bienemeia/SYSC4907_Group44_GroundVibrationSimulator/README.md

# SYSC4907_Group44_GroundVibrationSimulator
This repository contains all code and documentation for Ground Vibration Simulator.
