bienemeia/SYSC4907_Group44_GroundVibrationSimulator/Documentation/Teams_Backup/Progress Meetings/01-09-2023 Meeting.pptx

## Progress Meeting – Jan. 9, 2023

An organic corner shape

- Past week

- Hope everyone had an excellent holiday!

A brushstroke

Coming week

Simulation experiments
Order parts!!!
Assembly
Further software dev.

## Slide 2

What has everyone been working on?

Meia Copeland

Shawaiz Khan

Talal Jaber

Ranishka Fernando

Marwan Zeyada
