bienemeia/SYSC4907_Group44_GroundVibrationSimulator/Documentation/Teams_Backup/Progress Meetings/01-16-2023 Meeting.pptx

## Progress Meeting – Jan. 16, 2023

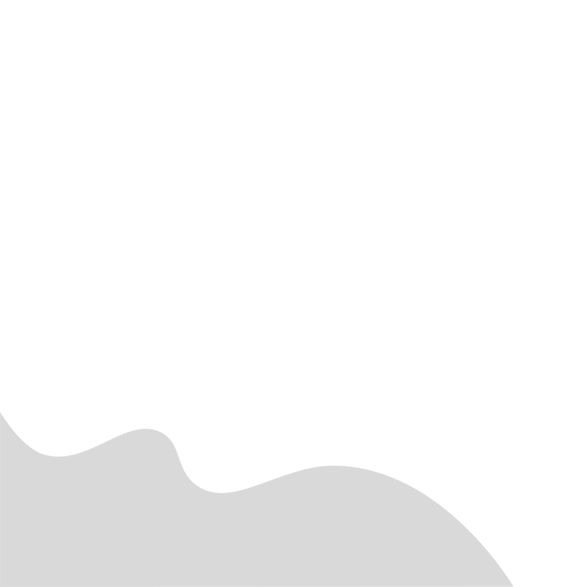
[picture p48: figure]
An organic corner shape

- Past week

- Parts ordered
- Grant proposal submitted to OFNC
- Oral presentation draft

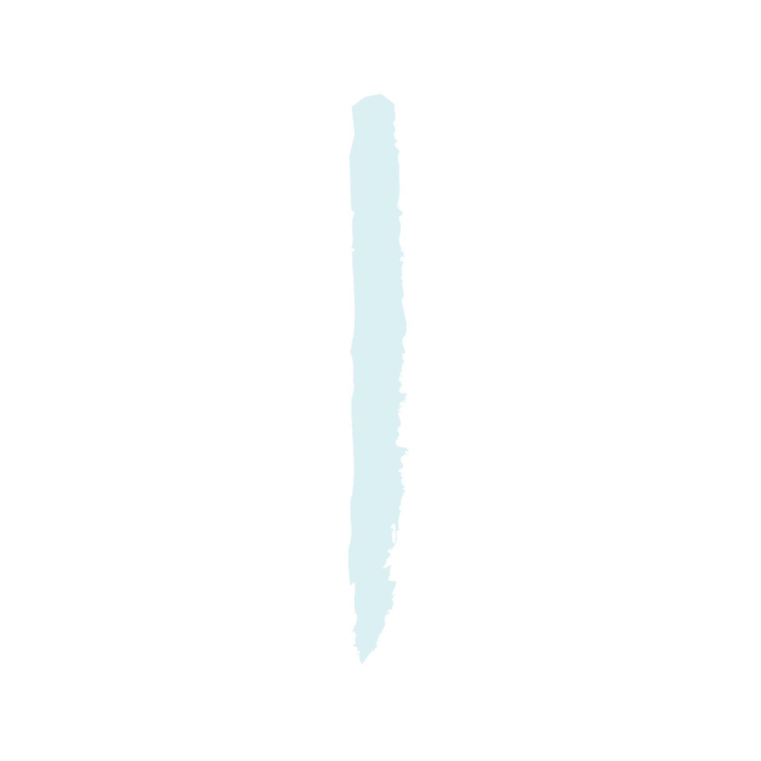
[picture p49: figure]
A brushstroke

Coming week

Simulation experiments
Assembly
Further software dev.

## Slide 2

What has everyone been working on?

Meia Copeland

Prepared the grant proposal to OFNC with Dr. Davy
Ordered and received parts required
Draft slides

Shawaiz Khan

Talal Jaber

Working on the motor demo for the presentation.

Ranishka Fernando

Working on presentation slides

Worked on the draft slides for the Oral Presentation
Worked on sending emails using python (with attachments)

Marwan Zeyada
