bienemeia/SYSC4907_Group44_GroundVibrationSimulator/Documentation/Teams_Backup/Progress Meetings/02-05-2023 Meeting.pptx

## Progress Meeting – Feb. 5, 2023

An organic corner shape

- Past week

- New flexure & frame design
- Sensor research
- Further software dev.

A brushstroke

Coming week

Order required sensors
Test new flexure design
Software dev.
Integration of flexure with motor

## Measuring Linear Displacement

- Eddylab – Cylindrical distance sensor

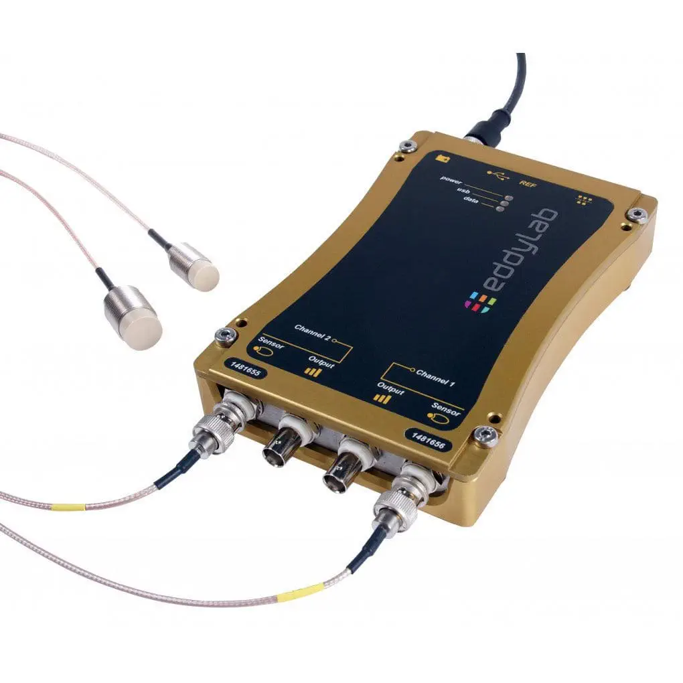
[picture p50: figure]

- SMT Linear Displacement Sensor - $295

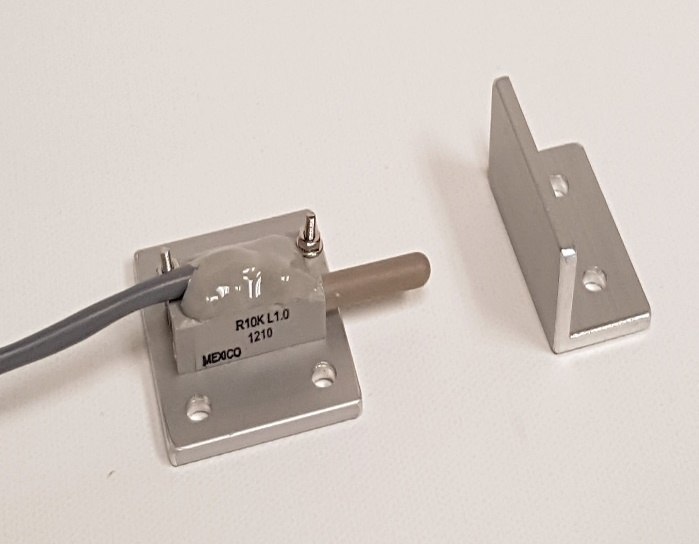
[picture p51: figure]

Strain Gauge

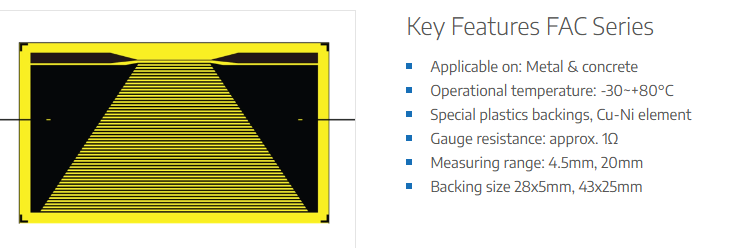
[picture p52: figure]

Limitations
- Surface applied must be smooth or results can be misinterpreted
- Cannot measure multi-direction loads
- Performance affected by humidity, temperature and other external factors

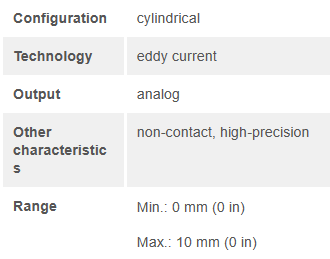
[picture p53: figure]
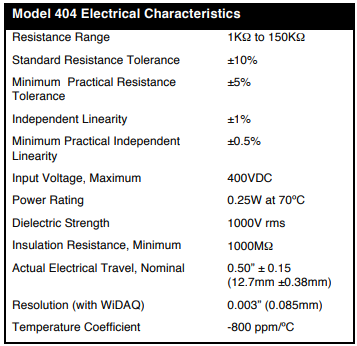
[picture p54: figure]

Notes: https://www.smtresearch.ca/product-page/linear-displacement-sensor-basic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,a%20greater%20degree%20of%20accuracy
https://www.directindustry.com/prod/eddylab-gmbh/product-188286-1845021.html
https://www.directindustry.com/industrial-manufacturer/analog-distance-sensor-105923.html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

## Flexure Redesign

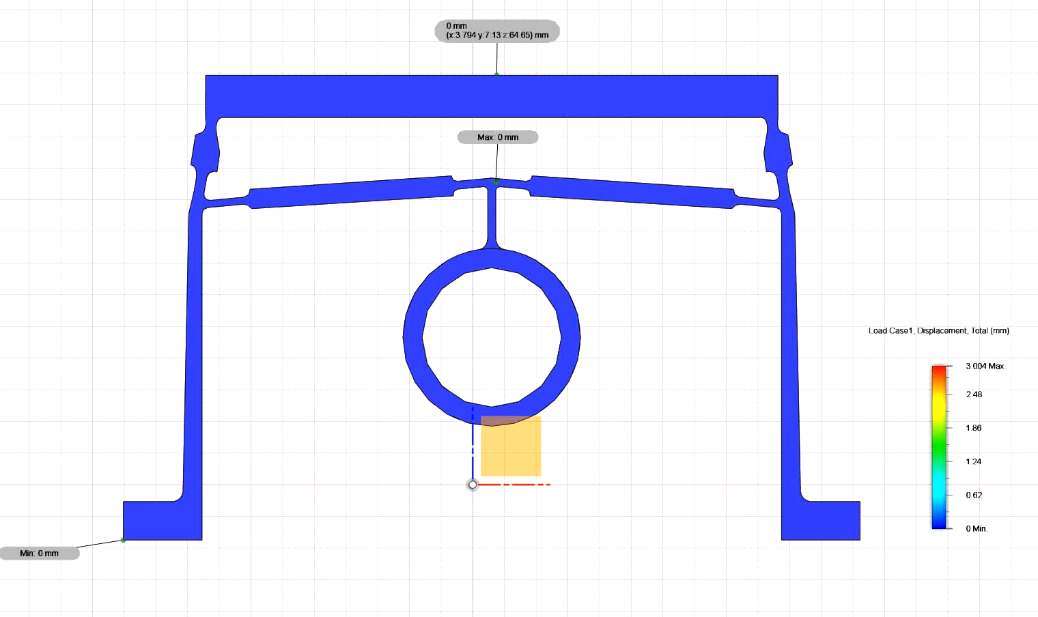
[picture p55: figure]

~0.12 mm displacement with 3mm offset
~0.2 mm displacement with 5 mm offset
Target: 0.1 mm – 1 mm
New frame designed

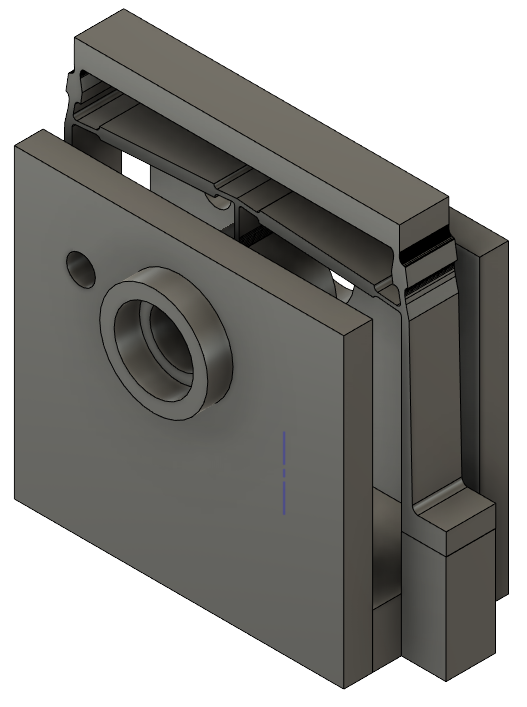
[picture p56: figure]
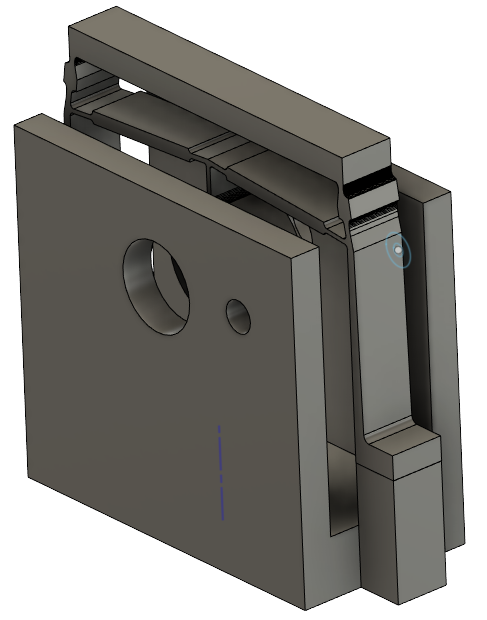
[picture p57: figure]

## Slide 4

What has everyone been working on?

Meia Copeland

Flexure, frame and camshaft redesign
Ordered parts
Ordered 3D print

Shawaiz Khan

Talal Jaber

- Power supply for the driver
- Resolving motor issue
- Debugging code

Ranishka Fernando

3D modelling – Flexure re-design
Research on displacement sensors and their limitations

Database to UI integration

Marwan Zeyada

Database to UI integration
