bienemeia/SYSC4907_Group44_GroundVibrationSimulator/Documentation/Teams_Backup/Progress Meetings/02-13-2023 Meeting.pptx

## Progress Meeting – Feb. 13, 2023

An organic corner shape

- Past week

- Temperature & humidity integration with database
- Sensor research
- Further software dev.

A brushstroke

Coming week

Order required sensors
Test new flexure design
Software dev.
Integration of flexure with motor
Final report draft

## Model 404 Position Sensor

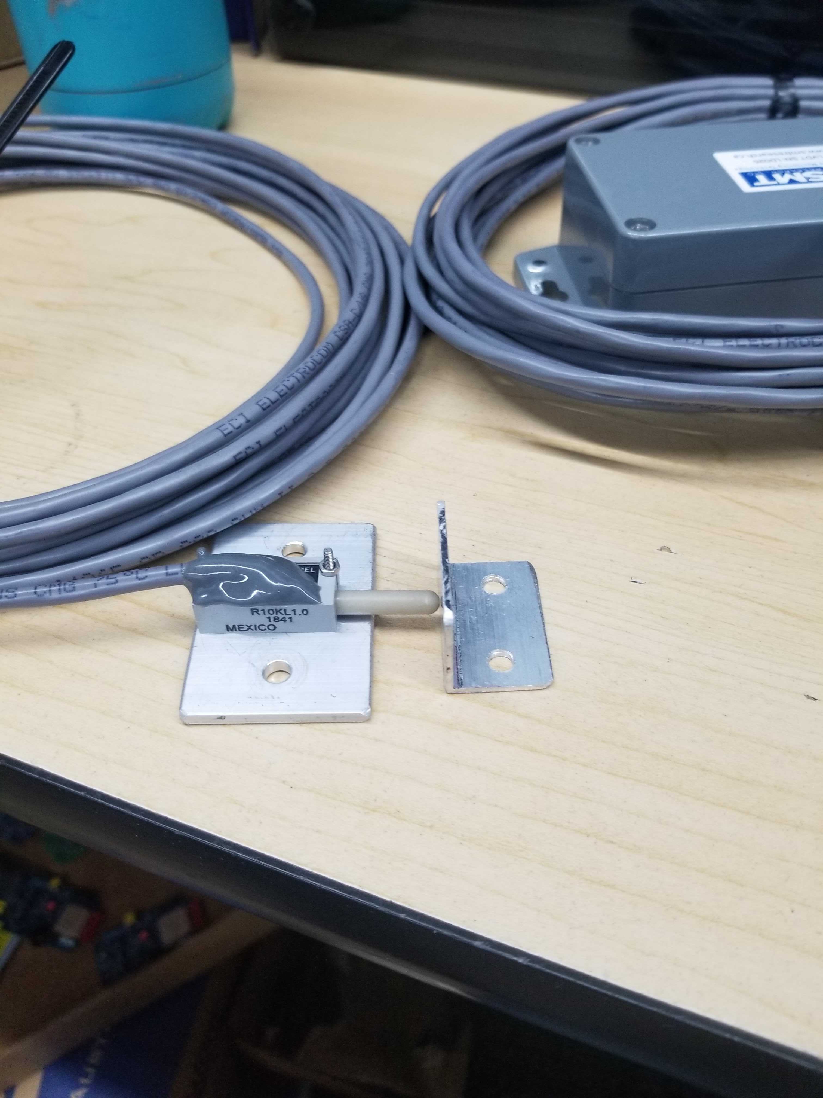
[picture p58: figure]
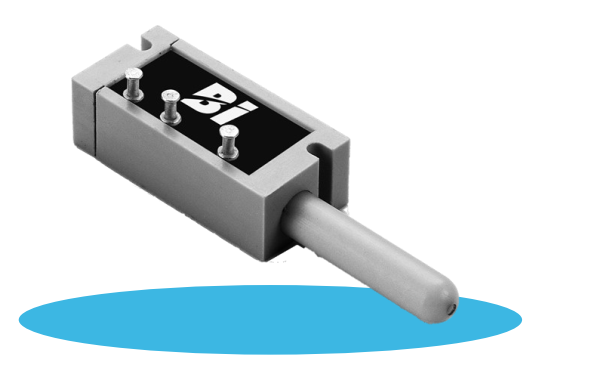
[picture p59: figure]
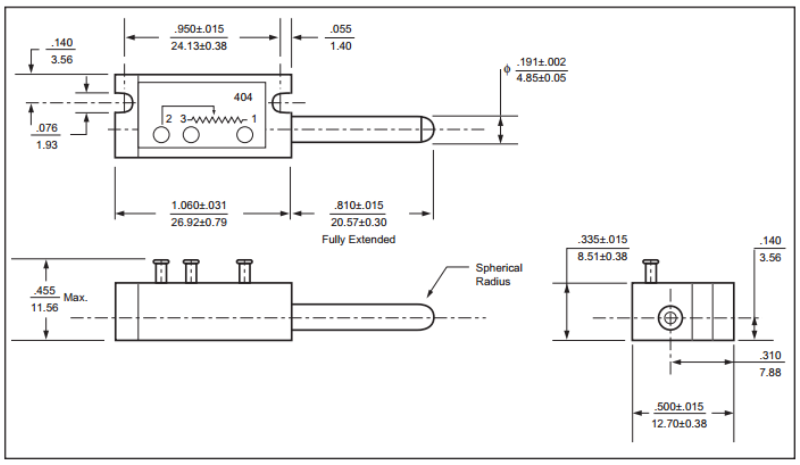
[picture p60: figure]
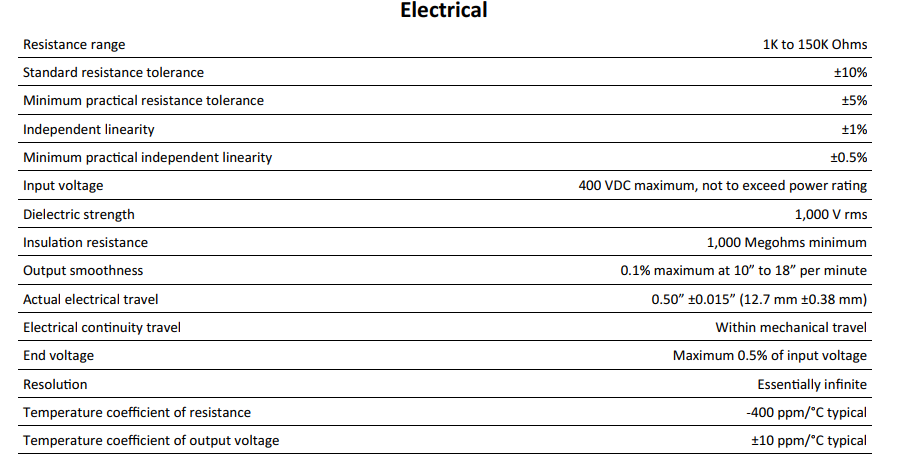
[picture p61: figure]

## Slide 3

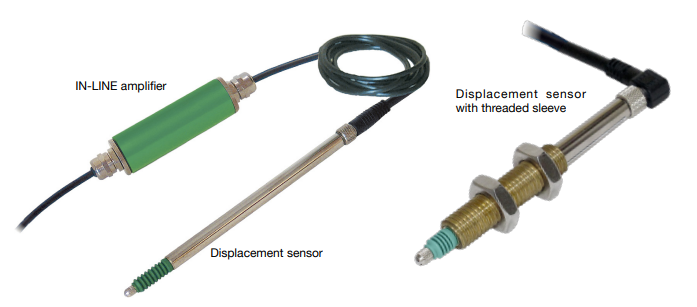
[picture p62: figure]
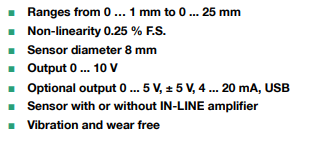
[picture p63: figure]

## Slide 4

What has everyone been working on?

Meia Copeland

I2C connection for temperature/humidity sensor
Connection can be used for other variables later

Shawaiz Khan

Talal Jaber

- Debugging motor issues

Ranishka Fernando

Finalize research on linear displacement sensors and determine the required sensor.
Research on unguided core magnet displacement sensors

.db to .xlsx file conversion completed
Files sent as email attachments completed
Database to UI integration

Marwan Zeyada

Database to UI integration
