bienemeia/SYSC4907_Group44_GroundVibrationSimulator/Documentation/Teams_Backup/Proposal/44 Proposal Draft v2.Marshall.pdf

SYSC4907 –ENGINEERING PROJECT

# Wind Turbine Ground Vibration Simulator

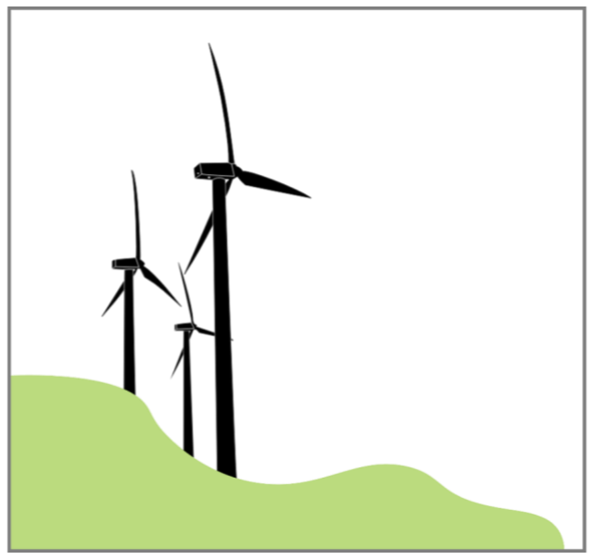
[picture p125: figure]

Team Members
Meia Copeland | 100972654
Shawaiz Khan | 100917863
Talal Jaber | 101167571
Marwan Zeyada | 101141759
Ranishka Fernando

Supervisors
Dr. Lynn Marshall
Dr. Yuu Ono

October 21, 2022

Commented [MP1]: @Ranishka Fernando please add student number

WIND TURBINE GROUND VIBRATION SIMULATOR

i

## Table of Contents

WIND TURBINE GROUND VIBRATION SIMULATOR

ii

WIND TURBINE GROUND VIBRATION SIMULATOR

1
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
