bienemeia/SYSC4907_Group44_GroundVibrationSimulator/Documentation/Teams_Backup/Oral Presentation/Assets/2-red-eared-slider-turtles-mirror-image-kenny-bosak.jpg

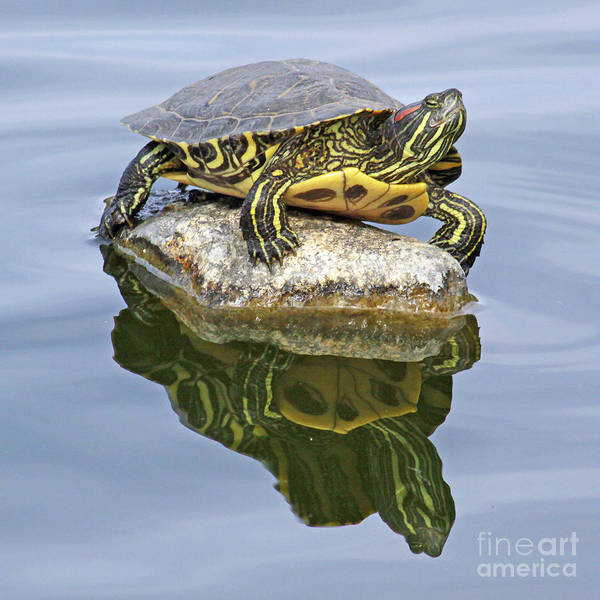
Documentation/Teams_Backup/Oral Presentation/Assets/2-red-eared-slider-turtles-mirror-image-kenny-bosak.jpg
