bienemeia/SYSC4907_Group44_GroundVibrationSimulator/Documentation/Teams_Backup/Oral Presentation/Assets/29turtle-superJumbo.jpg

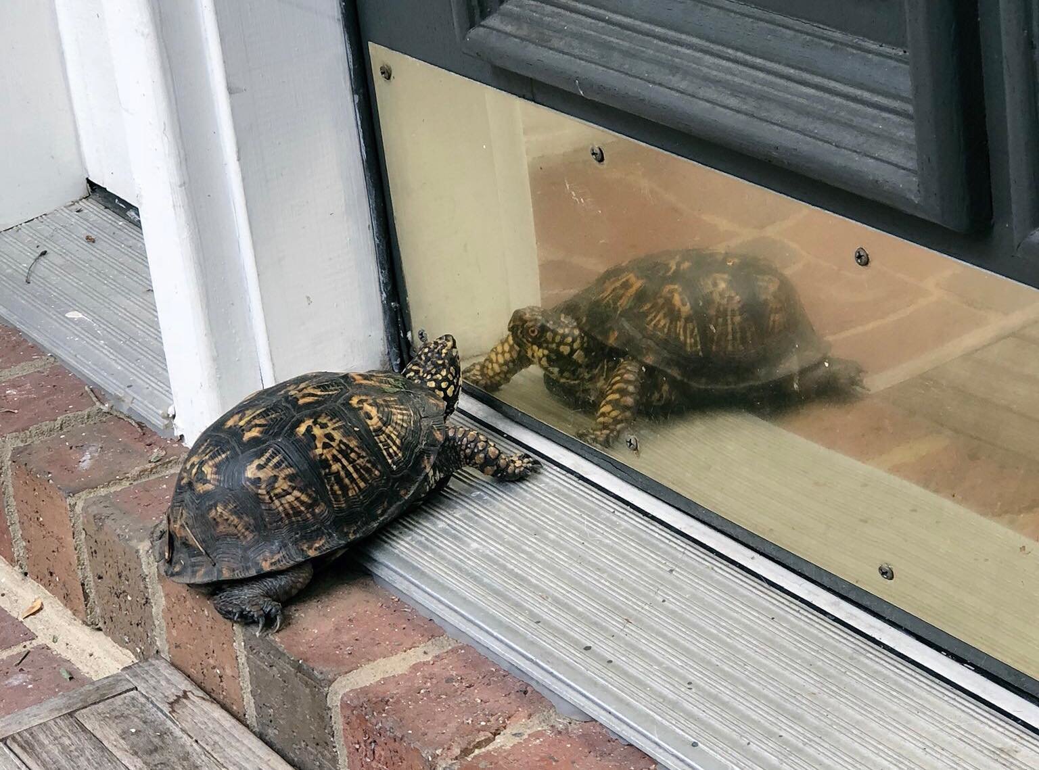
Documentation/Teams_Backup/Oral Presentation/Assets/29turtle-superJumbo.jpg
