bienemeia/SYSC4907_Group44_GroundVibrationSimulator/Documentation/Teams_Backup/Oral Presentation/Assets/30_turtle-eggs.5869bc6cba.png

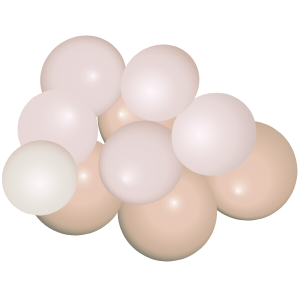
Documentation/Teams_Backup/Oral Presentation/Assets/30_turtle-eggs.5869bc6cba.png
