bienemeia/SYSC4907_Group44_GroundVibrationSimulator/Documentation/Teams_Backup/Oral Presentation/Assets/62b87ff5d182dd8651230912_flashtheturtlewbbsmall-1649761058957.png

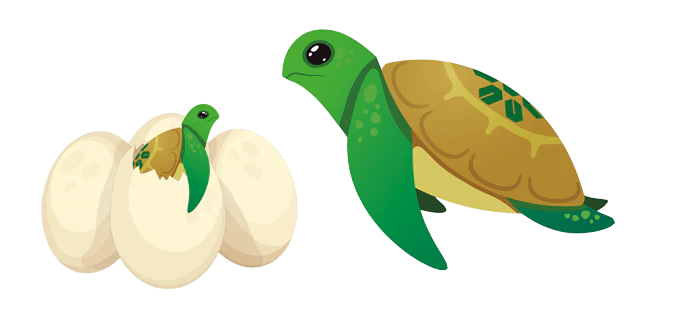
Documentation/Teams_Backup/Oral Presentation/Assets/62b87ff5d182dd8651230912_flashtheturtlewbbsmall-1649761058957.png
