bienemeia/SYSC4907_Group44_GroundVibrationSimulator/Documentation/Teams_Backup/Oral Presentation/Assets/1014499169,width=178,height=178.webp

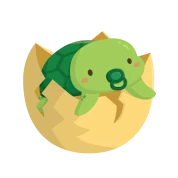
Documentation/Teams_Backup/Oral Presentation/Assets/1014499169,width=178,height=178.webp
