bienemeia/SYSC4907_Group44_GroundVibrationSimulator/Documentation/Teams_Backup/Oral Presentation/Assets/17603687068_ae33f1c6b6_b.jpg

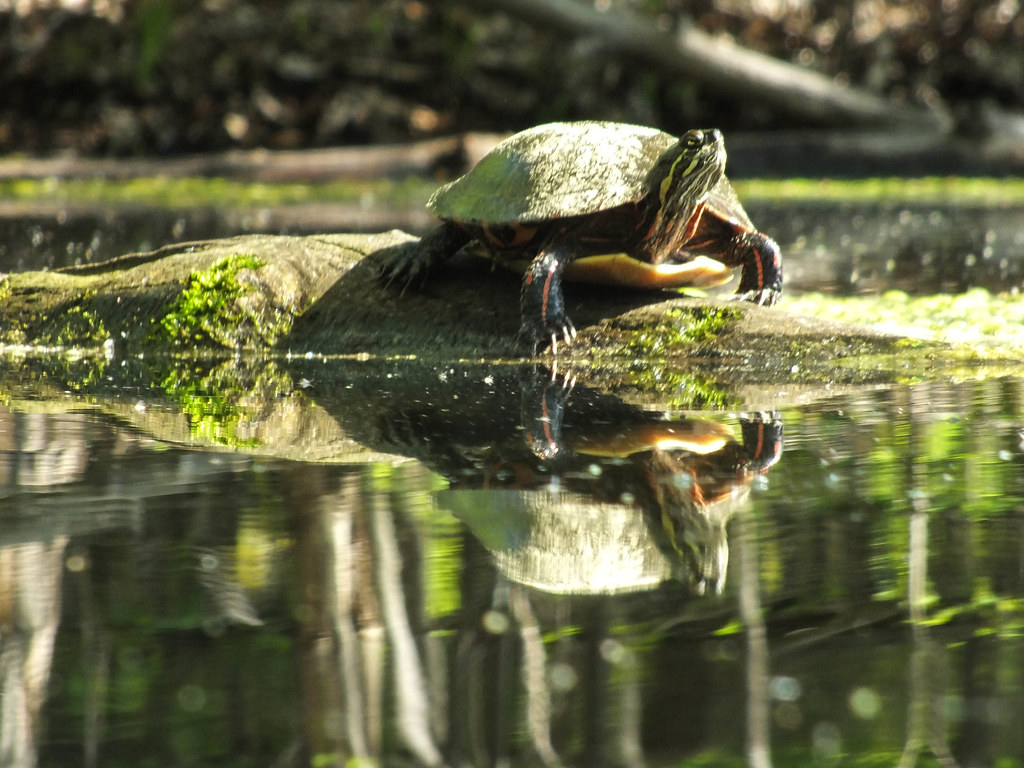
Documentation/Teams_Backup/Oral Presentation/Assets/17603687068_ae33f1c6b6_b.jpg
