bienemeia/SYSC4907_Group44_GroundVibrationSimulator/Documentation/Teams_Backup/Oral Presentation/Assets/Actuator Section View.png

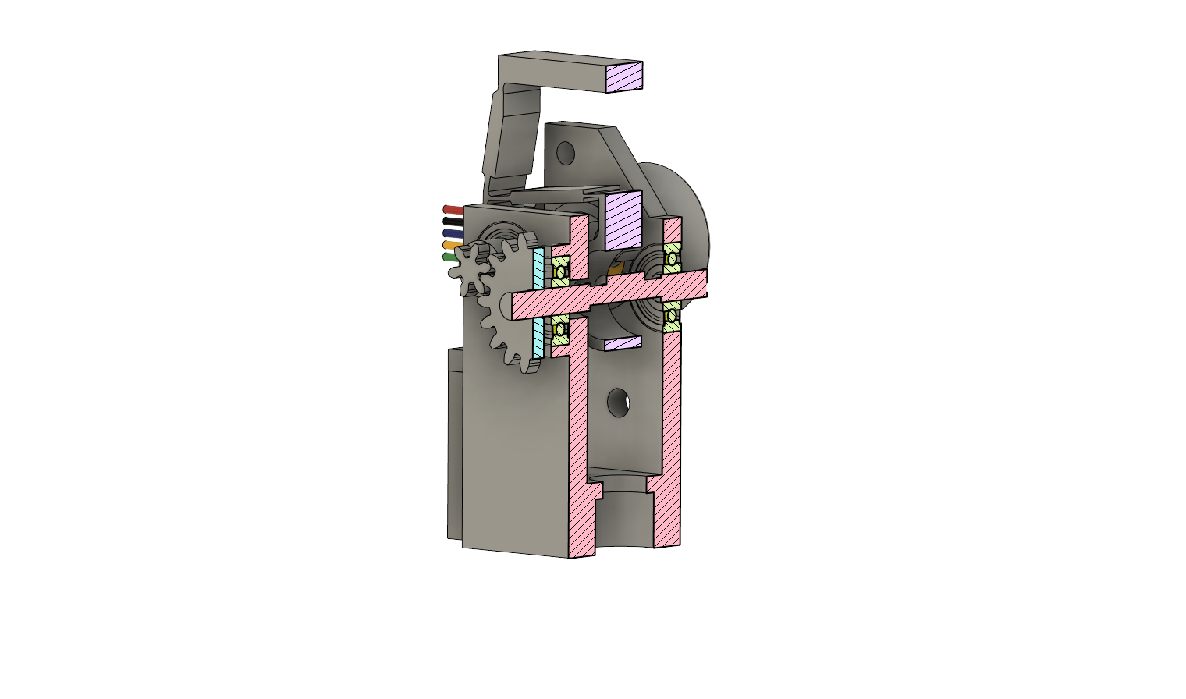
Documentation/Teams_Backup/Oral Presentation/Assets/Actuator Section View.png
