bienemeia/SYSC4907_Group44_GroundVibrationSimulator/Documentation/Teams_Backup/Oral Presentation/Assets/ActuatorOtherSideView01v4.png

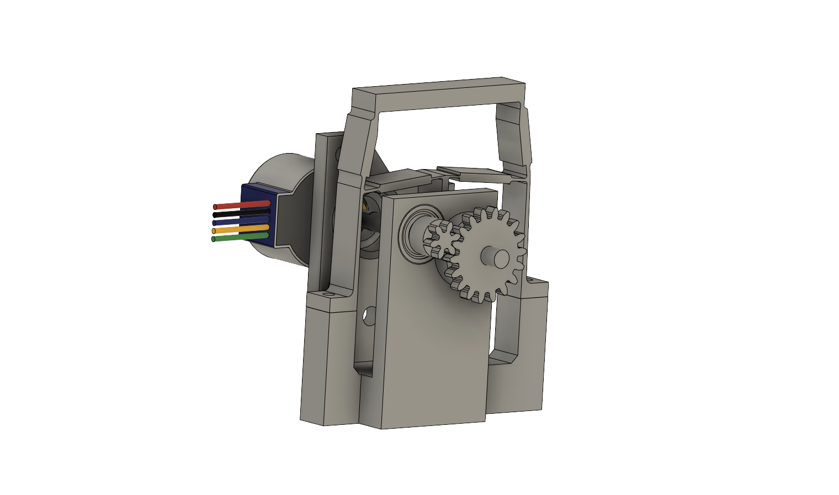
Documentation/Teams_Backup/Oral Presentation/Assets/ActuatorOtherSideView01v4.png
