bienemeia/SYSC4907_Group44_GroundVibrationSimulator/Documentation/Teams_Backup/Oral Presentation/Assets/asphalt-157687__340.webp

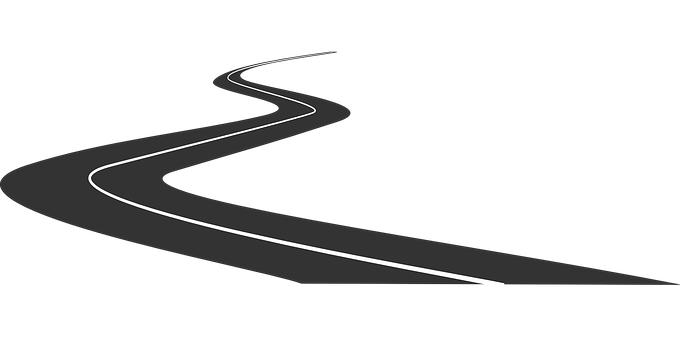
Documentation/Teams_Backup/Oral Presentation/Assets/asphalt-157687__340.webp
