bienemeia/SYSC4907_Group44_GroundVibrationSimulator/Documentation/Teams_Backup/Oral Presentation/Assets/BabyTurtlePic-removebg-preview - Copy.png

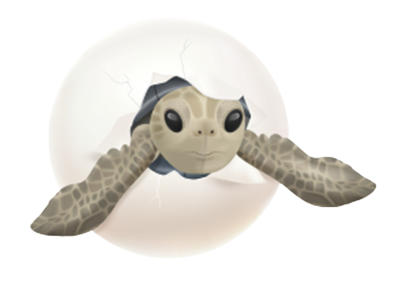
Documentation/Teams_Backup/Oral Presentation/Assets/BabyTurtlePic-removebg-preview - Copy.png
