bienemeia/SYSC4907_Group44_GroundVibrationSimulator/Documentation/Teams_Backup/Oral Presentation/Assets/FlexureAndCamshaft.png

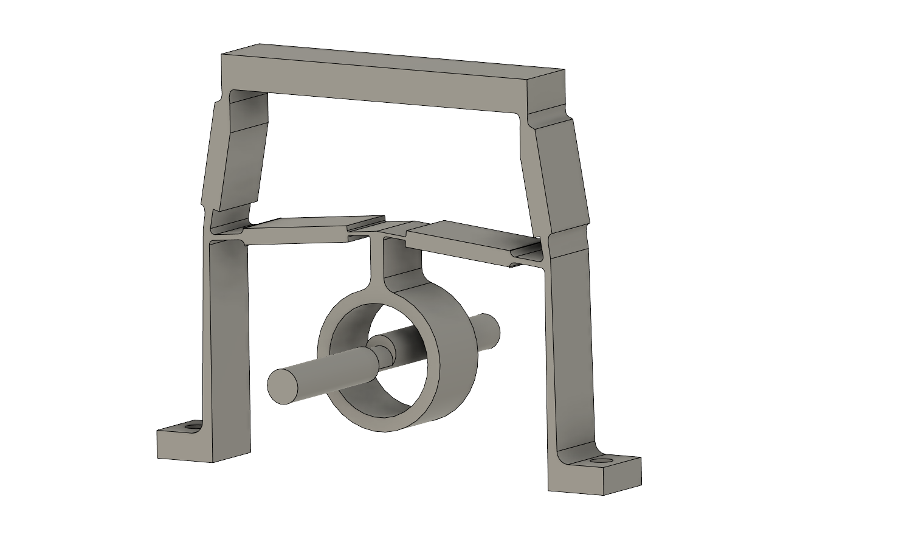
Documentation/Teams_Backup/Oral Presentation/Assets/FlexureAndCamshaft.png
