bienemeia/SYSC4907_Group44_GroundVibrationSimulator/Documentation/Teams_Backup/Oral Presentation/Assets/GroundWaveTypes.png

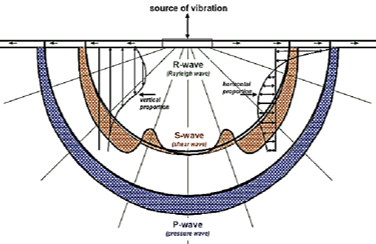
Documentation/Teams_Backup/Oral Presentation/Assets/GroundWaveTypes.png
