bienemeia/SYSC4907_Group44_GroundVibrationSimulator/Documentation/Teams_Backup/Oral Presentation/Assets/HydroPlant.jpg

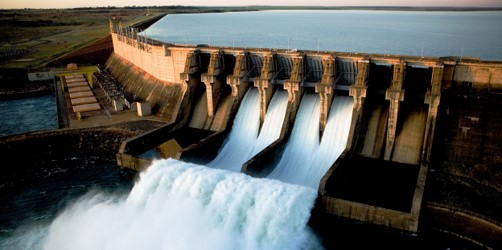
Documentation/Teams_Backup/Oral Presentation/Assets/HydroPlant.jpg
