bienemeia/SYSC4907_Group44_GroundVibrationSimulator/Documentation/Teams_Backup/Oral Presentation/Assets/mirror-turtle-natural-focal-point-photography.jpg

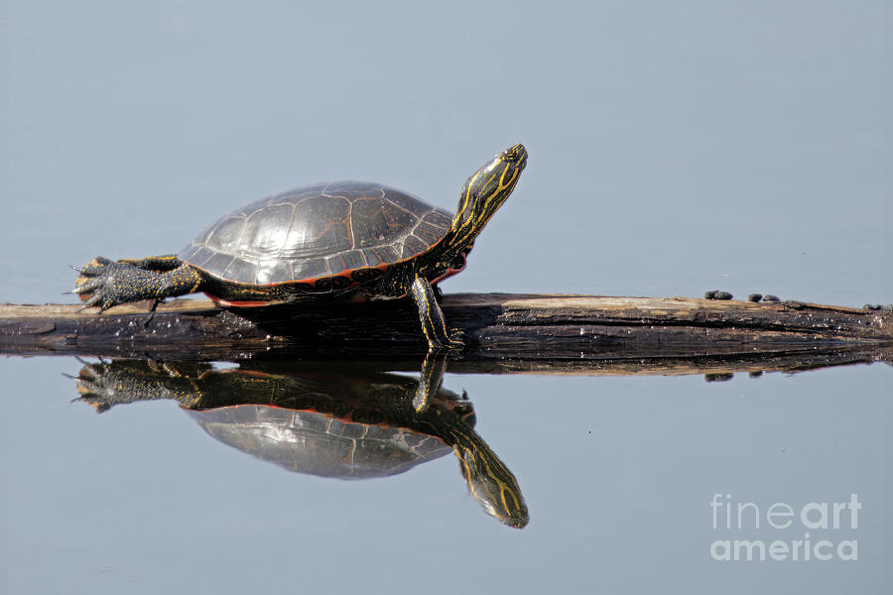
Documentation/Teams_Backup/Oral Presentation/Assets/mirror-turtle-natural-focal-point-photography.jpg
