bienemeia/SYSC4907_Group44_GroundVibrationSimulator/Documentation/Teams_Backup/Oral Presentation/Assets/nuclear-power-plant-vector-260nw-227903848.webp

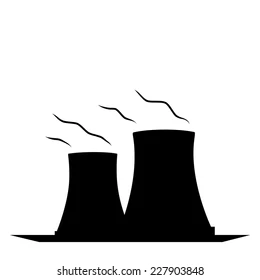
Documentation/Teams_Backup/Oral Presentation/Assets/nuclear-power-plant-vector-260nw-227903848.webp
