bienemeia/SYSC4907_Group44_GroundVibrationSimulator/Documentation/Teams_Backup/Oral Presentation/Assets/pngtree-set-of-road-vector-illustration-png-image_6115149.png

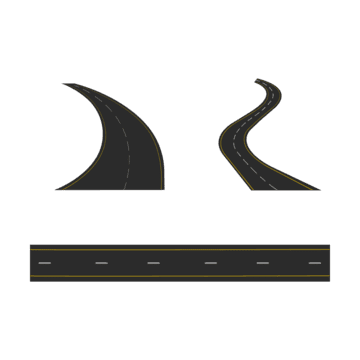
Documentation/Teams_Backup/Oral Presentation/Assets/pngtree-set-of-road-vector-illustration-png-image_6115149.png
