bienemeia/SYSC4907_Group44_GroundVibrationSimulator/Documentation/Teams_Backup/Oral Presentation/Assets/power-plant-black-silhouette-illustration-vector.jpg

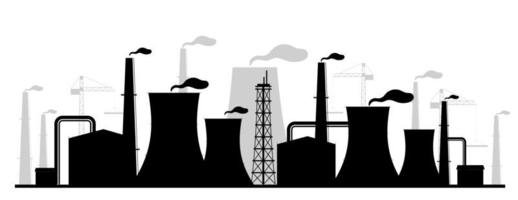
Documentation/Teams_Backup/Oral Presentation/Assets/power-plant-black-silhouette-illustration-vector.jpg
