bienemeia/SYSC4907_Group44_GroundVibrationSimulator/Documentation/Teams_Backup/Oral Presentation/Assets/red-eared-slider-turtles_Piqsels.jpg

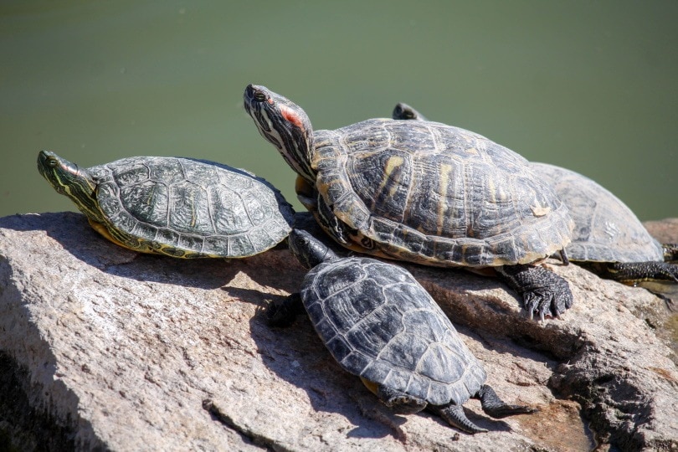
Documentation/Teams_Backup/Oral Presentation/Assets/red-eared-slider-turtles_Piqsels.jpg
