bienemeia/SYSC4907_Group44_GroundVibrationSimulator/Documentation/Teams_Backup/Oral Presentation/Assets/silhouette-of-a-power-plant-vector-8655158.jpg

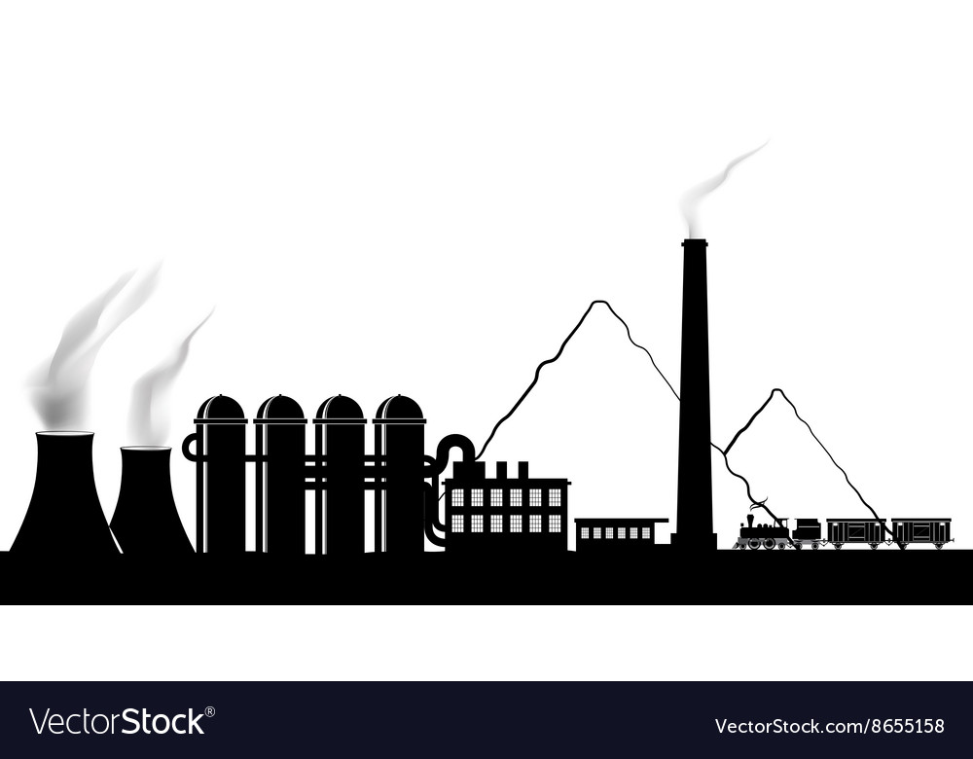
Documentation/Teams_Backup/Oral Presentation/Assets/silhouette-of-a-power-plant-vector-8655158.jpg
