bienemeia/SYSC4907_Group44_GroundVibrationSimulator/Documentation/Teams_Backup/Oral Presentation/Assets/turtle-cracking-egg-round-turtle-egg-11563607666zl85b1wvmm.png

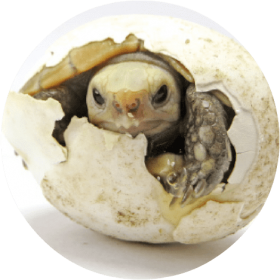
Documentation/Teams_Backup/Oral Presentation/Assets/turtle-cracking-egg-round-turtle-egg-11563607666zl85b1wvmm.png
