bienemeia/SYSC4907_Group44_GroundVibrationSimulator/Documentation/Teams_Backup/Oral Presentation/Assets/TurtleEggPic-removebg-preview.png

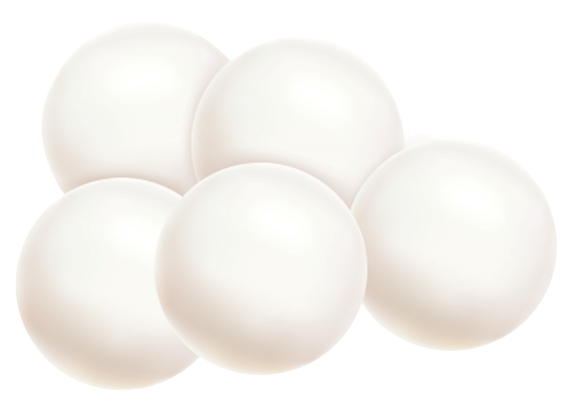
Documentation/Teams_Backup/Oral Presentation/Assets/TurtleEggPic-removebg-preview.png
