bienemeia/SYSC4907_Group44_GroundVibrationSimulator/Documentation/Teams_Backup/Proposal/Assets/LinearActuator Front.png

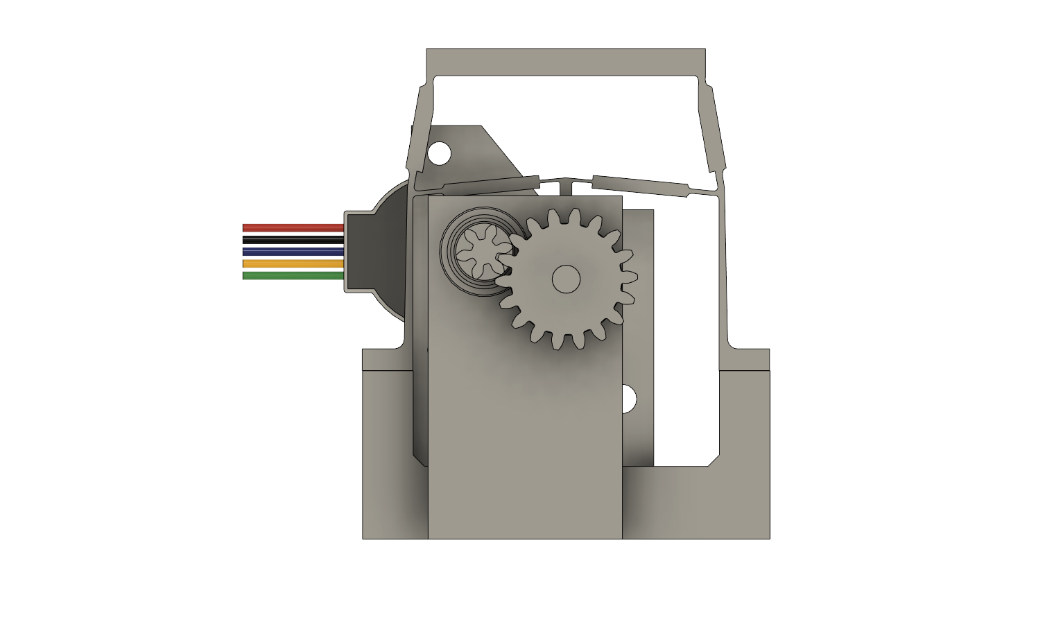
Documentation/Teams_Backup/Proposal/Assets/LinearActuator Front.png
