bienemeia/SYSC4907_Group44_GroundVibrationSimulator/Documentation/Teams_Backup/Proposal/Assets/LinearActuator v1.png

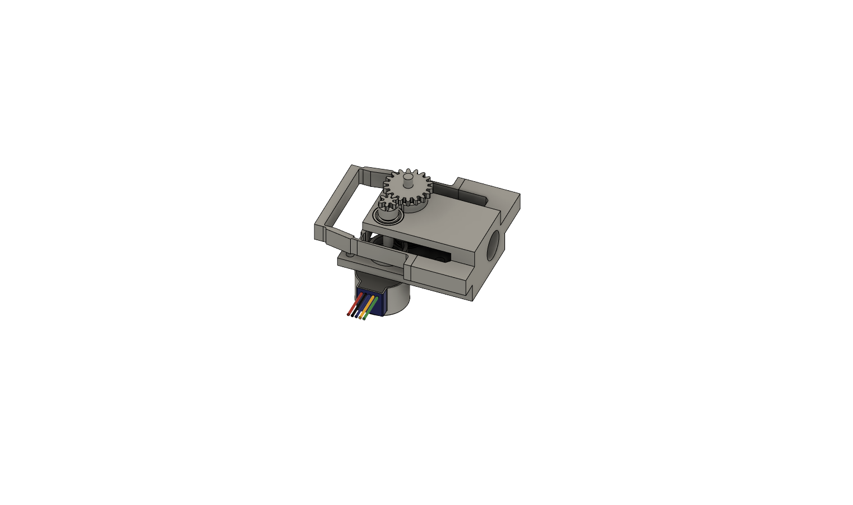
Documentation/Teams_Backup/Proposal/Assets/LinearActuator v1.png
