bienemeia/SYSC4907_Group44_GroundVibrationSimulator/Documentation/Teams_Backup/Receipts/Claimed/HomeDepot_FastenerSupply.jpg

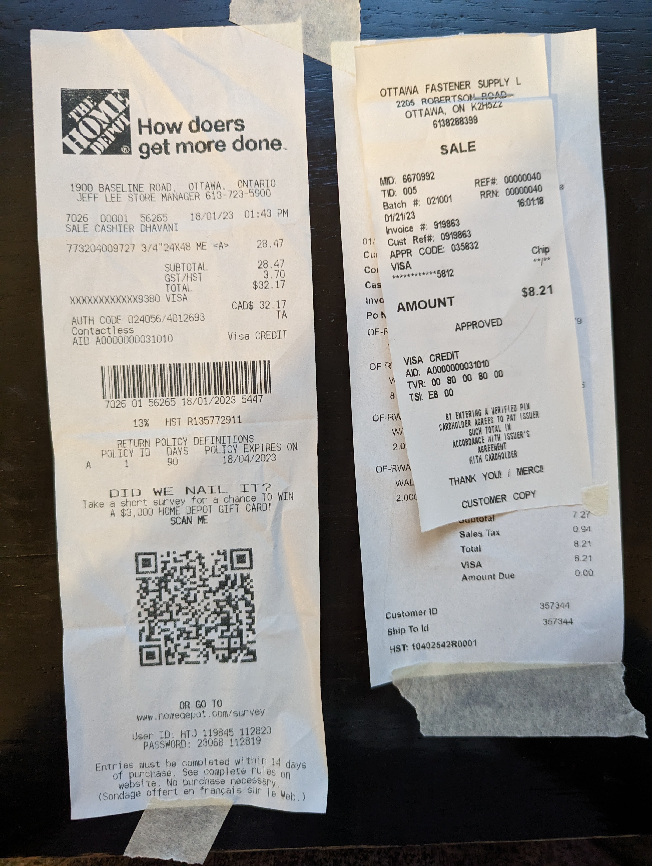
Documentation/Teams_Backup/Receipts/Claimed/HomeDepot_FastenerSupply.jpg
