bienemeia/SYSC4907_Group44_GroundVibrationSimulator/Documentation/Teams_Backup/STL/Bracket v2.png

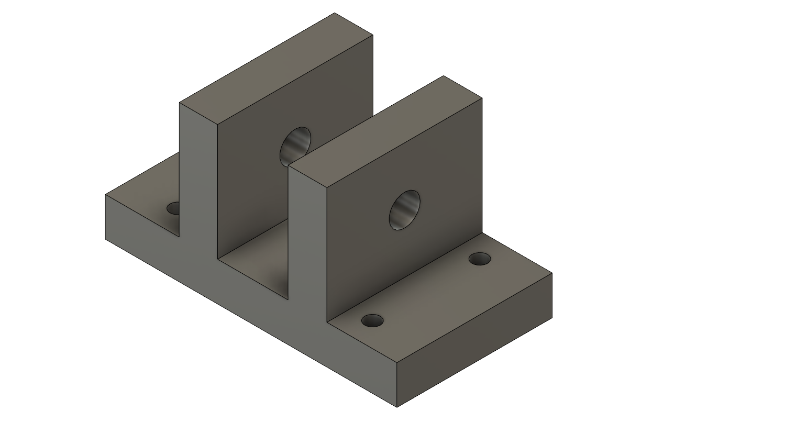
Documentation/Teams_Backup/STL/Bracket v2.png
