bienemeia/SYSC4907_Group44_GroundVibrationSimulator/Documentation/Teams_Backup/Video/Pictures/53e20cb0a8aff.webp

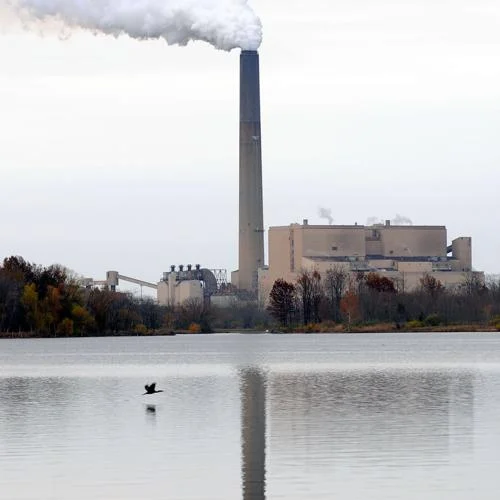
Documentation/Teams_Backup/Video/Pictures/53e20cb0a8aff.webp
