bienemeia/SYSC4907_Group44_GroundVibrationSimulator/Documentation/Teams_Backup/Video/Pictures/627a84a3f128c1f7abaab559_42877131541_20033355d1_k.jpg

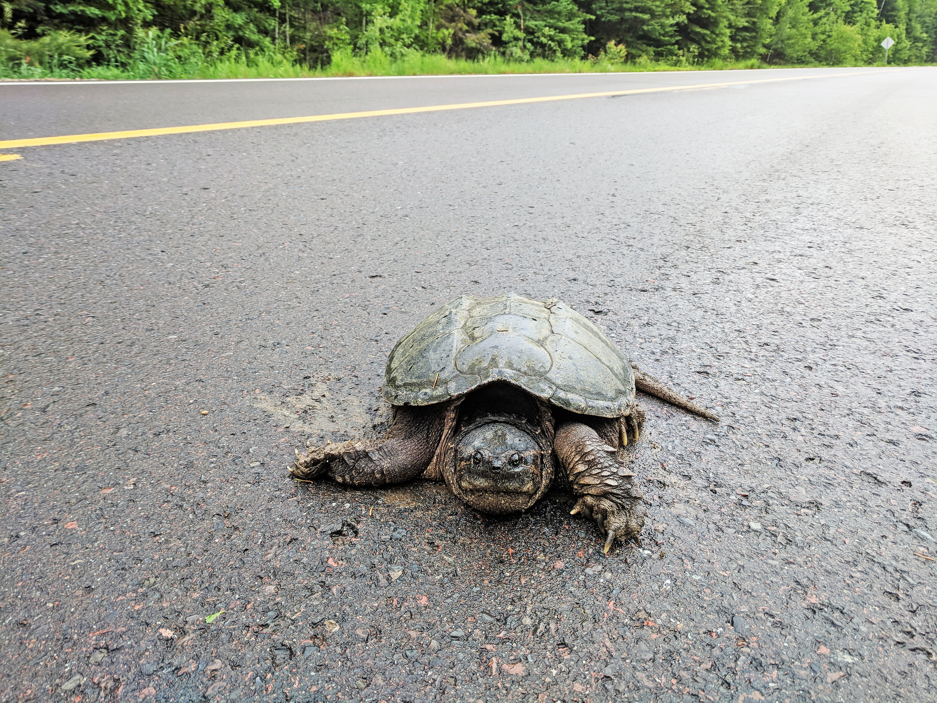
Documentation/Teams_Backup/Video/Pictures/627a84a3f128c1f7abaab559_42877131541_20033355d1_k.jpg
