bienemeia/SYSC4907_Group44_GroundVibrationSimulator/Documentation/Teams_Backup/Video/Pictures/a-turtle.jpg

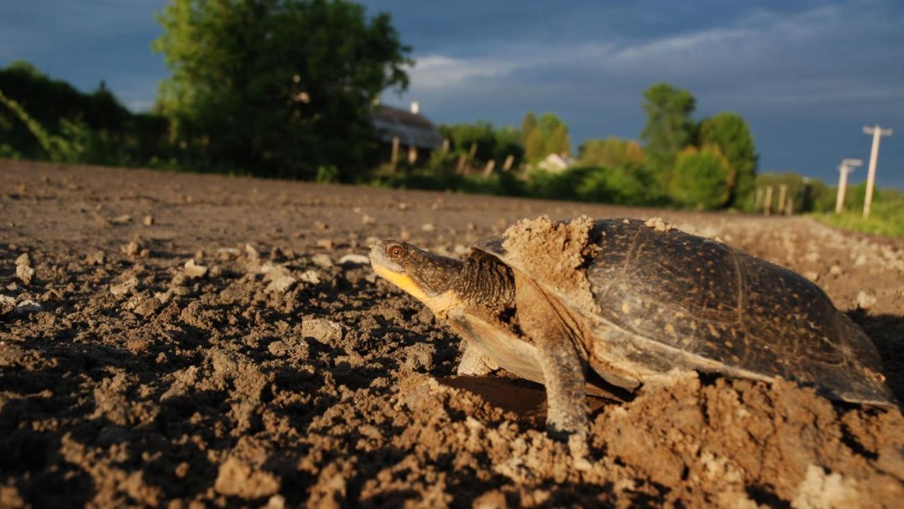
Documentation/Teams_Backup/Video/Pictures/a-turtle.jpg
