bienemeia/SYSC4907_Group44_GroundVibrationSimulator/Documentation/Teams_Backup/Video/Pictures/Algonquin_June_2010_174_James_Paterson.jpg

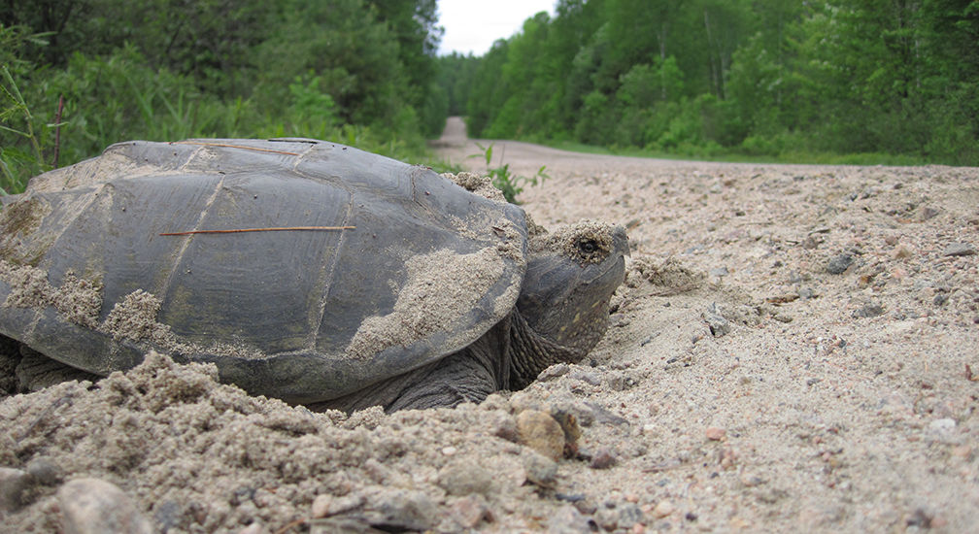
Documentation/Teams_Backup/Video/Pictures/Algonquin_June_2010_174_James_Paterson.jpg
