bienemeia/SYSC4907_Group44_GroundVibrationSimulator/Documentation/Teams_Backup/Video/Pictures/DavyLabTeam.PNG

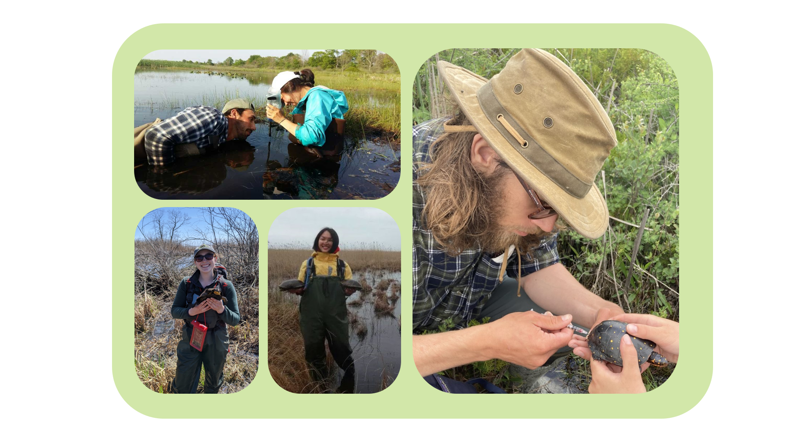
Documentation/Teams_Backup/Video/Pictures/DavyLabTeam.PNG
