bienemeia/SYSC4907_Group44_GroundVibrationSimulator/Documentation/Teams_Backup/Video/Pictures/DSCF1684-1-1024x768.jpg

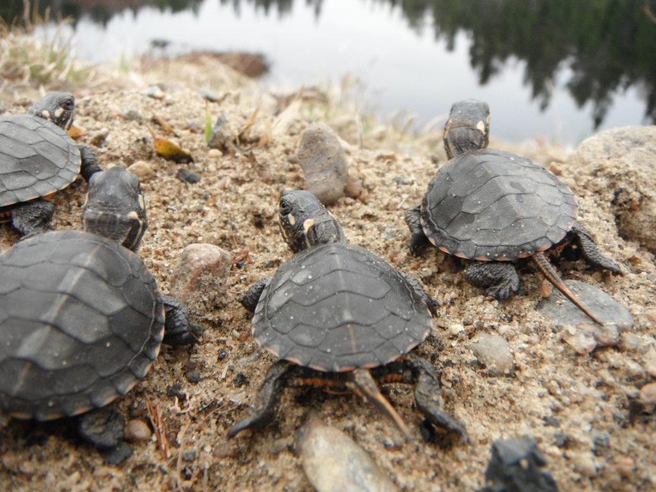
Documentation/Teams_Backup/Video/Pictures/DSCF1684-1-1024x768.jpg
