bienemeia/SYSC4907_Group44_GroundVibrationSimulator/Documentation/Teams_Backup/Video/Pictures/IMGL0093-Enhanced-wp.webp

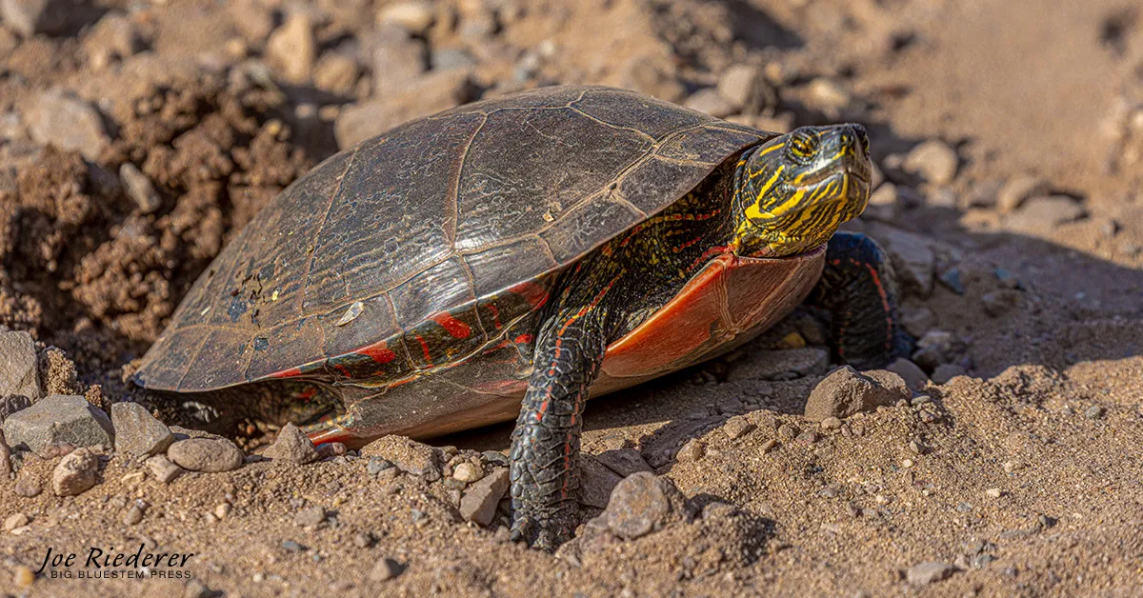
Documentation/Teams_Backup/Video/Pictures/IMGL0093-Enhanced-wp.webp
