bienemeia/SYSC4907_Group44_GroundVibrationSimulator/Documentation/Teams_Backup/Video/Pictures/Painted_Turtle.jpg

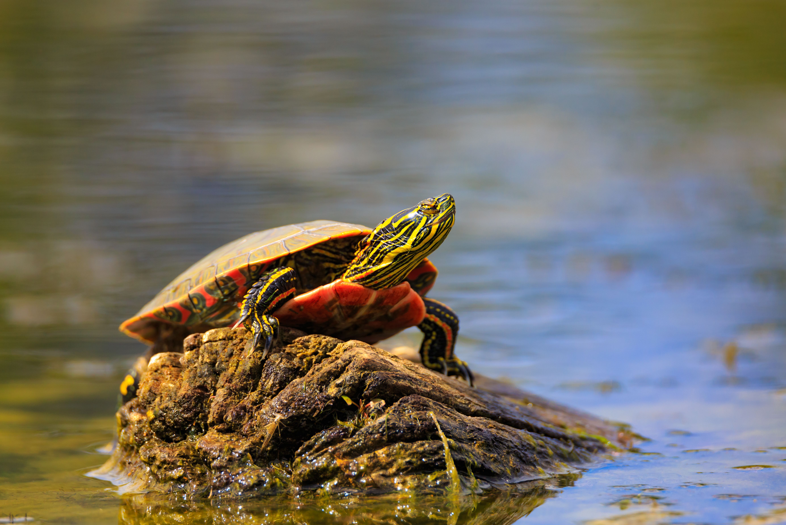
Documentation/Teams_Backup/Video/Pictures/Painted_Turtle.jpg
