bienemeia/SYSC4907_Group44_GroundVibrationSimulator/Documentation/Teams_Backup/Video/Pictures/sanpping-turtle-on-road.jpg

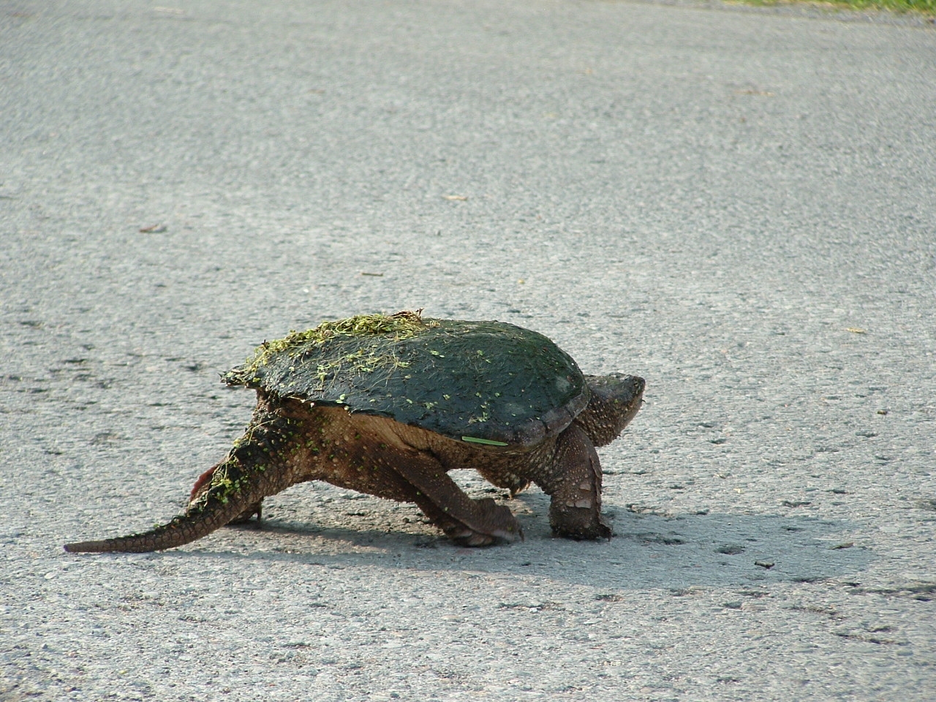
Documentation/Teams_Backup/Video/Pictures/sanpping-turtle-on-road.jpg
