bienemeia/SYSC4907_Group44_GroundVibrationSimulator/Documentation/Teams_Backup/Video/Pictures/shaketable.jpg

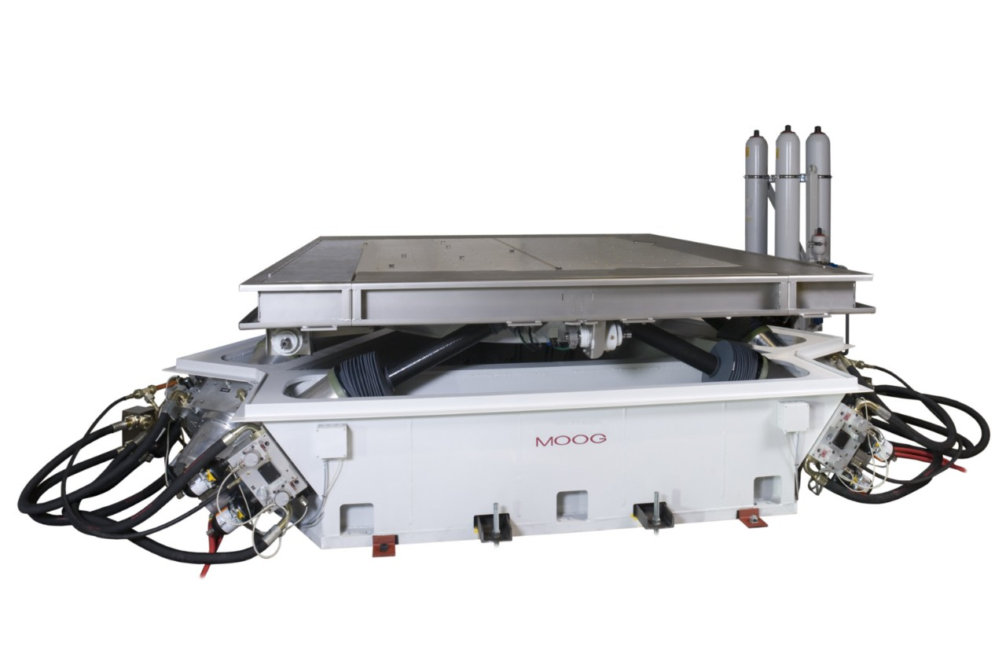
Documentation/Teams_Backup/Video/Pictures/shaketable.jpg
