bienemeia/SYSC4907_Group44_GroundVibrationSimulator/Documentation/Teams_Backup/Video/Pictures/slide10.PNG

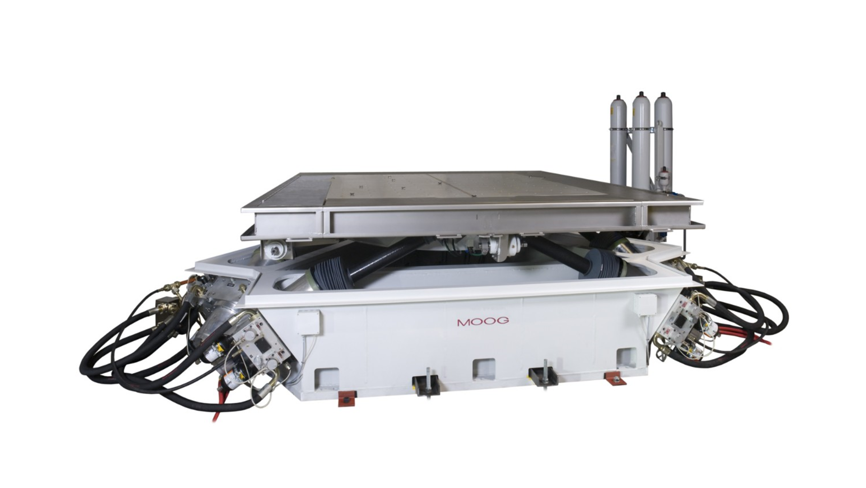
Documentation/Teams_Backup/Video/Pictures/slide10.PNG
