bienemeia/SYSC4907_Group44_GroundVibrationSimulator/Documentation/Teams_Backup/Video/Pictures/slide14.PNG

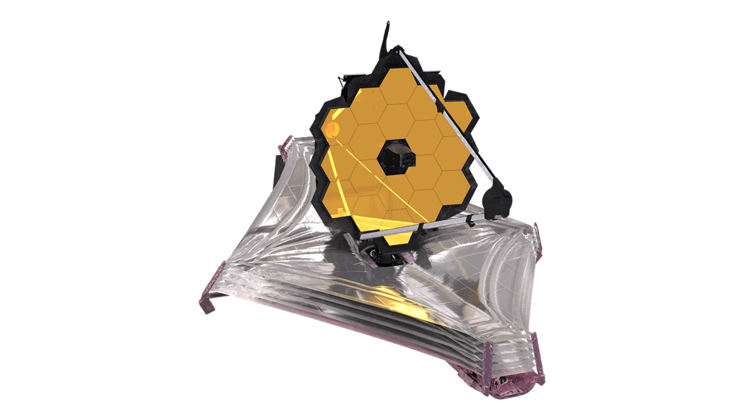
Documentation/Teams_Backup/Video/Pictures/slide14.PNG
