bienemeia/SYSC4907_Group44_GroundVibrationSimulator/Documentation/Teams_Backup/Video/Pictures/Snapping-Turtle-3-Danielle-Tassie.jpg

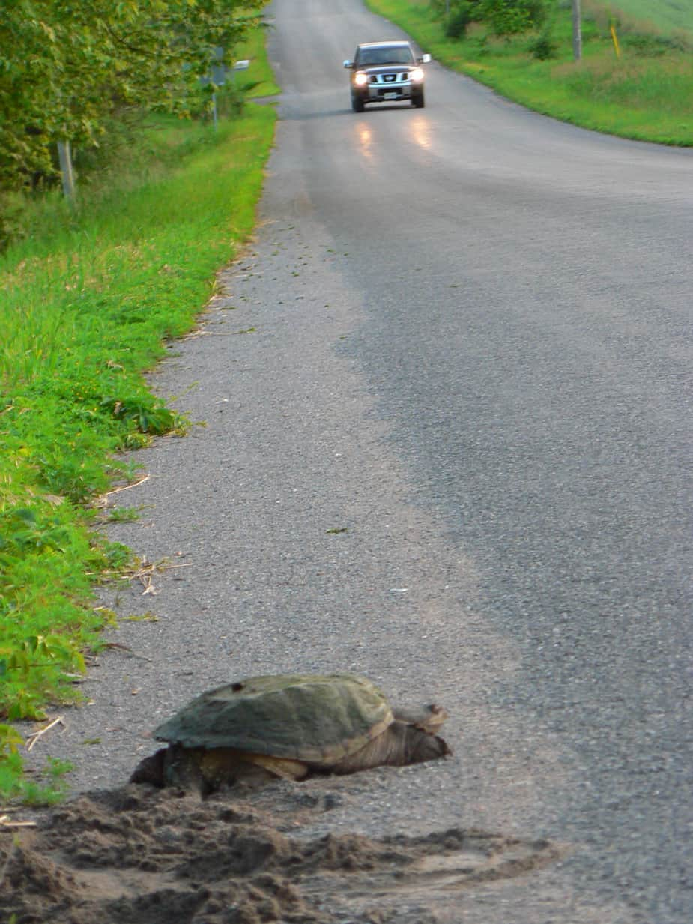
Documentation/Teams_Backup/Video/Pictures/Snapping-Turtle-3-Danielle-Tassie.jpg
