bienemeia/SYSC4907_Group44_GroundVibrationSimulator/Documentation/Teams_Backup/Video/Pictures/turt2.jpg

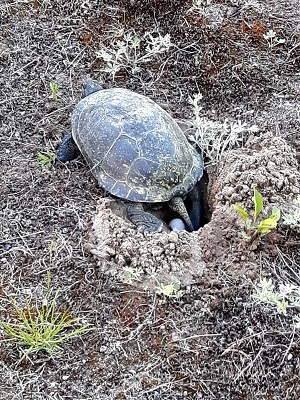
Documentation/Teams_Backup/Video/Pictures/turt2.jpg
