bienemeia/SYSC4907_Group44_GroundVibrationSimulator/Documentation/Teams_Backup/Video/Pictures/Turtle7-900x675.jpg

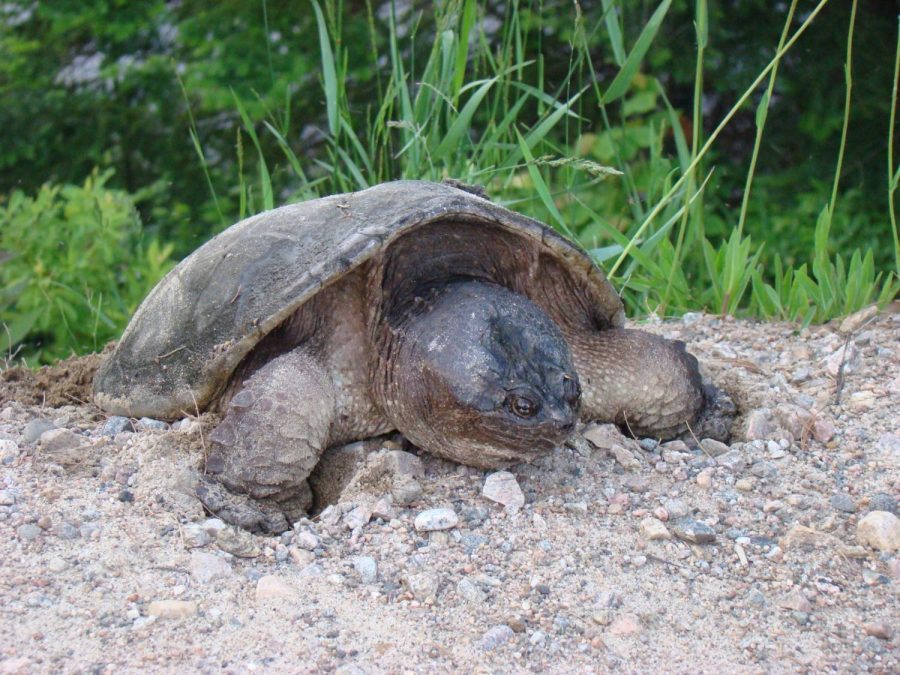
Documentation/Teams_Backup/Video/Pictures/Turtle7-900x675.jpg
