bienemeia/SYSC4907_Group44_GroundVibrationSimulator/Documentation/Teams_Backup/Video/Pictures/turtle-2___13105150187.webp

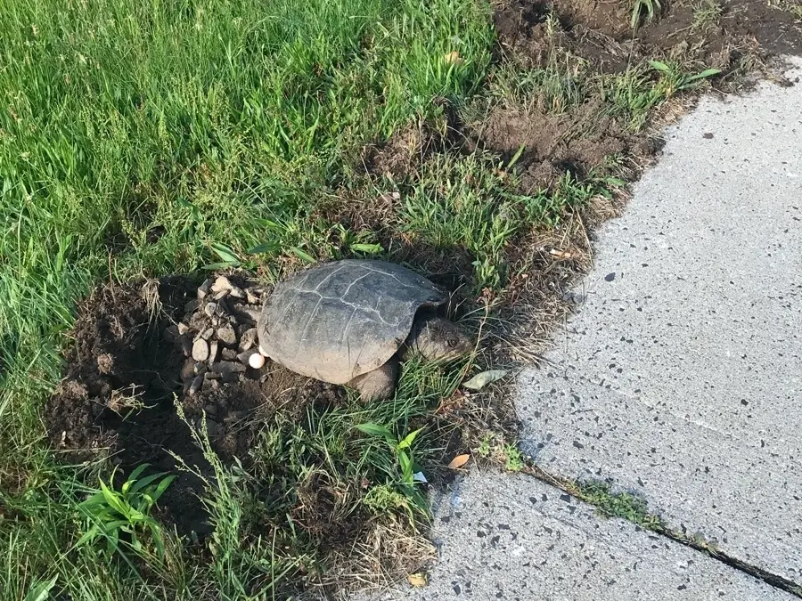
Documentation/Teams_Backup/Video/Pictures/turtle-2___13105150187.webp
