bienemeia/SYSC4907_Group44_GroundVibrationSimulator/Documentation/Teams_Backup/Video/Pictures/Turtle-FL-Redbellied-MINDEN-900x591.jpg

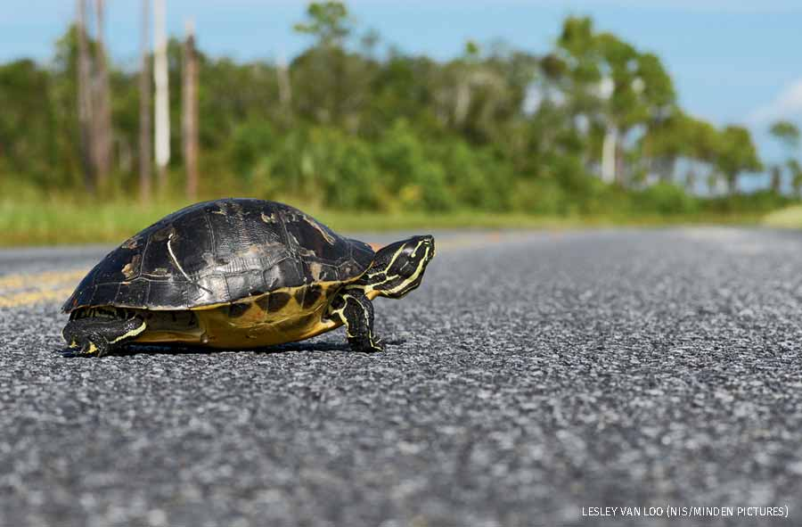
Documentation/Teams_Backup/Video/Pictures/Turtle-FL-Redbellied-MINDEN-900x591.jpg
