bienemeia/SYSC4907_Group44_GroundVibrationSimulator/Documentation/Teams_Backup/Video/Pictures/Turtle-Laying-Eggs-at-the-Road-1-Brett-Alan.jpg

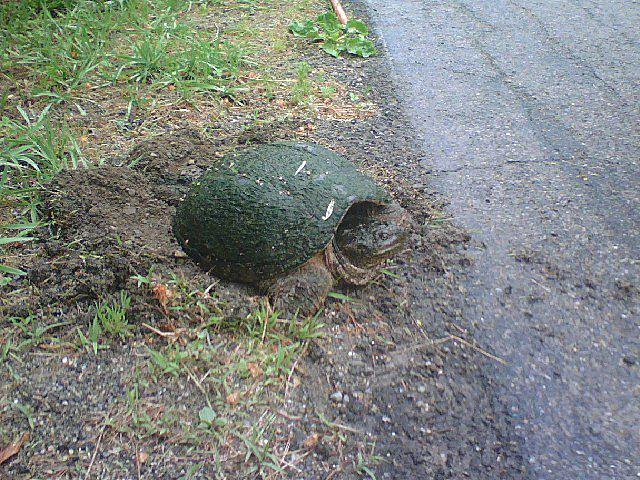
Documentation/Teams_Backup/Video/Pictures/Turtle-Laying-Eggs-at-the-Road-1-Brett-Alan.jpg
