bienemeia/SYSC4907_Group44_GroundVibrationSimulator/Documentation/Teams_Backup/Video/Pictures/Uncovering-Snapping-Turtle-Nest.jpg

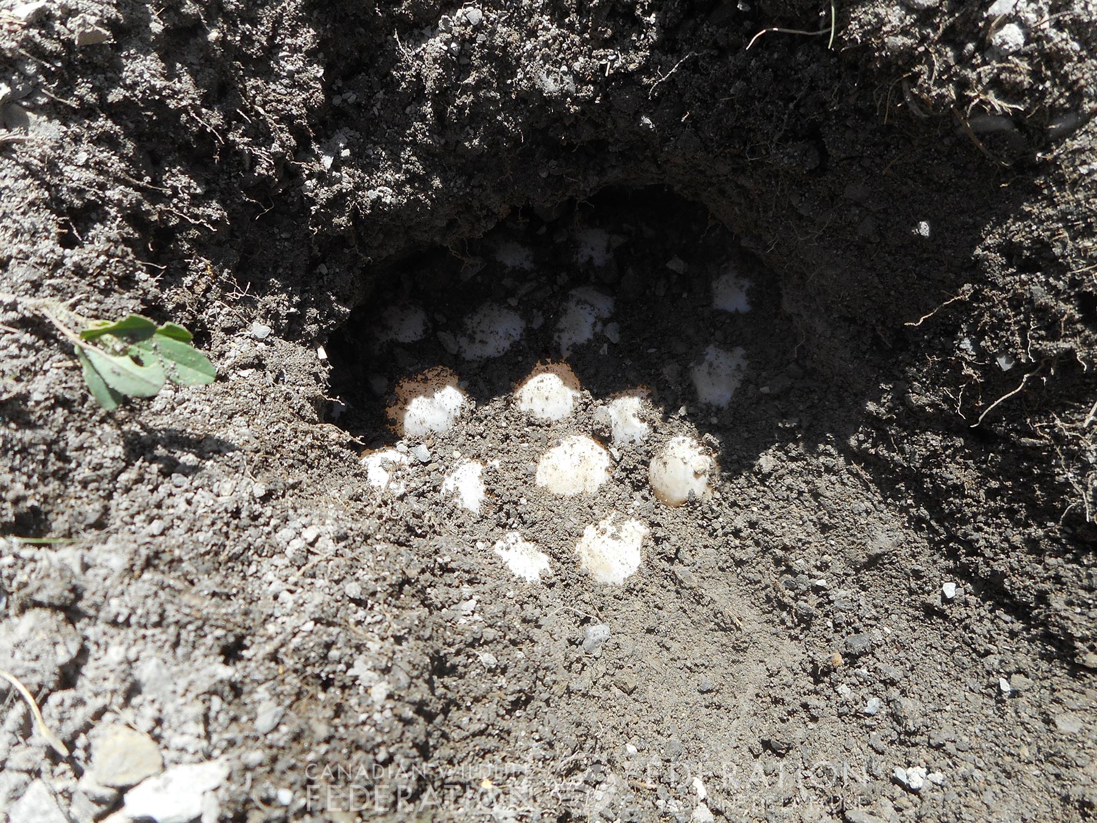
Documentation/Teams_Backup/Video/Pictures/Uncovering-Snapping-Turtle-Nest.jpg
