bienemeia/SYSC4907_Group44_GroundVibrationSimulator/UI Code/images/turtle.png

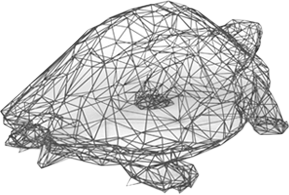
UI Code/images/turtle.png
