bienemeia/SYSC4907_Group44_GroundVibrationSimulator/Documentation/TotalPurchases.xlsx

All items purchased (R&D) |  |  | Items for first table |  |  | Items for additional table
Item | Source | Price | Item | Source | Price | Item | Source | Price
DC Brushless motor | BC-Robotics.com (https://bc-robotics.com/shop/3-6vdc-hobby-motor/) | $1.95 | DC Brushless motor | BC-Robotics.com (https://bc-robotics.com/shop/3-6vdc-hobby-motor/) | $1.95 | DC Brushless motor | BC-Robotics.com (https://bc-robotics.com/shop/3-6vdc-hobby-motor/) | $1.95
DC Brushless motor | Amazon.ca (https://www.amazon.ca/Brushless-Outrunner-Professional-Helicopter-Quadcopter/dp/B08K3GHJTN) | $23.53 | Motor driver | BC-Robotics.com (https://bc-robotics.com/shop/l298n-motor-driver-board/) | $9.99 | Motor driver | BC-Robotics.com (https://bc-robotics.com/shop/l298n-motor-driver-board/) | $9.99
Motor driver | TexasInstrument.com (https://www.ti.com/tool/DRV10970EVM) | $54.53 | Arduino | Amazon.ca (https://www.amazon.ca/Elegoo-Board-ATmega328P-ATMEGA16U2-Arduino/dp/B01EWOE0UU?hvadid=292968375828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) | $23.99 | Arduino | Amazon.ca (https://www.amazon.ca/Elegoo-Board-ATmega328P-ATMEGA16U2-Arduino/dp/B01EWOE0UU?hvadid=292968375828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) | $23.99
Motor driver | BC-Robotics.com (https://bc-robotics.com/shop/l298n-motor-driver-board/) | $9.99 | Differential Gears 64T, 17T, 21T, 26T, 29T | Amazon.ca (https://www.amazon.ca/gp/product/B08HQG457T/ref=ppx_yo_dt_b_asin_title_o00_s00?ie=UTF8&psc=1) | $16.29 | Differential Gears 64T, 17T, 21T, 26T, 29T | Amazon.ca (https://www.amazon.ca/gp/product/B08HQG457T/ref=ppx_yo_dt_b_asin_title_o00_s00?ie=UTF8&psc=1) | $16.29
MC3479 Accelerometer | Digikey.ca (https://www.digikey.ca/en/products/detail/memsic-inc/EV3479A/15295944) | $21.47 | 3mm Motor shaft | Amazon.ca (https://www.amazon.ca/Auniwaig-Diameter-Machine-Miniature-Cylindrical/dp/B096RW41LD?s=hi) | $7.59 | 2mm to 3mm Shaft coupler | BCRobotics (https://bc-robotics.com/shop/aluminum-shaft-coupler-2mm-to-3mm/) | $3.95
MSP430 LaunchPad MCU | Digikey.ca (https://www.digikey.ca/en/products/detail/texas-instruments/MSP-EXP430F5529LP/4311683?productid=4311683) | $22.94 | 2mm to 3mm Shaft coupler | BCRobotics (https://bc-robotics.com/shop/aluminum-shaft-coupler-2mm-to-3mm/) | $3.95 | Linear shaft 12mm x 150 mm (x2) | Amazon.ca (https://www.amazon.ca/150mm-Linear-Motion-Shaft-Machine/dp/B08XYQNJL9?hvadid=459812671320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) | $14.99
Arduino | Amazon.ca (https://www.amazon.ca/Elegoo-Board-ATmega328P-ATMEGA16U2-Arduino/dp/B01EWOE0UU?hvadid=292968375828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) | $23.99 | Shaft collar 8mm | Amazon.ca (https://www.amazon.ca/gp/product/B08NP2VCFN/ref=ox_sc_act_title_1?smid=A39SE0ZBRTHUOJ&psc=1) | $9.99 | Linear shaft 12 mm bearing PIL (x2) | Digikey.ca (https://www.digikey.ca/en/products/detail/adafruit-industries-llc/1183/7035015?productid=7035015) | $18.74
Differential Gears 64T, 17T, 21T, 26T, 29T | Amazon.ca (https://www.amazon.ca/gp/product/B08HQG457T/ref=ppx_yo_dt_b_asin_title_o00_s00?ie=UTF8&psc=1) | $16.29 | Linear shaft 12mm x 150 mm (x2) | Amazon.ca (https://www.amazon.ca/150mm-Linear-Motion-Shaft-Machine/dp/B08XYQNJL9?hvadid=459812671320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) | $14.99 | Linear shaft 12mm clamp | Amazon.ca (https://www.amazon.ca/uxcell-Aluminum-Clamping-Support-Diameter/dp/B07QTX8ZVS) | $17.49
5mm Motor shaft | Amazon.ca (https://www.amazon.ca/Torque-Stainless-Shafts-Replacement-Accessory/dp/B07HFCVK9P) | $8.54 | Linear shaft 12 mm bearing PIL (x2) | Digikey.ca (https://www.digikey.ca/en/products/detail/adafruit-industries-llc/1183/7035015?productid=7035015) | $18.74 | Stiff springs (x4) | Amazon.ca (https://www.amazon.ca/22LBS-Valves-Springs-Honda-Predator/dp/B09N18TQ9J) | $43.66
3mm Motor shaft | Amazon.ca (https://www.amazon.ca/Auniwaig-Diameter-Machine-Miniature-Cylindrical/dp/B096RW41LD?s=hi) | $7.59 | Linear shaft 12mm clamp | Amazon.ca (https://www.amazon.ca/uxcell-Aluminum-Clamping-Support-Diameter/dp/B07QTX8ZVS) | $17.49 | Knotty Pine Board 2x3x8 | Homedepot.ca (https://www.homedepot.ca/product/hdg-2x3x8-knotty-pine/1000112869) | $16.98
3mm to 5mm Shaft coupler | Amazon.ca (https://www.amazon.ca/uxcell%C2%AE-Coupling-L20xD12-Coupler-Connector/dp/B07PBBMSN6?s=hi) | $11.99 | Stiff springs (x4) | Amazon.ca (https://www.amazon.ca/22LBS-Valves-Springs-Honda-Predator/dp/B09N18TQ9J) | $43.66 | 5/16-18 Nylon Insert Nut (x3) ($ 0.16 each) | Ottawa Fastener Supply | $0.48
2mm to 3mm Shaft coupler | BCRobotics (https://bc-robotics.com/shop/aluminum-shaft-coupler-2mm-to-3mm/) | $3.95 | Melamine surface | Homedepot.ca (https://www.homedepot.ca/product/alexandria-moulding-5-8-inch-x-24-inch-x-48-inch-melamine-white-handy-panel/1000118290) | $26.75 | 5/16 X 2 Tap Bolts (x3) ($0.70 each) | Ottawa Fastener Supply | $2.10
Shaft collar 8mm | Amazon.ca (https://www.amazon.ca/gp/product/B08NP2VCFN/ref=ox_sc_act_title_1?smid=A39SE0ZBRTHUOJ&psc=1) | $9.99 | Knotty Pine Board 2x3x8 | Homedepot.ca (https://www.homedepot.ca/product/hdg-2x3x8-knotty-pine/1000112869) | $16.98 | A2 M5x16 Phillips Head Screw (x8) ($ 0.22 each) | Ottawa Fastener Supply | $1.76
625-2rs Ball Bearings (x4) | Amazon.ca (https://www.amazon.ca/gp/product/B07K7MNBK6/ref=ppx_yo_dt_b_asin_title_o00_s00?ie=UTF8&psc=1) | $16.03 | 5/16-18 Nylon Insert Nut (x3) ($ 0.16 each) | Ottawa Fastener Supply | $0.48 | #12 1 ¼” Sharp Point screw (Pack of 8) | Ottawa Fastener Supply | $3.79
Linear shaft 12mm x 150 mm (x2) | Amazon.ca (https://www.amazon.ca/150mm-Linear-Motion-Shaft-Machine/dp/B08XYQNJL9?hvadid=459812671320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) | $14.99 | 5/16 X 2 Tap Bolts (x3) ($0.70 each) | Ottawa Fastener Supply | $2.10 | Incubator | Provided by lab | $0.00
Linear shaft 12 mm bearing PIL (x2) | Digikey.ca (https://www.digikey.ca/en/products/detail/adafruit-industries-llc/1183/7035015?productid=7035015) | $18.74 | A2 M5x16 Phillips Head Screw (x8) ($ 0.22 each) | Ottawa Fastener Supply | $1.76 |  | TOTAL | $176.16
Linear shaft 12mm clamp | Amazon.ca (https://www.amazon.ca/uxcell-Aluminum-Clamping-Support-Diameter/dp/B07QTX8ZVS) | $17.49 | #12 1 ¼” Sharp Point screw (Pack of 8) | Ottawa Fastener Supply | $3.79 |  | With tax | $199.06
Stiff springs (x4) | Amazon.ca (https://www.amazon.ca/22LBS-Valves-Springs-Honda-Predator/dp/B09N18TQ9J) | $43.66 | Incubator | Provided by lab | $0.00
Melamine surface | Homedepot.ca (https://www.homedepot.ca/product/alexandria-moulding-5-8-inch-x-24-inch-x-48-inch-melamine-white-handy-panel/1000118290) | $26.75 | Raspberry Pi 4, 4GB | Digikey.ca (https://www.digikey.com/en/products/detail/raspberry-pi/RASPBERRY-PI-4B-4GB/10258781) | $80.95
Knotty Pine Board 2x3x8 | Homedepot.ca (https://www.homedepot.ca/product/hdg-2x3x8-knotty-pine/1000112869) | $16.98 | Temperature & Humidity sensor | Amazon.ca (https://www.amazon.ca/Temperature-Humidity-Relative-Single-Bus-Raspberry/dp/B08HLX7XMF?hvadid=459373253751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) | $16.00
5/16-18 Nylon Insert Nut (x3) ($ 0.16 each) | Ottawa Fastener Supply | $0.48 | Mitutoyo 543-789 Digimatic Indicator | Amazon.ca (https://www.amazon.ca/Mitutoyo-543-783-Digimatic-Resolution-Specifications/dp/B00INU8Q1O?s=industrial) | $264.43
5/16 X 2 Tap Bolts (x3) ($0.70 each) | Ottawa Fastener Supply | $2.10 | Mitutoyo SPC Connecting Cable | Amazon.ca (https://www.amazon.ca/Mitutoyo-905338-Digimatic-Connecting-Straight/dp/B002SG7PPW?hvadid=335826620089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) | $72.58
A2 M5x16 Phillips Head Screw (x8) ($ 0.22 each) | Ottawa Fastener Supply | $1.76 | IR Sensor Module | Amazon.ca (https://www.amazon.ca/C-J-Infrared-Obstacle-Avoidance-Arduino/dp/B00XAGSWR4) | $10.89
#12 1 ¼” Sharp Point screw (Pack of 8) | Ottawa Fastener Supply | $3.76 | Indicator Holder | Amazon.ca (https://www.amazon.ca/gp/product/B01AGLFYEY/ref=ewc_pr_img_1?smid=A32NIDEAQZYLTL&th=1) | $30.00
Incubator | Provided by lab | $0.00 |  | TOTAL | $695.34
Raspberry Pi 4, 4GB | Digikey.ca (https://www.digikey.com/en/products/detail/raspberry-pi/RASPBERRY-PI-4B-4GB/10258781) | $80.95 |  | With tax | $785.73
Temperature & Humidity sensor | Amazon.ca (https://www.amazon.ca/dp/B085CDRTPM?psc=1&ref=ppx_yo2ov_dt_b_product_details) | $11.60
Mitutoyo 543-789 Digimatic Indicator | Amazon.ca (https://www.amazon.ca/Mitutoyo-543-783-Digimatic-Resolution-Specifications/dp/B00INU8Q1O?s=industrial) | $264.43
Mitutoyo SPC Connecting Cable | Amazon.ca (https://www.amazon.ca/Mitutoyo-905338-Digimatic-Connecting-Straight/dp/B002SG7PPW?hvadid=335826620089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) | $72.58
IR Sensor Module | Amazon.ca (https://www.amazon.ca/C-J-Infrared-Obstacle-Avoidance-Arduino/dp/B00XAGSWR4) | $10.89
Indicator Holder | Amazon.ca (https://www.amazon.ca/gp/product/B01AGLFYEY/ref=ewc_pr_img_1?smid=A32NIDEAQZYLTL&th=1) | $30.00
 | TOTAL | $849.94
