bienemeia/SYSC4907_Group44_GroundVibrationSimulator/Documentation/Teams_Backup/Proposal/Assets/RandomSpring.stl

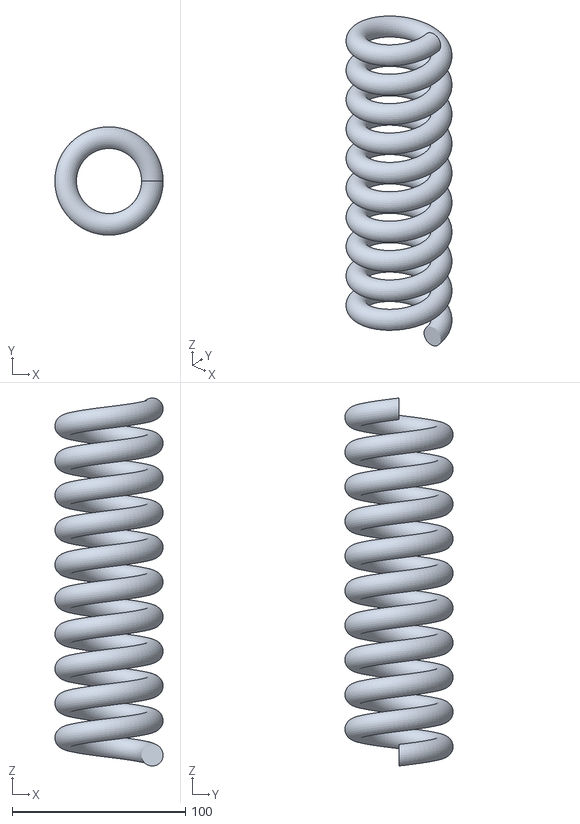
[picture p194: CAD file, 2023-12-15]
Documentation/Teams_Backup/Proposal/Assets/RandomSpring.stl
62.5 x 62.5 x 212.4
