bienemeia/SYSC4907_Group44_GroundVibrationSimulator/Documentation/Teams_Backup/STL/All_pieces_2.stl

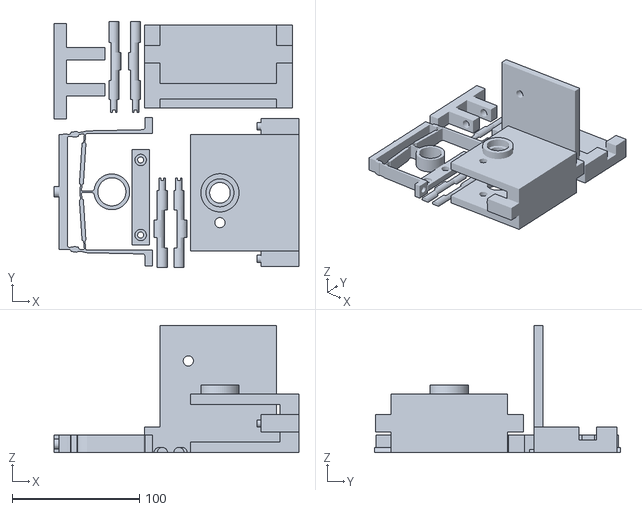
[picture p195: CAD file, 2023-12-15]
Documentation/Teams_Backup/STL/All_pieces_2.stl
192.2 x 193.0 x 100.0
