bienemeia/SYSC4907_Group44_GroundVibrationSimulator/STLs/Frame.stl

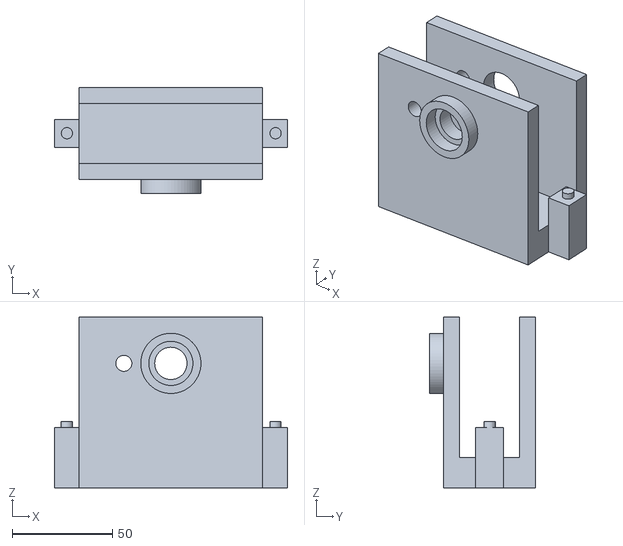
[picture p196: CAD file, 2023-04-18]
STLs/Frame.stl
116.1 x 52.7 x 85.0
