bienemeia/SYSC4907_Group44_GroundVibrationSimulator/Documentation/Teams_Backup/Proposal/Assets/LinearActuator v1.stl

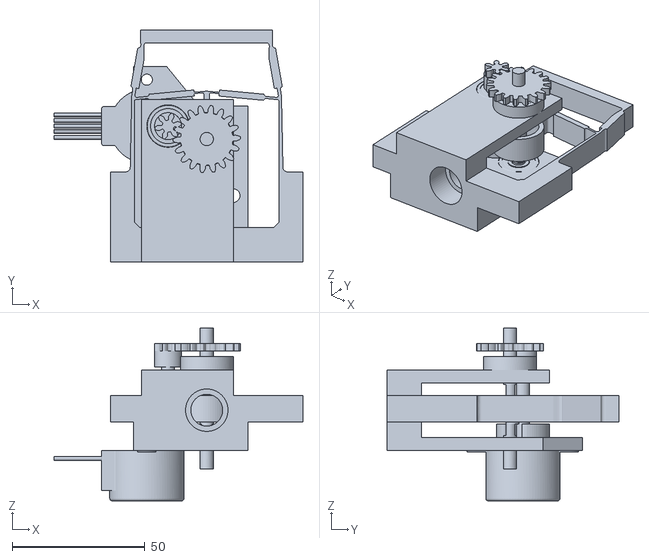
[picture p197: CAD file, 2023-12-15]
Documentation/Teams_Backup/Proposal/Assets/LinearActuator v1.stl
93.9 x 87.4 x 65.2
