bienemeia/SYSC4907_Group44_GroundVibrationSimulator/Documentation/Teams_Backup/STL/5mm shafts.stl

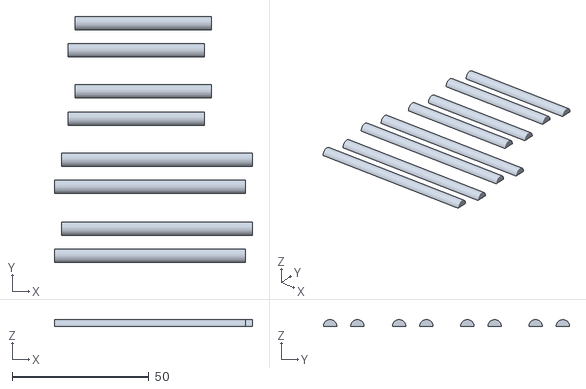
[picture p198: CAD file, 2023-12-15]
Documentation/Teams_Backup/STL/5mm shafts.stl
72.5 x 90.2 x 2.51
