bienemeia/SYSC4907_Group44_GroundVibrationSimulator/STLs/Flexure.stl

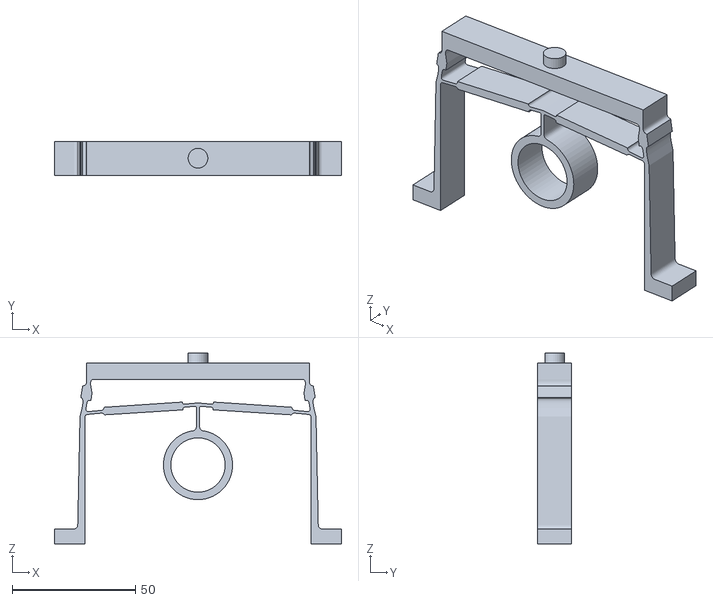
[picture p199: CAD file, 2023-04-18]
STLs/Flexure.stl
116.3 x 13.8 x 77.4
