bienemeia/SYSC4907_Group44_GroundVibrationSimulator/Documentation/Teams_Backup/STL/Camshaft_Split.stl

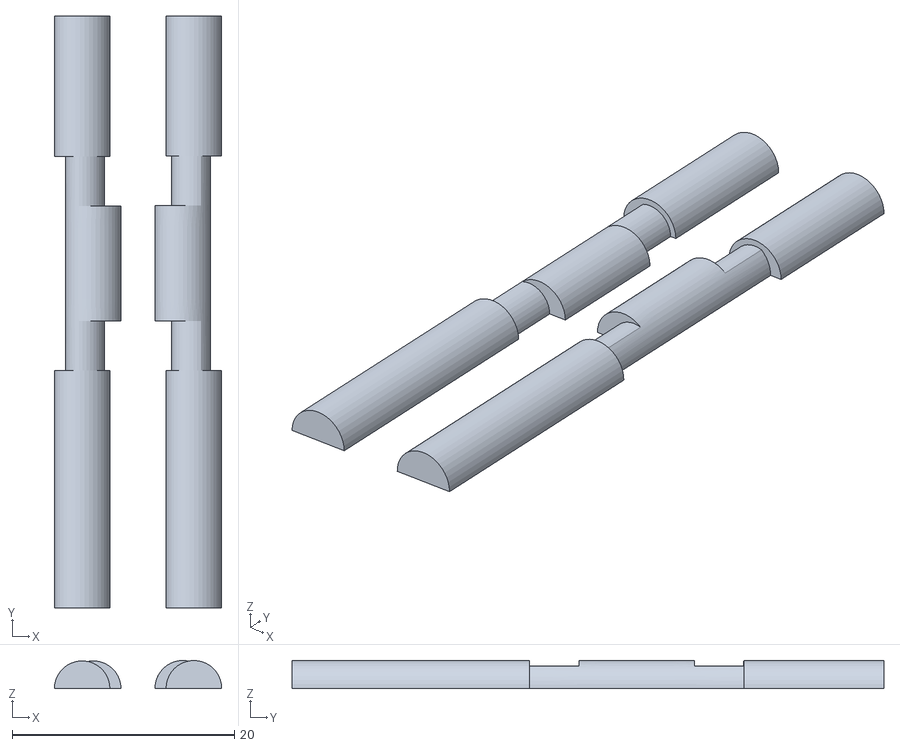
[picture p200: CAD file, 2023-12-15]
Documentation/Teams_Backup/STL/Camshaft_Split.stl
15.0 x 53.2 x 2.52
