bienemeia/SYSC4907_Group44_GroundVibrationSimulator/STLs/FrameBase.stl

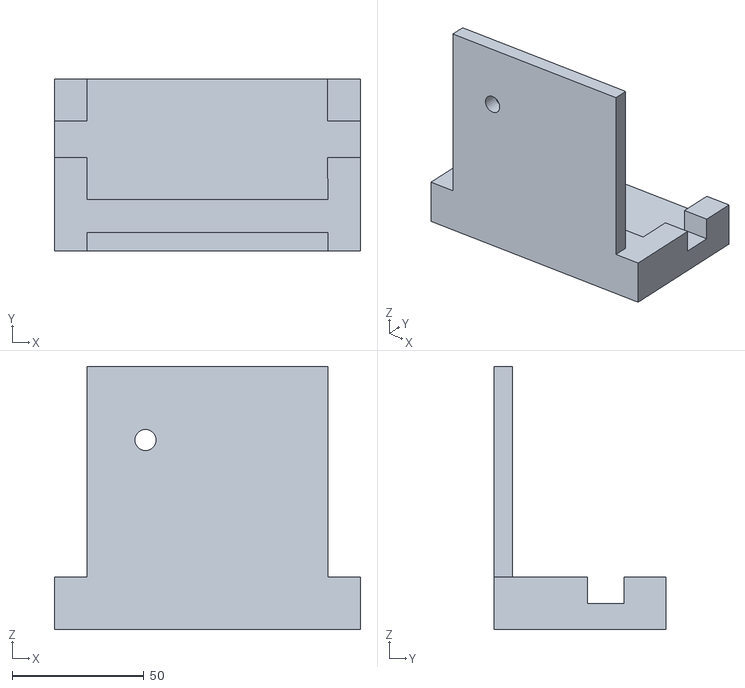
[picture p201: CAD file, 2023-04-18]
STLs/FrameBase.stl
116.2 x 65.2 x 100.0
