bienemeia/SYSC4907_Group44_GroundVibrationSimulator/Documentation/Teams_Backup/STL/Bracket.stl

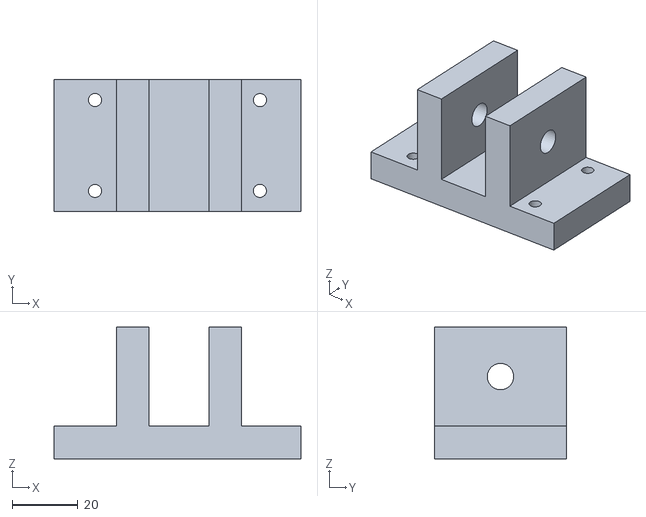
[picture p202: CAD file, 2023-12-15]
Documentation/Teams_Backup/STL/Bracket.stl
75.0 x 40.0 x 40.0
