bienemeia/SYSC4907_Group44_GroundVibrationSimulator/Documentation/Teams_Backup/STL/All pieces.stl

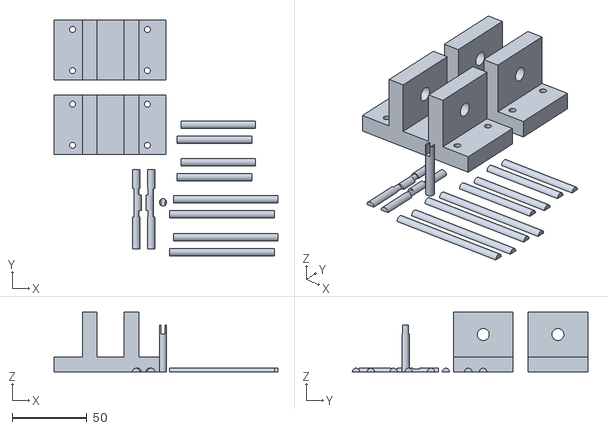
[picture p203: CAD file, 2023-12-15]
Documentation/Teams_Backup/STL/All pieces.stl
150.0 x 157.8 x 40.0
