bienemeia/SYSC4907_Group44_GroundVibrationSimulator/Documentation/Teams_Backup/STL/Camshaft_8mm_3mmOffset_Split.stl

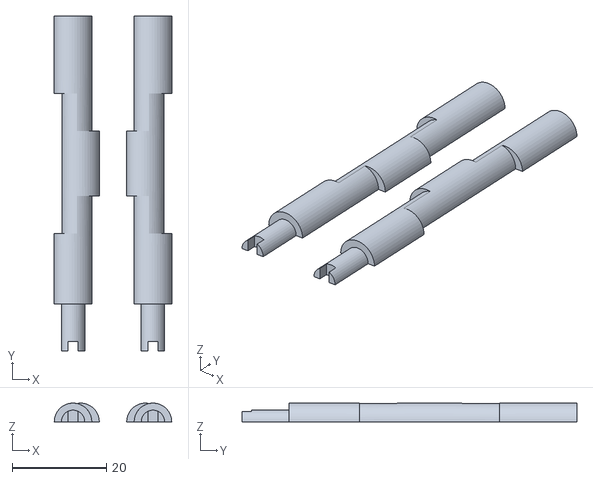
[picture p204: CAD file, 2023-04-18]
Documentation/Teams_Backup/STL/Camshaft_8mm_3mmOffset_Split.stl
25.0 x 71.2 x 3.99
