bienemeia/SYSC4907_Group44_GroundVibrationSimulator/Documentation/Teams_Backup/STL/Coupling_plate.stl

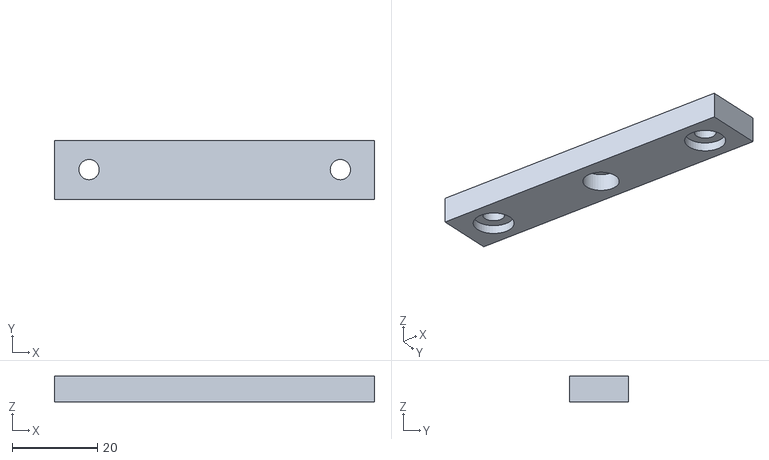
[picture p205: CAD file, 2023-04-18]
Documentation/Teams_Backup/STL/Coupling_plate.stl
75.0 x 13.8 x 6.00
