bienemeia/SYSC4907_Group44_GroundVibrationSimulator/Documentation/Teams_Backup/STL/Camshaft_8mm_5mmEnd_Split.stl

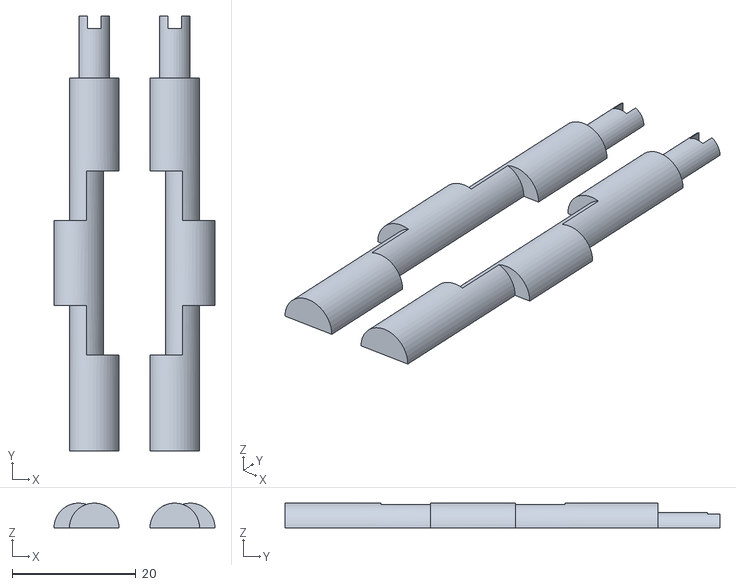
[picture p206: CAD file, 2023-04-18]
Documentation/Teams_Backup/STL/Camshaft_8mm_5mmEnd_Split.stl
26.0 x 70.2 x 4.00
