bienemeia/SYSC4907_Group44_GroundVibrationSimulator/Documentation/Teams_Backup/STL/Coupling_bracket.stl

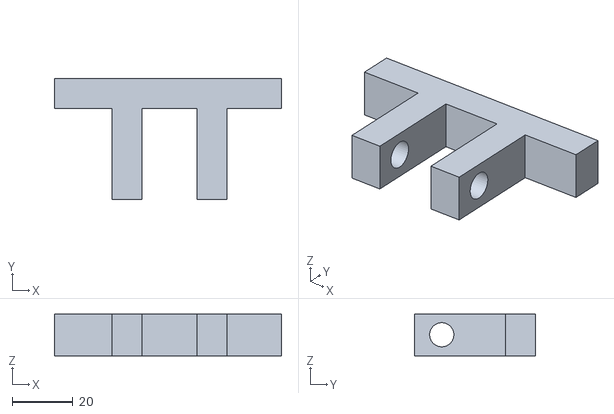
[picture p207: CAD file, 2023-04-18]
Documentation/Teams_Backup/STL/Coupling_bracket.stl
75.0 x 40.0 x 13.8
