bienemeia/SYSC4907_Group44_GroundVibrationSimulator/Documentation/Teams_Backup/Video/Pictures/constructionturtle.jpg

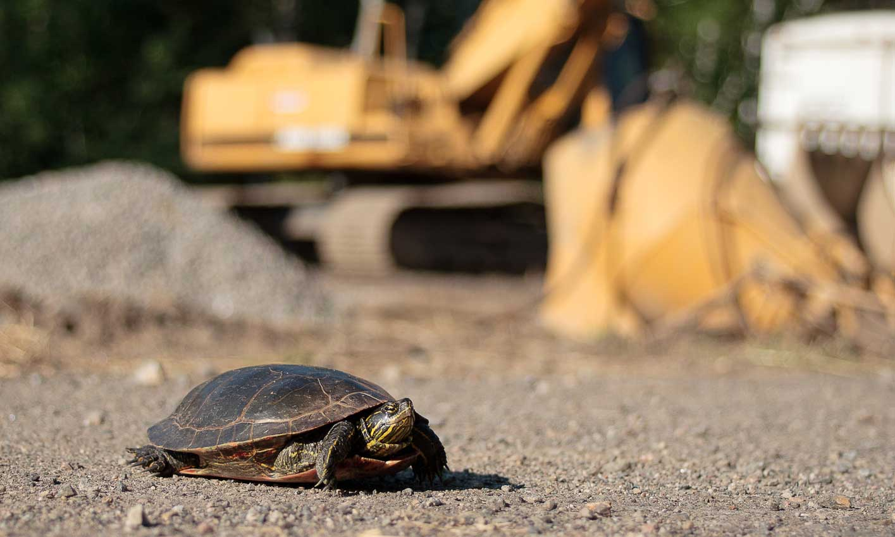
Documentation/Teams_Backup/Video/Pictures/constructionturtle.jpg
