bienemeia/SYSC4907_Group44_GroundVibrationSimulator/Documentation/Teams_Backup/Research/Resources/Vibration Measurement/Selecting_Accelerometers_for_M.pdf

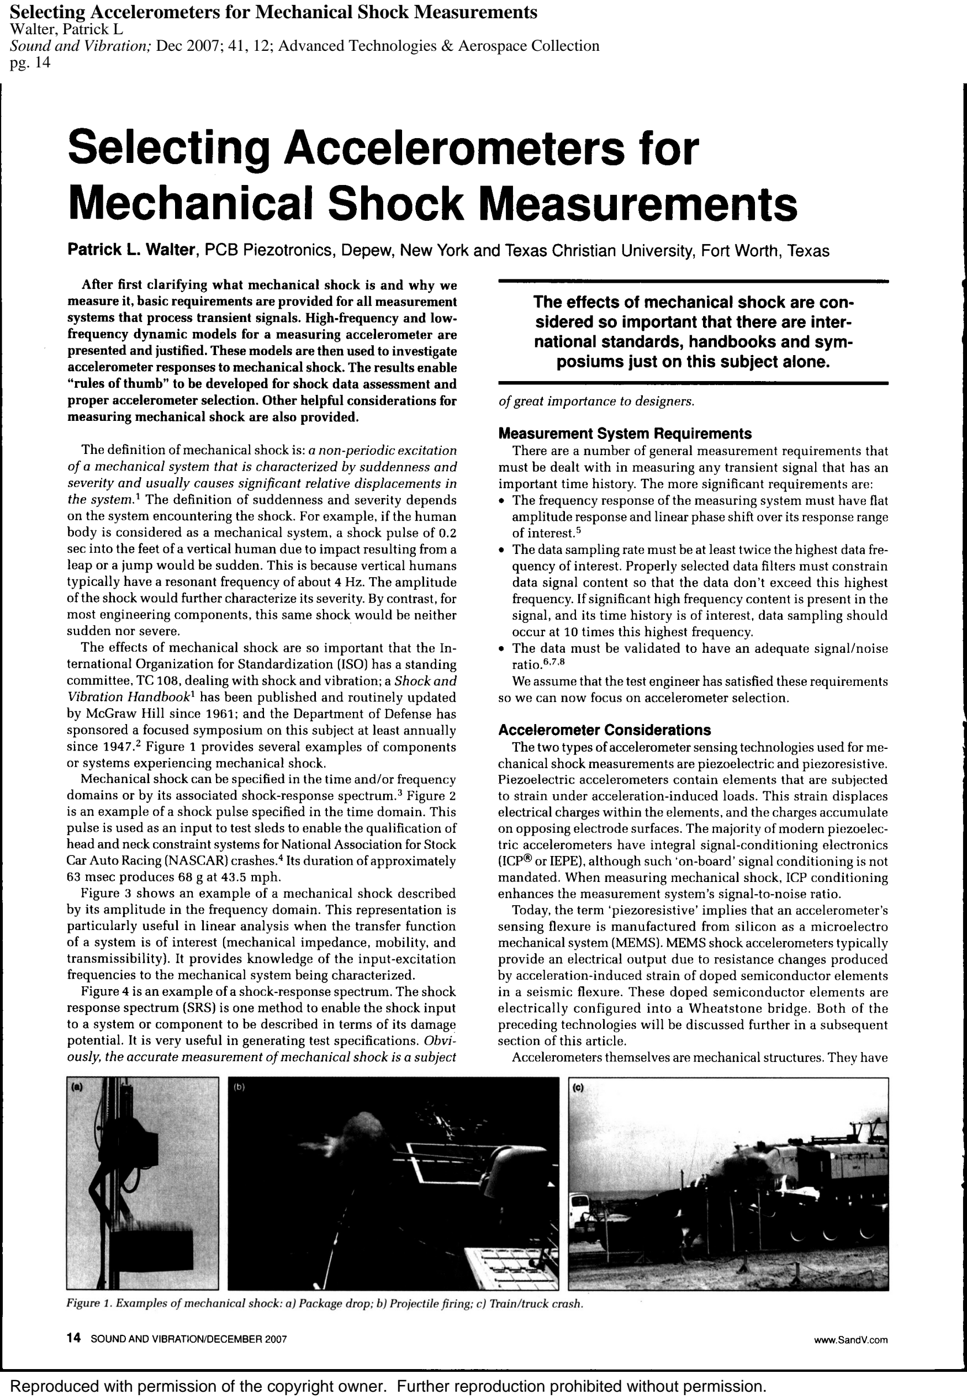
[picture p217: page 1]

Reproduced with permission of the copyright owner. Further reproduction prohibited without permission.

Selecting Accelerometers for Mechanical Shock Measurements
Walter, Patrick L
Sound and Vibration; Dec 2007; 41, 12; Advanced Technologies & Aerospace Collection pg. 14

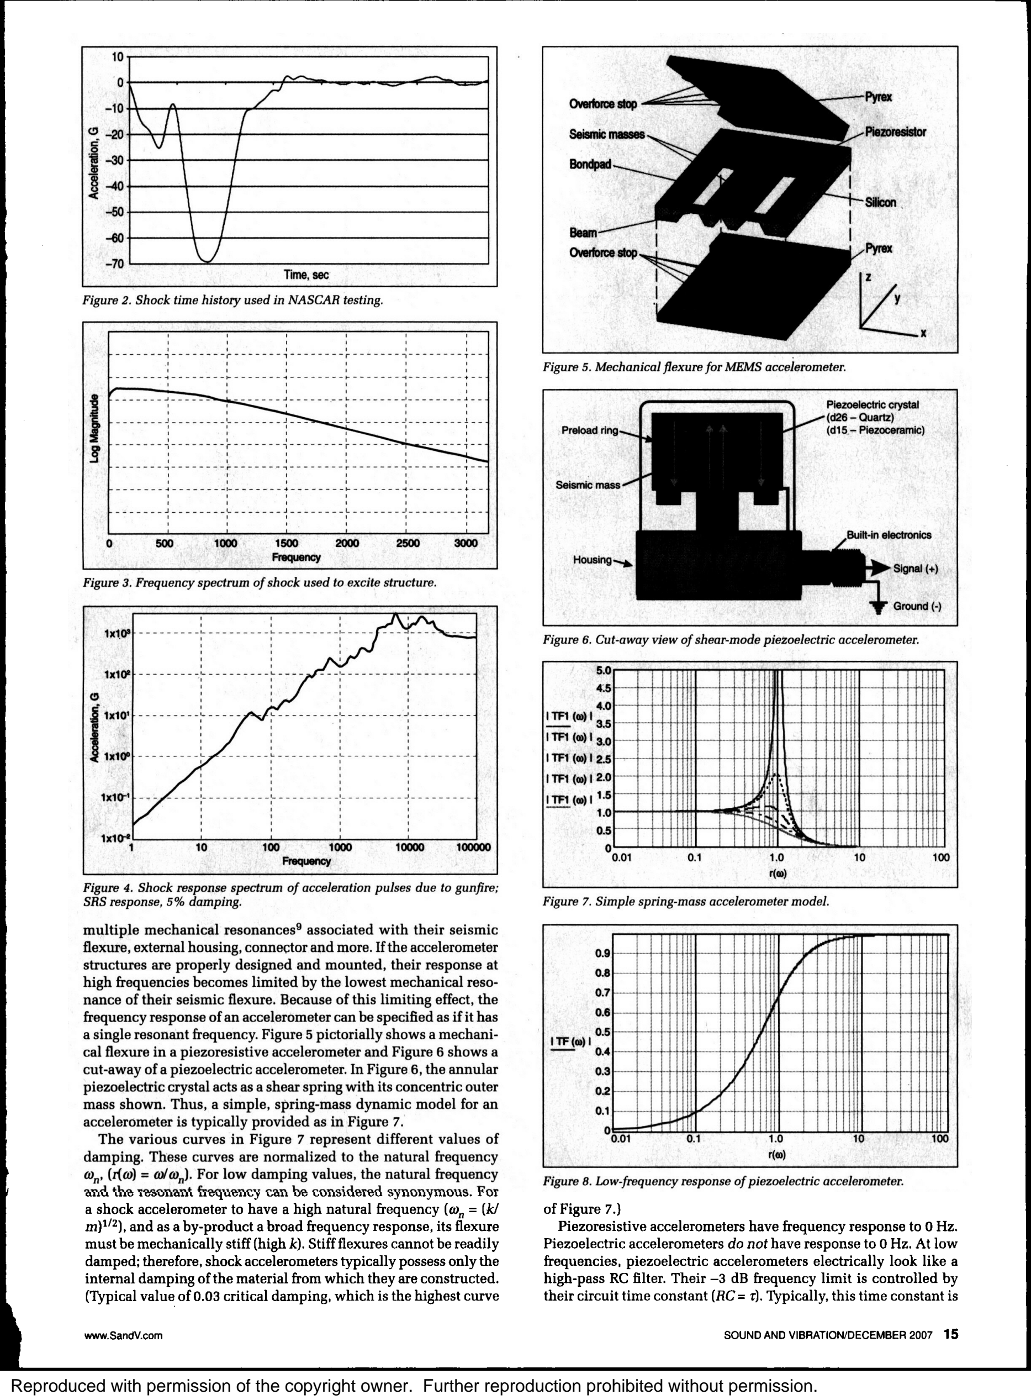
[picture p218: page 2]
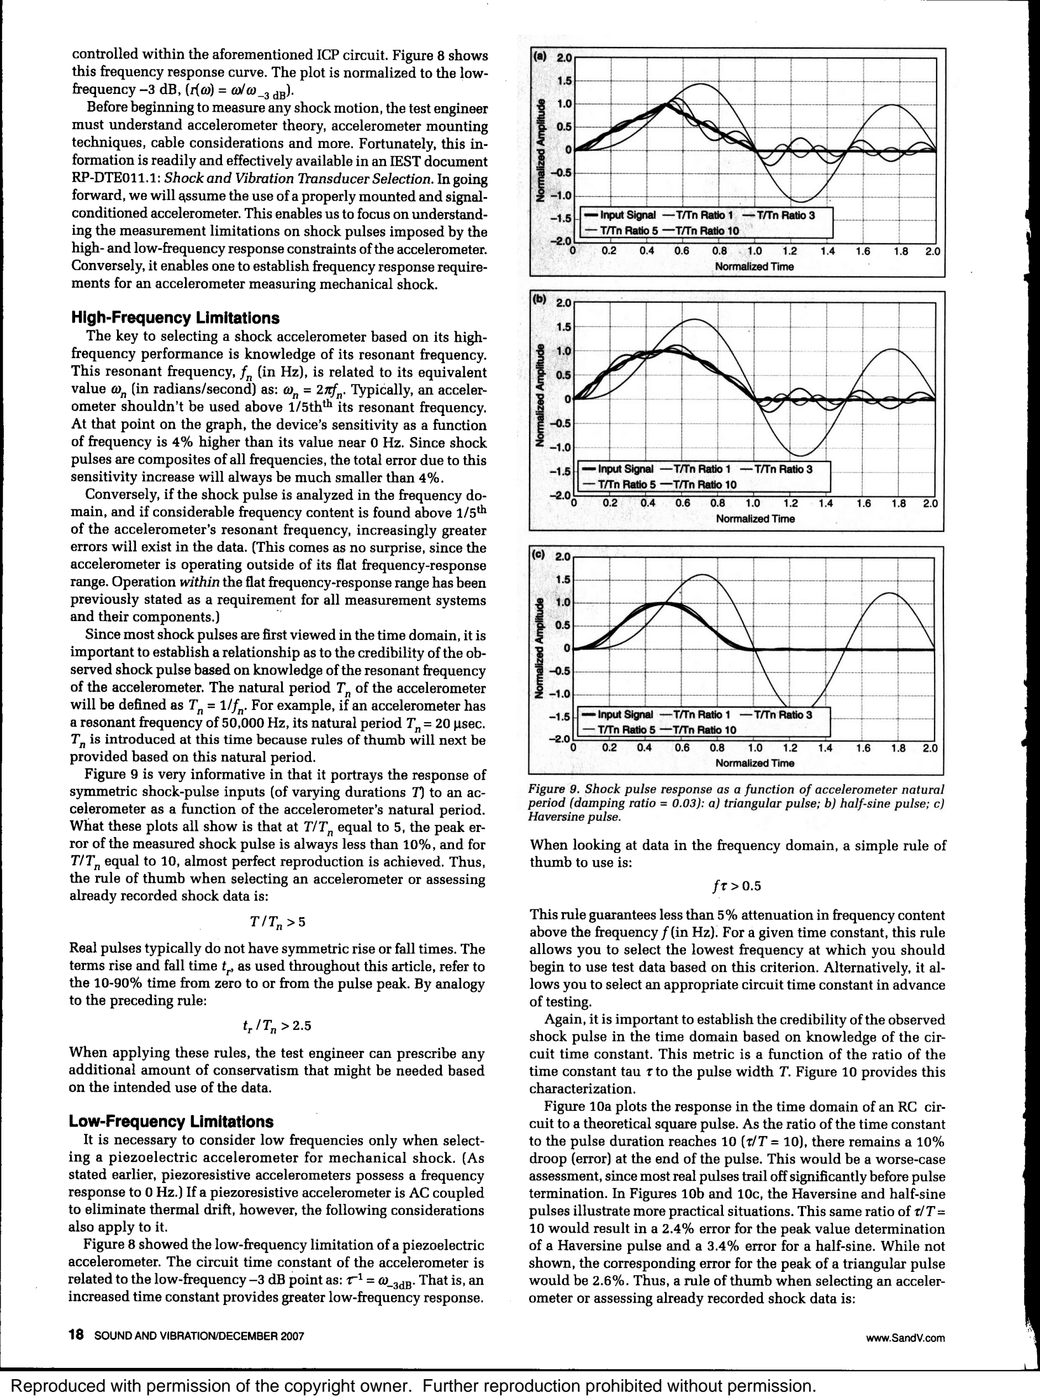
[picture p219: page 3]
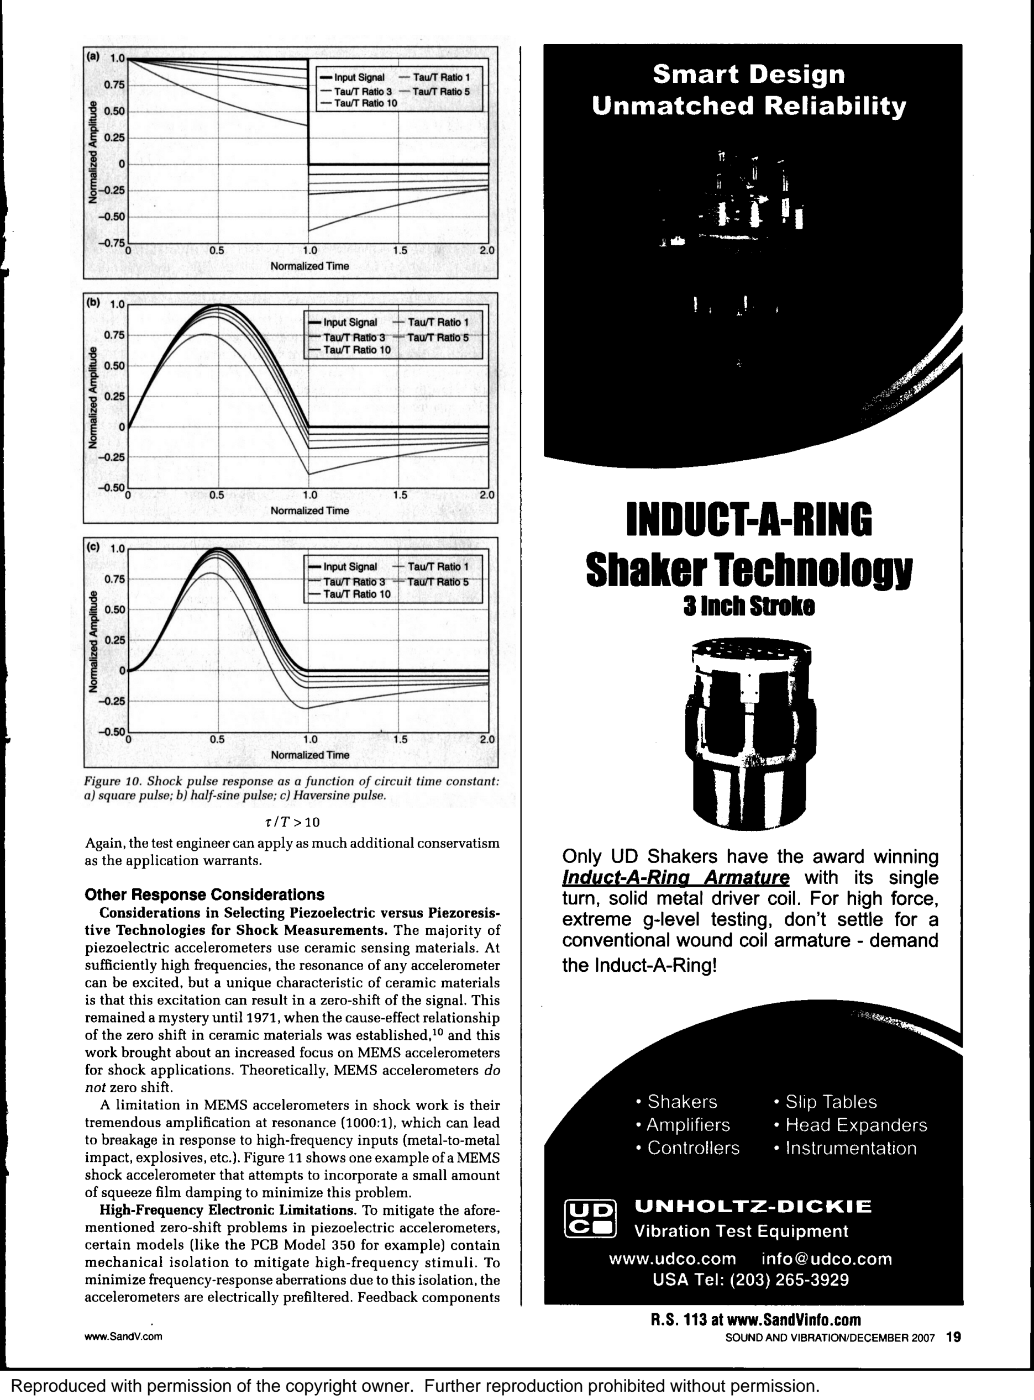
[picture p220: page 4]
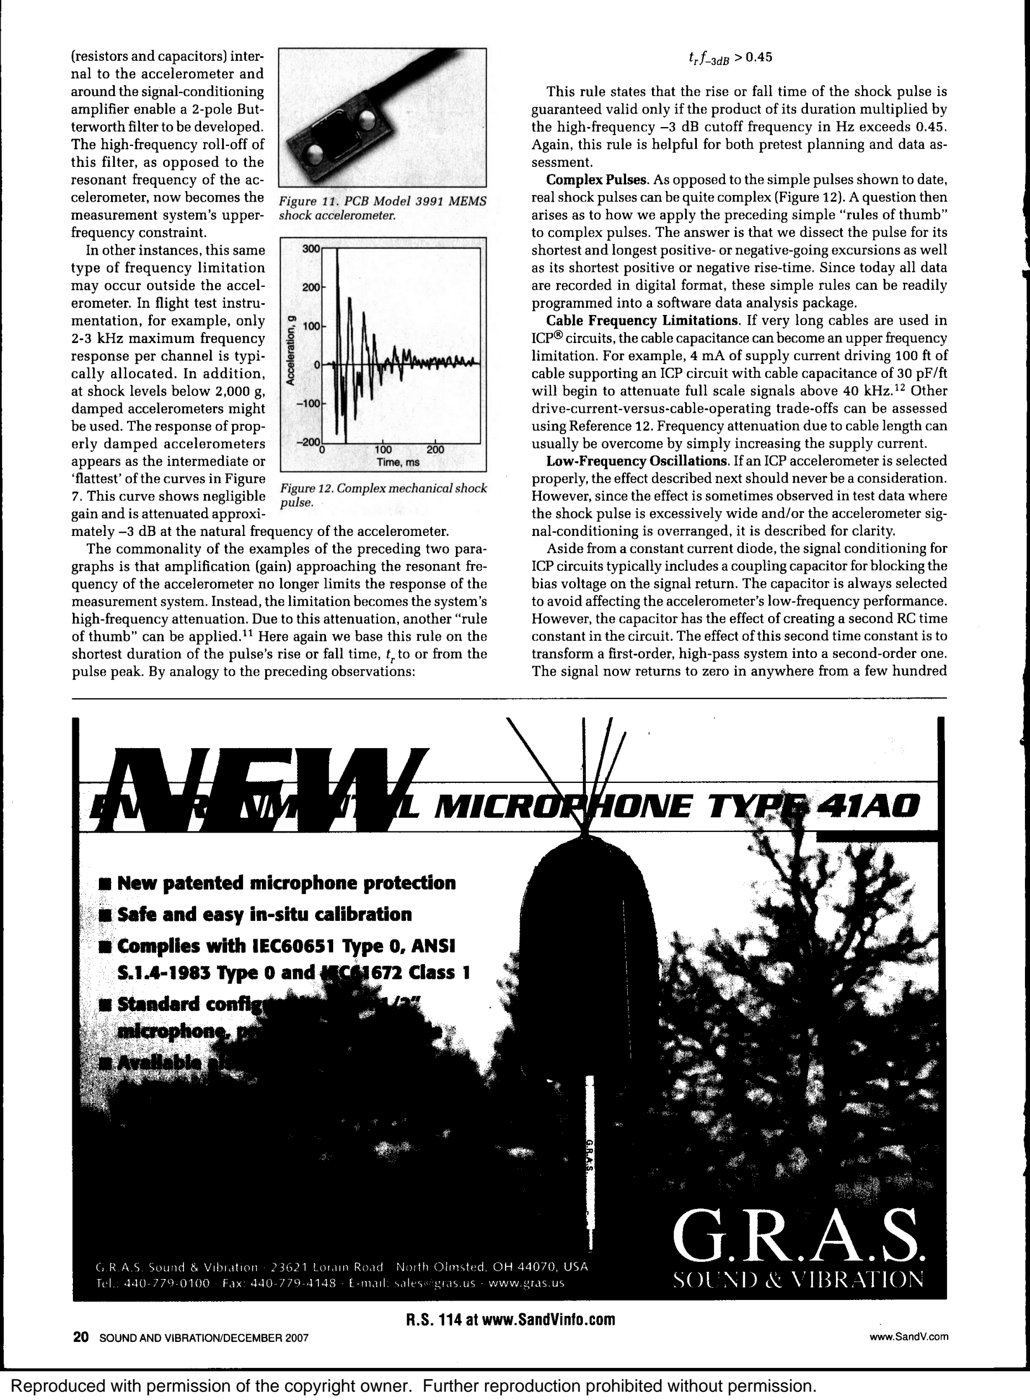
[picture p221: page 5]
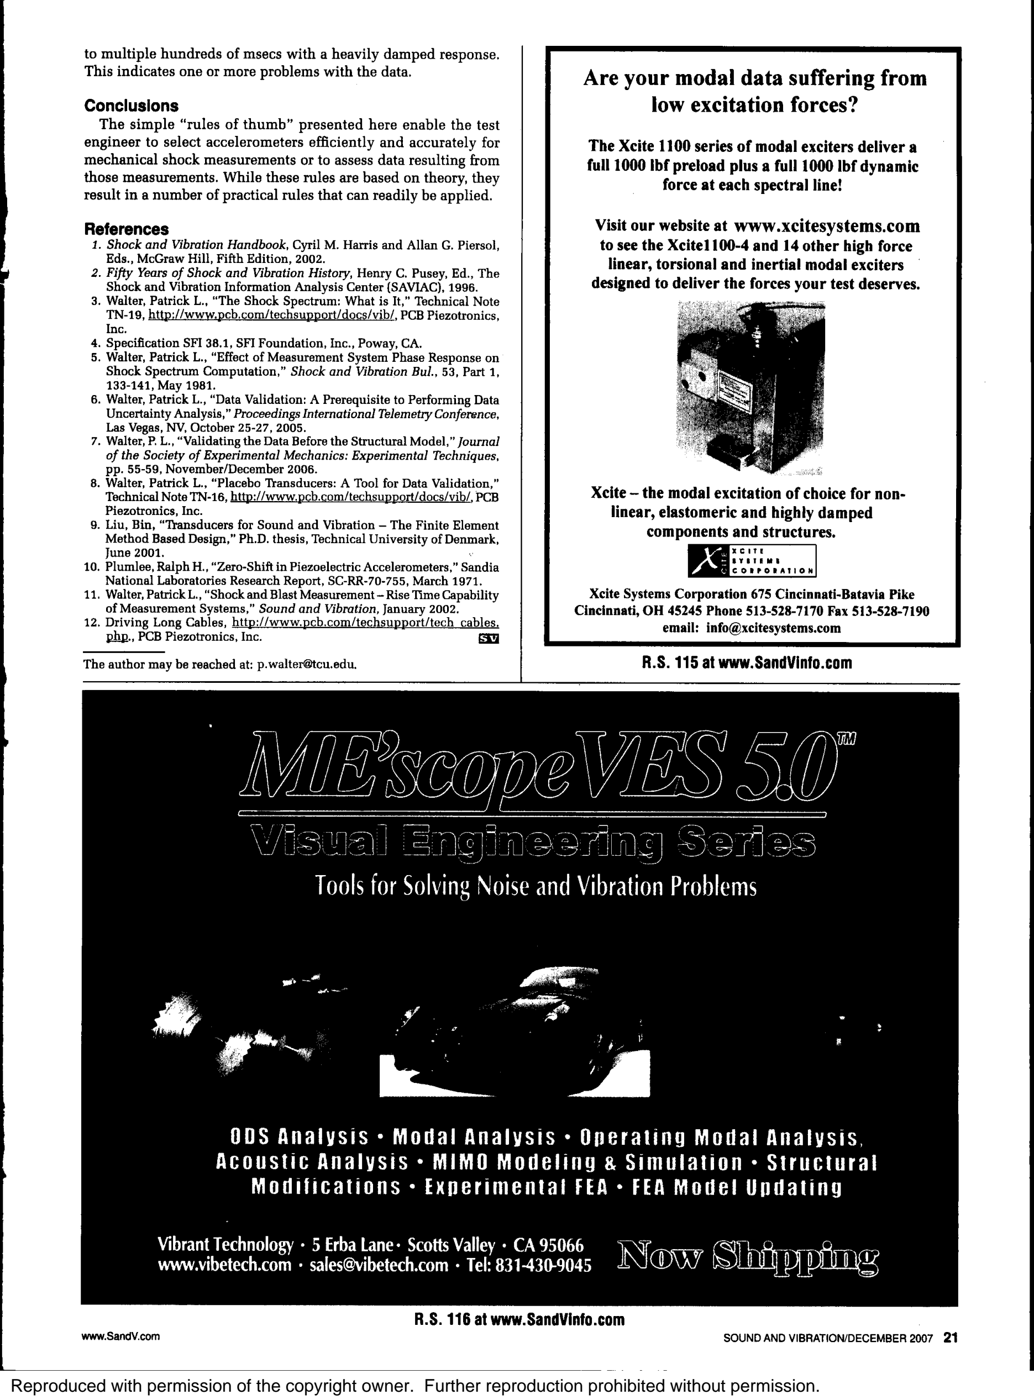
[picture p222: page 6]
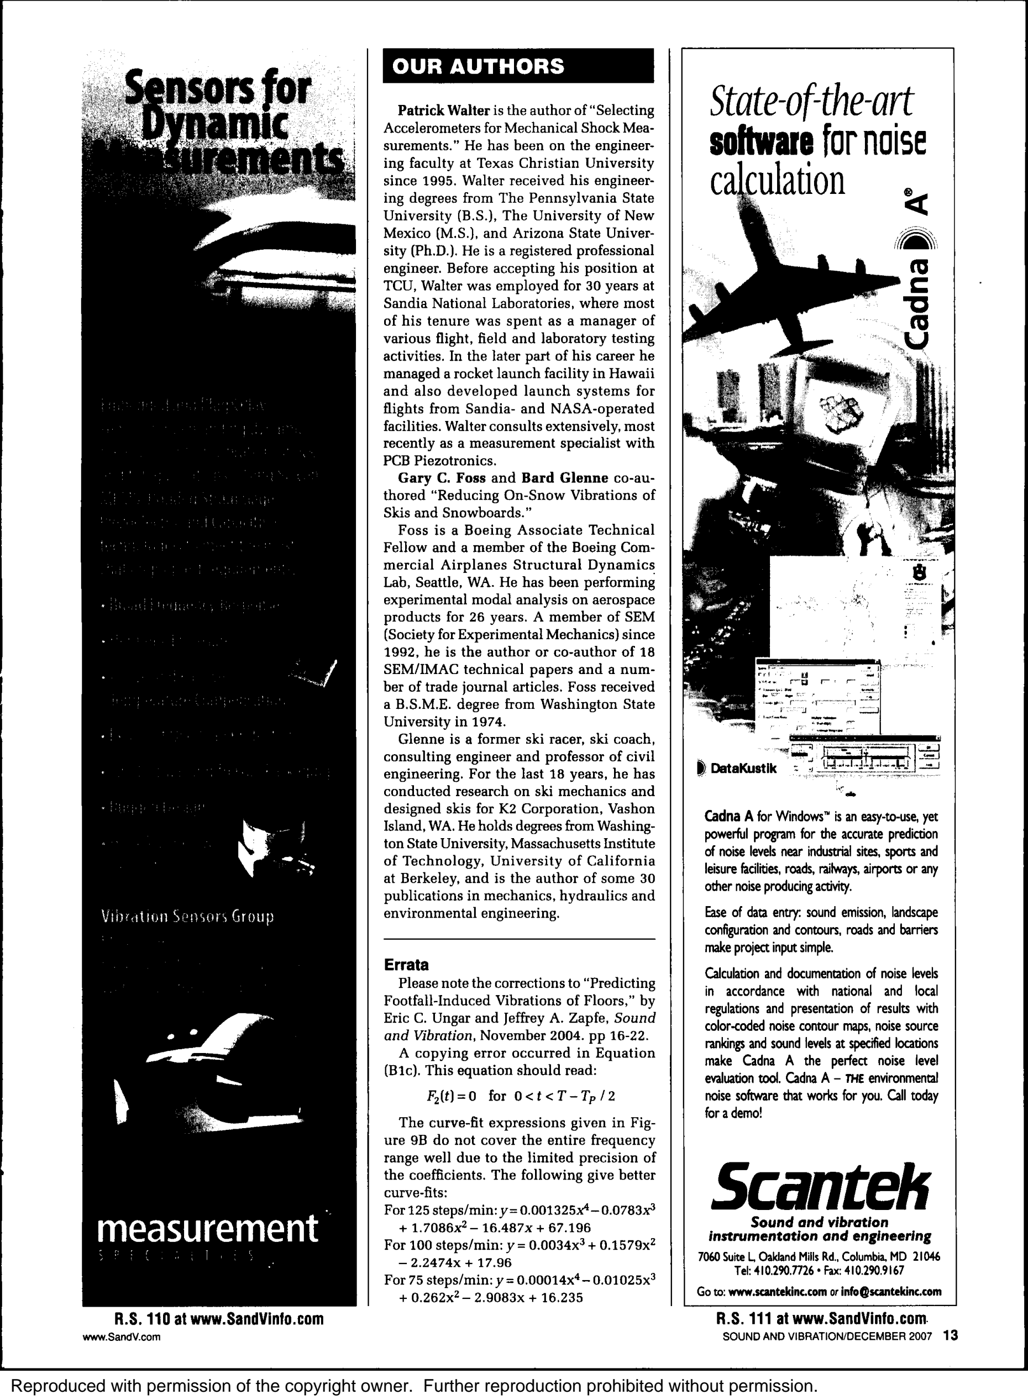
[picture p223: page 7]
