bienemeia/SYSC4907_Group44_GroundVibrationSimulator/I2C_Communication/I2C_Communication.py

#  Raspberry Pi Master for Arduino Slave
#  i2c_master_pi.py
#  Connects to Arduino via I2C

import sys
import smbus
import time

addr = 0x8 # bus address of Arduino
bus = smbus.SMBus(1) # indicates /dev/ic2-1
numb = 0

def main():
        temp = getTemperature()
        hum = getHumidity()
        print("Temp: " + str(temp))
        print("Humidity: " + str(hum))

def getTemperature():
    try:
        print("Getting temp")
        return((bus.read_word_data(addr, 1)))
    except OSError:
        print("Failed to read I2C")
    
def getHumidity():
    try:
        print("Getting hum")
        return((bus.read_word_data(addr, 2)))
    except OSError:
        print("Failed to read I2C")

def ConvertStringToBytes(src):
    converted = []
    for b in src:
        converted.append(ord(b))
    return converted


main()
