bienemeia/SYSC4907_Group44_GroundVibrationSimulator/UI_CODE_POSTER/images_rc.py

# Resource object code (Python 3)
# Created by: object code
# Created by: The Resource Compiler for Qt version 6.4.2
# WARNING! All changes made in this file will be lost!

from PyQt5 import QtCore

qt_resource_data = b"\
\x00\x00\x07\xa3\
\x89\
PNG\x0d\x0a\x1a\x0a\x00\x00\x00\x0dIHDR\x00\
\x00\x00\xbf\x00\x00\x000\x08\x06\x00\x00\x00@\x0c\xab\x0b\
\x00\x00\x07jIDATx\x9c\xed\x9d[\x88\x1cE\
\x14@\xcf\xaa\x88&BF\xf4C\xd4\x90\xf1\x11\xa2\x98\
\xe8@\x02\xe2\xa2a\x93\x88\x11\xa3f|\xa1\xa2\xe0\x06\
\xfcP\x7f\xdc\x05%\xf8\xccC4B\x84\x8d\xf8\xf8\xdd\
\x80A!(\x9b`\x10%\xcan|G?v5\x04\
I|\xec\xfa\x00\x0d1\x99QH\xfc\xd0\xa4\xa5\xc2\xad\
\xf5Z\xa9\x9e\x99\xcdLO\xf7\xf6\xd6\x81f\xba\xabk\
\xbanW\xdd\xaa\xbeu\xab\xba\xab#\x8a\x22b8\x1b\
\xb8\x13\xb8\x01\xb8\x1c8\x178).r \x90\x11\x8e\
\x02\xbf\x02_\x03\xef\x01\xaf\x03\xfb}\xa2\xf9\x94\xfft\
\xe0\x09\xa0\x07\x98\x1eJ40\xc99\x0c\xbc\x04\xac\x95\
\xfdq\x5c\xe5\xbf\x10\xd8\x0a\xcc\x95\xe3w\x81M\xc0\xc7\
\xc0O@\xecc\x22\x10\xc8\x08\x1d\xc0L\xa0\x13\xb8\x07\
X&a_\x01\xcb\x81\x1f}\xca\x7f1\xf0\x11p\x0e\
\xb0\x17\xb8_\x8e\x03\x81\xc9\xcc|\xe05\xe0R`\x1f\
p\xa5\xad\x00V\xf9\x8d\xa9\xf3%p\x19\xb0\x03\xb8\x05\
\xa8\x84\x22\x0f\xe4\x84\x19\xc0f\xe0:`\x17p\x15p\
\xc8v`\x9f\x14\xc5\xffN\x1e\x0dA\xf1\x03y\xe2\x0f\
i\xd0M'x\x1e\xf0(\xd2\xf2\x9f%\x8f\x01\xd3\xb9\
]\x04\x0c\x85b\x0f\xe4\x94N\xe9\xbf\x1e2\xfd[\xd3\
\xf2\xdf%\x8a\xbf=(~ \xe7|*N\x9c3\x80\
{\x8d\xf2/\x95\xfb\xdd\x14J>0\x05\xd8,\xb7\xb8\
\xd4(\xff\x15r\xf0Y\x8d\xfb6\xfd\x81\x9d\xe2\xea\x9c\
\xe8f\xfe7+hU #X\xebf\x9e\xb1\xf9\x0f\
\x8b\xb7g\xba;\x08\xa0\xf8\x06\xb8\xa4\x09\xd9\xbf\x07\x16\
\xcbXA \x90&'\x03\xff\x00G\x8c\xf2[G\x7f\
G\x0d\x81Z1\xb8\xb5\x07\xb8Q<J\x81@\x9a\x1c\
\xd3\xe7v*\xbfa\x14X\x08\xfc\x12\x8a>\x90\x22\xc7\
\xf4\xb9\xdd\x13\xd5.\x10\x9bkN(\xf9@\xda\xb4\xbb\
\xe5\xb7\x98>\xc052\xfb.\x10h7\xa9\xb4\xfc\x96\
\x8b\xc4\xbb\xd4L':\x10h\x8a\xb4Z~\xcb\x1e\x99\
g\x11\xa6S\x04\xdaI\xaa-\xbfe\x8et\x80]\x0a\
)\xcb\x15\x98\x02d\xe1\xcd\xac\xa3\xce\xf1*\xf1\x0a\xad\
NI\x9e\xc0\x14!\x8b\xca\x7f\x9b\xb4\xfc\xa6\x12<\x97\
\x92L\x81)@\x16\xdf\xc9}\x10\xa8\xca\xfec\xc0\xf3\
)\xcb\x13\xc8)YT\xfeO\x80k\x81\x83r\xbc\x12\
X\x97\xb2L\x93\x91.\xd9\x8a\x19\x92\xbd$2\x952\
 K\xea\xde\x1eD\xd1?\xf0\x84\x9b\xd7*\xdf\x01f\
\xcb\xf1\x0b\xf6%\x84\x84\xe8\xabQ(#@o\x82i\
'\x81-\xb35\x0d\xf4\x9f\xba\x81\xfb\x9c\xb0\xaa\xbc\xf7\
:\xd4\xc2\xa9\xee\x83\xa2\xfcC\xf2\xeeHZ\x1c\xcb\x9b\
S\x12J\xfco\xe0\x19\xf9tD=\x1e\x88\xb1\xed\x0f\
:_\x8fx\x04\xf8S\xae\x9b\x04\xb6U\x9a\x8a\x14c\
\xee\xbd,}\xaf!y\x13\xaa\x9a\xa7\xbcIJ\xf9\x7f\
\x9b\x80\x92\xbe\x02,h0\xee\xda\x04\x95\xdfR\x95\x96\
^\xe3\x1e\xe7\x19\xdb\xca\x17\x95\xc9\xd4%\xad\xf6\xa2<\
U\x80\xa4\x94\xdf|\x01\xe2iyk\xa6\x1e\xbb<\x1e\
\x1f\xa4\xe5\xb7\x1f\xcb\xb2<\x95\x90\xbc\x9a\x91\x1a\x8f\xe4\
\x92\x1a\x83\x18q\x14A\xb7\x9cC\x12\xaf\xa4\xe2\x22-\
iQ\xfe\xb7\x05\x18\xab!\x87}\x12\x15$\xde\x16\x8f\
\xe2\x95\xd4y\xc4|\x19s\xae;K\x99\x1a\x8d\xa0\xef\
\xbd(\xe6`Y\xd22\xfb+bd-\xab{\xdd\xe2\
T\x9e!u/\xc8o\x97'\x0f\x8br\x1d}\xcf8\
\xf9\xd8\xba\xca\x17\xfd\x075\xb6$Y\x12\x93\xee\xec(\
\x8a\xf6\xaat\xd7\xd7\x91\xb1\xd9mP\xd2\x19\xacq\x9d\
n%O\xbf\x0a\xefQ\xe1}\x12\xd6\xe5\xc4\xadx\xf2\
p\xb5'\x8dB\x14E\x03\x9e\xb8\x15O|+\xf3\x80\
\xba\xbe\xef\xbfQ\x9d\xbcY]'\xde\xa0:_h@\
\xd6Q'<N\x87\xbabd\xd0\xf7\xdc\x1f\x13\xbf\x99\
\xed8\xa1\xd2R\xfee\x9e\xf4\xe6GQt@\xc5Y\
\x97\xb0\xe2\xeb\x02\xae\xc8\xbe\xde\xfaT<]\xa8\xa62\
\x94\x94\xe2\x0d+\xe5\xd0\xca\x1f\xa9\xf3\x83N\x98\xab\xd0\
\xc3\xea\xdc\xa8\xc4\xd7\x15\xa7\xcf#\xb3\x95{\xd8\xa9\xa0\
\x9af\x94\xbf\xac\xce\x97c\xf2\xc2\xe6\xdbhL\xda>\
\xac2\xf78\xe7\x06\x9d|\xb0\xe4^\xf9;\x9d\xc2n\
\x87\xe2\xbb\x8a\xe4\xa2\x9f\x06\x05U\xc0\x15\xa7\x90J*\
\x9eV\xfe\x8aSpE\xf5\xbf\x8a\xaa0Z\x09{\x9c\
4\xfb=\xe9\x0cz\xc2\xdc2\xf3=]&\xaa\xfc\xbe\
\xeb\xb9O6\xfdDp\x95\xd9\xcdc7?u\xe3Q\
t\xf2P\xebBK\x95?\x8b~\xfe\x97\x95m\xb8N\
\x06\xba\xdaIU\xb9\xf7\xec\xa6;\xbcUe\xf7j\xbb\
\xbe\xb7F\xc7\xf8E\xc7\xe6\x1eS\xae\xd3\x82\xb2\x97\x97\
\xcb\xaf\x89\xbb\xc1I\xb3W\xd9\xbb\xae[r,\x85N\
\xb9\x95\xc1\x95\x0d\x91\xbd\xd1>FY\x95w\xaf\xd3_\
\x19\x92\xbcK\x84,*\xff[\xd2\xd95\xbe\xe9\xc7S\
H\xdfvx\xf5\xe6\xfa\xf8]\xe5\x1cq\x8e]|\x8a\
\xa0\xc3l\xc7\xd0V\xa4\x1d\x9e\xf8\xda\x0b\xe5\x8eG\xd4\
\xea8\xb7\x02=Pf\x95\xdc\x86\xc5uB}\xf7\xe0\
C_\xbb^>\xb5\x94,*\xff\xb32\xdf\x7fM\x06\
d\x89\xa3 \x9e\x15K\xbd1\x02\xdf,\xd5\x13\x99\xb9\
\x9a\xd6lW}\xaf\xae2\xc6\xc94\xe3\x04\xd2iU\
>5DV\xbf\xb7\x9fu_\xf2\x80*\x94\xaa'\xcc\
e\xb9'\xac\xac\xf6m\x8bn\x15\xcb5k\x90\x16\xd2\
\xb6\xf8[\x9b\x13\x7fB\x984\x1f\x96}m^\xe9\xa7\
\x90od\xbc\xec\x09\xf3\xa1\xcd\xb5n\xcfy_\xde\xb5\
\x84\xb0\xd8\xc4\xf1\x14\xc5\xe4\xd2\x9b.\x94\x1e\xd5\xcao\
p\xec\xff\xfe\x98kv\xcb\xb5\x0a\xea\xb8O\xf6\xb5?\
\xdb\xda\xb7E\xa9Lz\x90i@\xf6\xab*~\x12\xe8\
\xfb6\x03[\xc3\x8eMn\xd1\xb6x\xbf\xca\x13W\xf6\
z\xe8\xf1\x8eU*\xaf\x0b\x1c\x9f\xf7\xad\xa5\x81^~\
\xbb\xbd=im\x8dx{J*lX\xc9\xd9\xa7\xc2\
\xad\x97\xc6\xe7\xeat\xa9x\xbc4\xfdu\xfe\xd3]\xc7\
{\xd2\xac\xb7\xa7\x91t\xed\x16\xe7Vu\xa9'o)\
f\x1c\xc4%\xf7\xde\x9e\xac\xa2[\xf6\xaa3\xd2\xb9F\
=\xbeWy\xcc\x80^\x8f\xadl'w\xb9^\x9a\x15\
\x1e\xef\x09\xaa#\xbe\xb1\x8d\xf93\x22\xe9\xc5\xa5\xbbQ\
\xe6\xfc\xb8\x1d\xee-u\x1c\x00\xbet|\x1fINt\
Ba\x16fu\xde\x04lK\xf0\xfaia\xe7\xc3\xa0\
\x0a\xd6\x0e\xf9\xbbS\x10\xe2\xd0\xd3\x17\x92\xf6\xe84K\
\xabd-\xaa) I\xb9o\xc7gu\xfe%\x9f+\
\x9cV\xe3s\x85IR\xab\xd2\xe5\x8d\x89*\xc6d\x9a\
P\xd7*Y\x93\xae\xe8v>\xdb\x11c\xf6\xfc.\x07\
\xe7\xd5\xf8C\x92\x9f\x18\xdc\x9d\xe0\xb5\x03\x01\x97\xf3\xe5\
x\xdfI\xaa\xc6v\xd6\xc8\xa6\xdb\x81/Z\x9c\x8d\xdf\
\x8a\xbd\xf8CN\x8bG\x8f\x14\xe7j\x1e\xfc$\xc7\xce\
Z\xddel\xfe\x87dN\xfdvY\xb3(\x10\xc83\
\xdbd\x85\xc6^\xbb,\xd1\x98\xacV\xb1Xu\xd2\x02\
\x81\xbc\xb1@,\x98\xf1e\x89\x0e(\xb7\xd4\xab'8\
,\x1d\x08d\x9di\xe2\xaa\xee\x90\xf7\xc1\xf7\xeb\xa5H\
w\xcaJu\x1f\x8a-~0\x14g '\x18\x17\xec\
\x9b\xc0\x12Yh\xc5<\x01\x0e\xdbA.\xe3\xee\xbcU\
\xbe\x9b\xbfP*\xc2T}\x99;\x90/\xae\x06>\x17\
\xc57\x8bP\xdfl]\xfaz\x05vdp\xe1m`\
\xae\x1c\xbf/\x0bx\x99\xdf\x9fe9\x97@ \xcb\x98\
e\x87f\x8a\xb2\xdf\xa1\x16\x5c\xdc-\x93\xed\xc6\xdd\xf6\
\xae\xf2\x1bN\x93\xc9[+\xc3\x07c\x039\xc0,@\
\xbd^&\x12\xfeo\x10\xd7\xa7\xfc\x963\x81\xbb\x81\xeb\
e\xc5F\xf3E\x86S\x836\x042\x8e\xf9f\x94Y\
\xf4\xc4\xac\xb6n\xbe\x1e\xf2\x86\xb7\xff\x0a\xfc\x0b\xdd\xa0\
\xec\x0b+\xad\xd3\x98\x00\x00\x00\x00IEND\xaeB\
`\x82\
\x00\x01\x05\xd5\
\x89\
PNG\x0d\x0a\x1a\x0a\x00\x00\x00\x0dIHDR\x00\
\x00\x01!\x00\x00\x00\xc3\x08\x06\x00\x00\x00\xcd\xe6\xa7&\
\x00\x00 \x00IDATx\x9c\xec\xddy\xb4\xdeU\
u?\xfe\xcfs\x87\xe4\xdeL$d\x1e a\x0a\x84\
Y\x99\x14E\xc4\xd9**8\xd5V\xc5\xa9j\xfb\xd5\
\xb6N\xb5\xfel\xbfv\xf5\xb7V\xfb\xfb\xa7]\xcb\xd6\
\xd6\xa5U\x99\xa2\x80-P\x14Ef\x04\x15\x22\x10\x12\
\x82\x84\x00\x19\xc9L\xe6\x9b\xe9\xe6\xe6\xe6\xfe\xd6\xeb\xc3\
\xf3\xce\xfa\xf4\xe9\xf3\xdc\xc4\x01K\xdb\xfbYyV\x9e\
\xfby>\x9fs\xf6\xd9g\xef\xf7\xd9{\x9fs\xf6\xa9\
\x0d\x0c\x0c\x14C\xd7\xd0\xf5\xdb\xba\xc8[\xadVkV\
[\xad\xaf\xafoTOO\xcf\xe4\xde\xde\xdeY{\xf6\
\xec\x99\xf9\xcc3\xcf\x1c\xbdi\xd3\xa6\x91\x93'O^\
\x7f\xfc\xf1\xc7\xffb\xe2\xc4\x89\xbfhoo\xdfP\x14\
Eo\xf5\xc5F\x19nQ\xfe\xd0\xf5\x02\xbd\x86@h\
\xe8\xfa\xaf\xba:\xfb\xfa\xfa\xc6m\xde\xbc\xf9\xc8\xad[\
\xb7N\xd9\xbau\xeb\xac\xad[\xb7\x1e\xbb\x7f\xff\xfe\xe3\
\x8a\xa28\xea\x17\xbf\xf8\x050:r\xca\x94)\xc3\x9e\
x\xe2\x89\x1dmmmk\xce<\xf3\xcc\xa7g\xcf\x9e\
\xbdh\xfa\xf4\xe9\x8b\xba\xba\xbaV\xb6\xb7\xb7o\x1d3\
f\xcc\xf6\xce\xce\xce]C\xbd\xf8\xdf\xf7\x1a\x02\xa1\xa1\
\xebW\xba~\x05\xeb\x03\xe8L\xda\xb6m\xdb\xd4\x8d\x1b\
7\xce\x5c\xbf~\xfd\xec\x0d\x1b6\xcc\xd8\xbau\xeb1\
\x03\x03\x03\xb3\xba\xbb\xbb\xc7\x8e\x1f?~\xd4\xf8\xf1\xe3\
Go\xd8\xb0\xa1\xd8\xb4iSq\xf6\xd9g\x17'\x9d\
tR\xf1\x93\x9f\xfc\xa4\xf8\xfa\xd7\xbf^\xac_\xbf\xbe\
8\xfe\xf8\xe3\xf7\x9es\xce9\xcb\xcf8\xe3\x8c_\x8c\
\x1a5j\xe9\x81\x03\x07\x9e\x191b\xc4\xb21c\xc6\
\xac\x19;v\xec\xc6Q\xa3Fm*\x8ab\x7f\xb5\xe2\
*\xadCV\xd2\x0b\xef\x1a\x02\xa1\xa1\xeb\x97\xbe\x06q\
\xa9:\xfa\xfb\xfb'=\xfb\xec\xb3@\xe6\xd8\x9d;w\
\x8enoo\xf7\xe0\xf0={\xf6LY\xbat\xe9\xb1\
k\xd6\xac\x99\xd9\xde\xde>c\xea\xd4\xa9G\x1ey\xe4\
\x91m\xa3F\x8d\xea\x9c<yr\xed\xa8\xa3\x8e*:\
;;\x07~\xf1\x8b_\x14\xdb\xb6m\xab\x9dz\xea\xa9\
\xc5\x8c\x193\x22\x9c5@\xf4\xedo\x7f\xbb\xd8\xb3g\
O1n\xdc\xb8b\xe2\xc4\x89\xbb\xe7\xcc\x99\xb3c\xea\
\xd4\xa9=\xb5Zm\xed\xbe}\xfb\x9e\xe9\xef\xef_;\
r\xe4\xc8e\xe3\xc6\x8d[:~\xfc\xf8g\xc6\x8d\x1b\
\xb7\xae(\x8a\x1d!\xee\xc0\x81\x03%\xddC@\xf4\xc2\
\xba\x86@h\xe8\xfau\xae\xb6\xde\xde\xde\xa9\x9b6m\
:n\xed\xda\xb5\xb3\x9f}\xf6\xd9\x13\xd6\xad[w\xe2\
SO=u\xdc\xaaU\xabfvuu\x8dloo\
\x1f\xe8\xed\xedm\x1f;vl1e\xca\x94b\xed\xda\
\xb5\xc5\xf0\xe1\xc3\x8bW\xbe\xf2\x95\xc5y\xe7\x9dWL\
\x9a4\xe9\x009\xdc\xb9sg\xed\xe1\x87\x1f.z{\
{\x8b3\xce8\xa3\x98<yrIV\x15\xf0\x1ey\
\xe4\x91\xe2\xa7?\xfdi\xf9\x9d\xa5\xb4q\xe3\xc6\xe2\xe4\
\x93O\x1e\xb8\xe0\x82\x0bz&M\x9a\xb4w\xf7\xee\xdd\
\xfb\xb7o\xdf\xbe\xa5\xb7\xb7wM\xadV\xdb\xb0\x7f\xff\
\xfe\xd5\xc3\x86\x0d{j\xea\xd4\xa9\x0b\xa7O\x9f\xbe\xb8\
\xad\xadmoc\x99C\xd7\x7f\xfd5\x04BC\xd7\xc1\
+\xb20\x88\x82\xb6\xed\xde\xbd{\xca\x86\x0d\x1b\x8e^\
\xbdz5\xc0\x99\xb3j\xd5\xaa3V\xacXq\xcc\xc6\
\x8d\x1b\xa7\xee\xdb\xb7o\xac2\x8e8\xe2\x88\x02\xe8\x8c\
\x1a5\xaat\xa9\xb6l\xd9R\x02\xc6\xc4\x89\x13\x8ba\
\xc3\x86\x15===\xc5\xf6\xed\xdb\xcbz\x8e?\xfe\xf8\
\x12\x9c\xb8Z#G\x8e,.\xbc\xf0\xc2\xf2\xbdV4\
=\xf6\xd8c\xe5g\xd2\xa4I,\xa6\xe2\xee\xbb\xef.\
\xba\xba\xba\x8a\x17\xbd\xe8E\xc5\x99g\x9ey\xe0\x88#\
\x8e\xe8\xdd\xb0aC\xdf\xc2\x85\x0b\xdb\xe6\xcf\x9f\xdf6\
|\xf8\xf0\x9d\xd3\xa6M{\xfa\xc4\x13O\xfc\xe1\xf9\xe7\
\x9f\xff\xbdq\xe3\xc6-\x1a\xea\xf1\x17\xd65\x04BC\
W\xcb\xeb\xc0\x81\x03\xed===S\xd6\xad[\xc7\xd2\
9~\xf3\xe6\xcd'\xaeZ\xb5j\xce\x92%Kf\xae\
Y\xb3fj\x7f\x7f\xff\xf8Z\xad\xd66z\xf4\xe8\xe2\
\xb8\xe3\x8e+f\xce\x9cYZ0'\x9cp\x02\xd7\xaa\
\x8c\xe5\xbc\xef}\xefc\xe9\x14+V\xach[\xb4h\
Qi\xc1p\xa9\xf6\xed\xdbW\x82\x93\xf8\x0f\xcbh\xce\
\x9c9\xc5i\xa7\x9dV\x82\x17\xa0\x9a>}z\xe9v\
5\xbb~\xfe\xf3\x9f\x17\x0b\x17.,\xebY\xb3fM\
\xc1\x82R.\x97\x0e-\x00N\xfd\x5c\xba\xa9S\xa7\x16\
O>\xf9$`{v\xe2\xc4\x89\xf7\xce\x981\xe3\xfa\
\xd9\xb3g\xdf]\x14\xc5\xfa\xa1\x9e\x7fa\x5cC \xf4\
\xbf\xf0jf\xf1\xb8\xd7\xdb\xdb\xdb\xd5\xdb\xdb{\xd4\xea\
\xd5\xabO\x5c\xbf~\xfd\xac\x9e\x9e\x9eY\xdb\xb6m\x9b\
\xbdl\xd9\xb2c\x9f|\xf2\xc9)\xbbv\xed\x1a\xd7\xd7\
\xd7\xd7\x06$\x80\x0e\xe0\x981cF\x09\x18\xac\x991\
c\xc6\x14\xdd\xdd\xddey\xdc\xaa\xcb/\xbf\xbcx\xcb\
[\xdeRL\x9b6\xad\xbc\xb7k\xd7\xae\x124V\xaf\
^]<\xf1\xc4\x13\xc5SO=U\x02\xd1\xf8\xf1\xe3\
K\x00c\x09\x1dy\xe4\x91\xa5%\x85\x9e\x8e\x8e\x8e\xf2\
o\xc0\xd6\xd7\xd7W<\xfb\xec\xb3e\x19\xaee\xcb\x96\
\x95\xe0\xa2l\xd6\x96r\x1fx\xe0\x81\xf2w@\x04|\
^\xf7\xba\xd7\x95q\xa6;\xee\xb8\xa3,{\xcd\x9a5\
\xfb7l\xd8\xb0\xe6\xdcs\xcf\x9d?a\xc2\x84G\x87\
\x0f\x1f\xbe\xe2\xf8\xe3\x8f\x7f|\xea\xd4\xa9K\xaa\xb1\xa3\
\xa1\xeb\xb7{\x0d\x81\xd0\xff\xf2k\xdf\xbe}\xdd\x1b6\
l8n\xe5\xca\x95\xa7\xaf[\xb7\xee\x9c\x15+V\x9c\
\xb5r\xe5\xca\xe9\xdd\xdd\xddcF\x8e\x1cy\xc4\xe6\xcd\
\x9b;\xc5q\xb6n\xddZ\x82\xccYg\x9dU\xbc\xe4\
%/)N?\xfd\xf4\xd2\xbdjkkk\xca\xc0\xdd\
\xbbw\x17\xd7^{m\x09\x10\x9e\xad^;v\xec(\
\x00\x832\xdb\xdb\xdb\x8bU\xabV\x95\xee\xd8\xde\xbd{\
K@\xf3<\x00z\xfa\xe9\xa7K\xab\x08\xd0\x00\x19\x16\
\x0e\xf7\x8d\xeb\x05\xb4\x80\xd9=\xf7\xdcS\x82\xd6\xd1G\
\x1f]\xf4\xf7\xf7\x17+W\xae,\x9fci\x01*\xae\
\xdd\x88\x11#\xca\xda\x05\xbdYL\x9e\xef\xee\xee\xee\xed\
\xeb\xeb\xdb6e\xca\x94\xb5\xe7\x9dw\xde\x83\xe7\x9cs\
\xce]3g\xce\xbco\xd8\xb0akC\xaa\xf2\xb4o\
(~\xf4\xfc^\x1d\xff\x93\x1b7t=w5\x0b\xc4\
\xf6\xf4\xf4LZ\xb6l\xd9Y+V\xac8\x7f\xd7\xae\
]gtww\x9f\xb0o\xdf>nV\xf7\x8a\x15+\
J\xe5\xa7\xbc\x94\x90\xdb\xc3er\xef\xe4\x93O.\xad\
\x1d\xca\x0e\x9c\xdc\x03\x18\xee\x89\xcd\xe4\x7f\xf7\xb8G;\
w\xee\xfc\x0f\xf5zg\xde\xbcy%\xa0\x9d\x7f\xfe\xf9\
\xa5\xe5r\xdf}\xf7\x95\xf7\x01\xc7\xe3\x8f?^~\x94\
#\xee\xf3\xda\xd7\xbe\xb6t\xd3\x80\xc7\xbau\xebJ\xd0\
\xf2\xdd\xc5\xe5bE\xb1\x80\xc4\x87\x80#\x8b\x0cx\x88\
\x1b\xb1\x9cXk\xe8`5y^\xb9\x00\xeb\xdcs\xcf\
\x1d\xfe\xe8\xa3\x8fN\x9e7o\xde\xe4G\x1ey\xe4\xf4\
\xbb\xef\xbe\xfb\x8d/}\xe9K\xe7\x9dx\xe2\x897\x1f\
w\xdcq?\x9e2e\xca\x0au\x0d]\xcf\xff5d\
\x09\xfd\x0f\xbc\xf4i\x80\xa7\x11|\xb6l\xd9r\xcc\xe2\
\xc5\x8b_\xb2x\xf1\xe2\xd7n\xdf\xbe\xfd\xbc\xee\xee\xee\
i\xa3G\x8f\x1e>000l\xfd\xfa\xf5\xed\x94Y\
\xe0\x98\x22\xef\xdf\xbf\xbf8\xe7\x9cs\x8aW\xbd\xeaU\
\xa5;#\x96\xe3\x038\xfc\x0f\xa0\xaa\x96\x90)p\xef\
\xf9_\xfd,\x15\xf5\xbf\xfc\xe5//\x7fg\xcd\xdc{\
\xef\xbd%@\x01\x16\xff\xfb\x1d\x90)\xc7\xdf\xde1\x03\
\xb6x\xf1\xe2\xb2\x1c\xcf\xa9\x1f\x1d@\x09\x10\xdd~\xfb\
\xed\xa5\x1b\x07d\xb8j\xc0\x02\xb0\xb1\xa2\xde\xfd\xeew\
\x1f\xac\x9be\x05\xb0\x94\x03\xe0&L\x98PZ]h\
\x07\xa6\xdb\xb7o\x1f\xe8\xe8\xe8\xa8=\xfa\xe8\xa3\xc5C\
\x0f=T\x82\xedE\x17]\xf4LWW\xd7O\xa6M\
\x9bv\xd3\x05\x17\x5c\xf0\x83\xb6\xb6\xb6\x9d\x87\x11\xb0\x1f\
\xba~\x8dk\x08\x84\xfe\x17\x5c\x07\x0e\x1c\x18\xb1r\xe5\
\xca\xb3\x1e}\xf4\xd1W-\x5c\xb8\xf0\xfc\x95+W\x9e\
\xd2\xd5\xd55i\xfc\xf8\xf1\x9d\x94s\xe5\xca\x95\x03\xa6\
\xc8\xb9.b0f\xa8L\x9f\x9b\x12?\xf1\xc4\x13K\
k\xa2zQ\xee|(4\xd0\xe2bq\xaf|X?\
\x5c\x22\xd6\x12PbE\x89\xd1\x905.\x92X\xcd\xb9\
\xe7\x9e[\xfe\xcdjb\x15\x019@$\x96$X\xcd\
\x92a\xe1\xb0`\x5cbP\xa7\x9crJi\xc9\x00J\
\xc0\xe2Y\xc0\x04\x88\xc4\x97Xp\x5c7\xee\x96\xe7\x81\
\xa8\xfa\xd0\xa3.n\x9c\xe7\xb9e\x82\xe6\x00\xe9\xa5/\
}i1k\xd6\xac\xf2\x1ek\x8cu6k\xd6\xac\xbd\
?\xff\xf9\xcf\x97\x8f\x1e=\xfa\xfaw\xbe\xf3\x9dW\x8c\
\x1e=z\xe9\xd0\x1a\xa3\xe7\xef\x1a\x02\xa1\xff!W3\
\x97k\xc7\x8e\x1d\xc7>\xfe\xf8\xe3\xe7<\xf6\xd8c\x17\
\x01\x9f\xa5K\x97\xda\x935Z\xe0\xd6G\xdc\x06\x80\x00\
\x1f\xae\x8cx\xcf\x92%K\xcaw\xdf\xf1\x8ew\x94\xd6\
\x08\x10\xe1\xe2\x00\x19\x16\x90\x001\xe5v_\x9d\x5c\x1c\
@\xc2u\x036\x9e\x11\xdf\x11\xcfY\xbatii\xe5\
X\xf7\x03\xccX\x22\x14\x1dx\xf8n\xf6\x0a`\xe4\xaa\
\xb6\x81\xd2\x03\xb8\xbb\xee\xba\xab\x0cp+S\x0c\xca{\
h\x07Hoz\xd3\x9b\xca\xbf\x81\x17\xd0\xfb\xfb\xbf\xff\
\xfb\xd2\xa2\xf1\x1b\xebH\x9d\xbf\xfb\xbb\xbf[\xfe\x0e\xa0\
\x00\x15k\xcb}\xe0\xfb\xado}\xab\x04J v\xec\
\xb1\xc7\x95\xa0\xbav\xed\x9a\x12\x80\xc5\x9c\xee\xbc\xf3\xce\
\x1d\x1d\x1d\x1dw\x7f\xf0\x83\x1f\xfc\x87\x193f\xdcU\
T\xac\xccV\xb1\xb0\xa1\xeb\x97\xbf\x86@\xe8\x7f\xde5\
l\xf9\xf2\xe5/^\xb8p\xe1\xab\x17-Zt\xd1\xe2\
\xc5\x8b\xe7l\xda\xb4iB{{\xfb\xb0\xcc<\x01\x11\
JK\x99Y9\xc0\x80\xe5\xe0\xb7\x1f\xfd\xe8G\xe5\xca\
\xe4c\x8e9\xa6\x04\x15@%.\x03\x00|\xa7\xdc@\
\x07\xf8\xb0^\xc4d\xfc\xed7@A\xa9)x\xc0e\
\xf9\xf2\xe5%\xa0\xb1@\xbc\xeb7\xae\x12\x0b\x05`\xb9\
\x7f\xe6\x99g\x1e\x9cU\xcb\x05\x84L\xc5\xff\xf8\xc7?\
.\x81k\xf6\xec\xd9\xe5\xbd\x05\x0b\x16\x94k\x8eL\xe5\
{\x8f\xab\xa6]w\xdeyg\xe9z\x09\x5c\x03&\x96\
\x14+J<\x08\xc0\x0a\x90\x03\x19\xae\x17WN\xdb\xd1\
\xa0\xdd\xfeW\xd7\xb6m\xdbK\xda\xc6\x8e=\xa2x\xf3\
\x9b\xdf\x5c\xbe\xfb\xe3\x1f\xff\xb8\xbf\xb7\xb7w\xe1e\x97\
]\xf6\x95\xb3\xce:\xeb\xda\xa2(\xf6\x0c-v\xfc\xcd\
^C \xf4\xdf\xf0j\xa6\x04;w\xee\x9c\xb5x\xf1\
\xe2\x0b\x16,X\xf0J\xd6\xcf\xea\xd5\xabg\xed\xdb\xb7\
o4W\xc7\xa8\xee\xe3=\x16\x01E\xa3\x84\x80\x86\x9b\
D\x89\x81\xca3\xcf<S\xba`\xac\x05.\x91\xd1\x1e\
8P\xf6\xf7\xbe\xf7\xbd%\xd8\xb0\x80\xfc\xeeyVQ\
\x00e\xf3\xe6\xcd\xa55\x04\x00\x00\x96\xa9{\x16\xcf\xad\
\xb7\xdeZ\x82\x00\x85\xae^\x80\xd0;\xac%\xa0 \x9e\
\xc3bbq\xddv\xdbm%\xf8\x00)V\x0d\xa0\xd4\
\x0ek\x83\xc4~\xd4\xab~\xf5\xb1\xd2\x80\x0f7\xf0\x83\
\x1f\xfc`\xe9^i\x9b\xba\xb5\xe5\xa6\x9bn*-:\
\xd6\x0f0\x05f\x80P\xbd\xf7\xdf\x7f\x7fiM\xbd\xf8\
\xc5/.\x83\xe1\xea\xbc\xef\xbe\x9f\x14O?\xfd\xd4\xc1\
\x85\x93@\xcas;w\xee\x5c\xfd\x9e\xf7\xbc\xe7\xda7\
\xbe\xf1\x8d_koo\x7fz(N\xf4\x9b\xbb\x86@\
\xe8\xbf\xc15\xc8f\xd1\xe1\xabW\xaf~\xd1#\x8f<\
\xf2\xcaG\x1ey\xe4\xd5\xcb\x96-;e\xf3\xe6\xcd\xe3\
YC\xde\xe1fQ\x22V\x03K\x05\x00QX\xee\x06\
`\xb0\x18\x902\x0b\xf6RJ\xc0`\xc3\xa8w\xc4L\
\xc4I\xfc\x0d|\x00\x82X\x0e0\xf3\x9c\xdf\x04\x9aY\
7\xca\x07d\xac\x22u\x02\x09\x1f\xc0\xc0\x9d\x12\xa7Q\
\x0e\xeb\xcb} \x90\xe0\xb5gX'\x82\xccb3\xda\
fQ\xa3\xdf^\xf6\xb2\x97\x95@\xc3\x8d:\xf6\xd8c\
\xcbzb\xdd\x00\x13\x7f\xff\xecg?+\x03\xd5\x5c7\
\x80\xe59 \xc9\x22R\xa7K[\xfe\xfd\xdf\xff\xbd\x04\
U\x16\x11\xe0\xf2]=\xc0\x0fh\xba\xaf.\xee\xa82\
Y\x84\xf8\x02\x80\x015 \xdb\xbbw\xef\xee\xd7\xbd\xee\
u\xb7\xbf\xeb]\xef\xfa\xfb\x09\x13&\xdc[\x9d\x00(\
\x86\x00\xe9W\xbe\x86@\xe8\xbf\xc1\xd5\x18\x87\xd8\xb7o\
\xdf\xe4\x05\x0b\x16\xbc\xe2\x81\x07\x1ex\xfd\xe3\x8f?~\
\xde\xca\x95+\x8f\xde\xbe}\xfb\xe8a\xc3\x86\xd52\xad\
\x1ep\x00\x18\x14\xfe\xd5\xaf~u95\xcd\x9a\xe0*\
]r\xc9%\xe5\xfd,\xf0c\xb9\xb0\x8c\xfc\xcf\xda\xf0\
\x1e\x90\xb2-\xc2}\x80CA\x01\x0a \xe3\xda\x00\x1e\
\xcf\xb0<\xd4\x998Q>E}J\x1e\x1d,\x11\x00\
\x84\xae\xd0\x07\x00}\xb8}\x00\xf2{\xdf\xfb^\x09\x1e\
\xef|\xe7;\xcb2\xd5G\xf9\xd1$\x90\x8d^\xab\xa3\
\xcdb\x05`\xb8\x8e\xac\x1e4\xder\xcb-\xe5s\x5c\
<\xd6\x19\xab\x0a0*\x93E\xa7<`\x0b\xecX:\
\xc0\xc9w\xcf\x07\x80Yc\xca\xe3\xce]u\xd5U\xc5\
\xfc\xf9\xf3\xcb6k\x0f\x8b\xad\xab\xabk\xff\x8b^\xf4\
\xa2\x05\xef|\xe7;\xbfq\xfa\xe9\xa7\x7f\xb7(\x8a\xad\
C\xee\xd9\xafw\x0d\xad\x13z\x81_\xd5\xa9\xf6\x81\x81\
\x81q?\xfb\xd9\xcf.\xba\xed\xb6\xdb\xde\xfd\xc4\x13O\
\xbc|\xe7\xce\x9d\x13X=\x02\xab\xe2:\x94\x19@\xb0\
zX\x05\x14\x9c\x15a\xb3\xe8\xc5\x17_\x5c\x8e\xf4\xdc\
\x95\xeb\xaf\xbf\xbe\xf8\xc2\x17\xbePZ5\x17]tQ\
iqPz\xefS^n\x99)q\xbf\xb3l(7\
\xab\x80\xb5AA}\xa7\x98\xaf\x7f\xfd\xeb\x0f\xba>\xae\
L\xb3\xab7\x80\xa9<1\x1c\x96W\xb5-Y\x04\xe8\
y\xe0\x05\x94\xb8?\x00\xab\xa8/,\x04\x22\xac/\x96\
\x0f\xda\xd4\x0b\x88\x94_<\xe7\x82\x96\xc0\x008\xccj\
)\x0b\xa8\x9a\x05\xd3\xfe\xc4\xa8\x00/\xdaC\x9b\xd5\xda\
\xdc;|c\xe5(\x97E\xe6Y\xf5\xbe\xe1\x0do(\
\x83\xf4,\xc0\xef\x7f\xff\xfb\xe5\xbb\xf8\xaa\xbc\xdd\xbbw\
w<\xfc\xf0\xc3gm\xda\xb4i\xda\xc5\x17_<\xfb\
\xb5\xaf}\xed?uvv.{!\x00\xd1\x7fW0\
l\xff\xab\xbf\xfa\xab\x17\x00\x19CW\xb3\x8brFi\
\xb7n\xddz\xf2\x1dw\xdc\xf1\x91%K\x96|t\xe5\
\xca\x95\x17\x0c\x0c\x0c\x8c}\xdd\xeb^\xd7\xfe\x81\x0f|\
``\xf6\xec\xd95\x0a\xc6:\xe1\x8e\xbc\xf5\xado-\
\xad\x1d\x8a#\xe6!\x16B\xf9X\x15\xac\x0d3HY\
\xeb\xc3B\xa0\x88\x5c\x12\xf7(\xb1\xbf\xb9;\xca\x04\x0e\
\xac\x01\x0a\xca\xaa\x00b\xb6b\x00\x081\x1d\xae\x1b\x0b\
\x82\x8b\xc3\xa2\x10\x13\xf2\x1c\x0b\x09\x0d\x5c/\xf1%@\
\x91\x19\xb4,|DS\x16\x1f\xb2\xb4X,,\x22\xc1\
g\x96\x13\x17\x09-\xe8p)\xc7\x07()\xdb\x0c\x9c\
x\x8d\xf7\x00&\x8b\x090\x89\xed\xc45c\xfdi\x8b\
\xdf\x00\x9f\xe9}q,1 \xfc\x02X\x00\x12\x98\x02\
KV w\x0c_XU\xc0\x16\x9d\x80Z[\xebK\
\x10jf\x19\x97/_~\xda\xe6\xcd\x9b\x8f\x996m\
\xda\xe6\xd1\xa3G\xafz\x0e\x07~u \xc8\xbb\xf9\xff\
\xc0\x81\x03\xdd\xdb\xb7o?\xae\xaf\xafo\x9a\xfe\xde\xb3\
g\xcf\xb8}\xfb\xf6\x1dq\xe0\xc0\x811EQt\xb7\
\xb5\xb5\x0d\xd4j\xb5\xbe\xbc\xdf\xac\xde\xff\x0e\xb1\xab!\
w\xec\x05zU\x84y\xe4\xe3\x8f?\xfe\xfa[n\xb9\
\xe5\x83\x9b6m:o\xec\xd8\xb1\xe3N=\xf5\xd4\x8e\
\xe1\xc3\x87\x0f,_\xbe\xbcfD\xa7\xb8\x94_\xac\x87\
[B1\xc5N\xe2\x82\xb1\x86\xc4](\x17P\xe0\xee\
\x00\x0c\x7f\x03\x0f\x0a\x07\x18X4\xc0\x81\xf2)\x97\xeb\
b[\x04%g5\x98\xd2\xf6>+\x8a\xd2z\x9f\xdb\
B9Y1\xde\xa9^\xda\xa0n\xcf\xfd\xce\xef\xfcN\
Yg\xe3\xc5\xb2y\xf0\xc1\x07\xcb\x0fZ\xc4\x86\x00\x98\
\xe7\x95WUjuq\xa9\xd4\xa5\xbd\xac\x14e\xbf\xed\
mo+\x01\x0b\xa0q\xf9n\xbc\xf1\xc6\xd2\x02\xfb\xd0\
\x87>T\xd6\x19\x19\xe7ri#\xb01\x1bf\xe1\xa4\
w\x00\x14\xb7L\xbd,+e\x9a\xd5\x03<\x97^z\
i\x09\xd6\x00W\x00\x9b\xd5\x04\xc8\x95/\xc6\xd5\xd6\xd6\
\xd6'\xc1\xda\x9b\xde\xf4\xa6\xaf\x9d|\xf2\xc9\xd7\xb4\xb5\
\xb5m\xffMH\xd4\x9e={\x8e\xbf\xff\xfe\xfb\x7f\xef\
\x8e;\xeex\xc7\xce\x9d;\xbbg\xce\x9c\xb9\xf1\xa4\x93\
N\xda\xda\xd9\xd9\xb9{\xff\xfe\xfd\xfbj\xb5\xda>\xab\
0:;;7uwwo\x1b6l\xd8\x9e\xb6\xb6\
\xb6}\xc3\x87\x0f\xef\x193f\xcc\xfaq\xe3\xc6\xad\x1c\
1b\xc4&\xf4\xbd\xd0\xad\xa3!K\xe8\x05vUG\
\xae\xde\xde\xde\xe9\xb7\xdf~\xfb\x1f\xff\xcb\xbf\xfc\xcb\x9f\
\xadY\xb3\xe6\xacSN9e\xd4\x19g\x9c\xd1\xe6\x99\
\xf9\xf3\xe7\xd7(\x0a\x901M\xfd\x8aW\xbc\xa2\xb44\
\xcc,Q\x14\x8a\xca\xb2\x09 Y\x98'\x96r\xd9e\
\x97\x95\xa3\xbfg\xb9]\xde\xb7\xa2\x19\xe0\x88\xff\x18\xf9\
Y!\xac&Jj\xc52\xd7\x0c\x08\xb1@\x02d\xca\
\xa0\xb8\xde\xe7\xde\xb0 \x00\x18p\xc8v\x07m\xe0\x1a\
*\x1b\xc0\x88!5\x8e\xcch0\x83\xa6Ln#\xb7\
\x92e\x94\xb2\xaa\x0a\x04l\xadkB\x1f\xcb\x895\xc3\
e\xb2\xfa9\xcf\xaa\x1b(zV\xdbYi\xda\x9a\xc5\
\x86\xc0\x16\xd8\x88\x09\xb1p\xde\xf8\xc67\x96eh\x03\
 \x048\xacB\xcf\x02<\xbc\x03\xb8\x00\xcc3\xde\x07\
\xd2\xea\xc0\xd3\xcd\x9b7\xb7\xf7\xf7\xf7O^\xbf~\xfd\
Y\xfb\xf7\xef\x1f3i\xd2\xa4\x15\xc3\x86\x0d\xdb\xf2\xcb\
XD\x0d\x01\xee\x91\xcb\x97/\x7f\xe3]w\xdd\xf5\xa7\
]]]\xef\x1c=z\xf4\xb1R\xe0n\xde\xbcy\xfa\
\x86\x0d\x1bf\xcd\x9c9\xf3\x98\xa3\x8e:j\xce\xc4\x89\
\x13O;\xf2\xc8#O\xeb\xea\xea:y\xe3\xc6\x8d\xe7\
-Z\xb4\xe8u===\xaf\x18>|\xf8\xb9\xcb\x97\
/\x7f\xd9\xfc\xf9\xf3\xdf\xb0h\xd1\xa2\x8bm\xcb\xe9\xed\
\xed=\xa6\xa3\xa3c$\xcb\xc9U\xb7\xa0\xfa\x07\xa1\xe1\
\xb7z\x0d\x81\xd0\x0b\xec\xaa\xbb_\xedk\xd6\xacy\xe9\
w\xbe\xf3\x9d/\x5c\x7f\xfd\xf5\x1f\x1a6l\xd8\xa4\xb3\
\xcf>\xbb\x8d\xd2pA\x8c\xe4\xdc\x0f3;o\x7f\xfb\
\xdbK\xa5\x11\x00\xbe\xee\xba\xebJ\x00\x8a\xdb\xc0\xf5\xe0\
6\x19\xfd\x81\x94X\x07\xcb \x81a\xe0\xe07n\x0b\
\xe5\x064\xea7\xdb\x14K\x8a\x1b\x95\xed\x15\x14\x1d\xe8\
\xd8VAq}\xe7\x16\x99B\x07\x1a\xeeS~\xee\x18\
%\xf7\x0e\xcb\x84\xd5 \xd6\xc3\xb5*\xeam\xa4\xec\x82\
\xcc\xac\x0a\xc0gQ\xa1\xdfY?\xd9\xac\x0a\xe4\x12[\
\xcajk\xef\xb2\x5c\xb8l\xcaP?\xeb\xcf\xffu\x17\
\xa6\x04\x17\x80k\xf6\x8b+\x09H\xd1\x1b\xd7\xd63\xf8\
\x847\xdcK\x96\x9eM\xb3\x5c9\xf1#`i\x9d\xd0\
\x05\x17\x5cP\xb6\x05/\x01\x90\xfa\xf1\x80E\x84\xb6\xa4\
\x12Y\xb6lY\xad\xb7\xb7\x97{v\xd6\x86\x0d\x1bN\
\x98>}z\xdc\xb3\x03\x87+]\xda\xb9w\xef\xdei\
\x0f?\xfc\xf0\x87\xee\xb9\xe7\x9eO\x9ex\xe2\x89\xe7\xbd\
\xfc\xe5/\x1fs\xf4\xd1G\xcb\x89$v\xc7k\xe9\xd8\
\xb4i\xd3\xf0\xae\xae\xaea\xb6\xce\x0d\x1f>|\xd8\xba\
u\xeb\xba\x9ey\xe6\x99\xd1'\x9cp\xc2\x88s\xce9\
g\xf4\xf4\xe9\xd3'\x8c\x1f?~\xf2\xc8\x91#\xe5\xeb\
>u\xf5\xea\xd5\xa7\xdfq\xc7\x1d\xaf\xb8\xf5\xd6[/\
]\xb0`\xc1\xbb\x16-Z\xf4\xc6g\x9ey\xe6\xec\xbd\
{\xf7\x1e\xbd\x7f\xff\xfeQ\x03\x03\x03#\xe0Rgg\
'\x8b\xa9\xff\xbf\x02\x88\x86@\xe8\x05v\xed\xdb\xb7o\
\xfc\xbcy\xf3\xde?w\xee\xdc\xbf|\xf0\xc1\x07_\xd5\
\xd9\xd9\xd9E\xd9\x09\xa9\x11\x99\xd5\x22\xe6Cq\x04J\
\x01\x8e\x11\xfb\x9f\xfe\xe9\x9f\xca\x91\xd9(\x1de\x17?\
a\x05\x08\xee\x02\x0a\xca\x19\x8b@y\xd9\x1dO\x99\xc5\
\x9f\x94U\x0f\xbe\x96\x8a\xe8\x19\xef\x08N'\x90\x0c\xc4\
<o\x87\xbc\xef\x00\x04H\xb1t\xd4\xe1}\xd6\x92g\
\x94A\xf9\xd1A\xb8)\xaez\x12\xcb\xa1\xf0~\x17\xb7\
RV@\x82U\x94Y5mv\x013\xef\x01)\xf4\
Y\x03\xa4|\xcf\xb0\xd0\x80^Q\x07+m\xa4\xb8@\
\x82\xdb\xc5b\x12#\x02\x94\x19\xf1\xd1\x04\x84\x00\xb0\xfb\
@\x99\xb5\x93`50e\xed\xb1\x02\x01\x14\x97\x95\xa5\
$\x9e\xc6\x92\xc2\x7f\xf5\xb3\xdc\x80\x97:d\x1cX\xba\
t\xe9\x09\xcf<\xf3\xcc\x8b\xc7\x8e\x1d\xbb\x97U\xd4\xd6\
\xd6\xb6\xa7Q\xc2\x1ac?\x06\x9d\x1d;v\x9c{\xe7\
\x9dw~\xea\xe9\xa7\x9f\xbe\xec\x0dox\xc3\xf1\xa7\x9d\
v\xda\xf0\xf6\xf6\xf6v\x83\x04k\x11(k\x83\xef\x5c\
k\xf5\xdd~\xfb\xed\xb5%K\x96t\xee\xdf\xbf\xbfs\
\xeb\xd6\xad\x1d?\xf9\xc9O:\xe6\xcd\x9b\xd7\xb9|\xf9\
\xf2\xaeM\x9b6u\xf6\xf6\xf6\x96\xa9u\xdb\xda\xdaF\
\xf6\xf4\xf4\x8cZ\xb5j\xd5\x041\xac\xc7\x1e{\xec\xac\
\xa5K\x97\xbea\xcd\x9a5o}\xe0\x81\x07\xde0\x7f\
\xfe\xfcW\xec\xdd\xbbw\xe2\xe4\xc9\x937\x0c\x1b6\xec\
7\xe2N\xfe2\xd7\x10\x08\xfd\x17^\xd5Qg``\
`\xf8\x96-[\xce\xf9\xf7\x7f\xff\xf7\xcf\xce\x9d;\xf7\
\xff\xacZ\xb5\xea\x98\xb6\xb6\xb62-\xaa\xc0\xaa\xd9\x1f\
\xd6\x8c\x91\x99\x92q\xb5\x08\x22k\xc6.t\x0a\xf1\xfe\
\xf7\xbf\xbfT\x0e\x0a,\x90\xec\xbd\xd7\xbc\xe65\xa5\xd2\
4\x08\xfdAk\x842Sz \x00\x14\x80\x0d\x90#\
\xf0\xac\x05uPVJN\x11\xbdGQ\xb9_\x82\xd8\
\xac\x12\x00\xe4>@\xc9\xba$\x8a\x02\x1c\x95\xa7|\x0a\
\x0e\xb0\xbc\xc7\xaa\xf0\x1eeO\xe0\xd8s\xa1O9\xe8\
\xf7=\xb9\x88\x94A\x01\xddc\x91\xb0\xdc\x80\x1a\x90E\
{u\xc5u\xac'\xf7XI\xf8\x03T\xb8m\x01\xe2\
\x80-z\xe3>\x8aG\x09Vs\xd1\xfc\xee=\x17Z\
\xd1\x09\x00M\xeb\xe3\x93:\x81\x9f{,-\xa0\x87\xe6\
\x1d;v\xd4\xb6m\xdb6q\xfd\xfa\xf5\xe7\xf5\xf7\xf7\
\x1f9q\xe2\xc45]]]\x9b\x06\x1a\x82\xaf\x95}\
h\xdd\xcb\x97/\x7f\xcb\xd5W_\xfd\xc5\xb5k\xd7\xbe\
\xe1\xd5\xaf~\xf5\x11G\x1cqDm\xd1\xa2Em\xc0\
\x1cX\x9b\xb1c\xd1=\xb7\x9a{li\x05\xa3\x8f\xa5\
\x8bw\x80\x92\x85\xe6\x02\xa8\xfac\xca\x94)5\x9fS\
N9\xa5v\xfe\xf9\xe7\x0f\xe05\xcb\xf9-oy\xcb\
\xc0\xa9\xa7\x9e\xda>u\xea\xd4\xda\xe4\xc9\x93;\xfa\xfa\
\xfa&n\xd9\xb2\xe5\xa4\xdbn\xbb\xed\x15\xbd\xbd\xbdc\
\xe6\xcc\x99\xf3XGG\xc7\xf6\x0cV\xbf\x8dk\x08\x84\
\xfe\x0b\xaf\x1a\xfb\xb7\xbf\x7f\xf4\xc6\x8d\x1b_|\xff\xfd\
\xf7\x7f\xe8\xdb\xdf\xfe\xf6g\xef\xb9\xe7\x9e7\x8c\x1d;\
v\xe4\xa9\xa7\x9eZ\xa3\x80\x94\xc4\xa7\xa8o\x81 |\
\x94\xd8b:\x0a\x0dp(\x17\xd7\x89\x9b\xc6\xbdam\
P$\x96I5\x1dE\xe3\x06L\x16\x0c\xb7F\x19\xde\
\xa1T\x80\x8e\xf5AY)9%\xa3\xfc\x14\xdf3\xdc\
\x1e\x8a\x0f\x94XQ~\xa3_\x944\xe5s\x0f\xd1\x14\
\x0b\x01P\xfap\xf1\x00\x84\xd9:J\xa3-Y\x84X\
T\xe2D\x14\x89\xa5\x02\x14\xf0\x80\x82\xab\x1b\x90\xb0\xf6\
(\x9f\xb6\x01^\xe0\x06\x10\x00W\xd1$Q\x1b\xfa\xd1\
f[\x07\xfe\x00W\xcfPhejc\xd6.\xb16\
\xb4S\xd9>\xf8\x03\x88\xd0\x12\xb0T\xa7~\xf0\xbe\x0b\
 \xb3\x14\x95\xabMu\x80\xac\xcd\x9a5kToo\
\xefY\xcb\x96-;n\xcc\x981\x1b\xc7\x8e\x1d\xbb\xa6\
\xad\xad\xad\xcc\xa7\x0d'\xf7\xef\xdf?q\xeb\xd6\xad\xa7\
>\xf6\xd8c\xef\xff\xc67\xbe\xf1\xa9\x05\x0b\x16\xbc\xf8\
\xa4\x93N\x1a\x86\xa7\xdf\xff\xfe\xf7\xdb\xc4\xc9\x92I \
\xedD\x93@y,3\xf4\x03\xa0\xac\x0dC\x9fg\xf0\
T\x1fj\x97\x8f\x09\x8c\xd5\xabW\xd7\xce>\xfb\xec\xda\
\x9c9sj\xfaG\xbfo\xde\xbc\xb9\xe3]\xefzW\
\x09Hk\xd6\xac\xe9\x5c\xbdz\xf5\xb1#G\x8e\xec\x99\
1c\xc6\x22\xf9\xb8\x87@\xe8\x7f\xd8\xd5`\xf5\xb4\xf5\
\xf7\xf7\x8fY\xb5j\xd5K\xef\xb9\xe7\x9e\x8f_s\xcd\
5\x9f\xba\xed\xb6\xdb\xde\xbe\x7f\xff\xfe\xa9\x17]tQ\
\x9b\xbdV,\x18\xd6\x0fef\xc9\xf8\x10x\xd6\x0b\x85\
\x124\x06N\xe2<\x80\xe1\x86\x1bn(\xe3\x13\x89\x91\
\x10Z\x8abV\x87`\x1b\xf5\xd1@(c\x15\xb1t\
$\x17\xf3\xb75?f\x98(<\xc1/\xea\x0a\xad\xbc\
l\xf9\xc8\x1a\x22\x0a`T\xa5\xa4\x00\x84@\x17u\x8b\
\x812$.C\xc1\x8d\xca\xe8\x10\xff\x09X\xb1b\xd4\
K\xb9)\x04W\xcb;\x99\x8a/\xea\x00\x094\x80H\
2-r\x85\xb8dx\xc1\x0db\xb5x\xcf(\x0f\xb8\
\xaaWu\xc1\xa4\xe7\xd1\xf1\x83\x1f\xfc\xa0\xb4 \xf1\x14\
\xc0\xe1QVi\x17\xf5\xcc\x8f\x00\x19\x98\xa8S\x1b}\
Xu\xe2K\xca\x10\x0fJZ\x13\xcf\x9a\xfd\xd3\x06t\
*K\xd0\x5cV\x82\xa5K\x97\x1aD\xdaw\xef\xde}\
\xc2\x83\x0f>xfww\xf7\xb8\xe1\xc3\x87\x1f\xb1b\
\xc5\x8a3\x16,X\xf0\x96\xdbn\xbb\xed\x837\xddt\
\xd3\xc7o\xbc\xf1\xc6\xb7-_\xbe|\xa2\x99M\xef\xaf\
Y\xb3\xa6\xa6L\xfd\x04\xd8\xd0\xaaN\xf4\xaa_\x8c\xae\
\xa8'\x86\xd3\xdf\xfe\xf6\x0c^x\x06\xcfX\x8dI\x8d\
k\xdb\xca\xbf\xfd\xdb\xbf\x952\x01\xcc\xb8\x94bw{\
\xf6\xec)\xb3&x\x16\xb0O\x9b6m\xe0\xec\xb3\xcf\
\xeez\xea\xa9\xa7\x8e\xec\xee\xee^5a\xc2\x84\xa5\xb5\
Z\xed\xb0cZ\xbf\xce5\x04B\xbf\xa5\xab\x1e\x10m\
\x17\xf3y\xf2\xc9'_y\xf3\xcd7\x7f\xe2\xe6\x9bo\
\xfe\xe3[o\xbd\xf5wv\xed\xda5\xe9-oyK\
\xed}\xef{_i%P\xaa\xac\xa9\xa1\xf0\x84\x85P\
\x02\x01\xb3_\xa6\xaa\xe5\xcd\x11\xff\x01\x00\x14\x9eK`\
\x15\xb4@\xabw(6%\xccB;\x0aC\xd8\x80\x08\
K\xc2T\xb4\x004\x97\x09\xd8\x09\xc2F\x91+\x8b#\
\x0f\xce8\x01@J\xc0Z\xa0$\x84^\x19,\x15#\
0P\xf1>\xda=\x9fw)l6\xbd\xbe\xeb]\xef\
*\x15!\x96\x11\x00C\x9f\x11?3Q\xf5\x19\xa7\xf2\
\xbez\x94\xc3B\xd3\x1e\xed\xd6V#\xbd{\xc0\x0dX\
\x01\x8a,`\xccUu;\x95\x81~\xf5\xdd|\xf3\xcd\
\x07\xe9\xc9\xbb\x01!\x0aI\x89\xd1\x0cX\x5c\xde\xa1\xe4\
x\xc6%\xd2\x17bE\xc9\xb7\xc4\x05\xa3\xd4\xda\xae\x0e\
\x9fs\xcf=\xb7\x86\xe7\xe2Q,\x92\x1d;vL~\
\xf0\xc1\x07\xcf\x9f?\x7f\xfe\xeb\x1fz\xe8\xa1K~\xf8\
\xc3\x1f\xbeq\xc9\x92%\xa7L\x992e\xc2i\xa7\x9d\
\xd6fa$P\xe1v\x19\x18b\xe9\x19`\xf4\xa5{\
\xac@\xf4e\xa2\xc0\xf3\x80=A\xf8\xec\xd7C/0\
\xe2*\xe3\xb1\xc1\x07\xa0Z\x94*\xbe\x84\xc7\x06\x02\x03\
\x8ev\xa3]{\xb7l\xd9R;\xe9\xa4\x93\x06\xa6O\
\x9f>z\xe5\xca\x95}\xd3\xa6M\x9b\xe7\x90\x80\xdf\x86\
v\x0c\xad\x98~\x9e\xae\x8a\xe5S\xdb\xbf\x7f\x7f\xc7\xde\
\xbd{\xc7/[\xb6\xec\xa5\xf7\xdf\x7f\xff\xdb\x1ex\xe0\
\x81W\xad^\xbdz\x06e0b\xd9\x1cJ\xe0\x1a3\
\xf9\x11t.\x0d%\x05@>\x14\xd1\xa8F\x11\xc5s\
\x80\x02@2\x8a\xe6\xca\x86\xd5\xa2\x92\x12\xc3(\x9fT\
\x1c\xfe&\xa4FR\xa0\xe1o\xf5\x10\xf8f{\xa1b\
U\x10pkg\xb2i\x95\x02\x025\xebq\xcc&\x19\
u]\x5c\x84\xb4E}\xca\xe62\xa19\x7fS\x1a\xca\
G\x91)\x1de\xa1X\xac$J\xe7>\x0b\x8e\xd5\xc7\
\xfaI09\x8a\x06\xcc\x02r\x01\xa0\x06k\xf3 ?\
\xf2\x1d@k\xab\x15\xe0,\x17\x16\xa7\xe7\xb3\xddD\xfb\
\xeb\x0aypM\x11\xfe\xb1\xee\x00>\xba\xbe\xfc\xe5/\
\x97K\x09\x0c\x10\xf8\xe0\x19|\x90n\x84\xebiI@\
\xb6\x9e(\x03\xd0kwWW\xd7\xf0\x05\x0b\x16L\xcc\
\xd1G\x06\x0c\xe5\xec\xdd\xbbw\xe0\x96[n\xa9\xe9\xc7\
j\x0a]V\xae\xe7\x80\x9a~\xca\x22K\xab\xdd\xedg\
\xf3\xb7g\x0cV\x803\xc9\xdd\x12\xc8\xc7\x1fe\xb1\xe0\
\x80\x925U\xfa\xdar\x0e\x83F\xd6G)[\xfb}\
\x96.]\xdav\xd2I'\x8d\xde\xb2e\xcb\x8bw\xef\
\xde}\xec\xe8\xd1\xa3\x1d\x06\xf0\xbc/$\x1c\x02\xa1\xe7\
\xe1\x8a2\xf4\xf7\xf7\x9bR\x9d\xb9t\xe9\xd2W\xacX\
\xb1\xe2\xb5\x8b\x16-\xba`\xf1\xe2\xc53\x086e4\
\xa2U\x01\xa8\x9a\xd3\x98\xb2\x88\xfd\xb0\x10\x02$\x14\x84\
\xf0g\xd3)\x81\x07H\xc9\xa1\x1c7\xaa\x9a\xeb\xc6w\
\xefe\xf6\xc8E\xa9\xb9\x1c\x94\x80\x10R\x14\x01P\x7f\
W\x8f\xdbi\x06F\x99\x22\x07*>\x163\xda\x1cj\
q\xa1v\xb0\x88\xb4\x85\x22e?\x19\xab\xa9\xba\xea\x99\
2\xb1\xdc\x92\xeeC\xb0\xbdz\x01\xcb,ZT\xb6\x15\
\xd0@\x96{\x22\x1e\x03\xa8\xb2\xcd\xc2\xbb\x94\xbd\xeaf\
6\xc6\xbe\x12\xf4\xf6\x1c\x10\xa5\xf0@\x83\xeb\x94\xd39\
\xfc\xe6\x03T\xf1:q#t\xe0\x11\x9a\xb2-\xc5z\
*\xbfs\xa1\x00\x17`\xf1\x9d\xb5r\xf5\xd5W\x97<\
\xcc^9\xf1\x1b\x96]\x02\xf3\x00.\xae\x1b\xe0\xbd\xf1\
\xc6\x1bk\xac?\xc0\xc5\x9a\xb2z\x9bk\xec9\x00B\
\x06X}, }\xad\xef<\xcf\xcaQ\x9er\xc9\x88\
2\xd1\x0bl\xd0\xc8\xba\x05\xeax\xc8\xea\xf3|\x82\xe7\
bq\x09\xf8\x876\xbc\xd5W,\xeb]\xbbv\x8d\xd9\
\xb1c\xc7\xd1\x93&M\x9aW\xab\xd5\xfe\xc3i\xb6\xcf\
\xc75\xe4\x8e=\x0fW}}\xcc\x88\x85\x0b\x172\xbf\
\xff\xb8\xbf\xbf\xff\xbd[\xb6l\xb9\xe0\xd1G\x1f\x1dc\
\xe4$\x18\x04\xc2h%\x80\x9c\xf59\x84\x9c\xe0\x12z\
\x16\x00aa:\x13V\x00\xe3\x7f\x82B\xd9\x8dh\x84\
3\xf9{\x00\xc3\xe1d\xfe\xa3T\x02\xdaFgq\x15\
JL\xa8)w}\x05\xf0\x7f\xb0.\xaa@T-\x9b\
\xd2\x032\x0a\x98\xf5AFfJ\xedo\xf7\x81\x94\xf6\
fj=\x0b\x1b\xd5\xc1\xa5Iy\xb1\xce\x8c\xe8\x14\x8f\
E\xc1\xd2\x8a\xc2q\x87>\xf9\xc9O\x96\xaej\xa6\xab\
\xab\x0a\x05 \xf0\xa7\x0aD\x14\x0b_(Y\x80\x84\xbb\
#\xaeD\xc1\xf5\x01@\xd4\xeel/Q.\xb7U\x99\
\xca\xcb><\xed\x04\xf8\x14\xdb\x96\x15\xaeM\xb6\x9fP\
pt\x8b\xdb\x00\x0f\xd6\x06\xfa\xb9n\x00\x0a\xd8*C\
;\xd0\x97\xcc\x90\x5c)\xbc\xa0\xfc\xc9\xb5\xado\xf5\x0b\
W,\xeb\xaa\xe22yV\xbd\xe8f\xe5f\x15\xb76\
\x19\x08\xd0\xa0\x9dh\xe5j\x01\x19}\xa2,\xb4\xfbM\
=\xac }\xab_\xf0:\xa9T\xc8 \xbe\xed\xdc\xb9\
\xf3\xc0\xb4i\xd3v\x0e\x1f>\xfc\xf1I\x93&=\xdc\
\xd6\xd6\xf6\xbc\x83\xd0\x90%\xf4\x1b\xbc2\x0a\xef\xdb\xb7\
o\xe4}\xf7\xdd\xf7\xee\xc5\x8b\x17\x7f\xe2\xc2\x0b/<\
\xa5\xa7\xa7g\x98\xa0\xa8\xce\xe6\xbf\x1b\xf1\x08\x94\xe7\x09\
\xa3\xb8\x04\xa1\xa3\x04\x94\x84\xc0\x11^\xc2F\xc0\xb2\x9e\
\xc7\xdf\x9f\xfe\xf4\xa7K\xc0)\xeaiV)}\x8e\xc1\
)Zlb\x8cKA\xd9\x8dtFj\x8a\xed\xa2D\
\x84\x9d\x10\x1a\x8d\xb9{b1\x04\x99@7\x06|\x1b\
/\xa3sf\x9c(EQ\x9f1\xfa\xd7\x7f\xfd\xd7\x83\
1\x22\x0a\xa3\x8d,\x18\x8a\xefy A9)$`\
\xa10\xf8\x03\xb8\x80\x02\x97\x0d\x18\xda\x92\x01\xc0\xb4\x99\
\xc5G\x89\x12\xa8\x8e\xeb\xa3\xcc\xb9s\xe7\x96J\x8e\xee\
\xa4\x1e\xf1\x0c\x1e)\x0b\xa0x\x8erf\x1f\x98\xb6\xb2\
\x02\x81cf\xfb\xbccpH\xfb\xf1\x0cp$!\x9b\
\xb6h\x97v\x0b\xf8&n\xa5l.\x1b\x05\xd7\xce\xac\
u\xf2\x9br\x80\x87\xfeU\x96gX-hB\x8f\xfb\
\x9e\xf1\xc9l\xa3K\xdfj\xb7\xfe\x02\x16\xb12\xb5)\
\xfd\x09\xa8s\x1a\xad6\xb1\xc8\x12k\xc3\x87dRP\
\x96\xe7\xb9\xc1x\x8c?hT\xb6t+\x00I\x7fL\
\x992e\xe0\xa8\xa3\x8e\x9a\xd8\xd3\xd3sl\x7f\x7f\x7f\
WGG\xc7\xde\xe7[o\x86,\xa1\xdf\xe0U\x07\xa0\
\x11\xf7\xde{\xef\xfb\x1ez\xe8\xa1?{\xc9K^r\
\xca\x8e\x1d;\xda\xbf\xf6\xb5\xaf\x95\xc2\xf5\xb2\xf3_V\
\x0a\x00\xe5\xb1\x80\x90\xc9.6C\xa0\x08\x05!#(\
\x16\xefQ8{\xb5\xc4\x83\x98\xd5Ll[.\xaa\xc9\
\xc1\xd4\x17\x05\xa3\x14\xd5\xed\x12\xb9*\x9b!\x0fN\xc7\
[\xf0\x98}^\xea6JS\x1c.\x14\xf0\x03&\x9e\
%\x94\x844\x89\xe8\x9b]q\x1f\x8d\xb4\x14\x97e\x95\
\xad\x1aY\xd8\xa7l\xcaD\xc9\xd5\x8f\x07\x00\xc0:\x18\
3Ohc\x95\x89ud\x11\xa5\xe7\xc5\x99\xd0C\xd1\
\x8a\xba\x9bF\xa1(\x9a\x00+7\x04\x9fB\x1fp\x02\
&@\x5c\xb9\xda\x88\x9f\x14T\x9dbU\x06\x01<\xab\
OQ\x97<\xa3\x80\xc0\x12\x0d\x00\xc2}\xe5\xd4\xe3$\
%@\xa2)3\x8c\xda\x81g\xe8\xc9\xcce\x82\xff\xe8\
\xf2?\xcbH}Y4\xe9]m\x02B\xd9\xa3\xe7\xd2\
\xbf\x00\x0c\x98\x02\x0euy\xceweY\x97\xc4\xf5f\
\xd1(\x03\xe8\xe15\xdaXw\xea\xfe\xecg?[\xc6\
\xa0\x80\x19\xbe*\xdbw\xf4\x91\x0b\x96]\xf1\xdc~\xb4\
\x12\x84\x80S\x0e\x0a\xf0\xac\xf6\x93/\xf7\xb6o\xdf\xde\
v\xe0\xc0\x81\xceZ\xad\xb6\xfd\x84\x13N\xb8\xab\xb3\xb3\
\xf3yOU2\x04B\xbf\xc1k\xdf\xbe}\xa3\x00\xd0\
O\x7f\xfa\xd3?;\xfd\xf4\xd3\x8f\x7f\xf6\xd9g\x07\xbe\
\xfa\xd5\xaf\xd6\x8c\x5co\x7f\xc7\xdbK\x0b\xc1(kM\
OF(n\x87\x0d\x97\xbe\x9b\xa12J\x13\xcc\xbf\xfb\
\xbb\xbf+\xad\x04q\x1a\xcfxyB\x87\x00\x00 \x00\
IDATr\x03\x80V\xaeX7\xca\xa6\x10\xc9\xbd\
\x5c4\xd91\xedo\xc2M\xd8\x00M#\x90\xa9\x87[\
\xc2ZQ\x0e\x8bKP\x94\x12PB\x02\x9fxT\xd1\
dg6\xfa(>\x9a\xd0(\xdeA\xa9)\x02W\x02\
\x08\x11v\x81t\x82\xef\xbe2\x81\x16\x17\x86e\x04h\
\x01\x03\x80\xe06Pb\xef\xa8\xc3o\xc9M\xad\x8dY\
U\x0d`\xd0\x8d\xaf\xca\x117A'\x9e\xa8\x0b\xc8\xe1\
/`q\x0fhQ\x5c|\xd3\x0f\xda\x9a\xe9}\xe5$\
X\xab\xbe\xac\x86f%\xa1\xcf\xc0\x11k\x95\x15\xe3\xbe\
\xfa\xb2y\x97\x02\xeb7\xbc\xf1<>\x00\x00\xa0\x01H\
\x94\x87\xb6\xb8T\xee'\x96\x05,\xfc\x8d\xd7\xca\x8f\xd5\
\x85~ \xfb\xfb\xbf\xff\xfb%\xaf\x804@\x15\xf7\xd1\
g\xea\xfd\x83?\xf8\x83\x83k\xb4XU\xda\xa2\x9d\xda\
\xefo\x00\xa8\x1fC{b\x83f\xee\xb4C\xdd@\x15\
0\xe1\xcd\x89'\x9e8`\x91\xe3\x86\x0d\x1bv\x9dr\
\xca)\xb7\x8e\x181b]3\x99\xfaM^C\xee\xd8\
\xafye\x94\xe8\xeb\xeb\x1b\xfd\x93\x9f\xfc\xe4\xb2;\xef\
\xbc\xf3s\xb3f\xcd:\xfa\x99g\x9e9p\xc3\x0d7\
\xb4\x19\x8dM\xbd\x97g\xb0\xef\xec)A\x85\xf0\x1b\xdd\
\x8cZ\xc9\xc7Lp)\xafE\x88\xf6\x80\x11\x1e+\xa0\
)\x11@\x88\xfb\x94\xfab\x99d\xa1Z\x16\xf65\x03\
 \xb9\x93\x01P\x84\xb2hp\xdb\xd0CQ\x8d\xe6Y\
7\xc3r\xb0r\xda{\x94\xcbhj4F\x8bg\xab\
@d\x14E\x1f\x101\xa2S2\x16\x0c+\xea\xeb_\
\xffz\x19#1\x0a\x03\x10 KA\x95\xaf\xed\x01G\
\x8aO\xe9\xf1\x01\xd8Q\xd0,\x0fP/E\xa24\x00\
\x14O\x80\x02\x8b\xe8\xbb\xdf\xfdn\xa9\x94\x14\x0f\x8f\xd5\
\xc5\xb2\x00:\x00\xc5\xf3F\x7f\x16H\x16@\xa2\xcbo\
\xc0\x16\x08\x19\x14\xc4\xc9\x00\x01\xda\xd5\xa7\xee\x04\xe93\
\x03\x86\x86\x9c\xda\x91\xf8\x16P\xd06\x8aL\xa1\xd1\x8b\
\xfe\xac\xab\x0a\x80s\xbb3\xdd\xcf\xa2\xd1\x0f\xe8\xf1\x1e\
\xf0&'\xe8D\x7f\xb6hh\x1f\xa0\xcb\x01\x91\xaci\
\xff\xe3\x1d03+\x0a<\xb2U\xc5s\x80/\xfb\xef\
\xf0\x0b\xcd\x06\x81X\x85\x99\xd6W\x96\xb5h\xfa\xde\xfb\
\x16G\xea\x0b\xef\xd7\xf3;mokk\xdbU<\xcf\
\x00T\x0c\x81\xd0\xaf\x7f\xd5\x01h\xcc}\xf7\xddw\xd9\
\x0d7\xdc\xf0\xb9\x11#F\x1cE`\xe7\xcd\x9bW#\
\xe4\x1f\xfe\xf0\x87\xcbN6\xd2Z\x8dLh\xb2\xb3\x9d\
\xc0\x9b\xaa5\xc2Y|\x98T\x15\xd6\xd3\xb0|\xa2P\
\xf5\xe3\x8c\x9b\xc6{\x80\x10\x01#\xb8\xcd.\x82\xb7p\
\xe1s\x8b\x09YAE\x93\xb8\x11\xe5P\x8e\xd1\x95\xc2\
E\xb0=\x03L\x8c\xf6FV\x8a\x9aU\xdc\x09\xa6\xe7\
\x02>\xc9\x5c\x08\xa8|O\xdaV\x0aCq\x12\xfb\xf2\
\x8c\xf6R\x04|\x01b\x82\xce\xc0\xd4b\xba\x00[N\
\xf2\xc89b\xac*e\xa3\x89\xf2S\x1a`E\xe9\xd1\
\x97d\xfd9\x9e\x1a\xe8U\xb7s\x00\x0eu\xe6H!\
nW\xf6\xb7Q`\xca*\x96\xa5\x0e\xfc\x88\x0b\x09\x9c\
Xh\xea\xf5\xc9\xa5\x1c\x01h\xef%\x9e\xa5,@\xa1\
n\xe5\xe0\x97\xb2\x93\x0f\xdb:/`ey\x00~\x00\
PmN\x16H\xcf\xb9\x87/\xe2a\x09\xa8\x9b\xa80\
pq\xf1\xbe\xf4\xa5/\x95\x00\xce\x9a\x01R\xda\xac\x8e\
\xa4\xcc5\x98\xc4\xc2\x03.\xe8\x01\x9c\xc9\xce\x89\x0f\xc0\
\xd9`\x00\xac\xb3\xda\xbc\x0e\xfe6\xca\xf6\xce\x9e=\xfb\
\xe1\x91#G\xaek&/\xbf\xe9k\x08\x84~\xc5\xab\
j\x01\xdd{\xef\xbd\x1f\xbc\xe6\x9ak\xfel\xcb\x96-\
\xd3(\xcf\xd6\xad[\x07^\xfc\xe2\x17\xd7\x98\xca:\xd9\
^#S\xb5\x00\x81PPtAL\xa3!e\xa2\x0c\
\x14\xdc\xbb\x00\x88\xb5@I~|\xcf\x8f\x8b\x0b_y\
\xe1\xc1}A\xcd\x04\x81\x00\xe5(\x9dd(,*.\
\x130\xa0\xc0,0#ru5t.\xf7\x09? \
\x0b\x08\x15\x95)\x7f\xbf\xa1\x895d$\x15\xc72\x8b\
\x03d3\xcdN\xb8\xd1!\x00\x1f\xc5\xce\xea\xed\xb8I\
\xfeO\x92yk\x8a\x80\xa7{\x80\x84\x92S2tg\
\xb6\x0c\x80\xd57\x86\x96\xcaLi\xd1@i\xbd\xab\x0d\
I\xd3\xe1w\xf4\xe0w\x02\xb1~\x07\x10\xbe+\xd7\xb3\
,\x11V\x14:<\x0b\x94\xd0\xa3\x5cJ\xe8\x1d\xbc\x07\
(\xda\xcaj\xf1\x1e\x90\x05\x14\xac6mq_\xbfR\
p\xf7\x81]\xceEC/\xc0\xd4\xb7\xf8\xc6\x9d\xc2/\
\xbf\xe9\x0b\x00\xac\x1c}\x05\x1c\x94eP28\x01w\
\xf5\xf9]\x7f\x1a\xb8\xf0\xc53,\xd3\xf7\xbc\xe7=e\
9\xfa\xca\xa4\x05~W\xb7qh\x93X\x5crnk\
?\xb0\xe6\xde\x92\x01V-\x10\xcc\x9e\xb9,j\xcd\x0a\
\xf8\xfa\xda\xa4\xd5@\xa8\xa3\xa3c\xd7ocW\xfdP\
L\xe8W\xb8\xaa\x00t\xf7\xddw\xdb\xf3\xf5y\xe9>\
u\xa8N\x7f\xd5\xab^U\xfb\x93?\xf9\x93R\xd0\xad\
q\xd1\xb1.#*\xe1f\x91P\x1c\xbf%1\x17\x01\
\xb0\x98\x8eR\x1a]\x8d|G\x8e\x7f.y<\x81#\
\x84E\x1d<\xaa\xe7\xa3\xfbN\xe0(\x13\x01\xa6 \xa1\
\xcfHMa\xab9\x99\x8b&\xd3\xed\xca \xe8\x14\x91\
\x22G\x81\x1b\x9f\xe3\x9e\x98\x9d\xa2\xe4\x89_dM\x93\
\xd1\x9a\x22\xf9\x9f%BY\x00\x08\xe5\xa3\xdc9\x12Z\
\x9bY\x03\xde\xfb\xe2\x17\xbfXZ@q\x15\x8c\xde\x94\
\x1d\xbf2#\x04\x10\xfcN\x19)\xac\xb2-O\xb0\x87\
\x8a\x15I\xa1\x00\x81\xbf\x95\x01\x00\x00<\x05\xe3.y\
?\xa9]))\x9a\x81\x86\xbeA\x83\xb2\x81gV?\
{.\xe9;\x94\x85w\xeae\xe9\xf8\x1dO)\xb9\xb5\
B\x9ee-)\x17\x7f\xb9\xb2x\xef\xb9\xc4\xc7\xd4\x11\
\xab\x08P\xc4U\xc5k}\x8f>\xf2\x00x\x80\x85\xb2\
<\x9f@1:\x94\xc1\xf5\xc2+\xf5s\xf3\xdc\xc7W\
m\x07x\xfaO[\xf0\x83E\xab\xcclB\x068\xe4\
N\xb9,,\xf4\xc5]6\xe8dO\x1e\x1a\xf1\xb0\xbf\
\xbf\xff\xc9\xb3\xcf>\xfb\xaa\x11#F\xac\xfdm\xec\x1f\
\x1b\xb2\x84~\x85\xab\x1e\x18\x1d}\xfb\xed\xb7\xff\xc1\xdc\
\xb9s?\xb7{\xf7\xee)I\x13aF\xc7,\x96\x11\
O\xa2\xf4\xf8\xdc\x04\x9f\x82Sx\xae\x03a P\xca\
b\x1e\xe7\xd4\x87\xc4?\x08\x0e\xd3\x9b5@\x90\xbc\x97\
C\x06\xb3\x9f\x8akC\x10\xdd\xa3t\x94&\x09\xb9\x08\
\xa3\x91<\xd6F\xaeVBE\xf1\xd4\x8b\xce,d\xab\
^\xd5\x11Q\xec\x86\xc2\x01\x143x\x04\x19\x0d\xdc\xae\
lA\xf0\x9b\xff)0\xba\xb8\x08\x94\xd7\xb3\xf8\xc0\x05\
U\x86\xdf\xe2j\x020\xa0I\x11\xd0\xcf\x8a\xa3H\xac\
\x89l\xca\xac\x06\xd5\xb3\xfeGLG0\x1b\xb0\xd8\xc0\
\xcb\x1a0\xea\x9b\x05L\x8ek\xfd\xa3\x8d9,\x11\xa8\
\x03E\xf5SZ\x96\x02\xc0\xf1\x8c\xe7m\xefH},\
\x0dee\xff\x1a\x85\x05\xc6\xfaZ\x1f\xa2M}\xca1\
\xc9\x80\x17\x16o\xe2\x85\x94'\xff\xfc\xcf\xff\x5c\xb6\x05\
8\x02&\x83\x85<P\xbeK\xc1\x92\xc1I\xf0\x19p\
+G\xdf\xe2\x03\x8b\x08`hS\xdcs\xf7Y\x9b@\
[\xeep\xd6\x0d\xc0buf+JV\xd4\xbb/\xb6\
\xe4\x1d\xe0\x0f\xbcb\x95\x15\xf5\xad*\x99\x91\xc4\x0b \
8s\xe6\xcc\x15#F\x8cX\xf5\xdbX-]\xfco\
\xb4\x84\x0e'\xe7n\xa3\x09\xda\xf87\x00\xba\xf5\xd6[\
\xff\xe0\x9b\xdf\xfc\xe6\x9f\x1f8p`\xb2N\xef\xea\xea\
\x1ax\xdb\xdb\xdeV\x13L\x06\x1a_\xf9\xcaWJ!\
\xcf\x919\x01\x09\x02\xe6;a!\xa4\x04\x9d\x90Sl\
\x82J\xc8\x08\x86\xd9\x1e\xe0\x04\x10\x08(01\xba\xb2\
\xb4\x94\x93\xc5i>\xea1\xb2Rf\xef\x10\xa4,\xd7\
\xa7\x1cYQ\xdd,\x95o\xda\xe5\x1d\xc0\xe8Y\xedi\
\x9c\x92\xaf\xf2@\xb9\xd9\xe7\x94i|\x16\x8c\x0fE6\
\x1b\xe4#\xee\xe194\xb3@(\x09\xe5JFG@\
\xe3wm\xc1\x87lA`\xb9$\xa9\x99\x15\xe5\xf8D\
q\xab\xa7\xb5R&n\xa1\xb2\xad2\xf6\x1b\x9e*G\
p?\xcb\x16\x80\xb2\xdf\xb2\xc13k\xaar|5\x0b\
H\xff\xe0\xbfz\xb4\xd1\x92\x00\xfdDQ\xf1\x16p\x02\
'\x16\x03\xcb\x05\xb0\xb2\xf4\xf4\x13\x000X\x00\x05\x96\
\x8d]\xf7\xda\xcdja\x95\x02+\xf5\xea\x1f<\x05\x9a\
\x09\x14g+\x0b\xfa\xb4\x07\xbd\xf8\x9c\xd5\xd99\x17\xce\
o\x82\xfe\xda\xa2?\xf1\x18or8\x81\x01K\x1bX\
\xcf\x5c4m\x02>\x06\xa1\x9cp\xa2\x8f\x94\x83\xdf\xea\
\x04\xee\xf8\xa5\xcf\xc5\xee\xf4\x8bAc\xf7\xee\xdd}\x97\
^z\xe9\xb7\x8f:\xea\xa8{\x7f[I\xce\xfeK-\
\xa1\xc6\xe4N\xc5a\x04\xc1\x0e\x97)\xcd\xf6\x11\x1d\xce\
\x8a\xe2\xc6\xe7\xf3=\xe5\xc9\xa0w\xdbm\xb7}\xec\xca\
+\xaf\xfc|GG\xc7\x04\x02\xd9\xdd\xdd=\xf0\x92\x97\
\xbc\xa4\xc6\x9d\x12'\x10\xdc$\x08\xc0\xc5\x08L\xa8\x08\
\x1aAw1\x87\x09\x11!\xa0\x90\x80\x8aP&w\xb1\
\x18BR\xa1\x02\x96,d#<\x14\x82\xb0T\xcf~\
\x8f\x1b\x08\xc4\x92'\x99r$Wt\xae\xc1\xda\xae\xbe\
\xc4\x85\x22\xb8\xd5\x8bRPHB\xac\x1e\xf5Q0\xc1\
S\xca@\xe9)\x8a\xf7\x81\x13\xba\xb5\xc5b@t\x10\
r\xef\x8bax\xd7\xdf\x142\xb9}\x94\x1f\xb7U\xb9\
,\x10e\x01\x5c\x0a\x96\x8c\x90E\xfd\x94\x0d4\xe0q\
\xac\x97l\xcd\xf0\x1e\x00\xd7\x07\xeeY\x91\x8e><\x06\
.I\xe9\xc1\x12\xf3\xacr)7ef\x85\xa1=\xe9\
=\x94\x8d\xcf\xdf\xf9\xcewJ\xcb(S\xec\xcaG\x83\
E~\x9e\xc9*i\xed\xf7\xae\x81#\x87\x08\xe8\x0f\x87\
2\xb2\x88\xd4\x01\xe0\xb3\xee\x08\xbd\xac8rb\xd0\x00\
\x06\xfa7+\xab\xb9z\xe8\xd1~}\x22\x96D\x9er\
X\xa5\xef\x9e\x070\x06\x034\xe0\xa5\xf6i;pL\
6\x00\xb2\xa3\xcd\x9e\x03\xa4,;\xe5\x93\x15u\xa0\xa1\
\x9eqs\xfd1\xc7\x1c\xb3 \x09\xf4\x0f\xa5\x8b\x87z\
\xe6p\xae\xdf\xa8%t8\x00\xd1lca\xf5j\xb6\
\x01\xb1\x0a\x06\x83\xdd\xab\xa6o\xa8>W\xddz\xd0\xaa\
\xdcF\x10l\xf6\xec\xde\xbd{\xc7\xfc\xe8G?\xfa\xd8\
\xdc\xb9s\xff\xac\xa7\xa7gb\xcckyZ\x08\xa2\x91\
\xf0\x1f\xff\xf1\x1fK\xc5\xe1B\x10\xf2\x1c\xc7C\x00(\
\x15%\x06(\x02\xa4\x09Df\x9f\xd1\x0f\x7f\xf8\xc3r\
T3uZM\xf2U\xcd\xff\x0b\xb8(\x03A$\xec\
>\x94(\xa9/\x08?\x05\xcd\xb6\x8a\xecHO\x96\xc4\
V\x8b\x0e\xbd\x9fu#\xac\x94\x04\xa7\x8b\xba\xd5A\xc1\
\x92\xf6\x95\xe2\x8a\xd1hSQ_\xb9Mi\x08<E\
\xb2A\x14(%\x88\x9b\x1d\xef\xda\x97\xa3\x82(\x90\xf7\
\xb2\xe5\xc2\xa8\xcf%B3z\x81\x86\xf7\x8c\xd4\xc0#\
g\xe6Sd4\xe4L\xfc\xf0 \xfcr%\xb3d\x92\
\x92\x01\xbc,.T\x17+\xc7\x9a,\xd6@\xac+\xcf\
\x96\x0bJ_\xf6\xb2\x926\xf4&\xbd\xab\xd8\x12>\xb2\
\xf4\xf4\x8fz\xb5M\xdf\xe5\xf4V\xf1+\xbf\xa1\x05p\
\xe9\x8b\xc4\x9c|\x00!\xcb\x0do\x95\x0b,\xfc\xad\x1d\
\x19`\x12t\xcfJ\xef\xc4\xa5|\x07f\x06/\xd6\x0d\
\xe0I\x10\x19\x90\xe8k}\x8eV\xb11md\xa5\xe1\
\x03\x9e\x91\xbf\xb8\xee\x19\xa0\xf4\x17\xb9\xc3_\x83A&\
7\xa6O\x9f\xbe\xe2\xd4SO\xbd|\xf8\xf0\xe1\x9b\x06\
U\xe4_bP?\xd4\xf5\x1b\xb3\x84\xaa\x0aS\x1c&\
:V\x15\xadZN\xab\xb2\x07\xbb\xd7\x08\x18\x87z\xbf\
j\x81U\xc1\xab\xfa\x5c\xf5;\x00\xfa\xc1\x0f~\xf0\xb1\
\xef~\xf7\xbb\x7f\xb6m\xdb\xb6\x09\x84\x89\xf2\xb3\x1er\
\x840\xe5 \x149\xc5\x94yO\xc8\x09\x0d\xf7$\xd9\
\xfd\xf8\xfe\x94\xd5hj\xc1\x19!\xaa&Yo\xdc\x07\
U\x05\xc8\x81\xca!\x88E={\xa0O\xac\x18\xca*\
\x86@\xa9)]\xd6\x8bdq#P\x00\x22@\x8c \
\xa7.\x8a\x97\xdc2\xdaa\xf4$\xb0>Q\x18B\x1c\
w\x00\x1dF\xd4\xe4\x0f\xcal\x13\xe5\xa4\xe4@L\xdb\
\x12\x00\xcdQ\xcc\xdc\x98\xb8~\xca\xd3\xde\xb8M\xb9\xd4\
\xc5\xad\x00\xc6,\x0f\xc0\xcd\xaa\xca\x8aet{^\x9d\
U+\xa8\xaa\x14bD\xc0C\x9e%\xca\xa5n\xb1(\
\xca\x9c\xd4$E}\x0d\x10\x0b\x83\x1b,\xe0\x0dDL\
}Sx\x8a\x8d\xa7\x80\xc9G\xfb\xd4i\xbb\x862X\
\xacx\x836\xedT60\xf2\xbf\xfb&\x18\x94\x8b_\
\x80\x00\xa8\xd8\x90\x8b\xf7,\x11`\x86\x17\x82\xdc\xfe\xd7\
O\xca\xd4\x17\x80\x1c\x1f\xf4\x03\xfey\x16\x90d\x7f\x19\
9\xca\xa2M@\x05\xe4\xf4M\xd6\x8c\x89\x03i\x83x\
\x13\xf9\x10\x17\x8c%f\xc9G\xf2x\xe7,\xb7\x81\xfa\
\x11\xe1\xed\xed\xed\xc3\x95\xd9Jo\x06\xbb~U\xcb\xa8\
c0W\xa8\xd5o\xcd\xdc\xa8Fk\xe3pA\xa2\x19\
\xe8T\xaff\x0dj\x06xU\x01\x1c\xccjj\x052\
\x8d\xf4T\x95}\xcf\x9e=G\xdct\xd3M\x7fx\xe3\
\x8d7~\xa6\xa7\xa7gBN_\x88\xc2f;\x01w\
LP:1\x10# \xc1#\xe4FG\xb1\x0b\xae\x86\
\xef\x02\x9c\x04\x97\x12\x011\xc2@q\xb2V'\xc1\xda\
F\xa0\xce\xc2\xb4F\x8b\xc6{\xca!t\xe2(\x14\x06\
\x0d9\x8f\x8ce\xa2\x0e#/\x97\x81\x12z\x87\x82\x12\
NJJ\xc0\x93\xd3X\xbbX\x07\xda\x00T\x99\xf6\xd9\
\x91\xad\x9e\x044\xb3m$\xd3\xbd,\x00\xed\xa2d\x5c\
5\xed\xa0\x90\xb6\xa4\x18m\xb3\x03\x9e\xb2\xa3#Y\x15\
\x8bz\x5c*\xd3\xd6qw\xb8+,\x16V\x91@+\
\x9a\xf0P9\x94\xb1q\xbd\x12\xfas>\x19E\xf5\x1c\
\x9e\xc4JIFDt\xe93\xe5\xa1/\x00D\xa1\xb5\
_\xfd\x01\x17\x16\x90\xb6\xe93\xe0\xc9\x02\xc1\x07\x00\x87\
w\x82\xd0I\xd6\x86\xe7~\x07\x02,\xb8L\xff\xe3!\
\x0b\x08\x90:5\x96,x\x8f,\x5cs\xcd5e\xd0\
X\x1b\x01/\xc0\xd06\xb2\xa1\x1d@\x0b_\xb3\x1e\x08\
\x0dh\xd5\x07x\x04\xb4\x04\xc9=\xc7Z\x8d\xf5\x93\xd4\
$\xf8J\x063\x15\xaf\x0emI\xce\xecl\xc6\xad/\
 \xed\xda\xb7o_S\xe3\xe4\xd7q\xbfZ\x01\x9a\xfb\
\x07\xdd\xb1\xc68H3\xcb\xa1\xd9\xd5\x0c\xb4\x063\xd3\
Z\x01P\xa6\x9d\x1b?Ee\xbdJc\x19\xb5\x86\xe4\
[\xd5\xdf[\x81M+\xc0m\xa4;\xdfw\xee\xdc9\
\xf6\xba\xeb\xae\xfb\xe4\xf5\xd7_\xff\x99={\xf6\x8cG\
\x0b\xc1!\x0c\x84$S\xc6\x94\x81\xb2\xb0r\x08\x85Q\
\xc5hC\x10\xbds\xc1+.8\x98\xf3\xc7(\xef^\
\x96\xfb[;\x94}M\xac\x0b#v\xd6\xc1\x14M@\
4\x00\x94m\x1f@\x81\xa5a\xe4\xa7d\xac\x04\xb4e\
\x1dM\xac\x0d@\x13+\x0d\xa0dMNQ_+\x94\
\xb4\xaa\xc0\x95\xab\x98U\xcc\xc9\xa5\xecyJ\x94\xd3:\
(\x06\x8b\x8e\xf2e\x8a\x1a\xb0\x01c\x00\x04\x00\x8d\xc6\
\xdcT\x8a\x0dd)(\x05\xf3lu!a\xe3\x0al\
\xfcD\x87\xf6$]\x09~R\x22\xb4\x8a\xbdQ\x1c\xcf\
e\x852\x9e\xb3^\x00IVq\x87&\xf7j\xf5#\
\x88\xf2\x9e\xa5\x11\x00\x14\xd0\xc5\x85\xa3\x98\x00\x01\xa8p\
\xb7\x93D,k\x88\xf0\x85\xb2\xc7}\xca*i\xfc\x06\
\x12\xfaS\x1d\xca\xa7\xd4\xfe\xf7\x0c0J\x10\x1dP\x8a\
M\xf9\x1dm\xc9\x93\xc4M\xd5f\x96\x9f\xf7\x04\xb7s\
*nbc\xfa\x88k\xac\x9d\xea\x020\x9e\xcdv\x0d\
\xd649Rn\xdc=\x83&\xfe\x03(\xb4\xe8+\xb2\
\xc0=\xd6?\xf8\xeb\x99\xfa\xd6\x92\x95'\x9f|\xf2\xf5\
\xa3F\x8dz\xf6P\x86F\xab\x98k\xab\x10G+\xbd\
\xeb\x18,\xf6\xd2\x0c`\x06C\xb4\xc1\x82\xcb\x83Y)\
\xd5w\x9a%\xd8>\x1ckh0w\xb0\x15\xc3\x1aM\
\xf8\xc6\xfazzz\xc6\xce\x9d;\xf7\x8f\x9d\x015|\
\xf8\xf0q\x09\x02\x8a\x87\x08\xe4\x01\x1d\x80\x01\x00tr\
\xa6\xc2\xb3\x82\x99\xb0\x18\xfd\x8c\xec\xd9\xd7\xa5\xd3\x09\x1a\
\xd3Y=L\xf1\xa4\x05% \x04>\xf9^\xe2\xeaT\
\xd7\x05\x15\xf5\x18M\x82\x9bF\xc3\xec\x96\xa6\xfc\xea3\
\x8a\x03(JT\xdd\xfe\xd0x\xb1(\xb2X\x8d\x22X\
@H\x90\x13\xf4\x04>\x94\xde\xff\x99\xbdJ\x1bXU\
,\x1b\x8a\x82\x079\xfe\x86\xdb\xe9o\xb4\x01`1\x0c\
\x8a\xfe\x89O|\xe2`\xae\xecfWc?$\x08\xcc\
5\x02\x0c\x89QQ\xe2X(\x144\x99\x01\xb3\x89\xd5\
w\xbc\x03\xb2\xda\x91=S\x14\x1bH\x17\xf5%\x06\xe8\
\xc2G\x03\x01\xf0\xd0\x7fY\xe5-\xce\x03 \xaaV\x9a\
\xbeQ\x0e\x0b\xc7@\xa1}\x16\x96\xea/V\x067\x0b\
m@6q\x1c\xb2\xa2l\xfd\x12p\x01bx\x8a\xef\
\xdf\xfc\xe67\xcb\xdf\x00 \xd7\x1d\xf0\x01]\x00k\xa0\
\x22\x17\xfa\x08\xa8\xb1~\x94\xab\xcc\xcc\x22\xfa\xb0\xd2\xb4\
\xd3@D>\x95\x91\x9c\xd4\xdc\xb2\x9c\xaeK\x8e\xd0\x84\
7\xc9b\xa9\xcf\x95\x8f\xb79\x22j\xca\x94)\xab\xba\
\xbb\xbbw\xe64\xd9F\x1dj\x06@\xadt\xebP\x98\
p0\xce\xd9\xa8\xb0\x872\xb5\x9a\x01Q3\x00h\x05\
\x06\x8dW\xf5\xb9F\x8b\xa7\xf1\xbd\xea\x19T\x8d\x80\xd9\
H_+\xd0l\xfc\xde,\xb8]Oz>\xf3\xea\xab\
\xaf\xfe\xc8\xcf~\xf6\xb3O\xcc\x9e={\xac\xcd\xa8\x12\
\xd3\x9b\x82\xa7\xe8\x01\x15\x1dMQXDFC#\x91\
X\x00!%\x0c\xee\xe7Y\x80A\x08\x8dz\x84\x07\x00\
\x15\xf5\x8c\x7f\xd9\xa6@\x89\x08W\x12\x9c\xa5\xcd\xde\xa5\
\xf8\x14;y\x7f(\x09\x852\x12&\x9f4a&`\
\xcc\xec\xb8\x88\x83\xf5\x0d\xe5\x05\x1e\xdaPO\xe5P*\
\x93\xd1\x91`\x12\x5c\xc2\x9ai\xe3\xea\x94<\x81NB\
2\xf4Ql\x82L\xd9Y\x0aIg\xc1U\x00@x\
3P\xcf\xf5\xe3\xa3\xbf\x93\xd5\x8fR\xe6\xe3\xb9\xa2\xbe\
\x8d@\xdd\xac\x06\xca\xf5\xf1\x8f\x7f\xbc\xbc\xe7\x19\x00\x9b\
\xbc<Yo\xc5\xd2\xca\xde\xb8\x5ch\x06*@X;\
Y$,\x82\xa4C\xc57\xf7s\xe6\x18`\x05~b\
[\xee\x15u71\x0b\x153\xd3\x06\xb4\x80\x11\x10\xb6\
VG\xbf&\xcd+\xe0\xd1\xfe\xa2\xb2\xd1\x180\xab\x13\
\x18\xb1\xb4(?\x9a\xad\x94'S\xdaW\xd4\xf3t\xe3\
\xab~N\xfe#u\x1a\xf0bMi\xbf>\xf0\x7f\x96\
t\xf8\x90\x07\xfdcP\xf4\x9d,d\xf2@\xbdh\xd5\
o\xe8\xfc\xc67\xbeQ\xca\x13\xcb}\xc3\x86\x0d\x03r\
No\xda\xb4i\xe0\xc3\x1f\xfe\xf0\x82\x11#Fl\xa9\
\xea\xc5\xa1\xf4\xb2\x99\x0e\xb5\xd2\xadf!\x9d\x8eV\x16\
C\xe3\xdf\xad\x04\xb9\x19aU\xc4le\xf946\xa4\
\xd1\xe4;\x1c\x9a\x1a\xcb<\x14\x08\xb6*\xb7\xd1*\xda\
\xb6m\xdbiW]u\xd5\xa7\x1ez\xe8\xa1w\x9cz\
\xea\xa9\xa3\xfb\xfa\xfa\x06(x\xb2\xde\xc5\xaa0\xf2\x10\
\x22#\x93\xce\xf4\x8c\x18\x83N\xe3\xa2%(\x9c\xa0\xab\
\x11\x88@\x03\x06\x8a\xca\x9a\xf1\x5c\xa6\xd1\x8dH\xb1\xa2\
R\x07  \x90\xca*\xea\xc9\xc42-\x9c\xed\x1c\x80\
\x82\xf5D\x01\x80Y6`\xb2 \x08-\xd0\xcc\xf6\x86\
\xea\xb9c.\xca#\xa8\xce\x12c\xe1\xa11n[2\
\xed\x89\xe7d\x07=\xc1\xa7\xecq\x19]\xe85%\xce\
\xbd\xc9*^\xf4\xa1\xdb\xf3\xe8SF\x12\xe0W\xf9\x1e\
k/\xb1\xae\x81z2\xfe\xa2\xbe\xc2<\x80\xc6\xca\xa4\
4Iv\xaf=Y\x89\x0c\xb8\x01/\xe5\xc6\xef\x9c\x02\
K1\xd3\xe6\xeaB?\x96\x99w\xd1\xaf\x9c\x9c\xab\xa6\
/\xf0\x0f\xb8\x15u\xf0)\xea{\xc4\x80N\x5c/\xae\
\xb3\x8f\xf5H\xacG D.\xd0\x9b\xdc<\xc0Y\x5c\
,\xed\x8bk\x8c/\xca\xb7XQ{\xf0[?\xb1\xec\
\xaa\xe9U\xb2L\x01\x00'p]\xd4\x17\x95V\x07'\
e\xe1/\xab)n6Y\xd1\x17\xe4\x0c\x9d\xac\xbb\x1c\
\x7f\xe4\xb7\xe4\xa6\xd2\x16\xcf\xc5\x9d\x9b6m\xda\xaa\x93\
O>\xf9^\xdb5\x9a\xe9s\xe35\x985\xd4\xa8{\
\x83\xb9c\xed\xff\xf7\xff\xfe\xdf\xff\xf4r\x95\x80fh\
\xd6H\xdc`VI\xb3\x18O3\xe0i\xfc\xbd\xf1\xb7\
j\x99\x8d>hc\x99\x87jK+\x13\xb2x.\xdd\
\xe5\xb9s\xe7\xce\xfd\xe2\xc2\x85\x0b\xdfq\xf2\xc9'\x8f\
\xe8\xeb\xeb;\xf0\xc4\x13O\xb4\xf5\xf5\xf5\xd5\x8c\xe8\xd5\
\x91\x96`\x13\x22\x01F#\x90\x11V\xc7Rf\x02A\
h\xe3\xb6\x10P\xa9?\x8dL:\x9d`\x19\xdd\x00F\
\x95\x97\x04\x0a8Q\xe6\x1cr\xc720\xb2y\xd6;\
I\xf0\x95\x8b5f\x94$d9c\x0c\xf0\xf9N\x89\
\x8d\xe2\xd9\x94\x19\xd7\x0e`\xcaW\x0cd\x00\xa8`%\
\xa5\xcd\xf16\x04\x95e@\x81\x80\x80g\xd4M\xe1\x8d\
\xd0\xe2\x0d\xca\xf5~\xf6BQ\x22\xaeF\xf66\xa1\xc9\
F\x5c\xf7s\xfc\xb2OV.\xa31\xff\xe3I\x82\xd5\
\x00B\xbc\x83b\x00<|\xf7\x0c\x05\x17?K\xc2.\
\xef&5\x85:\xa3\xf0\xf8\xc6}q\x0f\xe0$\xf6\xa3\
\x0e\xcf\x18L\x8a\xfa\xd4=p\x13\xfbR\x17\xc5g\xfd\
\x00\x1c\xcf\xa1U\x1d\x06\x1a\xf7\xb2y\xd6=e\x03\x14\
\xfd\xcf=\xcc\x8e|}\x00\xe8\xb8\xa5\x06\x00\xf7r^\
\x9bKV\x81XF\xd9\x9c\xcc\x9a\x03\xacd\x03\x08z\
\x0f\xef\xf1\x14\xdf\x94\x99\xb5K\x06\x1b\xdf\xb9\x85h\xcd\
\x87\xd5\x9d\xf3\xc8\xfc=\xf0\x5c\x96\xc4\x92\xee\xa2nm\
\xe7\x1c9\xbfe\xb7<\xf9\x187n\x5c\x8dl\x5cx\
\xe1\x857\xbe\xe8E/\x9a\x9b=c\xcd\xf4\xaf\x995\
\xd38\x887z \xcd\x0c\x98\xea\xbd\xa6\xeeX\xd5\xfd\
i\x8c\xd54\x82Cc\xe1\xd5Y\x9bC\xb9D\xad\xfc\
\xc4f\xbf\xb5\xb2\xac\x1a\x01\xa6YY\x8d\xedj\xf6\xbb\
k\xfd\xfa\xf5/\xbb\xea\xaa\xab\xfe|\xc5\x8a\x15\xaf?\
\xed\xb4\xd3:\xeb\x8b\x01k:L\xbb\xaa\xc9\xe4)\x09\
e\xcc\xf9Z\x84\x8e\x12Q\xd6\x8ch\x84\x9c\x9b\x93\xdd\
\xe4I Fy\x81\x14\x05\xa8\xf2K9\x5c1\x80E\
\x18\x81\x01\xe0\xa1\xd8\xca\xacnN\xad\xd2Nhs\x0c\
OQ\x0fXg\xb74\x13\x9c\xf9\xcd\x121\xd2\x03\x00\
tSf\x8al]\x89:\x5c\xd9\x99\xceZ\xc9\x8e\xf0\
dWL\x1e \x97\xdf\xd4OI\x13\x0cV7%\xca\
\xa2EB-fb$>\xdc\x0b\xdd\xcaS\x17pA\
?`4+\xa6\xbcl\x02v?\xfb\xadb!\xa0\x15\
\xdd\x9e\xe7\x0e\xb3\x98\x8c\xfa\xac\x1c\x81\xe7lEa\xbd\
\x90\x05\xefSt<\xd7\x179%\xc4o\xda\x09\x08\xb5\
\x1b\xaf\x80\x01\xeb\xd0;\xfa4\xee\x09\xdeX\x0c\xa9L\
\x1f\x80\x82\xbf\xe2}\x06 \xfd\xccB\xcc\xd1M9J\
\x9a\x0b\xcdr\x03\x86\xd9\xca\xf3\xd5\xaf~\xb5\xf8\x97\x7f\
\xf9\x97R&\x92\x7f)\x87Cf+\x0eW*I\xd3\
X\xaa\x80\x855\xae\x5c.\x18yM\xaa\x14\xc0\x99\xb5\
J\xd9\x92c\xa0T\x96v\xe3\x15\xfar\x1c\xf8\xf1\xc7\
\x1f\xbf\xe3\xb4\xd3N\xbb\xb3\xab\xabk\xeb@\xc3R\x90\
V\xba\xd58\x907\x0bb\x0f\x16C\xce\xd5\xd1\xb8(\
\xae\x95\xc26\xb3T\x0eE\x5c\xb3g\x9b\x95\xd1XV\
+\xc0iEg\xab\xb2[5\xbe\x11h\x8b\xe7|\xe6\
\x0b\xe6\xce\x9d\xfb\x85\x8d\x1b7\xbe\xf6\xc4\x13O\xec\xc8\
T\xed\x05\x17\x5cP#\xa4\x04\x9a\xf2\x15u\x97D\xc7\
gJ\x1b\x00EH\x95\xe7\xdd\x98\xff\x94B\xec\x80p\
\xc9+$W\x10\x97A\x9eh\xa3\x1ca\xf5\x1c!1\
\xc2\x13\xf0\xb8\x199\xbe'W\xdc\x95\x5c\x04\x88`\x11\
\xb6d@\xac\x0e\x1a\xbe\xa3\x99\x12R$kO\x8a\xba\
\x09O\x11\x94\xaf.\xf4\x02\x12\xa6\x7f\xa6\xde\xfd\x9fQ\
6I\xeas~W2\x18\xaa'\xb9\x86\xb2\xaeH[\
s\x1e}N\x89\xf5|6\xc5\x16\xf5\xe9\xf1\xc6l\x8d\
\xda\x90\xd3+\xfc\x8e\xc7FnuO\x988\xa1\x988\
a\xe2A\x00\xc0w\xe5';\xe1@\xfdh#}D\
A\xbd\xafm\xda\xa0\xcc\x1c\xef\xac\x0e@\x86g\xc0\x92\
B\x028\xedJL&\x16\x95g\x00\x99~\xc9\xf4\xba\
\x81 \xa0W\xd4\xdd\xb5\x00\x91\x15\xd5\xf8\xcb*\xd6\x17\
q\x8d\xf0&\xa7\xa8f\xd1af\xc9\xf0R\x1b\x93\xfb\
\x88+\xcf*b\xe5\x00o\xeeX,\xdb\xc8\x1d:\xf0\
\x99\xf5\x99L\x94\x99\x5c\x00&\xda\x01\xf0\x80.\x90Q\
\x069\xe1\xaa\xb2ds`B\xad\xbe\xbf\x10\xbf\xf1\xe2\
\xcdo~\xf3\xcf\x8f:\xea\xa8\x87\x8c\x05U\x1dn6\
3\xdd\xa8\x9b\xad\xc2 \x87\x13+.cBE\x83[\
T\xb5xZ\xa1X\xe3\xd5\xf8L\xe3\xa9\x0f\x83\x05\xb0\
\x1a\xff\x0f(\x1eN\xb0+\x021\x18\xe04\xbbR~\
,\x8b\xe5\xcb\x97\xbf\xf2\xca+\xaf\xfc\x8bm\xdb\xb6\xbd\
\xe2\x98c\x8e\xe90\x12g\x93\x22\x01\x8b[\x12\x0b\x87\
\xe0\x10\x82\xc4p\xb8_:\x1f\x98\x106\xae\x80\x8e&\
H\xe8\x22H\xe2\x06\x04\xdcs\x14\x9b\xc0\xb1@\xd4C\
\xe0))S?\x8a\x86\xbe\xc4a2\xc3\xd5\xec\xca\xae\
\xe9d]\xcc\xbb\xd56\xa2\x11\x0d\xc9\xc8\x97\xc3\x15\xb9\
\x00Fj\xa3\xb3:\xb8%9c\x1d\xadhJ\xae\xa1\
jfEB\xaf\x1cJ\xcd\xad\xa4h\xb1JX\x8b\x5c\
V\xe0\xa4m@\x09\x98\xe7 \xc1\xc43\x92\xd9\xd0;\
\xf8i\x14/\xea\xd6\x85z\xd1[\x05\xbb\x5c~\xd7?\
\x89!%^\x83\x87YM\x9e\xbcE\xb5z\xdaY\x00\
\xccRA7\xe5\x07`\xd6\xf8\x00h\xd6!\xc5\xd7\xb6\
\x9c\xea\xea>\xeb\x11\xa8\xb1l\x01K&\x17\x1a\xe5\x1c\
\x1d\xca\xf3\x0c R\x8f\xefY\x0c\x0a4\x94'\xf9Z\
\xac\x0f\xbc\xc7_\xeee\x92\xbd\xb1\x1a\x01\xa45D\xe4\
C\xd9\xd9\xcc\x0b\xac\xf0\x03?=\xc3B\xe2J\x03x\
\xbf\x03\xbc$\xe7gy\xe3\x87\x19Y\x96\x19Yd\x99\
z__\xa0W\xfcJ\x9b\xeb\xe9\x5c\xc9\xdd\xe6\x8b/\
\xbe\xf8\x9a\x91#G\xae\xa8\xea\xe4\xc0!\xd6\xfb\x0d\xe6\
Y\xd4\x06\x89\x0b7\xeatG\xb3\x07\x1a}\xbd\xa2\x01\
\xb9\x0e\x05&\xad\x5c\xac\xc1P\xb1\x0a2\xad\xe2K\xad\
,\x9cf\x96T\xb3\xf6T\xff\x0f@.Y\xb2\xe4u\
\xdf\xfe\xf6\xb7\xffr\xd3\xa6M/=\xfa\xe8\xa3\xdb\x09\
\xad\xd1AGSV\x0a\x9c3\xd7\x93N\xd5\xa8\xa2\xa3\
\xa5\x92\x004\xeeqo\xdc\xa3\x8c\x04\x80`\xe4\x80@\
VP\x8ep!\xb0\x14]\x19\xac)\xf9\xa4\x93\x80+\
\xf1\x0du\x1a\xd1\x09X5\xd1|c;\x08\x1d\x81\xf5\
L\x92\xdfS\xeaZ=\xe0\x0b\x80\xb4\xc5HL`\xcd\
\xfa\xb8G\x00\xfd\x8dV\xc0C\xb0)-\xe0@\xab\xd9\
\xa4\xacI)\xea\x9b=\x03:9\x9c0\x8b\x14\xfd\x96\
\x04Y,\x86l\x83\xa0\x8c\xca\xa4\x08\x14:[B\xea\
gp\x95u\xb1\x0a\xf1(\xeef\x12\xc1g\xd3\xa9{\
9\xaeHY\xac\x19\x8a\x8c7\xf8\x19\x90\xf2\x1b\x9e&\
\xcb@\xf5b\x11\xe0-\xc0E\x87\x0fK\x01\x1dI4\
\xaf\x9d\x14>\x07+\xc6\xa2cM\x01\x14\xe5\xb2\xaa<\
W]\xeaP\xfd\x8ef\xb1+@\x0f\x98\x011`\xf7\
\x0e\x1a\xf1\xc1\xfd$)C\xa7g\xb4)\x8b\x0as\x0c\
\x10\xcbZ\xd9\xea\xe7\x9a''\x906\xf8\x1d=\x06H\
n>\xe0\xb4\xcc\x80\xfbe\x82A\x9br\xdc\xb6\xfb\xfa\
\x1f\x08\x92\x8f\x9c\xcc\xa2\xccZ=\xd7\xd2\x981c\xfa\
\xdf\xff\xfe\xf7_;g\xce\x9c\x9b%3\xabZ>U\
\x0c\xa8\x1a\x14Uc\xa1\xd9U5f\x0e\xe5\x19\x95\x03\
\xa5,mU0hVx3\xd7\xac\xd9\xbd\xc6\xdf3\
R\xb4\x8a%\xb5\xb2`Z\xb9l\xad\x5c\xc0f\x8dk\
E[QY\x18\xf9\xd8c\x8f\xfd\xce\xb7\xbe\xf5\xad\xff\
w\xd5\xaaU\xe7N\x9a4\xa9=\xe6\xb2N\xa6\xb0I\
\xad \xb0I9u<\x01\x22\xa0\xfc\xfe\x9cNA\x00\
\xd4Ky\xb9dbH\x94\xd3\xa6E\xe5QP#\x9c\
\xe7\x8cjFGe\x19\xbdX?\x84\x8f\xb0fZ\x9e\
2\x12\xba\xe4\xf6i\xd5\xa6\xe4\xf5\xf1\x0e\xd0\xcbLP\
\x5c\x1d\x02iA\x1a\x1a)\x97\xd1Y\xbc$\x0b(\xcd\
\xde\x18\x95\xb3\xb5\x02\x00\xa35{\xce\x08+\xe5L\x5c\
+B\xecw\x82M\x91X\x16\x94I\x19\x09\xc2\xfa\xa4\
.\xf7\xc4D\x92\xf6\x95R\x000#4PN:\xd5\
\xc4\xbc\x92\x1b)\xf1\x13V\x92\xe7YJ\xe8\x00\xf6\xac\
H\xef&\x9fQN\xb0\xc8L\x1c\xbe\x14u\x90\xf0{\
V\x03+\xc73@\x06}YT\xaa/\x80$%\xa6\
\x98hC\x03\xba\xc8B\xd6\x05\xe1I\xb6\xc6(+\xdb\
8b\x91k\x83\xbeWf2\x12\x00y\xf2\xe3\x99\xac\
~\xc6\x03t\xe1c,\xa6\x80\x0b^f\xd9\x07YB\
\x9b\xe7\x00\xb8\xfe\xd4\x8fY\xe9\xee\xff\x0c6\xf8\x0f\xcc\
\xf1\xab\xbe\x1b\xfe h\x01@rG\x96\xb3\xcf\x0f?\
\xb5\xf9\xe2\x8b/\xbe\xff\x92K.\xf9\xff\xba\xbb\xbb\x9f\
\xaa\xeaY\xb3\x18nU\xcf\x8a\x06\xcf\xa5\x99\xd1\xd2j\
j\xbf\x11':\x9a!U\xd1\xc2\xaa\xa9\xdek\xb4\x8c\
\x06C\xbb\xc6w\xf3\xbdY\x96\xbf\xa2\x05\xe85\xfe>\
\x18\xcd\xcd\xac\xa2 sF\xaf\xf9\xf3\xe7\xbfi\xee\xdc\
\xb9\x7f\xfd\xd4SO\xbd\x98 \x10*\x8a\xe2w\x02K\
qtXv\xbc\x1b\xe9X\x10Y\xe7\xa3<\xc2\x05$\
\x8c8\xac\x81\x9c\xa4@\x80\x99\xfb\x00\xcb\xecP\xb2\x1b\
\x126\x8a\xe9\xe2\x06\x00\x193fN0%\x5c\xa1\x8d\
\xcb\x96\xf5/\x84\xa7\xd96\x0d\x17\x01#\xb0\x04?m\
\x8c\xf5B\x88\x8d\xca\x94\x9a\xa5\xa3\x8d\xeeQ\x9a\xcf|\
\xe63\xa5\x00\x13l\x8a\x83.\x0aFq(\xa8\xb6*\
;\xc7\xdd\xe0\x07E@K\xa6\xb5YD\x9e#\xf8\x14\
\x22\xa7\xb7z\x07\xad\xc0G\xbd\x16\xddy\xce\x07\xa8\xc9\
\x14\x80W\xd6\xf9\xb0\x18\xab\x073\xa6\x8d\x89q\xe4\x18\
l\x17\xd0\x01@\xf8\x98\xc5}\xfaA\x1f\x19\xf9}\x22\
O\xd9\x85\xae\x5c\xf4\xb2>c\xb9\xe5Hi\xd6F\xce\
\x00\xd3f\x80\xa3\xbe\xac\xcaf\x85hg\xb6\x85\xe8W\
\x1f\xf5\xe5\x08h\x9f\xd0\x8a\xefd!\x87B\xa2\x07\x90\
zG=d\x84\x05\x16w7\x19\x06\xf0#\xc7\xf4(\
\x0f\x8f\x134\xb7\x19\xfas\x9f\xfb\xdcA\xab\x10M\x9e\
E\xaf\xb6\xe87<3\xe9@^rtQ\xac\xafZ\
\xfd\x10\x03\xcb\x08rb-\x9e\xa3\xc9\xf3\xac\xc0K/\
\xbdt\xc1\x981c\x1e\x8f\x05\xddL\xcf\x1a\xffo\xd4\
\xc9fA\xe8f\x16O\xb3Xl-\x8b\x15\x07S\xfa\
f\x0a\xddXYU\xc9\xab\xaeB\xe33E\x03h5\
\xfb\xbdZ\xcf`@\xd7\xb8\xb2\xbaU\xfc\xaa\xea\xdeE\
\xc9\x1d\xc5|\xed\xb5\xd7~i\xc5\x8a\x15gdCc\
\x96\xae\xeb\x0c\x00\xa1#)\x97zXA\x00\xc5\x08\xec\
\x19\x96Lv\x87\x13R\x8am\xd4\xa1\xc8\x04D@S\
\x9d\x1f\xf8\xc0\x07J\xa1\x12+P\x06A\xf4\x1c\xe1K\
\xd6>\xcf\xb1\x98\xd4\x99-\x09>\x04/\x0am\x94G\
W5\xd6V\xaboA(\xea\xc7>\x17\xf5\x9d\xf0\x84\
N\x9c\x07\x00\x11<\xb1\x06V\x12\xa5@kR8P\
&\x1b1\xd5\xad^Bo\xa4\xa4\x08h5\xcb\x92t\
\xa5\xea\xab\xba\x22\xde\x05\x06\xd9\x9bE\xa8\xab\xb1<t\
\xa2\x85e\x88\x1e\xf1\x0b\x97v\xa3\xd5\xf14\xe1{\xb5\
/\x1bGam\x06\xb2\x99\x11\x02\x14\x82\xec\xc9\xb5\xc3\
jS_@\x01?\x00+K@\xbd\xac\x96\x1c\x96\x08\
`\x95\x05\xfc\xd0\xc6\x82\x04f\x80\xde \x91\xf3\xc8r\
\xeaid\x02o\xf0-Vf\xea\xcb\x19d\xda\x1f\xc0\
F\x03p\x00z\x00\x81e\xa5\x1f?\xf5\xa9O\x95\xbc\
T\xaegr\x9a\x09`&S,\xad\x00T\xc0.\xc7\
A\x19\xcc\x00O\xb6r\xa0O[\xb2\xc9\xd8`)\xe6\
\x93\xa3\xa1\xd4\x97\x1cT\xac\x1d\x96\x91\x8f\xfebU\x05\
\x00\xe3\xc6?\xf4\xd0C\xa7\x8c\x1f?~\xce\xc8\x91#\
\x1fN\x1b\xab\xde\xd0@\xc3\xd2\x96\xa2\xc1\xd3\xa9\xae\x83\
*\x06\x09\x8d\x0c\x16\xa29\xe8\x8e\x0d\x060\x83E\xc4\
\x1b+\x1a\x0c)[\xfd\xdd\x0c8\x9a5\xa8Y\xb9\xcd\
\xc0\xa7j\xfd\xe4\xaa\xcf\xf0t\xddu\xd7]\xef\xbb\xe6\
\x9ak\xfeb\xd5\xaaU\xa7Y\x1f\x81\x89b\x199\xea\
\xc5\xac\x95\xce\xf5.\x01\xe6\x86\x10\xe8L\x13s?\x08\
o\x0e\xcb#\x0c9\xd7\x89b%c\xa2t\x9c\x04>\
\xbb\x953\x85\xed\x1ea\x8bI\xef\x1e\xa562\x11\xfc\
\x1c\x04\xa8\xdc\xec\x0b\xcab:\xbf\xfb\xc4\xe2H@9\
\xa9[\x95!\xf7\x0d\x1a(\xd4\xef\xfd\xde\xef\x95#\x1f\
\x1a\xbc\x03\xe8\x8c\xb8\x04\x99E\xa6\x8e,(T'\xa5\
\xe2\x9e\xb1\xcarz\x846Ww\xaa\xfb\x10x\xefP\
\x94\xb8\x83\xda\x97#l\x80&\xc5\x04\x1c\xda.\x88\xaf\
.Jm\x17\xbd\xf2#\xc4\xe9\xef\x08t\xe2n\xda\x86\
n\xc0\x98c\x92)\x17ee\x15\xa8K\x9f\xe9\x07@\
\x99\x15\xd8\x99\xc9\xf3\x9d{\xc3\x8a\xa5\x90\xfa\x11Mh\
\xd6\x07\x99\xde\xc6\x8b\xac\x9a\x8e;G\xa9\xf10\x07P\
V\xf9\xaem\xa5\x85\xd6\xd5}\xd0\xca\xd2G@\x85\x5c\
d)\x80\xf7\xf5\x8b{\xe8\x08`j\x0f\x80\xca\xfe5\
\xcf\xd4\xeaGN\xab#y\x8e\x12\xe0\x17;4k\x09\
\xb0\xb2\xed%\x0b>\xab\xc9\xee\x80\x11\x00\x02Vh\xf1\
wN\x91\xf5\xbf\xbab\x05\x02C\xed\xf4\xee\x82\x05\x0b\
\xa6\xaeY\xb3f\xe6\xec\xd9\xb3\x97\x8e\x1c9\xb2\x5c\x11\
[\x9d\x01l\xbc\xaaX0X\xcc\xa7\x99>W1\xe2\
?\xc5\x84\x9a)v\xd1\xc4\x1ck\x15X>\x9c\xab\x95\
\xa5\xd2Hl+k\xa6\x19\xb8\xb5r\xf7\x1a\xaf\xfa\x8e\
\xf4\xc9\xb7\xdcr\xcbg\xae\xbb\xee\xbaO\xad]\xbb\xf6\
\xf8\xb1c\xc7\x96\x0f\x12d\x8a\x9a\xfc1\x11\x0a\x1d'\
\x9eb$\xd2a\x04\x98\x85`D\x8b \x02\x07B\x16\
\x81\x01,\x84\x9d\xc5c\xf4\x22\xd8\x09\x1ez'A\x5c\
\x1f\xf5\xd6\x93\xe2\x97\x82\x91\xa3\x5c\x98\xe2\xca&<\x14\
\x11\x00\xe6L\xf4\x9c\xfe\x19\xeb\x84{C\xb1\xd5\xcb\xa2\
\x01\x94\x94\xd4\xe6QmA\x1b\x90@\x07e\xc9\x96\x05\
\xe5R^\x8a\x0f/\xe3\x88\x00\x00 \x00IDAT\
\x08\x10\x94\x9f\x93X\xb5\x8f\x22\xa8\xc3{F\xe9\xac'\
\xe1\x92\xe1\x0d\xc5\x8d\xfbB\xa9\x08sN\x95@\x97{\
\x04]\xdb\xb2\xc8O[\xf1\x19o\xe2\xc6T\xe3\x06Y\
^\x80F\xed\xca\xcc\x972\xce>\xeb\xecb\xda\x8ci\
\xc5\x9e\xdd{\x0e\xc6\xbe\x12\x5c\xcd\xd1\xd1\x94\x1e\xaf\x92\
\x9a\x84B\xaa\x17\x7f\xb4\x15\xef\xb4\x17\xdd\x14\x15\xbf\xd1\
\x90\x01H[\xb32\x1b\x1f\x94\xe394\x00b\x16D\
\x80(q\xa0\x81\xca\x0cR\xacE\xfd\x044\xf0\xca,\
\x942\xf1\x5c;\x00\x11\xd0\xcf*o|\xc8\xfa.<\
\xd4&\xbc\x8b\x95\xa4,\x03\x8b\xfe\xd2\x9fb;Y\xe0\
\x99E\xa8d/)o\xc9L\xcea3\x98jK\x16\
\x8d\x92?\xbc \xc7B\x0a\xde3P\xf6\xf7\xf7w\xdc\
u\xd7]\xc7\xaeX\xb1\xe2\xe4c\x8f=v\xdb\x91G\
\x1e\xb9\x1c\x0e\x0d\x06B\xad\xee\xb7\x0a\xe1\x1cJ\xefK\
\x10j\xa6\xf0\xbf\x0c\xc04\xbe\xdf\x8c\xb0\xc1\xfen\x16\
?j\x05F\x8d\xbf\xb7\x02\xc9\x08F=`9\xe3\xfa\
\xeb\xaf\xff\xc2\x0d7\xdc\xf0\xe1\xad[\xb7N!P~\
\xa3\x98\x02\xd0\xc9n\x98\x95\xb4\xca!\x0cFp\x82\x92\
D\xf3;zv\x14\x07\xfa\x0f\x1cT\x1c \xc4\xfaI\
Z\x0c\xc2\x97|\xc39\xbe\xc6e\x06\x8dIL\x11\x08\
x\xa6\x92\x93t\x8ap'a\x15\x17\x06\x08dOW\
\x12\xbf\xc7\xb5\x88\x85@\x89\xb8P@B\xdc\x850[\
\x06\xa0\x0d\x04U\x99f\xa8\xe4<N`\x97\xd2%y\
\x18\x01\xa5|,#\xb36x\x01\x80\xb8\x89\x9ea\x01\
P\x0e\xed\xd3\xf6\xe4\xf4\xf1\xf1\x0e~\xb9\x9f\x00\xba{\
~\xcb\xcem\xed\xd2&\xa3~2\x04&\xfd\xac\xb6\x07\
\x84\x00\x19Z\xfd\x8e_\x99-K\xdaZ\x16\x1d\x80\x7f\
z\xe9\xd3\xc5\xee]\xbb\xcb\xfe\xa0\x80I\xb0\xa6<\xf5\
SL@\xa8/\x92E 3u\x9eS\x8f:\xf0X\
\xd9\x14\x16]x\xa6\xcd\xd9\xcf\xe7]k\xa8r\xda\x06\
\xab/\xa7a$\x0fQim\xd5\x8a\x83.r\xac?\
\xca\x8e\x97\xd5\x98\x12>\xf8\xe8\x8b\xc4\xb9\x227y\x9f\
\xac\xc4\xd2A\x9b\xe9|\xfd\xeaw}\xcfr\x03^Y\
q.\x8e\xe4o\x96\xadA'\xb9\xc1\xb3{^\xbd\xde\
1\xb8\xa87\xf1\xb9\xb8q\xda\x8e\x86\xcc\x84\x8e\x1e=\
\xba\xed\x89'\x9e\x98\xf1\xe4\x93O\x9e9}\xfa\xf4\xfe\
I\x93&-\xb1+\xa9U\xcc\xf6pt\xbf\xd5\xd5\xcc\
\xcbj\x99\xca\xe3p\xae\xc6\x99\xaeF$\x1c,\xca~\
8\x846k`S\x97\xaf\xe6\xdfs\xdf\xabS\x89u\
\xeb\xe3\xb8\xeb\xae\xbb\xee\x0b7\xdf|\xf3{\xb7m\xdb\
6V\xa7\x12\x04#?\x014\xd2\x19\x85\x80\x91\xe7\x09\
\x94\x8eb\x01\x01\x02\x9dJ\x08-4\xec\x1a\xd6U\xac\
\xdf\xb8\xbe\xec\xec\x9c\xe8I!\x8c,\xccf\xc2L9\
\x09\xb0\x0e'\x04\x00\x85\x82\x18\xb1)U\xa6\x84\xb3(\
P\xdd\x84\xc4{Y\xf8H\xd0\x81\x992(Ff\xd0\
r\x0aD\xb6I\x00\xa1\xe4\xca\x11\x7fJ\xa2s``\
W\xb7x\x83\xb2)\x04!\xcc\x19bY\xe8\xa7~\xcf\
\xb2\xa02SC\x09\x00\x8a6\xe0\x93{Y\xe3\x83f\
3|9>8.Z\xce\xfd\x02:\x80,S\xf0\xf8\
D\xb9\xd1\xc92D\x1bW\x07\x0dI\xce\x8f\xbfbh\
YEnT\xd76\xe0\xa6\xaf\xb2b\xfa\xd6\x1f\xddZ\
\xbe/\xae\x91\x83\x13\xf5\x8b\x8fv\xe3W\xb6\xa5$\xa7\
7\xf9\x00\x9e\x82\xff\x00B\xffP:K+\xfc\x8f\xdf\
\xdcR\xee4\xeb\xb1V\xcf/\xad\x0eJ\x9a\x15\xe4,\
8\xed\xd7\xcf\xe8W\xfe\x94\xc9\xcfYw>\xeab\xf1\
\x9a\xa8\x00\x0a\xda\x9a\x8d\xb6\xf8\xa3\x1d\xc0\x13pf\x86\
K\x1b\xb2\xb2=\x93\x09\xd5- ~\xc3kn\x95\xc9\
\x0d|rp\x02\x9a\xb3%\x87ly\x9e\xdb\xac\x8f\x81\
\x06^gm\x14\xb0R6\xb0\xc2/\xb4k+~\xb1\
\x94\xb8\xcb@s\xe4\xc8\x91\x03\x1d\x1d\x1dm\x0f?\xfc\
\xf0\xf8\x85\x0b\x17\x9ef\xa6\xf8\xe8\xa3\x8f^l\xee\xa3\
\x0aD\xad\x02\xd5\xcd\xf4\xb5U,\xa8\xd9s\xe5\xde\xb1\
_\xd5\xeaiUi+k\xaa\xd1\xc2i\x86\x8a\x8d\xcf\
\x17M\xc0\xac\xd9\xbb\xd5\xba3[\xb1c\xc7\x8e\x13\xaf\
\xb9\xe6\x9a/\xder\xcb-\xef\xda\xbd{\xf7\x98l\xba\
\xd4!:6'.0s)\x1e\x81\x00@W^y\
e\xf9?a\x03\x04F\x0cg\x88\x9d0\xfb\xb9s\xcc\
c\xdas\x9d\x08\x13\xe1\xcc> \xa3\x97Y(\xebQ\
\x00FFB\x80\x94\x8d\x86Q\x92j\xb0\x99P\x01\x0a\
e\x0b,+O]\x00\xc3o\x14\x95\xc5\xa3\x8c\xe4_\
F\xaf\xb5L\x5c\x0c \xe8\x19\xff\x9bE\xa2\xd0\xb2\xf4\
\x09D\xb3\x16\xb4;.\x0f\xe5\x00\xb8\xc9kC\xa8\x09\
4\x1aY\x0b\x89s$V\xe3\xd9\xac\xf4\xcd\x1e6V\
\x99\xfa\x086\xa1w\x0f?(\x19\xc5\x06x\x94\x99b\
*\x8fb\xb2\xd6\xa24\xc08y\x95\xfd\x9e\x80q@\
A\x9d\xc9\x97\x83_\xda\x8b~.\x8d\xf6\xa8\xc7w\xe5\
\xb0\xber\x9aI\x8e|fId\xf1  \xb4\xde\x07\
 \xa3\xd3s\xfaD\xbb)~r.\xfb\x1b\xe8h\xb7\
\xf6\xe3\x0f\xfa\x94\xedwm\xd0?\xfa\xdb;\xc9}\xfd\
\xf8\xe2\xc7K\xe5\xc7\xc3r\xd7:+i\x7f\x7fyV\
E\xff\x81\xfe\xa2\xad\xfd\xb9-?\xdaE\xae\x00;\xda\
\xd1\x9a\x9cK\xe8\xf4;\xd0\xc9\x91@xN\x86\x00h\
\xb2`\xe2\x09\xbe\xa2\x0d0\xa1-\x0b\x19\x0d`\xf8B\
.\xb2R\x1c(\xfa?\x99<\x93\xc3\x9a\xb5g\xe0\xf3\
\xdb\xde\xbd{k\xdc\xbd\xf3\xce;\xaf6l\xd8\xb0#\
\x1ey\xe4\x91\x93\xda\xdb\xdb\xf7\xcf\x9c9\xf3\xf1Z\xad\
\xb6\xa7Y\xfc\xb7\x99\x1e6\x0bN\x0f6\xc3\x96\xeb\xe0\
\x06\xd6f\x8a\x7f\xa8\x18Mc\xd4\xbc\x99K\xd5\xcau\
j\xbc\x1aA\xa5\x95\x8bU\xablIhU?a\xdd\
\xb4i\xd3\xa9W\x5cq\xc5\x97\xee\xba\xeb\xaeK\xfa\xfa\
\xfaF\xe5T\x03\xa3\x9bQ\x80R\xea\x5c\x81\xd8\xac\xe4\
5z_~\xf9\xe5\x07\x0f\x0b\xd4\xb9\xd9\x11\xaf\xc3\x08\
n\x14\x80\xf0RH\xc2G\xd1\xec\xd1r8\x1da#\
\xa8:<\xd9\x0a\x8d\xc6\xca6\xf2$EiQ\xdf\xef\
\x14w$\x96[Lj\x0aN\xc0\x08\xa8\xf2\x09#E\
\xcd>\xa0\x1c*\x98\xb4\xa7\x94\x14\xbdq\x1f\xfd\xee\xd9\
\x98\xff9w+\xab\xaf\xb3/\x8a\xd2sy\x94\xa5]\
\x80.\xab\x87s\x1cs2(\xb2\xba\xdcG#\xfeQ\
F\xca\x92U\xce~\xe7*RX|\xe0^\xb1>\x92\
y t\xa8C\x1b\x00\x08e@+%1\x95\xec\x8a\
\xc5\x16E\x01*\x99\xfa~\xe8\xa1\x87\x8b\xd1\xa3G\x95\
\xfc\xcaL^\x8ed\xc6c\x80(\x96\xe7\xbb\xf6\x02 \
Vb6\xe5\xa2#\xf9v\xd0\x82f\xed\xa4\x9c\xc0\x19\
\x10\xe9'@\xcfm\xd4\x17Y\xc0\xea\x1e\xda\x12X\xd7\
\xf7f!=O\x8e\x92y \x89\xe2\xea\xc6y\xd1\xb7\
\xef\xb9\xa5\x0e\xc0\x0f\x8f\xf1\x85\xd5\xa6\xbf\xcc\xa0\xe9\x03\
\xed%sd*\xab\xf1\x01\x92A\x90%\x98\xc3\x0f\x95\
\x8fO\xee++\xeb\xb2\xf0?'\xb8\xe2y\x12\xf6\xa3\
)2\xa6\xfd\xd9L\x9c\x98d\x96\x5c\xd0\x0b\xfc\x16\xb3\
\xdb\xbe}\xfb\xe8\x87\x1f~x\xd6\x94)S\xb6O\x9c\
8qq\x7f\x7f\x7f_\xe3\xe4T3\xbd\x1c\xcc\x8b\x8a\
~7[j\xd2\xfe\x97\x7f\xf9\x97\xff\xe1\xc1f\x8a\xdf\
\xf8\xbd\x955\xd3jz\xae\x91\x98V \xd6\xf8\xfdP\
\x7f7\x96\x1f\xd3v\xf5\xea\xd5/\xba\xe2\x8a+\xfe\xfa\
\xa7?\xfd\xe9\x9bk\xb5Z70\xc8\x91-:\x96\x22\
\xf1\xf7\xc5O|\xd7AFef\xbb\xce\x96\xdf\x85b\
%&\xc3\xc5\xf0w\x16z\xe5\xb8\x1a\xe6\xb5\xd1\x07\xb8\
\x99vV\x07\xe0\x00P\x04\x00x%hM\xa0\x09\x07\
\xe1\xa7\xb8\xb1\x02\x92r5\xb3_\x99\xdd\xc9T\xb1\xf7\
\x08\x1fEV.K\x87\xa0zN{\x22l\xdcE\x96\
\x14\xa1\x22\xec\x14\x9b\xa0jg\x0e\xd5\xc3\x9b\xac\xbdQ\
\xa7m\x03\xb5z\x1e\x1e\xf5hcf\xa3\x08$e\xcd\
\x02J\xa0\xe1\xca\x19\xeaYgbT\xa6@\x14\x92U\
\x94\x95\xbfFl\xed\x03\xf8\xf8\x93\xbd]hI\xc2y\
V\x03`B\x07\xd0\xf07k#\xeb\x91\xfc\x96\xf8\x9c\
\xff\x81e\xb6&\x00\x07\xbf'\xe8\x8d7\x5c\x0bt\xa0\
\x11\xcfj\xf5M\x9f\xe8\xc9\xf4\xb9\xff\x81\x19^\x03\x17\
\x0a\xcf-\xc73\xcaN\x19\xe3bi_\xdch\xa0\x90\
s\xddXI>\xacAt$~\xa7><K\xa6\xc7\
\xc8y\x96\x22\xe0\x8d\xb2\xd1\x88\x9f\x06\x10\xe5\xd8\xf6C\
F\xfd\x06\xd8\x0d<\x9e\xcd6\x0dV\xbb2\x0dL\xee\
\xe7\xd4\x134\xa9/1\xb0\x1co\x9d<\xd7\xdeEC\
\xac0\xf5\x99\x9d\xd4V\xdf\xc9?\xda\x0cZ\x9e\xe3\x8a\
\xe64\xd9\x13N8a\xc4\x82\x05\x0b\x8e\x9c2e\xca\
\xca#\x8e8bi\x16\x80V\xf5\xb2\x95\xe7r8\x9e\
U\xf5\x99\x8eC\x81A\xab\xe9\xfa\xc6\xef\x8dD\xb4*\
\xb7U=\x87\x22\xbc\xd9\xef\xcd\x82\xd0O?\xfd\xf4y\
W^y\xe5\x97\x16.\x5c\xf8\x9a\xe1\xc3\x87w\x12H\
Bg\xb4brr\xa3\x08\x1e\xe5\xc9.v\xc2\x07\x80\
\x8c\x14\x1f\xfb\xd8\xc7J\xc1\x060\x04\xc3\x08\xe8\xefj\
\xfd\x9e\x03V\x84\x8f@(+\x89\xd3\x8d\xac\xc0J\xbd\
\xca\xa6\xc4\x99E\xd3\xf9F&\xc2\x9d\xd35sJj\
\xf24{\x9e\xa2\x1a\xa9\x94\x9d5CV\x5c\xa3;\xab\
\x92\x13\x00'\x5c\xd9\xb4\x19+\x08\x98\x00\x11\xf4S4\
\x8aD\xe8YT\xea\xd6\xee\x1c\x1c\x98\x13%\x925\x92\
{'\xf6@H\x8d\xfc\x14\x03hP@\xefQ<\xfc\
\x12'\xa1\x00\xd6\x1a\x01\x10\x00a\xb6\x85\x15i\xf1\x1c\
\x00\x04n\x14\xc5=\x02\xae\x1c\xa0\x8f6\xca&\xadE\
V\x19'\xa1{f\xd8\x22?\x89\xfd\xe4\x10I\xb1\x1c\
<\x91\x94\x0bH\x03CmC+\x05\x1b\xa8\x1fP(\
\x1e\x96\xe4kqA2\xeb\x98E\x98\xda\xe2~&\x08\
X\xb3x\x8cO\xde\xc9\x99\xfb\xca\xd2\x1fx\x0ch\xb9\
8\xea\xf0\xf7'>\xf9\x89bX\xe7\xb0\x83\xf9\xaf\xb5\
\x8brg\x1b\x09\xfa\xb3v)\xf9\xaf\x8b\xfa\x8c\xad\x01\
\x84e\x95\x85\x84\xea\xe5\x8ag\xd5z\x0e|\xd4\xaf\x9e\
C\xb3A\x08Heq\xa32\xc8\x12p\x8eu\xa7-\
\xe4\x08MYb\x90\x83\x14\xdc\xb7\x13\x00X\xa1\x15X\
\xab\xdf\xdf\x01:\xfc\xbf\xec\xb2\xcb\xda:::N\xb9\
\xeb\xae\xbb>\xf4\xd6\xb7\xbeu}ww\xf7\xa3\x8d@\
\xd4\xea\x1a\xcce\xab\x82\xd7A\x90\xae\xc6\x84\x0e\xe5>\
\x1d\xcel\xd7/s\xb5\x9a\xd2;\xdc\xab\x1a\xff\xe9\xe8\
\xe8\xa8=\xf1\xc4\x13\xe7_y\xe5\x95\x7f\xbd`\xc1\x82\
\xd7twww\x10\x16\xc2c\xb4b\xbd0\x99\xb3Y\
Q\xfc\xc6{:J\xc7S|i-\x08\xb9X\x02\xeb\
\xa7\xa8\xaf7\xa14\xe9`\xcf1\x9fsD\x8e\xb2s\
\x140\xe1N\x80\xd5'Y\x03\x03\x10\x9e\xa7t\xd9\x90\
\x98\xf5%\xe8H\xbaM\xa3\x16\xa5 d\xda\xe6\x1d\x96\
\x80rXC\x02\xa8\x99Z\xf7L\xde%\xec\xca\x02\x82\
\xcck`\x13es\x1fP\x86N\xa0\xc1e\xf1\x8ev\
fc\xaa6\x01\xec\x9c\xb2\x01\x1c\x08\xb4\xf2s\xe2\x83\
\x11\x18\xc0f;\x03\xa1\xf5\x0e\xda\xd0\x03\xd0(\x06\xc1\
\xa6x\xac\x13`\x91s\xe0\xf1\x932\xa2\x83E\xe0]\
\x89\xf9)\x0bP\xd0\xd6\xe4\xf0N\x92v\xe5e\xa6.\
\xc1b`\xa0\xef\xd0\x84\xd7~\x17\xb3\xd2&@\xa3\x0f\
\xcdJ\xea;\xca\xa7\x0f\x004\xf0\xc5\x1b2\x07p\xd0\
\x0cP\x0d\x1c\xda\x94\x95\xeb@\x18\xf8\x037\xfcR6\
Pu\x1f\xc8z\x8e\xa5\x9b\xbdj\xea\xc7c|s\xb6\
\x1a\xd058$`\x0f\x88\xf4Ebn\x00[?\x93\
\xc7\x1c\xc1-\x14\x00p\xd5\x83.\xf7\xb3\x96\x8bU\xa4\
\xad\xda\x87?\xcap\xdf=\xf4\xe7\xc4V\x7fko@\
\x95%\xaa\xaf\xfdF\xfe\xc9k\xf6\xdb\xb1T\x93\xceW\
?\xf8\xeecp\xda\xbf\x7f\x7f\xfbYg\x9d\xd5\xb9}\
\xfb\xf6)\xabV\xad\x1ay\xec\xb1\xc7>V\xab\xd5\xb6\
\xc72n5!\xd5J\x7f\x07\xf3vJw\xacq\x96\
\xab\x11d\x0e\xde\x1fx\xce\xcfm|n\xb0\x0a\x1a\x09\
\x19,\x90\xd5\xaa\xcc\xc1\x1aL\x09k\xb5Z\xc7\xfc\xf9\
\xf3\xdf\xf0\xado}\xeb\xaf\x16-Zt\xe1\xe8\xd1\xa3\
\xdb\x99\xf6\x80G\xa7b\xb8\x0e\xa0@Ft\xe6\xad\x8e\
0\x12\xe4\x1c'\xca(xi\xa4a\xde2e\x09P\
5\x87\x0c\x81\xa08\x14\x86P\xf9nT\xf9\xc8G>\
R*?\x0b\xc2sI\xdd\x99\x0d\xa8:-\xa0Eh\
\x81\x02a\xe0rqE\xbc\xab>#9\x80!T\x00\
\x8a\xc0\x13\x0a\xe6:\x0b-\xee\x16ACs\x16\xe4\x11\
L\xcf\x1a=\xe3\xf7g\x06)\xab{\xf1\xca\xa8\x9a)\
r\xcfS\x02\x02\x88\x0e\xcaM\xb8\x13473C\xe9\
=C\x89\x926\x14\xb8\xa0\x1d\xcdI\xc6\xae\x0e\xcaG\
\xb9\xf1Ly,\x01\x8a\x9d\xb3\xce\xbc\xaf\x9c\xb8\x83~\
\xcb\xd6\x02uz\x17H\xe2\xbd>J\xacK;\xe3\xb2\
\xe2\xb7Y?\xfd\x88G\xfa\x01O~\xf7w\x7f\xf7\xe0\
\xa9\x18@G\xdf\xe4\xa8\x1bVE\x00T\x9d\x14L=\
\xfe\xc6{\xfc\xd6\x0e\xe5g\xb1\xa3r\x02R\xfe\xd7\x06\
\x0a\x1b\x8b\x1b],\xba\x9c\x1f\x0f<\xb9@\xac\xbf\xac\
\xe6\xce\xba\x9fl\xaba)\xa27;\xf3}\xf7\xd1\x1f\
6\xf2\xe6\xd8ir\x8b\xbf\xda\xac>m \x7fh\xce\
\x84D\xdco`\x93C\x14\x03\xfax\x8c.m\x10\x9b\
\xd3/&I\xc8<^\xf9\x9b\xac\xe3\x17`\x03\x98\xb1\
\xa4Xb\xea\x06\xea\xf5\x93Y\xdbg\xcf\x9e\xdd\xf5\xec\
\xb3\xcf\xce\xe8\xeb\xeb\xeb\x9d1c\xc6#\x07\x0e\x1c\xd8\
W4\xf1\x90\x9a\xe9l\xe3\xff\x8d\xe1\x9e<sp\xdb\
\xc6\xa1\x02O\xe53E\xf3m\x16\x87r\xbf\x0e\xe5\xf2\
\x0dT\x16}\xb5*\xb7\x0a\x86\x99Q\xaa'??b\
\xde\xbcy\xef\xbe\xf2\xca+?\xfd\xe4\x93O\x9e\x98\x99\
\x9eX\x02\x84^\xb0\x8d\x92\x11\x14i5\x01\x83\xd9\x08\
\x1d\x9d\xc3\xe3\xec\x80&h\x04\x98Ed\x84w%\x9e\
@\xf0}\x92\xfd.i1)\x03\xa1\x8c\xa2$p\xec\
\xfd\x1c|G@|\x08\x0d 2\xaaR2\xcf\x03\xac\
\xec\xa1J\x9b\xb3\xa0,\x0b\x01\xb5)\xfb\xd2\x00J\xe2\
\x0cQ\x0a\xa3\xb2\xb61\xb9\xd5\xaf\xac\x81\xfa\xccV5\
&\x11kM;(&S\x1c \x12\xc6\xac=B\x9f\
\xf7\xd1h\xc4O,\x81p\xc7\x02BO\x92\xf7\xc7\x12\
\xc1\x0f<\x00^\x89o\xe1\x1dE\xd0\x06\x82\xce\x82\xf4\
A\x17E\xe1\x0a\x12z\xf7\xb2\xe0\x11\xf0QX\xcaF\
y,\x95P7PeI\xb1`)Q\xf6\xf2YS\
\xa3\xfd\xac\x9e\xa4y\x05\xdc\x5cU\x0a\x8e'\x96_\x04\
\xec\x8a\xfa\xde\xb4$\x99\x03\xb2YxX\xab\x9f\xe3\x85\
ve\xe2S\xac%\xae\xb1\x99\xc4\x1c\xcfm\xb0\xc2\xbb\
\xea.x}\xec\xd9X\xb7\xca]\xb2\xe4\x89\xe2\xc1\x07\
\x1f*\xe5\xcd\x00\x91\x95\xd5x\x90\x5cRx\x14\x80\xd1\
6\xee\x5cV\xac\x03N\xe0\xa2_\xb4K<\xcc3\xde\
\x07\xa0\x00P\xbfe&\x0f-\x06\xb3\x9c\x0a\x1b\xd7\x99\
\x85\x0f\xb0\xf4Q\xd6{\x15\xf5\xc3\x0e\x94\xaf\x9f\x01\x97\
\xbf\xf5)\xde\x1b\x0c\xae\xbb\xee\xba\xf6\xd3N;m\xda\
\xbcy\xf3~\x7f\xe2\xc4\x89O\xcc\x9c9\xf3\xc6={\
\xf6\x1c\xdc\x8ap(\x8b\xa8\xd9\x04U\xe33\x07-\xa1\
f\x96I5\xea]}\xf9Wu\x9f\x1a\x9f\xaf\x12\xd2\
j\xc7m3\x13/\x02u\xe0\xc0\x81\x09\xf7\xde{\xef\
\xc7/\xbf\xfc\xf2?\x7f\xfa\xe9\xa7g\x11b\x96\x0b\xd3\
8Y\xf6\xcc(\x116\x01d\xd6\x10a\xe1~\x11B\
#R\x96\xe7\x17\xf5M\x9f\xd6\x90xW'\x18Eu\
&%a\x05x>S\xf2\xd9AM\xe9\xb3\x05\x82\xe9\
+@MA\x08\xa3r\x08oFv\xe5\xa7\xac,\xe5\
\xf7>\xf7!g]\x11J\xeb;\x089\xc5\xa4x\x04\
,\x19\x0e\xd3'\xd5#\x92(t\xad\x9eS\x1a\xe8\xe6\
\xf8\xe9\xaa\xe9\x9cEu\xca\xcf\x19`@\x05mE}\
\xe1%\x9a\x80\x0f\x81\xa7\x04\x84\x9eU\x836\xe5\x12P\
\xf4\x02a\x02\xcd\xcdJ\xeee\x0a\x9b\xa4h\xf6w\xe1\
\x05\xab$\xc9\xd6\xb2\x80\x11o\xb4W[#G\xcaP\
\x1f%p\x01T\x00\xa3L\xdf\xd1\xaa\x8f\x80I\x82\xd9\
\x91%\xca\xa3\x0d\xac\x0ae\x98m\xd2Gx\xeb\xc3z\
\x8a\xf5\x99s\xd1\xe2\x8ah\x13\x05\xcd\x9e\xa9\x94\x89o\
~\xcbbG}G\xd1\x03\xac@2\xf17\xae\x932\
\xc8\x09@\xd2g\xeay\xee`\x80\xe7\xe2M\xf8\x80_\
\x5c\xc8\xf0B\x9f\xe2/9\xc2/\x96\x15\x9a\x808P\
\xf7w\xe4(\x8b0\x93\xa8_\x9dI\xad\xeb\x19\xbc$\
\x7f\x06\x85\x9c\xe5F\xbe\xcd\xa2\xf9M\xb0_\xbf\x00%\
m!\x97\xfa\x99\x9c\x00T\xfd\xa6m\x7f\xf4G\x7ft\
0@\x9e\xc1&\xcb\x1dV\xae\x5c9a\xf3\xe6\xcd\x13\
O?\xfd\xf4E#F\x8cX\x97L\x00\xadt\xbb\x99\
AQ\xbdW]\x7f\xd4\xd1\xf8\xe2`A\xe4C\xb9`\
U\xf0jvh_3\x02ZE\xd9\x9b\x81O\xeec\
\xd0\xfe\xfd\xfb'\xdd~\xfb\xed\xff\xe7\xdak\xaf\xfd\xe4\
\xb2e\xcb\xc6a>\x00\x22l\xc9-l\xc4\xd0y\x14\
\x1a\xc3u\xc4?\xfc\xc3?\x94Bl\xb4\xb0\xbe\xc4\xe8\
\xc5\x1a2\xd5J\xb8\x08\x0d\xe1W\x8fw\x02\x1aF'\
\xa3cN\xc8\xc8!~\xae\xe4\xb9\x01Rh\xcc\x9e\xa2\
\xeaq=\x82\x96FU\x02f\xe4\xa3\x18Yq\x1c\xa1\
gM\x10\x12\xbfi\x83r}\x07\x94@4g\x89e\
3i,\x1c\xc2G(X\x1bF5\x0aK\xd0\x93\x1c\
+S\xf3h\xd16J\xaf\x9d@+\xa68\xfas\x94\
3%V\x0e\xc5aQ\xb02\x12\xfb\xc8\x89\x18I\x1e\
\xa6lB\x8a\x86?\xfc\xc3?<\xb8\xd3\x9c\x85\x93\xd5\
\xd6\x14\xc6;\x94)\xe6\xbe\xbe\x02\x88\x94\xcao@'\
K\x01\xf0\x09-x\x9e~U?z\xf1+\xc1}\xcf\
\xc4u\xc8V\x0c`\x14\x0b0\x1bI\xf5_\xf6k\xa1\
\x13p\x01Z\xe5\xe6\xd0\xc6\xa2\xc1\x22\xcf\xa9\x19\xd9\xb1\
\x8e\xa7\xda\x9a5L\xacH\xd6\x0d\x90N\x128m\xad\
\xf6\xf9\xee\xdd\xbb\x0a\xa2\x0d\x8c\x5cb_dW\x06F\
\x16\x09>\x0b\x01dK\x8cu]_\xf9\xcaW\xca\x80\
\xbd\xdd\xf39\xb1#\xb3\x9a\xca\x06\xd4\xac\x1a<\x02\x18\
\xc0\xaaz\xae\xbd~\xe6\xb2\xeac\xf7\xe4\xabJ\xf6E\
rNf\xf14Y'3\xeb\x08\xbc\x81\x96\x99a@\
Ow\x0c\x9a\xe4\x00\x9d\x8b\x17/\xae=\xf8\xe0\x83/\
\x9f5k\xd6e\x97^z\xe9\xf2\xce\xce\xce\xadU\x0b\
\xb2\x8a\x11\xad&\xa8Z}/-\xa1F\xf0i\x16\xdd\
n\x5c\x9f3\x98O\xd8\xac\xb2\xc3\xf1\x17\xab\x84\xb7j\
T=\x9e0\xed{\xdf\xfb\xdeg\xae\xb9\xe6\x9aO\xae\
Y\xb3\xe6\x08#:E\xa1\xb4\x04\xcfh\x87\xe1\xee\xb1\
h\x92\xaa\xd4\x0c\x13\x86::\xc6(D\x10\x04\x17\xad\
[\xc9.j\x9d\x05xt:&\x132#\x0f+ \
\x0b\x06u\x8c\xe7\x04\x17\xd5\xcd\x22\xc8B\xb8\x04G\x13\
\x87!`\x94\x80\xc2e\x95+3:;\xf0\x13\xc7\xc8\
&V4'\xf9:\xcb\xcd\xef\x145i32\xe3\x96\
\xfdl\x84\x8a\xa2Pt\xb4&\x03d\x00)\x1b;)\
1\x9a\x8c\xb6\xda\xc2\xaa0bRN\xc2N\x99)\x1a\
\x9a\x02\x04\x00\x85\xe2\xe4\x88\xe3\xb8\x96\xda\x8a\x16e\x02\
M\xf4(\x0f\xdd\xda\xe5=\xa3\xae\xc0i\xceMW\x87\
\xbf3\x93\x96s\xbdr\xaa(\xa5\xa1\xd4\xca\xa3d\x1f\
\xfd\xe8G\xcbzX\x14b*\x06\x17\x83G\xdc\x09\xca\
\x8c&\xdf\xf5\x1d\xdeQV\xae\xb7\xbas\x1a\x89{\xf8\
\xe7\x7f4\xe7\x0c2`\xc8JN@\xb7*o\x19\xc4\
X\xbc\xe8R/0F\xb38\x92{IO\xa2\xecl\
P\xce\xecf\xe4\xd9\xdf\xe8|\xe0\x81\xe7\x0e\x924H\
\xa5\xef\xf4+~\xa25\xa7\xc2\x02PV\x95>\x02\xec\
\xf8\x9e=f\xe8\xc5\x9f\xc4\xf8\xbc\xa7l\xb2\x97\xedA\
\xfa\x99\x1cx\xd6\x00\xaa?\xf0\x08\xffr\xb6?\xab\xb1\
\xbaa\x17M\xe4\x11\xb8\x93m2\x0b\xdc\x12\xa7\xcb\xa0\
\xfa\xd6\xb7\xbeu`\xd2\xa4I\xb5'\x9f|r\xf4\x88\
\x11#\x96\x1c}\xf4\xd1O%4\xd0\xccxi\xa6\xbf\
\x8dx\x91\xbf\x0f\xae\x13j\x06\x1a\xcdb9U\x17\xad\
\x9a\xbe\xa3Y\x05\x8d\xa02\xd8t\x7f\xf5\xf9\x81\x86\xb5\
Iy\x8f\xd0\xef\xdc\xb9s\xc6\x0d7\xdc\xf0\xf9\xeb\xae\
\xbb\xee\x0f\xd7\xaf_?\x02\x93\xb3`\x0d\xd3\x98\xa1\x9e\
\x03.\x00\x88\x05\xa1\xd3s|\xb0\xb4\x0a\x9ea\xd1X\
\x1fB)\x08\x91X\x03\x05\xd7\x81\x84/i12\xdd\
j\x945RPz\x02*X,\xa6A\xf8\x81^\xf6\
\x8bUc6\xd9\xbe\xa0\xbc(2\x90\xca\xfa\x97\xa2>\
\xcaq\x19\x04\x08\x09\x84t\xb2h\xa5@\x5c\x9a\xccZ\
\x10$\xb4d\x0b\x05\x81r\x0f\x08RP#4\xba\x80\
\x9c`q\xf6\x7f\xe5\xff\xec\x8c\x07\x86\xca\x8d\x12PB\
\xc0\x12\x0bA\x0c\x81\x80g\xa3l\x5c\xa8\xc4\xa32\xd2\
\x13Z<\xcc\x19`\x01\xaf\x9c\x13ot\xc6{\xf5r\
\x07X+,O \x91\xe3\x80(\x1a\x1e\xabG\x9f$\
\xa9Zv\xda\xb3\x0c\x13\xf3R?\x1a\x03r\xc92@\
A\xb3\xb2\xdd`Q_'V*\x1dZ\x94\x0d\xc8\x00\
\x07>\xa0\xd1lQ\x8ej.*iZ\xb3\xce\xcc\xb3\
\x5cV\xdf\xf5k6\xc4\xa2[\x7f\xaa3\xf1\xb0\x81\xfa\
\xfa\x9al\x00\x8e\xe5\x99\x5c\xe1q[\x0d4\xc9\xaa\xe8\
\xbb\xba3I\xa0O\x0c \xb1\x8e\x800\xdex\x9e;\
\x1e\xb0G\xb7>4@\x8a/\xe6\x88#t\xd6\x0fe\
(i\xd5\x1f\x02\xd7\xc0^\x9f\x01J2\xea\xb7\x0c\x04\
\xc0\x8e\x8e\xc4\x8a\xd3>\xcf\xa2#\xe7\xdd\xab':\xa5\
\x8es\xcf=\xd7\xc93#zzz\x9e>\xfd\xf4\xd3\
\xef\xcb@\xdb\x0c\x03ZM@5\x1a(\xae\xf6/~\
\xf1\x8bMQ\xaa\x15\xa0\x0c\xf6{c%\x8d\xcf6\xb3\
\xa2ZM\xeb5\xfeVO\x9dq\xac}`\xff\xf6o\
\xff\xf6\x91]\xbbv\x0dw/3>\x94\xcf\xe8O@\
)\x19\xc5u\xc2e.\xc2m\x86\x89p\xc8o\x03\xfd\
s\xae\x16\x00JBq\x0ahdQ\xa6N\xa4\x5c\x01\
\x09\xd6\x15\x01\xf2\x1e+\x05\xa0d]H\xd6\xf5$^\
\xa3cu>\xc5\x03~,\x1c@FP\xb2.%\x8b\
\xd3\x94M(\x04\xc7s\xe2h\x16\xf9\x11\xf4\x9c\xae\x99\
Y\x9d\xb8\xb3Y\xd1L\xb0\xfd\x0eP(\x03!T\x7f\
\x9e\xe3>PDBK\xa0)k\xf6]\x15\xf5\x1c\xd6\
\xda\xc8\x02\xccn\x7f\xca\x97\x93I\x93\xb0-\x8b\xf8\xf0\
6Y\x13\x13x\x06\xf4\x00\x89\xd2)+I\xd7\xf1F\
=Fq\x7f\xe3\xa7\xb8\x87\xe7\x92\xbe5\x09\xdc\xcc\xe0\
\xd4\xea\xfb\xbd2\xd5\x0cd\x93\x8d0Ac\xf4hg\
\xce\xd7\xa7\xa0x\x01X\x0d(h\xa1DY\x1e\xe1Y\
4k\xbb\xbf\xb9\x1e\xfa\x83\x82{6\x00\x94%\x18\xac\
\x1d\x16\xb5\xfe\xf0\x0ezs|r\x96\x00\x90\x03\xfd\x81\
\xc6\xccb\xfa;\xb1\xa7L\x1c\xe0\x85\xff\xbdO>\xc9\
\xa9A$\xc7i\xfb\x9e\xd5\xed\xca5\x08\xc4uR\xa6\
>\xe4>\x01\xdd\xac\xa4\xf6\xc92\x0a\xf5\xe3+P\xcb\
QB@\x5c\xb9\xda\x93\xa4xd\x8a,\xb2\xb2\x0cp\
\x06P\x17\xa0\xcb\xa1\x94\x19D\x80?\xd0\xc1w\xb4\xd4\
-\xb6\xda\x82\x05\x0b,\x83a5?x\xd2I'\xdd\
\x1d\x10jvjr\xd1\xc4\xe3\x19\xa8\xa4o)*a\
\x99\x8efH\xd6\x0a\xd5Z\x01P\xa3\x85\xd3\xca4\x1b\
\x0c\x9c\x1a\xcb\xcb\xbd\xfa\x86\xc4\xb6u\xeb\xd6\x9d\x00\x80\
~\xf4\xa3\x1f\xfd\xbe\xf4\x03\x18_?\xb0\xed\xe0,K\
\xb6\x08\x10h\xb3*\x9e1\xb2Px\x16\x06\x81\xba\xe6\
\x9ak\x0e\xae\xc5\xb1 1\x00\x92`!s\x96\x80Q\
B\x8a\xc0\x7f\x17\xb8\xd3\xa9\xcaf\xb2R\x02\x1d\xe4}\
J\x95\xf3\xaa\xc2\xcb\x1c\x00Hx=\xcb\xc2)\xea\x87\
%&\xfe\xa3],\x09\x1d\x9e4\x0d@\x8d\x82\x10\xf6\
\x8c\xda\xb1D\x08K\xf2\x1c\xc7\xcd\x03h\xea@\xbb\xf8\
F\xa6[S\x0fA\xcf\x22=\xc2\x13+H\xdd\xda\x86\
\x1f\x040\xc7\xc3\x00/\xe0\x90<<\x00\x1e P\x0e\
|\xa4H@\xdb3\xcc}\xedV>\xba\xbd\x9f\xd3E\
<G\xc1\x03pf\xb0LWS\x08J\x80\xf7\x94.\
\x0b-\x13?\xc2\x07\x80k\xef\x1e\xc5f\xd1%OQ\
\x04\x1d\xbd\xc9\x06\xe0#~\xa2m\xdcA\xed\xce\xc9#\
\x94\xc9sx\x90\xb3\xe3\xd1\xa0\xee\xa4S\x89\xd5R_\
\xe6qp\x00\x02f,\xdd\xa4\x7fM\xdf\xe1mf\xcd\
b\xdd\x18\xcc()\xe0\x22\x0fq\xfb\x80\x1d\xe0Pg\
\xd2h\xe4Y<*\xea\xf1\xb5\xc8\x03W^\xd9\xb1\x9c\
X\x1f\xda\xa0O\xb5\x87,$w\x90> wY\xcb\
\x06\xbc\x0d\x12\xf8\xaf\xef\xf4/p&\xcbq\xdb\x81\x9f\
6\xc8\xaa\xa0\x1d\xcaO\xde\xacd8\xd0\x97\xfe\xc6\x1b\
}\x16`\xf5\x9ev,Y\xb2\xa4v\xe6\x99g\xee\x1f\
7n\x5cor\x0e\xb5\x8a\xfbT\xffn\xcc[]4\
\xe6\xfaj\x06\x14\xcdPm\xb0Y\xb0f\x16Rc9\
\xad\xac\xa8F\x82\xab\xdf\xeb\x16E\xa7\x1c\xd0s\xe7\xce\
\xfd\xcc]w\xdd\xf5\xd6\xb6\xb6\xb66JJ\x01t\x9e\
\x11\x8d\xd0g\xbfWF]\xcf$\xf8\xeb~\x02\xd4\x04\
@\xfc#\x99\x07)K\x12i\x01\x00B.\xc0\xc7d\
\xcdV\x05u)\x83_\xaf3\xb8q@AGR\xea\
\xf8\xe9q\xc1tj\x02\xc9F\xa8\xcc\xb8$\xa8\xee\xbb\
M\xa6F=\x8a\xa6\x0d\x9e\xe1>\xeap\xc2:P\xdf\
\x1b5P\xdf\x85M \xb2J;\xc1T1*\xf4\x02\
0\xf5\x03\x83\x04\xc4c\x95\xc6tg\xdeS\xf4X\x08\
\xe8\x00\x02,/\x7f\x0b`\x02\x1bJ\xc7\x1d \x94F\
L\xcfQl\xe5\x1a\xd5\xd5KA)s\xa6\xba\x01.\
\xde\x00\xaeXd\xdeu\x9fkIi\xb21\x93\x22\xc5\
\xed\xf3\x1czX[9P\xd0\xdf\x14\x86[@\xa9\xb2\
U\x22\xf1\x96X,\xfa\x8b\xb5\x05\x10r\x18bbd\
h+*\xc9\xb9r\x22E\xb6i\xb8\x9f\xe3{R\xae\
\xb6e\x09\x06\xab\xd4=\xfc\xf4\x8eg\x93\x09\xc1w\xd6\
\x99\xba\xf1\xd4 \x96\xe4g\x06++\xc8\xc9\x8a\xfaX\
\xb9d\x81<\x01\xac\xb8\xfb\xd5\x13g\xb3\xa0\xb5\x9a5\
\x13\x1f\x01\x8f\xf6\x00m\x16=\x19Lb4\xbc\xe3~\
\x02\x08\xb13e\xeaGu\x00\x1e\x03pR\x8e\x00\x1a\
\xb4\x90!|\x02\xb2x\x8bV\x03\x89\xfb\xfa\xcco\xea\
U\x96\xff\xdd'\xc39eD\x1f\xd4W\xb4\xf7\xf7\xf7\
\xf7\x0fT\x13\x9f\x0d\xa6\xcf\x8dX\xd0x~aQ]\
'T\xbd\x1aS\xb56s\x9b\x9a\x05\x9c\x1a\xdd\xb1f\
fZ#A\x8d\xc4\xe6S\x1f\xc1\xbb\x9fz\xea\xa97\
^q\xc5\x15\x9f\xfb\xd9\xcf~\xf6\x12\x0a\xa5#\x00G\
2\xfb%\x18Gpt8\xeb\x22\xcb\xdd14\xf9\x9f\
u\xa6\xd1\x8a\xa0\xeb\x00\xc0\xc5\xdd`\x05\xc4\xd2`\xae\
\xea<\x9dl\xe4a\xc1(\xdb\xef\xca4\xeb@\xc0Y\
\x05\xca0z\xc5BH<\x81\xa0\x02\x13\xf5s\xe7\xb2\
\xed\x81\x92\xe8D\x8ae4\xe26\x18\xc1b1\x00Q\
nI\x8et\xa1dY\xb7\x92\xf3\xde)\x98\xfa(G\
\xce\x8e'\xe0\xca\x05R\xda\xe3Y\xef&=D}+\
K\xc9\x1b\x96\x06 B\x0f\x80\xd5N\xe5\x01B\xf7\xd0\
\x1d\xf7\xc0\xdf@\xc2\xf7,\xba\xcb\xe1\x8e\x09\xdc\xc6\xbd\
T&\xb0\xcd\xc6I\xa0\x9am\x22\xc0INk\xed\x02\
px\xec]\xbcSVf\xe8\xf0\x8a`\x1b8\xfc\x96\
\xfde\xfa'\xb3\x9e\x94\x85\x0c(3+\x91sT\x12\
%\xd2n\xef\xe0A\x00\xbcV?\xd5\xd6s\xfaP\x5c\
\x05\x9f\x22c\xe4H\x1d\xda\x02\x5c\xb3n&\xb3\xbb\xda\
\x84\x87\xee\xb3P\xfc\xa6\x7f\xf4\x17 \x02H\xc9t\xe0\
}\x0bV\xe7\xce\x9d[\x0ep\xda\xab-d@\x1f\xc4\
e\xd5\xa7\xd9\x02\xe1\xff\x00Q\x15\x8c\x92\x9c\x1f/\xc9\
\x05 \xcf>G \x91\xd8\x1b9\xc0\x0bn-\x00%\
_\xe4\x83\xdc\xd3\x8fX[\xcaEOf\x0d3a\x02\
\x5c\xbd\x97\x15\xea~3X'O\x93>\xb4\x01\x98\xa5\
ik\xd3\xad\xb7\xde:\xfc\xcc3\xcf\x1c\x16\xab)\x03\
C\xf4\xb7\xd91_\x8dk\xfd\x8aJ\x8a\xe2\x81$\xba\
o\x04\xa0F\xa0\x19\xcc\x8ai\x85\x84\xcd\x82\xd0\x8d\x81\
\xecVe\xd6\x93D\x8dZ\xb4h\xd1\xdb\xae\xb8\xe2\x8a\
\xcf/^\xbc\xf8T\xca\xa0St\x00!\xce\xd9\xea\x04\
!\xb9w\xb9J\x82\xd4\xf1\x993\x05\x0b\x98\x80\x06\xa6\
g\x9d\x07\xd7\x83bA{\xe0D\xa1\xb3\x12Y\xe7\x0a\
\xdaq\x09\x98\xc7b\x03Y\xcb\x93\xfb\xea&\x14\xd5\x95\
\xcb@O\xa7\x11Z\xa3!e\x95\x08-\x81j\xf7\x09\
\x0d\xd0H\xeeg\x82\x99\x14\x16\xea't\x11H\x17\x81\
\xa5@\x9e\x01\x8c\xfeV\x06%%\x189\xd1!\xdb\x0e\
\xb2#\x5c]\x89\xef\xe0\x8d:\x01A\x00\x8c\x02\x03@\
|P&\x1ey\x17\xff\xb2\xcd$1#\xede\xfd\xb1\
\xd0\x94\x97\x03\x0f\x01\x1d\x8bS;\x8d\xcc,I`A\
\x11X\x1c\x94\xdbH\xad\x9e\x9c\xd8\x01\x00\xf0\x86\x80\xa3\
\x9b\xf5A\x81\x81_\xb6\x1d\x84\xa7\x09\xa6\x03GJ\xe5\
\x19\x83\x05Z\x01d\x0e\x5c\xd4\xcf\x80\x92\xa2\xeb\x13\xfc\
\xaa\x8e\xb8Q\x0c<\xc0\xafd\x14\xc8\xc9\xb9\x06\x0e@\
L\xf1\x0c\x0eY9\x9d\xbdV\xca#c\xe4\x85<(\
C\xddd\x22\xd3\xff\xe8J\xaa\x96\xb8B\x19`\x80\x08\
\xe0\xc2\x1b2\x1c\xdd\x08]Y\xdc\x99\xb4\xad\xf8\x9a\xbd\
eY\xd3\xc3\xeaEgVs\xe3;\x00\xe1\x8e\xba\x9f\
p\x03\xe0\x01\xec\x99=K|2K%\x00\x7f\xe2\x81\
\x9e'\xaf\xf8\xa2?\xf4\x8f~\xc5S\xf2\xf5\xc1\x0f~\
\xb0\xcc\xd8\x99\xd40\xf5t\x22\xb5\xdd\xbbww\x15\x95\
\x80~U\xaf\x9b\xe5\x96of\xbcT\x7f\xfbO1\xa1\
\xc1\xc0\xa1\xd5\xf7CM\xc1\x0d\x06X\x8d\x96V}\xfd\
\xcb\x98\xf9\xf3\xe7\xbf\xfb\xf2\xcb/\xff\xcc\xda\xb5kO\
4\xcabx\xa6\x99\x09iNy\xf07\xa61\xa7\x13\
@e\x15\x10F\xa3\x98\x0e\xc1hL\xa7H\x84-\xeb\
`\xb2\xb94\xa7Gx\xdf\xc9\x17\x04.\xa3\xb6Q\x96\
\x05\xc0GN\xe0\x97P\x19=\x8c\x1c:\x8b\xf2\x12h\
\xcfk\x03\x85Q&\x81\xee\xec\xe8,\xbaGt\x97#\
\xa7QXG\x02 \x0a\x96@`R\x94r\x83r\xbc\
K\xf8\x94\x98\x01E\xa5\xdc~\xd3f`\x18\x17$\x81\
\xcf$\xd9J\xba\x8edl\xa4 9\x1f\x8dBS.\
\xa36\x1a\x08M\xac\x13t'\x18\x19\x80\xc8\xe9\xa5I\
\xfc\x0f\x88\xb3O-\x99\x01|\xd0\x96\x83\xfa\xb8!\x09\
\xd8\xb3\x14\xc45r\xfai\xd2\xe7\xa2;G\xfaT\x03\
\xe99\xd3\x0c\xcf\xb5\x89\xd2%\xeb\xa4\xdf\xe2V\xa2\x9f\
\xdb\xa1\xed\x14H\xdb\xb8\xe1\x09\xd0\xc6*\xca\x88]\xdd\
\xe9N\xa9Y5\xee\xe3\x85A&'r\xd4\xea\xdb4\
\x12S\xf2\x7fR\xbb\x92\x1b\xed\x07F\xde\xc5#`\x8b\
Vr\x94XS\xf2\xfcpq\xd1\x1aK\xd4}\xe5d\
\x11\xa2\xfe\xab*oQ\xb7\x5c}O\x1ep|B\xb7\
{9\x0b?K1\xc8<\xbeq\xc3b\xe9p\xd1|\
2k\x0b\xfc\xc8\x22p\xc9\x89\xb19\xc8\x92\xde\xe8S\
}\xa7\x9f\xf0\x88LX\x96\xc1\x8d\xf6<}\xf8\x9b\xbf\
\xf9\x9b\xe2\xcb_\xfer\x19\x83\x9a3gNm\xd7\xae\
]\xa3\xab\x89\xff[Y@\x8d\xa0S\x0dTWq\xe0\
\xa0;\xd6*\xb0\xd4\x08(\xcd\xd6\x07U\xaffH\xd7\
\xea\xaa\xfe\x16k\xc2\x11\xee?\xfd\xe9O\xdf{\xd5U\
W}z\xdf\xbe}\xc7X\xcc\xd5\xdd\xdd=\xd0\xd3\xd3\
S\xf3;\x06\xe6(\x1e\x1d\x1aW%\x1b\x0fu\x04a\
\x89;\x829:\xc5\x08\x9f\x5c=\xac'\xe6-\xa1\xa3\
\x00\x98\xfe\xb5\xaf}\xed`\x9a\x86\x04|\xd5E\xa8\x01\
\x94\x8f\x91\x8d\x10\x12\xca\xaa\x15\x935>\x04\x86u\x12\
W\x10\x0d\x04@}:\x95 \x00\xaf\xb8L\x89\xcd\x18\
\xe5\xf0\x0dPd\xbfW5\xb1\xbcg\x08-\xc56\x92\
q\xab\xdcK\xfd\xea\xa5X\xc9\x1b\x93\x85\x89~g!\
\x14u\xf3\xde\xa8\xefy.\x1c\x8b\x04\x98\xe3\x17\x85\x04\
\x0e\xda\xe4]\xbc5\x92j?e\xa7\xa8,\x99\x9c\x0f\
\x86\x16\x00\xc1\xfa\xa14\xda\xe4>~z\x86rxG\
\x9f\xe0\xb3:\xc5\xce\xf0-\xa0\x89\x1e\xefkw\x16\x18\
\xfaP8\x17kU\x1f$\x1b\x22\xc0a\xe9\x1aD\x0c\
&xJ\x81\x12\x1b\xd4\xb7\x14L{c\x01d?X\
\x80%\xae7\x1es\x99\xd0\x0a\x80\x12\xfbQN\x00(\
\xa9;\xb4\x09\xcd\xdaA.\xb2\xc5A\xb9IQ\xa2\x9d\
f\x09\xd5\x03\xe4\xc9\x1f92\x00\x02v2\x16W\x15\
o\xb5\x1b\x0f\xf1\xd7\xb3\xca\xc9a\x93\xcagQ\xfa\xe4\
(\xaa\xa4c\xf5\xae{61\xeb;n\x18`\x02B\
\x01u\xb2\x85\x96,#`\xbd&\x85J\xf8\x8c\x16m\
D/ \xca\xf1O\x06G\xf2\x8e\x07\xc9\xe0i\xa6\xcd\
\x22\xd4\xbf\xfd\xdb\xbf}.\xdf\xf7\xd9g\x0b\xcb\x8e\xd9\
\xbf\x7f\xbf]\xcf\xbd\xcd\x8c\x98V\x86\xc8\x81\xca\xd1U\
\xff\x01\x84ZY(E\x93Y\xaf\xa2\x89\xbb\xd5\xac\xb2\
\xc1\x08k5\xd3V?\xb7j\xec\xed\xb7\xdf\xfe\xa1\xab\
\xaf\xbe\xfa\xd3\xe3\xc6\x8d\x9bn\x0bE__\xdf\xc0\xd2\
\xa5Kk9\x99 \xe9T5&\x07\x0df\xe1a\xce\
\x0cg%al\x82\xa2\x9e\xd3\x89FQJ\x9ax\x0b\
\x86\x0b\xea\xe6`?f5\xc1\xcd\xe2B\xf5\xa3\xcf\x88\
\x14\x13\xd9}A\xd6\x8c\xb0q\x8ft,7#\x1b\x09\
#\xd0F-\x16\x10\xdat2\x81b!e}F\x92\
\xc9Sv4\x12\x86\xaa\xeb\x1a\xd72\xabb\x09\xb4\xb2\
\x92\x04\x86B\x00\x00 \x00IDAT3\xf3U\xd4\
\x8f\xe0\xc9Q\xd2\x09h'\xa7r\xce9\xf3\xdd\xa8\x08\
H\x07*)2\xb2QU\xb9\x09`\x03\xdc\xc4\x04r\
\x92\x08%%\xec.\x02\xad\xae\x9cg\xa6\x1d9K\xdf\
\x82P\x96\x8f\x11[\x1f\xb1d\x02n\x84X\x9b(_\
\x16X\xaa\x83\xe2\x0c\xd4\xf7\xcc\xe1cVm\x03\x09\xf4\
\xe3\x09\xf0\xc8\x89\xa6\xde\x0d\xb8\x02\x1e\xf5\xc4UQ\xa6\
z\x8c\xda\x99\x89\xcalQ\x8eG\xae\xd5\x13\xe4g\xd6\
0nl\xe43\xael\x947\xeem,\x05\x00\x02\xb8\
\xbc\x87/\xea\xd3v< ;\x80\x92ud\xfb\x8d0\
\x00\xab5\x93\x02>\xda\xa8l\xbc%\x0b\x89\xc5\xa0\x81\
,\x19\x94\xf0\xc5{\xbe{>\xf9\xac\xf0\x08/X\xaf\
\xc9SE\xde\xb2\x09W<'`\x83o\x19\x88\xdd#\
\xb7\xda\x01\xbc\xb2\x07-\x9b\x98]b\x95\xca0\x18\xea\
?m\xa1Cb\x97\x1f\xfe\xf0\x87\x8b\xaf~\xf5\xab@\
\xb6v\xf1\xc5\x17O\x18\x18\x18\x98R\xab\xd5V6\xb3\
|\x1a\xf5\xbb\xd1Rj|\xa7\xa3\xba\xcc\xfcp]\xab\
Z\x93s\xc5Z-Z\xac\x06\xac[\x81]=e\xc3\
\xe4\x9bn\xba\xe9C\xd7^{\xed\x9f\xce\x993g\x92\
\x11j\xe3\xc6\x8d\x03\x96\x8bc\xb0\x11\x85@\xf1O\xb9\
\x09\x10^\xc7\xb0@(:\x05\xc1<\xcaa\x147\xfb\
\xa5\x93=G\xa12\x13\x96s\xact\x08\xeb(\xe9:\
\x09\x87\xf2\xb2\xd1\x92\xb02\xad\xb3;:;\xd4\xb3(\
2\xd3\xe0:\x14@\xa0\x8f\xe2d\xf1\x9d\x91\xc6HH\
\x08\xc5\x09,\xf3\x8fE\x95Y\x19B\xcd:\x01>:\
=\xb1\x90\xf0\x8a\x90\x13\xb0li\xd0\x86\xa4\x84\x18\xa8\
\x1c\x93\xe3\xbdl3@c=\xb5I\x09\xce\x94\x08\xd8\
\xb2V\x8c\x9a\x89\xf3$wL\xd6U\xe1m\xd2\xa4\x02\
L}\x92\x14\x16Y\x16\xa0,\xc0\x837\x99\x85\xcb\x1e\
*\xe5p9Y\x02\xfa\xc1qC\xc9%\xad\x8c\xf4u\
\xf2\x05\xe5$\x11\x16Of\x0c\xe3n\x02\x9f\xc42\xb2\
\xb5\xc3\xe2\xbbZ}\xfb\x8b\xbeU\x8e\xf6\xe8#\xe5\xb3\
\x92\xb4\xd3@`\xe0\xc9qIYj\x80.\xbc\xd7O\
\xd9\xf1\x0f\xa4\x92u `\x96=\x81E=h\x0c\x00\
\xf0\x9dk\x99c\xa6\x01 \x99\xcb\xd2\x02\xff+\x9fl\
\x911e\xb9X$\x06 @\xaf\x9dq\xb5\x80H\x8e\
\x98\xc23|F?\xa0D\xb7\xac\x00\x96\x83hw\xe2\
B\xd9\xcb\xa6\xdd\xea\x02\xa2\x01w\xf4\xeb\x97\xec]S\
^\xe2\x96\xde\xcb\xd1\xe3d\x02\x0f\xf0\x18\x80%\xf5\xb0\
\xfe\xd5&\xb4\x18@B\xbb\x81\xd1dL\x16\x82\xa2\xf1\
\xce;\xefl[\xb9r\xe5\xa4={\xf6L\xed\xec\xec\
\x5c\x89_9\xaa\xa9\x11K\x9aa\xc3\x81\xca\xa9\xcc\xb9\
\xda\xbf\xf0\x85/4\xb5n\xaa\x01\xea\xc1\xdc\xb3\xea\xbb\
\xd5\x95\xa7E\xc5\xfc\xaa\xbe_\xdd(\x18\x00\xda\xb5k\
\xd7I\xd7]w\xdd\x9f|\xff\xfb\xdf\xff\xc4\xf9\xe7\x9f\
?\x9e\xc5\xb0z\xf5\xea\x81\xf9\xf3\xe7\xd7r|\x09\xa1\
\x11$\x13\xdf\xc91':\x1d\xe3 \xbaN\xc6x\x0b\
\x11u:A\x02d\xca\x22\xd4\x046\x09\xb9\x94IX\
\x08'\xa1N\xd2,B\x9f\x03\x0f\x8df\x18\xec\xf9\x1c\
\x99\x13\xd7#\xc1_n\x87\x91W\x07\xa1\x892\xc6\x15\
@g\xd6\xfc\xa0C]\x94\x98P\x03+\xf4\xa0W\x90\
\x95\xe2h_\x16\x7fy\x9f\xb0\xc7-$<9\x97\x1c\
\xbf\xb2v#|\xccI\x1aq\x93\x92\x06$\x87.J\
TF\x91\x02\x06\x01\x98L1\xe7\xbc}\x80\x9c\x83\x11\
\x01=W\x00\xdd\x99Q\xc3\x1f|\xc9\xd2\x87\x1cA\x84\
\x16+\x8cs\xd2\xc4g?\xfb\xd9\x83[\x14\x02z\xa1\
5\x01\xdf\xec\xb6g\x81\xc5\xb5d\x95\xf8]\xdf\x10|\
 \xe9\xef\xacV\xce*\xe8X\x07\xfe\xf6\xac\xb5\x5c\xea\
\xd1\x16|\xd5Wd#\xe7\xb8\xeb7}\x85V\xca*\
F\x13\xe0\xcf\xb49\xfe\xe5\x98 \xb2\xa0\x8c,\xf8C\
[\x8e4J\xaek\xff\x03\xc8l\xfb '@A{\
\x00Cf\x17\xb3\xd6J\xdb\x95GO\xf05\xc9\xe6\x12\
\xbb\xd2\x1f\xcaM\x16O<Vf6\xe8\xaa[\xd0\xd9\
\xfd,\x80e\xe1\xe3\x99\xf2\x92Y \xc1o\xcf\x03\xb9\
\xe4\x82\xf2{\xb2\x8b\xe2=\x10\xf2\xbb\x8f\x10B,A\
\xed\xcc~F\xfc\x89,\xb8\x8f\x97G\x1eydm\xdd\
\xbaumG\x1du\xd4\x82\xe9\xd3\xa7/\xf0{\xb5\x7f\
\xab\xba?\xd0b\xc6\xbc\x11\x9c:\x1a\x1fh\xe6f5\
ZA\x8d(\xd7h\xe14[\x15Y%,\x01h\xcc\
\xd9\xb4i\xd3Y\xdf\xf9\xcew>;o\xde\xbc\xb7_\
r\xc9%\x9d\x17]t\xd1\x00&\xfd\xfc\xe7?\xaf\xb1\
:\xb8K\xc9,H\xe1?\xf9\xc9O\x96\x0cae\x18\
\xe9\xfd\x0e\xa4\x08\x1c\x90\x81\xf8F\x0fnZb\x1f\x11\
z\x16\x92\xce\xc8\x0c\x1a\xd7\xc8\xbdt\xa6\x91\x07M:\
\x05}I\xa0\x95\xfdZ9\xa9\x22\xbb\xc6u0\xa1S\
Wr\xf1x\x8e2R\x14\x8aheu\x5c\x8dt\x10\
\xc1v/\xb3I\x04\xaa\x1a\xbf\xc8Y\xe1\xd9>\xa2\x0e\
\xc2\x9c\x98A\xb5\x9f\xd4\x87\x9e\xf0S=,\xb9\xe4\xa8\
\x0e\xff\x08}\x00H\xbb\xd1\x9f\xbc7\xd9\xa8\xe8\xb9\xec\
\xf7J\xb2\xfb\x1c\xff\x9c\x0d\xb6\xf8\x81\x8e\xe4\xfa\xc9\x0c\
%\xebC\xf9\x99\xe2\xe6\xe2\xd6\xea;\xfc\xe3\x9af#\
\xa6\x81\x83r%?\x92\xb6Sj lpI\xc6\x01\
\xf5\x03\xe8$OK\xea\x0cr\xc1\x12\xa1\xec\xea\xf5\xbb\
\xd9\xa1\xa2~\xf6\x16>$\x01\x99\xf6\xa0\xd9\xff\xe4\xa1\
\x9c\xb1\xdc\xb1\xe3`\x1b\x00l\x12\xc3\xe7l|\xf2\x95\
\xe3\x94}\x0f \xea\x87\xa2\xbe\xd5\x06XkC\xac\x17\
@@\xf9\x939\x01/(m\x92\xd2\x03\x8e\xe4\x06\xca\
\xf9\xfa\xde\xf37:X\x97\xe4\xd8w\x80\x0e\x94\xd0\xa5\
O\x94If\x0dt\xca\xf4\xc9\xe6\xe6\x1cG\x0d\xa8\xd0\
L\x0e\x00\x8c\x81\x17_\xac[\xca\xee}\xbc\x04\x1a9\
r(g\xda\xe3\x19\xd7/r\xa5^\x16P@\x1bo\
\xea\xb3h\x03\x97\x5crI\xed\xee\xbb\xef\x1e\xfb\xd8c\
\x8f\xbd\xe8\x94SN\xb9\xa6\xa3\xa3\xa37\xc775\x0b\
\xd3T\xb1\xa2z\xf4s\x15/JK\xa8\x19\xe04\x06\
\x90\xaa\x88\xd6\xcc\xffk\x06H\xcd\xf6\x89\x14u\x93\x1c\
#\xd6\xae]\xfb\xd2\xab\xae\xba\xea/\x9ez\xea\xa9K\
>\xf0\x81\x0ft\xbc\xf2\x95\xaf\x1c\xa0\x98\xf7\xdf\x7f\x7f\
\x8d\xc2\x1bu=+\x88(H&M\x86\xa0\x1c\xa53\
J\xe8\x18\x81\xeb$\x83\xcf\xe9\x95\x14\xce\xa8H\x002\
mN 1\xd4'Ap\x82E\xf8\xb9\x0f\x84\x84\xc5\
CP\x01\x99:\x94\x9b\x19\x88$\x96\xc7\x97,l\xf3\
w\xce\xdf\xcahn\xd5lNo\x00f\x11\xc6\x9c\x18\
\x816BB1\x80\x0c\xc10\xcag\xcfY\x12\x95S\
B\x0a\x9b\x99#\x82\xc6\x94V\x96:#0\x04 \x19\
\x1b\xf1TL\x80\xd2\x10\xf0$H\xcb\xd4~\xa6\x80\xd1\
\x9f8\x82vh':\xb3\x9e\x06\xdf\xb8\xa7\xac\xa7,\
\x0d@\x13a.\xea\xd6kv\x97\x03<m\xae\xae_\
\xa1\x9c\xf8\x17\xda\xb49\x16\x11\xba\x01\xbf\xf2\xe2\xc2\xa2\
\xd5\x00\xc2\xb20`\xa0?\xe7\xd5'y\x7f6\x5cf\
\xddN\xf6\x5c\xe1\x13k\xc8@\x12\xab;V\xa2\xb2\x95\
\x93@\xbb\xb8Hr7\x03\x91\x1c\xbb\x93\xa4\xf3\xda\xa0\
|\x03@\xd6,\xb9\x8fw\xde\xc1\xe3l\xa5\x09\x00\xe4\
\xbc\xf9\xec\x1bc\x8d\xe4\xe8\xa1\xcc\xbe\xe9G@\x0d\x98\
\x95\x95\xc3\x14\x93\x17H\xd9\xe8\xf7.\xc5'\x7f\xe8\xd5\
Oh\xe2f\x92g\x83\xa2\x0f\xde\xd3\x0f\x00\x89ox\
\xab\x9d\x9e\xc5\xf7\xcc\xa8\xea7\xf4&\x95\xadz\xb2\xc4\
\x00\xbd\xf1^\xb2\xf9\x16\x7f\x0c\xac\x91\xfd\xac\x98\xf6\xe1\
\x02\xf6\xf7\xf7\xd7\xc8u\xdd\xf5^?g\xce\x9c{:\
::z\xaa\x1b\x80\x07\x9a\xac\x0bj\xb6h\xb1\xfaw\
[c\x1c\xa7j\xad\x0c4,0\xaa\xfe\xdfx\xbf\x19\
@5\x0bh\xeb\x9c\xbakr\xe17\xbf\xf9\xcd/m\
\xd9\xb2\xe5\xcd\x7f\xfa\xa7\x7f\xdaFa\x98\xd5\x02_\xcc\
N\x0aLQ\x8c\x0a\x18\x9f\x1c5:\xd3L\x89N0\
\xfa\x01#~7e\xa3\xdc\x19\x91\xb3?\x07\xb8`\xa8\
\x19\x16\x00\x94\xe9k\xe0\x84\xe1\x14.\xeb(\x98\x9fY\
\xfbCX\xfc\xee9\xc2\x91\x8d\x84\x04\x830\xf9\x9b\x10\
e\xb5\xae\x8e\xe3O\xb3\xc8X?\x14L\xe7\xc4\x05\x0a\
\x8f\x92d^,\x88\x10Q\xf6,\xac\x0b\x00\xa1\xb9\xbe\
a\xf0\xa0\xebS\xab'QGO\x94L_e\x01\x1c\
\xc13\xdaS\xacXk\xe8\xf2lb\x19\xfe\x07~\x01\
!\x0al\xf4W>\xa1E\x0b\xde\xa3\x11\xcf\x95G\x10\
\x13\x04&\x8c\xb1Xr\x0e;~g\x97?\x1e\xab\x83\
0'F\x95\x19\xb1$\xe5\x02\xbc\xac\xd8(h\xd2\xa1\
$\xb5k\xe2*\xd9\xea\x92\xa0,\xeb\x07\xdd\x9eS\xae\
\xfa\xb41g\xbfk_\x82\xf2UY\xf4\x1b\x9e\xa0\x09\
\x1d\xdcu\xc0[\xd4\x03\xb6Yp\x07\x9c\xb4_l1\
\x19\x13\x93q\x92\x8cd\xe6-\xfb\xac\xaa\xf9v\xf0\x03\
\xcd\xb1,\xd4\x8fOIC\x9b\x94\xb8\xe8@o\x064\
\xef\x01q|\x05\x0a\x91\x15eg\xc9\x80\xe7\xf1U\x9b\
\x95G\x96\x93YA\x1d\xc9\xfa\x993\xce\xe2e\x18\x08\
<\xaf^\xf2\xa8<\xd6\x95>\xcfY\xf4\xda\x95\xc5\xb4\
I\xb2g\xe0O\xbc\x11\xf0\x1b\xfc\xb51g\xc0e\xe9\
\x86)\xb2\xce\xce\xce\xf6X\xf0\xe1c\xe4\xb2\xba\x917\
t\xe5~\xf5S\xd2\xfb\xf9\xcf\x7f\xfe?\xa1V\xab\x99\
\xad\xaa\x9f7X\x10\xbaY\xc4<\xdb\x16F\x8c\x18Q\
[\xb1b\xc5kn\xb8\xe1\x86\xbflkk{\xcdG\
?\xfa\xd1\x9aN`6r\xc1(\xb6\x80\x18\xb4\xc7\x18\
\xa3\xbb\x91O'\x13X3\x0eF\x5cJN\x98\x09\xa6\
 \x1e\xe1\x11\x04&X\x18\xe6\x1d\xa3\x94\xce0\xca\xc4\
,\xc64 \x98\xf3\xb2\x80]N\xa6dU\xe5tP\
\xbfUwRS\xce$\x07\xd7\xb1\x94$\xb3Ph\x05\
\xa0\x04\x16-,2\x02\x9f\xa0]Q_\xff\x91\xb5I\
F$\xf5\xc5\x12\xc8\xe8\xa8\x1cBB\x08\x93\xc3'B\
O\xb0<\x07\x182\xa2G\xe9r\xea\x03\x857j\xa2\
\xdd}|\x88\x1b\xa6\x1eB+\x8fqV\x8c\xe7>\x05\
\x07\xda\xc0G}IU\x92\xa5\x01\xfa\x07\xcf\xdd'\xfc\
\x99RF/A\xc5\x03\x83\x84>\xc2s\xfc\xce\xc9#\
\xee\xa1\xd7;\xfa\xd2\xf3\xdan\x10q\x8f\xd2RD#\
-E4\xd0\x18\xd5\xab\xe9P\x94\x8f\x17\xca\xf6\x8e\xb6\
\x03\x08\xfd\x99\x14\xbe\x09\xc0&\x9dl\x00\x9a\xd2fi\
BNv\xa5\xec\x99$\xf0.^\xe0Md#iC\
<G~\x12\x97\xd2\xbf9-5\x83T\x82\xf2\xde\x89\
E\x17\x8b\x8d\xa2\x93\x1f\xd6\x14:sR\x89w\x94\x87\
.<\xcfl\xab2\xd5g\xf1\xac\xf6\xb1\xbc\xaa+\xf1\
\xc9:\xbe\xe1uN\x84U\x8e2\xd1\x94\xcc\x91I\xdf\
\xab,\xb4\xe1\xb16h\x9b\xba\xf1\xc4\xdfx\xe5\xb7\x0c\
\x8c\x06\x09\xe5\x93u:\x918\xa0\xf22\x03Y?\xab\
\xbf\xff\xb8\xe3\x8e{d\xce\x9c9\xb7\xec\xdb\xb7oW\
c\x9c\xb7\x8a%\xadf\xc5\xaa\xb8\xf1\x9fVL7\xb3\
^\x06\x1a\x16\x15\xb6r\xc1\x9aYM\x01 \x0c\xc3\x84\
\xc5\x8b\x17\xbf\xf1\x1b\xdf\xf8\xc6\xff3v\xec\xd8\x97Y\
\xce\x8f\x19\xe2=\xc9\xe7\x0c\x80\x8c\x9a\x98`\xc4\xc8\x88\
\x0c\x80\x92\x8e\x95E\x13\x0bG\xd0\x17p\x19\xe1\x08\x98\
\xd4\xac\x19qu\x10e&\x00:#\xcb\xfe1W\x99\
\xdeC\xa7\x197\x02\x90\xb539\x81C9\x12M%\
\x98IQ\xd0\x04\x80\xb2\x00\x0eM,1\x9dcq\x9a\
N\xcc\x82\xc2\xc6x\x9b\x0e\x8d{\xc8\xe2\xa2\xd81\xfb\
\xe3\x82\x11\xfeX\x14\x01\xa0\x8c*q\x8f(\x87\xd1\xf0\
@\xfd\xbcv\xb3g\x140[W\x08(\xe5\x070\xda\
\x81\x17@\x18\x0f)<:\xf0Q=\x5c\xb2j\xcc&\
\xc7\x0e\xa1)q\x11\x82\xcbJ1*?\xb7\xa5\xa1\xfd\
\xa0\xe0\xe6\xd8e<\xc9\xc9\xb6\x9e\xcb6\x8e\xa4\x17\xd5\
\x07\xe8\xf6\x1ew2Y\x08(\xa2\x18Zv\xff\xeb\x03\
|\xfb\xff\x09\xbb\x17`\xbd\xef\xf2\xb0\xf3\xef{tt\
\xb1d\xcb\xb6dI\x96e|C\xb6\xb1\xb0\x11\xc4\x18\
\xc2%\xc4\x81PXR\xca\x92i3\x09\x9b-i\x9a\
N\xb6\xd9\xccl\x9ai\xb3\xd9\xd9m\xb7\xed\xce\xa4\xbb\
\xe9f2\xbb\xddl\x18H\x09\x81$$\xc1$NI\
p\x09\x99\x98\x10jLl.\xc6\x10lls\xb1\xb1\
e\xf9*\xd9\xd6\xc5:\xd29;\x9f\xe3\xf7{\xf2\xe3\
Ef\x8f\xe6\x8c\xcey\xcf\xff\xff\xbb<\xb7\xdf\xf3<\
\xbf\xe72vv\xa8\xc9@\x0e\xf2\xca\x5c\x10V|^\
\xe8\x85i]\xec\x0e\xe63v\xa6!F\xb3W\x9a'\
\x06\xf3\xd9{\xdf\xfb\xde\xd5\x83\xc8\xda\xc0\xc6~\xe1\xb8\
\xb4\x86b\xc6\x08\xda\xcc]\xdf\xc6\x9d\xcc\xc2\x14\xec\xd3\
\xbe\xed\x91\x96Q\x1b\xa0\x8a\xfa\xd7\x13\xac\x08m{\xb4\
\x0e\x87'\xad\xd9\x1c\xe8\xbd\xb4\x8eBCj\xd9\x03\x1e\
~\xb6\xe7:\xbc\x14\x8cj\x9f\xe8\x7f\xac\x5ci^\xf3\
\x14\xd4Y2\xb3y\x98s\xf9\x0f\xeb\xf1_\xf5\x05\xf4\
\x0d\xef\x84\x9f\xcb\x1f\x85\xcd\xc4\x07IA\xf1l\xb9\x83\
\x846Z\xb8\xec\xb2\xcb\x96\xb7m\xdb\xf6\xd8\xd2\xd2\xd2\
\xa1\xef\xa6\xbc$\x07N\x97\x9e5~-\x9eN\xb0<\
\x9f9u:)\xf6|\x9f\xf5\xbe\x8d'\x85\xef\xbe\xfb\
\xee\xb7\xfc\xde\xef\xfd\xde\xbf<v\xec\xd8\xf7\xd2\x16\xc4\
\x00}\xecc\x1f\x9bRs\x11-\x02q\x0d\x88\xe0\x9d\
,\x9dd]mB\xb2\xff\x09\x03\xc8\x15\xbf\xe0t\xa1\
2B\x22\xf3\xcc\xe7\x80\x956\x81\xf0\x0a\x0c\xec\xda\x17\
\xd1\x00:\x81\x81 j}<\x99\xf9\xab*\x13\x0ay\
N\x1d\xc8\x84 kBt\xc5\x92X[Q\xd0\x02\xe8\
0E6\xf9\xbcF\x98\x13\xb2\xdb\x0c\xeaxE\xf0\xcd\
O\x00!\xac>/^\xa8(\xe8\x88\xb9\xc4SL\x80\
\xf1\xbaA\x01\x07\xcc\x02\x16\x9d\xc0%\xb4Nf\xa5k\
\xedK\x8dmLW=\xe4\xe2\x9d\xbaf\x9d\xccb\xb6\
\xec\x8f\xc0dzb\xe2Je\x1c;v|r\xe0\x80\
\x1b\xc4Sk\xfd\xf11'\xc2'h\xc0\x08\xd1b\x0a\
B\xbe\x98\x14\xe66&\x82k\xfb\xb4F\x97\x05\x04\xa4\
=\x81\xb3\xff\x1d\x08\xb4\xda4\x9c2\xe8\x09\xd7n\xff\
\xe0\xda\xfa\xca\x84\xf7\x9d\xe6ZY\x8c\x22\x9d\xad\xa5+\
\xf6\x9c\xd0L+B\x90@\xf6\xb7\xae\xe9\x8b\xe11\x96\
\xff\xbb\x90\xc0\xa8\x09\xb6:\x9f\xd6\x8d\xb6\xda\xd8\x04?\
!`\x0cs\x9b#\xed\xa6r!`B\x1b\xa3\xa5\x10\
\xbe\xe0\x03\x86h\x9e\xb0\xa9Z\xa5\xc3\x03\x0c\x08\xa1:\
\xeeZK\x05\xd0\xccYU\x05\x7f+\x17\xce\xbaj\x0d\
\xeey\xee\x05\x7f\xcf_\xe8P+^\xc9\xfa\xbcW\xc6\
\xbe\xb98\xa7\xb9:\x94?\x16\x12!T\x80 \xb27\
\xfc\x1a\xad\xee\xda\xb5\xeb\xd4\xc6\x8d\x1b\x0f,,,<\
[u\xc51Mf\x94!\xf3y\xa8\xf3_k\xe6\xd8\
\xe9\xbe\xe6\x1d\xca\xf3\xb1>\xf3\x03\x9e\xee\xf7rp\x00\
\xe0\x8e;\xeex\xdb{\xde\xf3\x9e\x7f\xb9m\xdb\xb6W\
\xbe\xf3\x9d\xef\x5cE\x04\x07\xf4\xc1\x83\x8f\xac\x9d:\x84\
\x8bS\x1dC\x11H\x88\x0d\xb0\x99-N\x0c\xa7p7\
\x5c\x88\x16\xa1\x92\xf8\x18\xafR\xa0\x90\x9b\x0f\x08\xd3\x8c\
\xc9\x82\xd5\xdfA\xfc9\xad1Qa\xecN\x04\xc4\x8d\
1\x8c)d\x9d)!.\x05\x22\xeb\xa3eO\x10\xe3\
sH%\xfc\xac\x1f\xd3\x8c\xd1\xce#\x1c2u\x8cm\
o\xd6\x87h!\xd5z\x10t\xf3W\xa8\xcb;\x08\xd9\
\xb8\x9e\x03\x0fB\x01\x03 4\x1a\x04\xa6\xab*\x22\xc1\
\xe3t\x07\x8b\xd6Z\xc9\x0b\xc4kl\x01\x98uW\x1d\
{|\x85\xab:a\x80+\x01\x82\xe9\x99I\xe0\x05\x9e\
\x98\xd3\x1a\xe0\xcc\x9ah\x03\xe0n\x9c\xae\xec\x09\x18{\
\x03\x13\xfb\xf29!\x02\x97\x04\xa7\xf1<_\x19\x12\xe6\
.\xcd\xc1:\xed\xadf\x8756\xec}\x9f\xd9\x07\xa1\
\xd8)\x9f\x0f\xc5\xfa\xfc\xec\xe4\xb6\xbfZ\x199\xed\xad\
\xc1\x81\xe4\xf9\x22\xb61\xbb\xdf\xe1\xde^\x1c\x5c\xe0\xe3\
=\xfb\xc9\xb9<\x1e\x04\xf6\x9a\x83\x99\xf0(\xa7\xcf\x18\
e\xd8c\xf0\x04\x85q;\xd8\xbat(\xf1\xb7\x0e\xb8\
\x15v+\xa7\xd1Z\xed\x8d\x10\xb2\xff\xba\xf6\x12\x18\xc6\
%4+FO0\xc2A]D*\xa7\xe2y\xef;\
\xd0\xe0\xb35\x80-8\x16\x7f\x96\xb9\x0b\x0e\xc6\xb1F\
{\xcad-\xcf.\xcd\xbex\xb1\xa3G\x8f>\xfd\xe2\
\x17\xbf\xf8\xc3\xbbw\xef\xbe#\x01\xbb2\x17\x0fx:\
a\xf3|\xb2b\xed\x8a>\xa7\xf1\xe9\xfc>\xf3\x83\xcc\
kF\xcfwM?\x8b2>\xf7\xd3\x9f\xfe\xf4\xdb\xde\
\xff\xfe\xf7\xff\xdc\xc2\xc2\xc2~\x19\xb9\x10D\x1d&\x85\
\x11\xc3\xc1\x83\x1bW\x01\xc9D\x10\xf1\x8c\x10\xea\xc2\x80\
x0\x14\x84\x91\xf2\xbc\xf3\xfc.\x04[\xa5\x220\xa1\
w\x999\xd6\x80\x98\xabr\xb82\xc40\x8dZ\x90\xf7\
\x09=\x12\x9e\xd95\xf6\xa62\x8ey\xa9\xea\xf2\x91 \
\xc2\xbc\xd9\xc6\xecu'v\xbd\xcc \xae\xfa\xc2\x93\xb9\
P\x87\x95!\xee\x87`\xf3\x9c\xfd!&\x04\x81)+\
\xfbZ\x01\xf7\x1c\xda\x08\xb6+Tks\xc2;u\x09\
#\x0c.\x06\xca\x09F\xa0#\x9c\xcc#\x9f\x19\xbf(\
o\xcfw\xd5^/\xfd\x1c\x99iA\xa9\xf29\xa2\xcb\
\x03\xc3T\xf9&\x10\xab\xf7}#z'6\xa1\xd4m\
Z\xa5\x1f\xac\x01\xe1\xe6\x0fA\xf0n\xd00QeG\
\xe1\xd3\xb8Lp\xa7u\x8d\x1e\xc1\x1d|\xe1\x9a\x86\x02\
\xf7\x95\xd9%\x000\x1f!ViS\xb8!\xd0\xad\xc5\
\x1ah]\xde\xb5\x7f\xf8\xc7\x94\xe01c\x9eU\xf8\x96\
\xbcIp{\x9e\x00\xf0|\x81\xa7\xc6s\xf8\x10\x22%\
\xb1\xfa\xf6\x1c<9H\xc0\xa2\x88\xec|\x7f\xf9\x83\xba\
m\x0c\xf7\xe8-aL[\x83[B\x05|\xd09\x97\
B\x15!\x8c]\xab\xeaj\x08\xd97\x81jM\x8dW\
\xc5G\xf4_\x19\x0e\x82\xbc\xea\x9d\xe8$\xc7\xb0\xe7j\
\xd3\x84.\x8d\xc9\x02\xb0\x07\xa61~\xb1\x07p3\x06\
\x8d\x08\xef\x95\x10\x9e\xa3\xde\xbb\xe7\x9e{\xee\xca\x99g\
\x9e\xf9\xf0\xf6\xed\xdb\xbf>\xa6\x18\xcd\xe7\xc0\xcd+*\
\xa364\xc2fe\xcc\xa2?\x9d\xca\xf4\xdd4\x9fy\
\xc97o\xae\xcdn+\xf6|\xeaS\x9f\xfa\xc9\x1bo\
\xbc\xf1'\x8e\x1d;v\x99 6\xc0\xe7\x1c\x85\xb0+\
\xae\xb8rr\xf2\xe4smrh;\x00\x92\xaa\x09\x19\
\x98\x95\x1a\xef\xb4@\xc4\xf9x<\x83\xe9<c\x1e\xc2\
\x80\x06U*F\xb7\x18\x09\x83\x22Gk\xcd\x03A\x08\
\x18\xc385\xf3\xc5x\x86&A\x10\x09\x07@\x94\x90\
C\xd0T\xfe\x12\xf2*2^\x90W\xbe\x9b\xd3\xc1\x0b\
\x92\xbc\x8bY!6g0\xc1b\xcd\x18\x16\xa2\xbb\x8d\
\xb0/k\x1c3\xe1\x09j{\xacw\xba1\xc1\xab\x14\
\x0cL\xe9t\xeef\x8e\xc0Ateb\xfb\xbc\x5c7\
\x9fG\xa0\xb3\x82q\xabk%\xd0\x13\xc6\xd6G\xa8\x17\
E\x9cI]\xf6|\x0eG\xf0\x8b\xa8\xc1\xd1\xfa\x11.\
\x86\xabCh\x0eZ\xf0-\x9e\xc4I\xef\xe7\xfa\x86e\
\xe6\xe4\xa0\x87\xf7z\xdb;\x10\x0a\x05\xf0\x9c\xcb\x03\xa7\
<\xa6\xc0p\xd6\x0bf\xc6,\x17\x0b\x9e\xe1\xa9\x12\xb5\
4\xb8\x9c\xfb\x99\x9c\x09l\xccK\xc0\xd1\xac\xc1\x14\xfe\
\x8b\xae\xee\xa6\xac\xfei~\xb6f{\xf1\x0e8\x16\x04\
Z\xbd%\xf0%\x0c\xcbm\xec\xa2\x03\xfc\xd0<\xed\x0f\
.\xc1\x97@\xb3\x8fn\x04\xad{\xec\x83O\x90\x17:\
`\x7fE\x87\xd7f\x1c\x0d\xfa\x99V^CM\xcfY\
\x1f\xf8\xa5\x9d\x1a\xb3\xf8\xa2\xc9,N\xad\xdc\xcab\xb4\
\xa2\x7f\xeb\xa9\xf6y\x96\x821\x0a\x8d8\xf3\xcc3O\
\xbd\xe2\x15\xaf\xf8\xf2\xf6\xed\xdb\xef\xeb\xd6v\x9e\xe6\xbf\
\x9b\x0fh>\xa0y\xf2\xdd\xda@\x9fn\xf0\xef\xa6R\
\x8d\xc2\x09\x00N\x9c8q\xf1\xcd7\xdf\xfc\xb3_\xfe\
\xf2\x97\xdf1\x9dN/P\x16\xc0\x89I\x009\x0d\x00\
\x10B\xabE\x031\xa5A\xf0\xb3\x14pF\xd0\xd4\x9e\
gyV\xb7\x17q\x13L\x80\x8aA\x11+\x00:\xc1\
\x22\xfe\xb1\xe8\xd2tV\xdc\xcb\xe9\x9bs\x0e\xb2\x98x\
\xf9>\xd2\x12\xcc\x8f8JjD\x9c]y[K\xf5\
mhF!yr\x9a\x98\xa8\x1c\xf29}K\xbdh\
l\x0c\x8dA0\xb09\xcbN\xef\x16\xc9\xbe\xfc\x5c\x81\
y\xc4\x81!c\xb4\xb1\xa1_\x95\x04\xcdO\x90wr\
\xfb\x9d\x96\x84\xe0\x98\xb8\x18\xa7S\xbb\xee\x0d\x84T~\
*\xc4\x87\xf1F\xe1\xe3\xdb:\x09\x9f\xa2\xb7\xad\xa9\xae\
\x1b\xe0V\x94\xf5\xca\xacM3\xa6\xa0\x15\xd9SQ\xce\
U\xbe\xf4y\x8d)\xcd\x13\xe3DO\x15\x87#\xd4|\
\xf1O03<\x8f\x09i\x00\x95B\xad\xc53\xdc`\
J\xeb\xa1\xf5\xd9\x17\xc6r\xb9a}\xe0}\xe8\xc9C\
\x93\xe5\x95\xe7\x0e\xa3\xca\xd4\xfa\x1f\x0d\xc23\xc1\xc3\xc9\
M\x10\x815\xe6&P\x09I\xc2\xa6\x14\x15\xfb\xf4\x0e\
\x0d\xab\xce\xb0\x04QQ\xd2\xd6\xe5\x9d\xfc\x82\xf6\xe1o\
h\xde\x97\xcb\x8bh\x05\xdd\xd2\xf6h\x88+\xb3&\x0e\
\xe8\xc9\x98\x09\x0bc\x97\xbcZ\xf8D\xa6W%P\xa6\
\xb3|<\xb0\xcd\xaf\xe83\xf0/d\x00\x8e\xba\xa6\x07\
\x1b4e\x0c\x7f7G\xf5\xca\xad\x1f=\xf8\x99\xa6\xcd\
7j}\xf6M\x08/---o\xdd\xba\xf5\xa9M\
\x9b6=U\x90\xec<\xfdOf\xe6\xdf\xa8\xf1\x8c\x0a\
\xca\xa85M\xc7\x96?\xa7\x136\xcbs\xadyFA\
s:a\xb4<\xeb\xf4p\xe4\xc8\x91Ko\xba\xe9\xa6\
\x7f\xf6\xf8\xe3\x8f\xff\x88\x8e8\xcc'\x80q\x0b\xc6\xc1\
\xdbI\x8b\x88|\x8e\xf8\x11)f\x04\x80\xea\xb2\x00\xaa\
1]\xdb\x16\xb3S\xfb[**\xe6.N\x04\xe2g\
@Z\x0b\xe2K\x15\xcd\xd1\x8b\x09\xd28\xcc]\xfe\x8e\
\xbf5.&\x80\x14\xcf\xb2\xd11\x0a\x22\xe6\x7f)\x08\
1\x81\x98\x00\x1a\x9d\xba\xa3j\xda\x15\xaaSuV\x9b\
w\xf5on\xf2\x10\x13\x0d\x06\x03\xd2F\xac\xc5\xbc\xe0\
\x97\xe0\xea\x06\x8a\xf0C<\x84x\xa510A\xc9\x87\
\xf6P\x8eQ\x886\x06\x02#<\xbam\x9b\x0c\xd5\x0a\
\xc0\x92P\xc6\x80\xcc\x0e\x825gjB\xbc=\x80\x8f\
5\x83\x89\x03\x83\xc0B\xc0\x99{\x18\x04\xc3\x82\xab\xf5\
\xd5\xdd\xa4r\x17\x95J1\xa7\x13\xdfx\xf5\xc32~\
\xbd\xe2\x13\x0e\xe5\xcb\xc1\x7f\x9a\xebd\xf0kT6\xa3\
\xfaP`a\xee\xfah\xf9\x9d\x10!\x84\xd0\xc7\xc1\x87\
\x0fN^p\xe1\x0b&\xd3u\xd3\xb5\x18\xab*4V\
$\xcd\xfb\xd6\x84\xa9\x13\x08h\xcc8\xcc6\x02 \x9f\
\x88\xbf\xc1\x15\xad\x09\xcd\xac\xf6\xeaZ\xb7\xb8\xe6\xd3\xb2\
o\xb8\xae\xc5\xb258<+\xd5\x92\x09g>B\xb2\
\xca\x99\x84\x06\xc12\xeb\xf3\xb5\xfaN\xc1\x91\xf9\xd9\xca\
\xbe\x07Ot\x08w\x04\xd9\xac\xd6\xcf\xea~\x8cO\xc0\
\x81\xb3\xf9\xf0[y\x91\xc6\x01\x17x\xf7\x5c=\xd2\xea\
\x1e\xd2\xc1`=\xe0m\xef\x84Pp=p\xe0\xc0\xe2\
\xa7>\xf5\xa9}\x17^x\xe1\x95g\x9ey\xe6\xede\
\x02\xcc\xcb\x84\xf1\xb2\xea\xf9\x9c\xd3\xfd\xfe\x1dW\xf4}\
\xcdWL\x9b\x17T\xf3\xcf\x16L\xf7\xf8\xe3\x8f_\xf9\
G\x7f\xf4G?\xbf\xb0\xb0\xf0\xc3\xdb\xb6m;\xcf\xc6\
 I\x86.\xe6\xf1\x5c\x1d3\x11$\x80b\x16\xa7<\
\x80\x00\x98\xdf\x9dF\xb5\xa61oY\xe0\x88\x88\xaa\x8d\
\x09\x00\x0c\xb2\xa9\xef]SV+\xb7[\x95\x9c\x8a\xd5\
sI\x90a\x96\xf2\x86rP\xf2\xcf\xa4b\xf2# \
H\x8c\xc7\x14\x84\xb8b\x80\xc6\xda\xc0\x93\xc1\xf9\x5cq\
\xf6\xd1\xe7\x02qN\x13LU\xc0\x1cA\x03&\xf5W\
/\x90\xb0\xda\xcf\x11:\xe2\xc2\xdc\xfe\x07\xaf\x9c\xaf\xf6\
S>Qi\x13\xf6@\x8b)\x8e\xc7\x9a\x10\x22\xf8\x17\
M\x8by1M\xfe\x19s\xa4\x8d\x1a\xaf2\xad\x08\x15\
\x93\xa45t\x13\x07\xde\x057\x96\xf3\x94\x86\x89\xc0i\
=`\x0b'\xc6\xa8X>!\x0a~\xf0\xedF\xb3.\
\xacu\x95\xcd\xcfan\xf8(\xa7\xce<\x18\xcd\x18\x1d\
p\xe0hNsLfA\x8e\x84\x0f\xc65.z\xf1\
\xacw}n\xbc\x13K'&\xeb7\xae_=x\x0a\
\xe0\xf4\xf7\xb49\xcc\x8e\xb9\xc1\x0b\xbe\xd2\xec\x8a:6\
\xb6}\x83iy]E\xb0\xd7\x90p\xd3\x19\x9bVk\
G9,\xe1\x8bFe,1Y`\x98\x86\xb9<\xeb\
\xf1\xe6;s\xd6\xdf\xcd\x0f\x07`\xe2\x7f\x87V\xb4`\
-\xf8b\x84y1;~.\x1e\xc8\xba\xccY\xd8\x87\
\xfd\xd6\xd4\xb2\x86\x95\x04w\xe6\xa1\xf1\xe1~l\xc8H\
0\x95~\x02\x1euj\xcd\x0a9\xeb\xac\xb3\x16\xee\xb8\
\xe3\x8ek\xf6\xec\xd9\xf3c\x7f\xf7\xef\xfe\xdd{O\x9e\
<y\xa8\x83\x7f^\x819\xddm\xd9\xe9\xfe\xb68\x9d\
s\x18\xcdK3\xad\x9fOw\xff?^\xc1#\xa2Y\
N\xcc\x8b?\xf4\xa1\x0f\xfd\xe2\xb9\xe7\x9e\xfb\xd6K.\
\xb9\xe4l\xc4\x8b(\xb5\xca!dLN\xbbp\x9bT\
\xb4f\x1d)\x00\x03\xa3Q\xbf\x114\x9f\x0c\xc7p\xed\
\x5c\xcc\x87\x181C\x9d\x1e\x105\xc2\x1f\xcbsd\xf7\
\x8fB\xa8\xe0C\x82\x08r\x10D\xb7\x06\xe5\x11A$\
aA#`\x06:}\x9d`\xd2 \xbc']\x84\xe0\
p\xd2\x112\xa9\xe6\xbe\x9d$\xf95\x22\xaa\xe0\xe3D\
#4\xad\xd7\xc9o,\xa7wu\x9ck[\x93\xd0J\
\x0bB\xcc]_3\x13*\xd5\x90/\xa6\xb2\x18\xe6%\
\x04\x08vN}\xefT\xf5\xd0z\xcc\xe3\xb9JYT\
\xf7\xa8\xca\x84n\xa2\xac\xdf\xb3US\x8cH\x8dQ\xb9\
P\xbe&\xe3\xd4?\x8b\x0f\xaaN\xaa\xc6\xaaVv\xf9\
d\x84|E\xd3\x8a\xe9\xa1\xf5\xda\x97\xfdy\xa7\x03\xa1\
\xce\xb0\x99\xd0\xf0]\xdb\xe7\x18\x03\xec\x08T\xc2\xd3^\
\xd0M\x05\xd5\xd0\x8e5\x81\x03\xfa\x01\x1b\xa6\xb6\xe7\xed\
\xcf\x1c\x18\x8af\x05\x1e\x95\xc0\xe8\x04\x8f\xd9\x09\x89z\
\xc5\xa7!\xd5\xc9\x96\xf0\xce/U\xa3\x03\x9aO\x07\xa2\
11l1[\xd5\xd3F\xf7\x84q\xad\x8a\xc6K\x8b\
B4\xa2\xd7\xa2\xbb\xad\x01\x1e\xca\xf4\xb7\x0e\xf4+}\
\x09\xedLf\xa5~\xd1f\xb9c\xe0\x97\x16\x07\x9ee\
\xcd\x8f\xf5\xc8\x99\x9c\xdd\x063\x13K\xe51?\x9e\x03\
\xc7\xc9\xac\xa8\x7f\xc1\x8f\xac\x9741\xf0\xb9\xea\xaa\xab\
\x96_\xfa\xd2\x97\x9ey\xc7\x1dw\xfc\xfd]\xbbv}\
\xf9e/{\xd9{\xc7\xb2\xb4\xa7\x93\x15\xf3I\xec\xd3\
\xa1\x83\xf0\x9a\x10:\x9d\xb6\xb3\xa6RMW&\xfe%\
\x8cFU*\xa9>;E^v\xc3\x0d7\xfcO\x17\
\x5cp\xc1[^\xf9\xcaWnav\x01\x94S\x84j\
\x07 4\x89\xfa\x9f\xd7\x13\xbd\x0c]@#\x8c \xd1\
mA\xb5\x8c\xeb\x9f\x0ea\x10\x01\xe9\x04\x09\x22#\x80\
Vf\xb5q\xa6C)\xcf\xfc\x19\xad\x0f\x80\xad\x03 \
\x0bZ\xeb\x1d\x9f\x01\xba[\x06\xc2\xe9\xa7~\xea\xa7V\
\x09\xac\x18 \x04Ah\x12\x80\xccE\x8c\x97J\x9f9\
R\x8a\x82\x9f\xeb\xf0\x90\xb6Pm\x1e\x8d\x12\x09^N\
p'\x12A\x96\xd9\x98\xe37'&\xc2\xb5^\xcf\x83\
CyiEh\xd7\x9a\xbat\x08\x8cX\xaf1D\xe6\
\x14\x05\x83J\x8b0\x1brtW'\xc8\xd8\x18*-\
\xb6\xafB*\xc0\x05\x0e}U\xe3\xd9\xda\x1c\x0c\x08\xdb\
\x1c\xd5\xea1&\xa2-\xcd#\xd3\xd2!T)\xda\x7f\
\xf2O\xfe\xc9\xea\xfcn\x1b\xbb\xf1\xe9\xf0\xc2 \xc5\xdc\
T\xe6\x96\x03\xda\xbe<W_3k\xad\xef\x1a\xc6\xac\
P\x98\xd3\xbd\xfc8\xeb\xc2\xf0\x04X\x87\x90w\xbd\x03\
\x9f\x123\xed\x1d\xedTP\x0c\xdc\xc1\xd8g\xc6A\x93\
\xe8k\xd6\xe9w\x15\xbf\xd5\x197\x17\x98V\xff\xd9\xe7\
\xb5V\x06\x1f\x07\x86\xfd\xdbG\xb9x\x99J\xf9\xed\xd2\
\x06\xc0\x1f\x0e\xd1T\xb1o\xe0@\x18\xc0\x819\xbay\
eI\x10\xa2`\x86\x8f\xc0\xd6\xbcuRE\x13\x1d8\
~\xb7\x0f\xeb0\xb6\xf7\xe0\x00\x9e\xd0\x82\xb5Z{\x1d\
X\xfd\x1f\x1fV\xbd\xd4<\xb5e*\x8e\xca\xbe\x95\xd6\
\xa1m~\xeaS\x9f\xba\xe8\xa3\x1f\xfd\xe8\x7fs\xc5\x15\
W\xdc\xb2q\xe3\xc6\xbb\xf2\x0f\x8d\xf2c\x94-\xf3\x9f\
\x8f\x02\xe9;\xbam\x8cB\xe6;\xec8\xefM\x9f{\
1\x86\x00\xb0\xcf}\xees\xaf\xfc\xfd\xdf\xff\xfd\xff\xf9\
\xaa\xab\xae\xfa\xc1\xb7\xbe\xf5\xadg\x08x\xc2\xd4\xfe\x0e\
\x08\x9e\xe1\x90s\xf5G\xda\xd7d\x0d\xa3\x95U\x8c@\
\x10\x95\xd3\x1c\xb2\xa4g`\x96JdTb\x03\xc1P\
u\x99`\xd5#\x1e=\xed\x99++C\x1e\x0d\xc2\xc4\
\x1c\xe2g\xbaQJr\x97\xacgO\x22E\x09\x0d\x1a\
\x11d\xd1(\x9c\x18\xe6\x87\x80n\x93\x10nq \x9d\
f\x08\xce\x89\x98\xdf\x89@\xa8Z\x1f\x84\xdbKE\xeb\
\x11\x10&\xaa.\x90gJ\xc8t\xf3f.\xb7\x82\x98\
e:ks3\x99\xa5~\xd4>\x06\x91\x17;D@\
T\xe7\xd8\x17\x072\x02\xcf\x94E\xc8Njx\xa8\x80\
\x971\xbaA\xec$\x06\xab\xcc@p\xa8a\xa0q\xea\
\xa8J\x1b47\xcd\x02\x0c\xe0\xc1\x1a\xcbI\xb2\xffr\
\xea*\xe0V\xbc\x0b<\x9b\xa3\xda\xce`L`x\xb6\
\x96:\x9e3\x07X\xa2!\xeb1\xbe\xb9\xd3\x04kc\
TI\x14B\x9b\xc0\xcc\xa9\xeboL\x7f0\xac\x04-\
\xdc\x8b\x02\xc6\xec\xf9_JL\xad\xad\x92o\x07\x91\xc3\
\x90`\xc4\xd4\x15\xa6/D\x82@\xb6\x16\x07\x92\xbd\xe5\
\xcc5&a\x09V\x84%xx\xc7xUd\xb4.\
\xb8\xb5\x7f\xefv\xe3d\xcfpT\xd3\x82R*\xc2M\
\xc5\xd4\xbc\xef=k\xf69\xe1T\xe5\xc7\xc6r\x98\x83\
c\xc1\x95]\x88\xd0\xc6\x0a\xf5\xc0c\xdd\x10\xe7\x03\xaa\
\xc8\x9ay\xc0\xdc\xb8n\xfb\xea\xe1\xc6\xb4\x85\x8f\x8f\x7f\
\xfc\xe3\xd3\xca\xc8n\xd8\xb0\xe1{\xbe\xf6\xb5\xaf\xfd\xc8\
\x8b^\xf4\xa2_]\x5c\xb7\xf8\xf4\xda\xf5\xfc\xe4;-\
\xaa\xc9pa3oy-\xce\xd7\x0dz>\x01\xb4:\
\xf0\xf4o\xa5Z7;\xb7\xdcr\xcb\xf5\x7f\xf4G\x7f\
\xf4?^w\xddu\xd7\xbf\xf5\xado\xdd\x84\xb8 h\
:K\x12EdR)\xa8\xd3\x08\xc2gEE\x03\x00\
\x84C\x82\x9f\x9d\xb24\x86N#\xc2\x01`0'\xc0\
\xf3\x03\x94\x1aQ5\xbb\xa4\xef\xb8\xe9\xcc\x9c\xe20\xf8\
\x17\xac\x15Q\xd6\x91\xd3;\x15\x82\xaf\x81\x9cS\xd7I\
\x09\xd1\xd6M\x08T\x06\x03\x01Lg\x09\xa8\x90j]\
\x085s\xca\x1e\x9cF\x88\x12\xc2\xea\x9c\xea\xb3Z\xc8\
t\xe5\x9a\xaa_9\x06\xbf\x13\xc8\x90l\x9d4\xaf\xf1\
\x1a=a\x15C\x944\x89\xd0kA\xed\xdd\x84PN\
s\xff\x17\xe7\xd1I\x05\x07\x88\x88@\xc0T\xc57\xe5\
\xc0'\x5c\x98C\x15\xbc\xca\x81\x0d\xde\xd6\xe1\x96\x07\x91\
\x13\xe6\xf6\x0d6\xb5c.v\xa6\xd6\xd4\xe6\xc8\x9f\xc3\
7\x02\x87\x1d\x10\xdd\x82\x11\x1a\x04c=\xdd1\xb2\xcf\
\x8b\xe7\xb2\xfej^G\xc4i\x16L\xc2n\xa9\xccY\
\xdb\xe2R\x1d2+\xea.b\xef\xf9\x98\xaa5\xe4\x90\
\xf3w\x1a\x0e&\xc5\x5c\x0e\x1e\xb4G\x10\xd6Y6\xb3\
\xc7\xdc\xf0\x8b\x06\xe1\xff=\xefy\xcf\x9a\xcf&XW\
\xf50\xdf\x13X\x10\xb89\xf9\xcb\xc7r\x10\xe4\xb8&\
\xdc*\xfe\x9f\x1f(\xbfY\x9dZ\xea\x22B\xb0\x10\xbe\
\xd1z7d`\xe0P'\xf8\xd4\x92\x22\x98\xe0\xc9\xba\
\xd0H}\xd7\xaay\xe4\xf9\xfca\xc57\x15v@\x00\
\xd5\x83\x0e\xcc\xca{\x83\xff\xfa\x98\xed\xdc\xb9\xf3\xaco\
|\xe3\x1b\xff\xd5\xb6m\xdbn\xdd\xb1s\xc7\x9f\x1d?\
v|\xd5b\x9aL\xff\x96\x17G\xbe\x9c\xcc\x95\xf6Y\
\xd3\xbeO\xe7l>\x9d]\xd7W\x80\xd9\xb2e\x0b\x93\
\xebG>\xf6\xb1\x8f\xfd\xcc\xf5\xd7_\xff\x92\xd7\xbc\xe6\
5\x8b\x9f\xf8\xc4'V\xee\xbc\xf3\xce)$\xe7\x07P\
\xbf\xb92\x0b>\x13\xe4\x87 \xf2\xea\x1b\x8b\x09d\x83\
\xde\xcbI\xcb\x07Q\xb5?ZR*1\x84\x15\x16_\
\x82g\xe6Q\x02\xb4\x08U\xdf\x88\x19#\xf11y\xa7\
\xa8\xde\x12c!\x0a\x12u\x85\xa8\xe4\x03!@`\x15\
m\x9d)S\x87\x8f\xaa\xe1Uc\xb9\xf9kKC\xf8\
\xd0F\x98\x8eN\xd3Tr\xfbK\xeb!\xc4h\x0cU\
\xcas\xbaB\xac\x13\xdb<\x9d\x98\x88\x16a\x96\xb5\x9e\
\x99GP\x22*\x0c\x93\xe9\xe1\x14D@\xf6\x83\xe1\xad\
\xdd\x1a<\xd35r\xa6&8\x82G\xa6`\x1d3\x08\
\x03\x9aH\xcem\xcf\xe7\xa4\xb4\x0f\xcf\xe4x\xaf\x8e\xb6\
\xdf\xad3\xdfJ\xb5z\xaa@i<k\xc0\x18\x95S\
\xf57\xf4\x81\x06\xca\xef*v\x05-\x98\x07\xec\xaa\xbb\
m\x8e\xca\x8a\x10|\x99\x9d\x18\xbc4\x13k\xb6\xa7\x9a\
\x0f&L\xbb\xc1\xab\xfdv\xa54\xba\x89\xc5\xa4p\xe2\
\xf9z\xcf\x9b\x83\x90q3[\x88\xc6\xcaP\x07\xab\x98\
\xab\xf2\xf0<OC$\xe0\xd1\x87\x03\xcc\xber\x04\xc3\
ai\x14\xd6\x09\x96\xd6\xe5\x1ds'\x0c\xbb\xe00O\
A\xa2\xc6\xeb\xb6\xabD\xe3\xfch\xe8\xd7\x98\x84eZ\
,\x81g^\xf3\x159\x9f\xc6o]\xf9\x02\xc1r2\
\x0b\xde\xacuUE\xe0\x8c\x01\xb6\xf6om\xd6\xe9\xa0\
\x94\xcea\x8f~\xfe\xe9\x9f\xfe\xe9u\x87\x0f\x1f\xbe\xfc\
\xde{\xef}\xe3\xf6\xed\xdb?\xbb\xb0\xb0\xf0\xf8\xea\x95\
\xfcta5\x1c\xe2t7\xee\xfd>\xde\xa0-N\x87\
\xbe\xf2\x93\xd3\x04-\x8e/W\xf2`\xd3\xa6M\xe7\xfc\
\xd9\x9f\xfd\xd9?\xfd\xe4'?\xf9\xdf\xbd\xe1\x0do\xb8\
\xf0\xb2\xcb.[\xd05\x13\x02\x01\xd7\xa9H\xe2bl\
\x08\xee\x86\xc1\x89\x0a\x81\x9c\xd3N/@\xa6&vz\
\x01Z\x8e\xe5R\x07\x98']+w\xaa`r\xbf\xe7\
\xfcDPi4c\xfaA\x01\x81\x98\x1bA\x13\x00\xa5\
\x15\x94\x87\x03\xb8\x18\xdf\xfe\x10!\x9f\x95k\xf8\xae:\
\xad\xa7hb\x7fG\xb8\x10\x8d\xb1\x08J\x7fX\xdde\
\x00\x00 \x00IDAT\xa7e\xb9[\xf6d\xff\xf6\
Xt\xb4o\xa6B\xd1\xc3\xd6\x8bh\x09\x9dZ\xc6@\
*\x7fDA\x87\x08\x0bA\x8cNb\xe3\x82\x97w\xad\
\xd5\x9c\x84\xbaS\x8dy\xda5w\x8d\x18\xbdW\xbd\x19\
\xe6%!`\xcd\x88\xcd~\xac\x1bq\xa5\xd9!rk\
\xc9\x9fb\x1d\xd5\xcd!\x98\xac7\xe2\xf7mn\x84\x9f\
\x16\xe34\x8d\xf1\x10\xb2\xf5\xa2\x95\xc9\xace\x10x\x16\
3R\x8a\x02&\xe2H\xc7\xa0\x048\xa6.k\xdd\x1e\
k\x8bl\xec\x84n\xe9\x05\x04\x03\x9c\xe6\x8c\x05o\xcc\
C\xeb,\xac\x02L\xac\xa9\xfc\xb1\xaa\x03z~\xac\xb6\
IK\xab3kyyp\x5c\xd5@pK\xeb.E\
\x83p\x07\xe7\xaa\x1dX\x17\x13\x10\xfd\xd5\xb1\xa4$V\
\xe3\xc1g\xa5[\xd2r\x8a\xc9A\x7f\x85Z\xe4\x933\
W\xc9\xc8\x15\xa3\xb7F.\x0d0q8Ws\xda\xe7\
\x05H\xa2gk+8\x12\xcd\x16\xf0\x0b\xbfL\xbe\x02\
0\xb3\x06\xba\xfe\x07\x8f\x1a\x1f\xe0\xd5\x82\x85\xd1\x02\x0d\
\x88F\x84N\xf1\x1fz\x98\xf9Q\xb7\xdc~\xfb\xed/\
s)\xb5g\xcf\x9eO\x1e;~\xec\xdb\x94\x96\xd3]\
v\x8d\xa6\xd9d\xec\xc0:\x7f\xd7?\xffb\xfe\x98\x85\
\x85\x85\x1d\x7f\xfc\xc7\x7f\xfc\xb3_\xfc\xe2\x17\x7f\xfau\
\xaf{\xdd.\x04\x22\x87\xcaBS\xf5m\x86#\x92\xca\
\x0aX\x80R\xa0\x9e/\x02\xc7\xdf\xfc\x8e1i:]\
[C,\x01\xe1=\x84\x85\xc8~\xee\xe7~n\x15!\
\xf5\xe2\x864\x00\xa6A0I\x08\x80z\x96\x97s\x95\
\x89c\x5c\xc9\xa5\xd6\x09!\x00X\x0cF\xb7j\x00\x8a\
\x88\xa8\xd9\x09$DT4\xb4\xbdA\x0cF\x80\xf0\xfa\
\x89\x9b\x0b#\x99\x83\xb0E<%@B\xaaS\xc4\x9e\
\xcaZ\xb6\xef2\xb5\xad\xa1kh\xea3\xc2&\x14\x8b\
]\xb1>s\x18\xbb\xab\x5c\xf3{\xc6\xb3\x95^\x05\xab\
\xa2\x85=_\xe7\xcdL\x91\xda\x16\x97\xa1\x8dqS\xcd\
+kKP\x83\x0dM\xaa\xee\x15\x88\xde\xf8\xfe^~\
\x18\x01W\xd0\x1b\xd8\xdaSW\xcd\xe0\x8f@\x9d\xf2p\
g^8+\xef\x0b\xfc\xaa\x8ch\xad\xb5\x8b\xf6\xc5\x0c\
\xe9\xfa\x1a\xfc\xc0\x950\xb1\x07k_\x9e\x15m\xf7m\
~sa\xe8|s\xf6_\x87\x15k\xb5?\xf0A\x07\
`b\x9d\xf9\xc6f\xf5\xccW\x7f\xf77\xeb\xec\x0a\xbe\
r\xb3\x04\x0b<\x81\x0b\xc1P\x08\x87\xbf\x13\x9a\xfeF\
\xc0\x94&Q\xc2p\xa6\x8bg\xed\x1b\xbc\xc1\xa7\xdc?\
\xf3\xc0I\xc2<\xb3\x0a/\xa0\xb7\xd2v\x08B\xf0*\
\x06\x0eme\x8aY\x0b:\xca\x1d\x81\xe6\xe1\x94p%\
\x9c\xea.\xd3m\x1c\x9eY\x995k0\x1ex5N\
%Y*R\xc7e\xe29\x97\x07`\xe5r\xc0\x01\xc2\
z!\x8c\xd0)a\x84N\xbc\xe3&r\xe3\xc6\x8d\x1b\
v\xec\xd8q\xe5C\x0f=\xf4\xfa]\xbbv\xdd\xb1n\
\xdd\xba\xc3\xab\x9a\xdct\xdds\x17Z\xa7qD\xaf\xcc\
\x97\xf28\x9d)6\x99\xb3\xe1\xf2\x01M\xa7\xd3\xf3o\
\xba\xe9\xa6\xff\xe1+_\xf9\xcaO^s\xcd5\x8a]\
\xaf2S7M\x80\x87\x00\xf8m\x00\x95p\xe9:\x1d\
s\xdb(\x06\x82<>\x18@\xaf\x0a\x1f\xa9K\x809\
\xb5\x11\x1e&\xc1\xc0\x92H\x11\x1d&\x80h\xfe$H\
\x15oBs*\xb0\x0b\xd2\x108\x22\x800\xc4\x5c\xa1\
{s\xd2F0\x16b\x07Lk\xb0\xb6\x0a5\xb9\xd5\
\x18\x13\xfe\xc6\x8cd0\xc0(Ed\xe7 \xaeR\x22\
B\xe8\x96\xc8\xb3\xbf\xff\xfb\xbf\xbf\xfa\x9c\xb9\x09\xa3\xa2\
\xbcs$\xc6\x80\xf9A\x8a[\xb26\xe3\xd6\xfe\x05\xa1\
 \x1ck\xa8@y\x05\xbd\x08\xf6\x22\xbf\xad\xcd\x1e\x8b\
\xc2N\x13\x02w0$\x5c1\x1c\xb8r\xe2f\xbe\xa4\
~{\xd7\xde\xad\xdf:\x8d\x89\xc8s\xdc\x96\xc88\x9d\
\xa5\x5c\x10|\x189\x06\xb4\x07D\x0f\x9fp`>\xef\
\xb7\xde\xe8\xc9z<\x8b9\x9d\xa2`UC\xcbJ\x9e\
ZO\xfe\xb2\xb4o\xbf\x9b\xcba\xe2\xd9\x08\xb8\x1a\xd6\
\x95\x8a!\x98\xea~Q\xb9\xd3\xfa\xcaYwU\x0eW\
\x86\x22[~G3\xd6F(8\xd4\xd0*\xf8\x83\x1d\
\x1a\xf37\xef\xd2\x98*\xb0\xd73\x04\x12\x18\x95\x88\xcb\
1]\xe8D\xd5%\xf3\x13\x19\xbb:\xde\x1d\x92E\xed\
\xdbC]D\xd0-\x9a(T$\x01\x08wx\xcaA\
\x8a\xa6\xf8\x94\xaa\x9a\x08'\xd5\x98\xae\x84\x88y\x08,\
7k\x99\xbb\x99\x81Y5\xf99\xab\x95T\xb2\xaa\xdb\
\xd6\x22\xc9\xad\x11\x1c\xec\x1fMrW\xd8\xcf\xac\xb4\xee\
\xc2\xbe}\xfbv\x1d?~\xfc\xfa\xc7\x1e{\xec/v\
\xef\xde\xfd\xc9\x95\xe5\x95\xef\xb0\xae\xd2\x8a\xc6K\xa45\
M\xe8\xf9\xcc\xafQ\x00\xcd\xd20\xf6\xdcp\xc3\x0d\xff\
\xfc\xb6\xdbn{\xe7\xfe\xfd\xfb\xcf=z\xf4\xe8\xca\x85\
\x17^8\xb5`\x1b\xac\xb8U'f\xceI\xa7\x0a\xc9\
IH\x98\x83\x1a^\x8b\x17\xccVhy}\x93\xfc\x0c\
 6\xad\xcd\x08\xe6\xc1\xec%\x91B\x0a\xcdK\xfc\x02\
?\x0f\xf54FB\x10\x1f\xfc\xe0\x07\xd7\x9a\xbduU\
\xe9\xa4)B\x9ap\xa8\x94\x04@b:%\x0b\x10U\
A\x91\xc6\xb1\x16\xebE\x88\xf6T\xfd\xdeB\x06\xfc\x0d\
\xc2\x10\x951\xbb\x95\xf37\x9f\xd9c\xcd\xee\x0a\x1d0\
o\xa7O\x0ej\xefV\xb2\x04\x91d\x9b\x13\x18\x88\xad\
dG\xfbF`\x18\x02,#\x22\xf0r\x82\x11\xfc`\
Y\x1a@Y\xf6\xb48\xc2\xcd\xfb\xd5(F\x98\xc1\xc7\
\x9c5\xec3\x16\x86\x87\x0bcY\xb3\x83\xc1\x1e0j\
7&\xe6%\x10\xc2+\xe6\xc2\x04\xd5k\xaa\x00\x19b\
\xb7\xde\xba<\xd8#\xf8\x14{\x94fT\xc4w\xc1z\
\x93Y\xac\x90/\x82\xb1\x12.\xc6\x00\x9f\xeaR\x07W\
sv\xddo\xae\x22\x821i\xa6,\xfa\x80\x97\xc6\x9f\
\x0c\xbd\xea3\x11\xe1\xc4^~\xed\xd7~m\x95\xfe\x1c\
t\xe6\x03/\xcco\x9d\xc2G\x08Yk\xa5\x15e.\
;\x08\x08\xf2\xe2r\x08\xbf\x0a\xcf\xd5*\xfa7~\xe3\
7V\xd7\xc5G\x8a\xb9\xd1\x01\xbe\x81\xe7\x8a\x86y\x0f\
>\xf7\xec\xb9pu}h\x1fl\xd0\xa3gk\x9e\x88\
\x8f\xe0C\xac\x901\xc7\x14\x16\x1ai\x8ey\x87\xbb\xc3\
\xa9\xdf\xd1\xfcd\x16\x0bdo\x93Y$\xba\xb5\x12\x8a\
\x95\xc1\xf5\xbc}\xe39\xfb\x22\xa0\xd1\x04\x98Xw\xd5\
*g\x01\x9d\xeb\x0f\x1c8\xb0\x7f\xf3\xe6\xcdo9\xff\
\xfc\xf3\xbf\xb0n\xdd\xba\xa7\xaap9\xd6\x95\x9e\xcc\x05\
<\xf7\xff\xba_\xf8\x85_8\xad\xad\x96\x14\x9b5\xb5\
\xbb\xe4#\x1f\xf9\xc8\xff\xf2g\x7f\xf6g\xff\xf0\xc1\x07\
\x1f<\x1b\x91\xbd\xe9MoZu@\xab(Xu6\
\xaalM\xee\x10a\x92\xb9\x98\x17\x1bB\x10\xdd\x5c!\
p'b\xe6Jj\x22{]\xc35D4\xc6W\x94\
[\x85X\x00\x93d\xf69\xe2\xc2\xb4\x15\x97\x82Tk\
\xf0\xed\xef\x18\xd0;\x95\x85\xf0w!\x00\x10\x0b\xf8\xf9\
\xa20\xac1\xac\x83\xb6T\xcd\xeaN\x8e\xd4\xf8\xae\x89\
\x11\x0d\x02\xf1,\x06\xa0\xb5\xd8O\xb6;a\x96\xc93\
\x99\x15\xe7\xea\x04\xf6|\xadz \x99\x10\xa0\xea\xd2p\
8\xb5\xc1\xc3\xfc\xbe\xc1\xa3\x1c%s\xf3=\x14/\x93\
\xd3\x16\x5c\x09L\xe3\x16Yn\xdf\x99#\x18\xd37\xc2\
\x8d\xf8\xfdnL\x04\x95\x10\xb5\xd6\x12P\x8b;\xeaV\
\xb3\x96\xcd\xb4F\xff\xdb;\xdc\x85?\xe3\x19\x17\x1c\xec\
\xd5\xfb\xb3f\x06k\xbe$\xe3\xd6\xba\xa8\xda\xd5\xf0\xd0\
\x85\x83q\xcd\xd7\xed+\xf8\x95]?\xd6/\x8a\xc1\x1b\
\x17\xc3X\xbb\x83\x06\x0d8\x00\xc1\xae\xd4\x17\xf3\x94\xf6\
0\xd2y\xb4\xd5U\xb8\xf7\x08\xc8\xfe\xeeg\xe6\x899\
t-\xc1\xec\xd6\x8bN*\xabalf\x9d\xc3.\xda\
\xa8\xads\x87P\xe5K\xba\x09\x867\xebK\xfb\xb1\xa7\
|m\xf8\xc2s\x9f\xff\xfc\xe7V\x0f\x12pM\x18y\
&\x8d;s\x9e\xd0\xb1/\xf8\x01WB\xce3`E\
\xf0\xa3\x85Z7Yg\xbe\x22\xfc\x99P#\xc8j\x09\
=\x9d\xe5\x9dU\xb1\xd4\x18iD\x84u\xc5\xd5\x8c\xe9\
\x00\x05\x93'\x9f|r\xd3]w\xdd\xb5}\xcf\x9e=\
_\xd9\xbe}\xfb\xbd\xb5MZ\xf8.}\xea\xfbyq\
\xf2<W\xf2^\xd8\xb2e\xcb\xf4\xf1\xc7\x1f\xdf\x7f\xe3\
\x8d7j\xc7\xfc\xc3\xbbw\xef\xde\xcc$\xa9l(\xe9\
h\xe1\x88\x98\x8aV\xef\xac2\x9f!\x89\xa4\xc6 \x99\
\x09I_\x00+\x88\xae\x84\xcc\x8agq\x0e#\x9c\x02\
\xdd2\x1b*re\x8d\xcc)s8\xa1\x0a\xb02\x07\
\x06\x014k\xe1\xb0-W\xc6\x9a\xaa\x8d\x03\xc0\x04\x11\
\xbf\x83\xcfhV\xa5`x\xa7\xb2\x1a]\x89\xcf\x97\xe6\
\x08V1t\xc5\xd89\x11\x11J\xd5\x1e+\x8d\xe1Y\
\x04ZnWqV\xe6(&\x09\xbc\x09<\x8c\x9b6\
\x03\xc6\x08\xb6\xbc/\xefa6\xfb\x16\xf6\x80XWf\
Y\xf9\x04\xb2u\xd4\xb2\xb8\x02\xe7\xab\xad{\xf7]5\
9\xfc\xe4\xe1\xc93G\x9eYs\x86\x07\x8bL\xb3\xd1\
\xc7B\xe0\xd42'g\x7f%D}\x81\xb9\xf5f\x96\
\xfa\xd9\xfb\xd5-\xa2-aN\xa75\x1a\x09\xef\xf0\x04\
f`]\xc7\x0c\xf0*\x9b\xbe*\x07\xe0fm\xd6\x02\
~\xa5\x1bLf\x09\xae\x05\xf3eZ\xb5\x06\x0c\x81\x19\
\xd1g.\x04c\x19\x07\x0c\xcb\x22\x9foK\xe3}\xe3\
\x12,p\xeeB\xa5\xebh\x07h\xc9\xd1\xf6\x85\xf1i\
d`UW\x5c\xf02\xbeC\xac\xb0\x8a\xa2\x95\x13f\
e\xf3\xdb\x870\x10\x9aQ\xda_~\x1ac\x80\x8b\xdf\
k7\x04\x9e\xe85?\x909\x8d%\x14\x86\x00S\xf9\
\xb3n1x\x09\xbe\x0a\x11\x80?\xf0c\xd6\x95\xb2\x94\
\x19)\x96/?.aS\x13E\xf0 h\xc0\xbfN\
\xc2\xc6\x83\x1f\x87a\xb9b\xfe\xe6\x99\x99s|\xe55\
\xafy\xcd\xf4\xe3\x1f\xff\xf8\x0b\xef\xb8\xe3\x8ew\xec\xde\
\xbd\xfb\xcb\xeb\xd7\xaf\xbf\xbfCw\x148\x93\xb9\xab\xfb\
\xef\xf0\x09\x8d\x82h\xcb\x96-\x1b\x1e~\xf8\xe17\xfe\
\xe1\x1f\xfe\xe1?{\xe4\x91G\xbe\x7f\xe3\xc6\x8d\x8b\x10\
\xaf2\x9f\x85h\xc4o\xe3%\x8fBhW\xe9\x15\x14\
\xa3\xf2C0;\x99$G\x90\xd5\xb6\x89\xb1\x11F-\
k\x01\x01\xf0\x8b\x9a\xad\xe7\x15\xc0C\xceju\xc1u\
\xcf\xc5\x88\x1c=~t\xf2\xcdo|sM\xb3\xc1l\
\x82\x0d!\x19\xe20L\xd9\xd0\xd6\x9bC\x13\xc1\xa7A\
\x15q\xcc\xfe%\xd4 \xcd\x9e\xac\x11\x13a\xacz\x86\
\x07\xc4\x22\x8c\xad\xcf\xda!\xcf7\xa6\xa5\xcaZ\x7f\xed\
\xa6\x09\x15\xf0H\xdd\xf6\xbb=v\x12u\xfb\x859\xcb\
\x0e\x8f\x80+\x5c\xc6\x07\x86(\xab\x99T\xcf}\x0c_\
u=\x02\x17cpB*ZV\xeaGi%\x0b\xeb\
V\x0f\x94\xc9\xb9\xdb\xce]\x0b\xee\xe4\xd7\xb0V{%\
\xb4\x1d\x0au\x5c\xb0\x17\x84W\x04w\xf5\x8b\x8a\xab\x02\
+\x04hop\x89a\xf3\xe1\xc1\xbb\xf7}Fc\xab\
\xbe\xb1}\x83\xa7\xef\xea\xf6txU,\xcd<\xb5\xcf\
\xb1\xd7\x0e\x1c\xb8\xad-R\x05\xf3\xe1\x05\x9c\xd3\x86\xea\
e_@\xa91\xcc\x99\xdf\x03\x0c\xab#m\xdd\xc5F\
eB\x136`\x95\x1f\xaf\xc4OB\x1d\x1d\x825\xbc\
\xd1$\xc6\xdbT\xdap9\x86\x84J5\xac\xd2\x9e\xc1\
;\x0d\xae\x10\x04\xf3\xe44g\xe6\xd6\xc56\x0d\xb0\x00\
\xd5\x0a\xb0\x19{:+\xf2\x06&i\xd8\xde\x05'{\
#8\x0a<\xa4\xb1\xd8_>\xcfn`\xbd\x8bF\xcb\
\x17\xab$\x0a\x07\xb3='\xa0\xf1+\xfc\xa0\xb5,\x8d\
\xaaGf\x06\x17\x07h\x8f\xf7\xdcs\xcf\xd4\xd8\x17]\
t\xd1\x86;\xee\xb8\xe3\xfa\x8b.\xba\xe8\x8d\xfb\xf7\xef\
\xff\x8fc\xe2\xea(\x88F\xadh\x95\xdeG\x89\x94J\
\xbey\xf3\xe6M_\xfb\xda\xd7\xfe\xeb\xdf\xf9\x9d\xdf\xf9\
\x85\x07\x1f|\xf0e6\x95\x1d^\xeb`\x84k\xe1\x88\
\xdeUu\xedI*R\x85\x11\x00\x14\x00J(\xf5\xbc\
\xd3\x11\xa13[Hr\xd1\x9b\xc6\xb3Q> \xc2\xa3\
X\xa4:\x89\x96\x90\xe8\xf9\x07\xbe\xf5\xc0\xe4\xfe\x07\xee\
\x9f\x1c}\xe6\xe8\xe4\x92K/\x99\xfc\xec\xcf\xfe\xec*\
!\x00\xa4~\xf2\xd9\xfd\x08\x95\xd0\x84\x1c\xf3\xcd\x92\xef\
\xd6\xae\xf8i\x02\xd6M\xbaC\x0a\xa6.:\x1bC[\
7\x0d\xc5z\x08@L\x87\xf0\xbb\xe6/\x9f\x07r\x8a\
\xa3\xf1\x19a\x92\xf92}\xae\x08\xd4\xea\xa9I\x9d-\
\x05\xa0\x88\xe5\x12*\xed\xbf\x9a5\xe5py\x8eF\x86\
\x01\xa9\xff\x08\xc0z\xc0\x99\xb6g\x0cDg\x9d`d\
^9z\x18\xbc\xd3\xae\xce\x18i,\xf6E\xbb\xecf\
\x12\x01\xc1W5\xa4\xc1\xc5\xff\xbe\x08\xc4\xe2[0\x09\
b\x07\xc7n\x9f\x08\x00\xfbk?i\x81\xd5\xc3\x063\
\xf0\xf6U\x86:\xa6\xf0\xac\xbf\x83\xabu\xa0+'\xb2\
\xbf;\xcc\xfc\x9dvh\xad\xc6'|<\x97\xd6R?\
4\xb8H`\x17\xb5^\xf6?\x8d!\x7fc\xc9\x98\x99\
\xcb\xd1G\xf1Q\xe0\x03\xae\xe8\x81\xbb\x00\x8d\xd6\xa3\xdf\
8\x84\xa4qi<\xc6@\xdb\x98w\xf5\xdd\xa5\x13\xab\
\xa6\xd0K\xf7\xbft2]\x98\xae\xe5\xff\x19\x13\xfe\xbd\
O\x18\xe7w\xc9\x84\x06g\x02\x84\xd0N\xd0\x16\xcc\x8a\
\x96\xc1\x1c\x9dNf\xa9A\xc52y\xb6\x22f\xde\xf7\
m\xdf\x09\xa9\x9a7V\x1d\x22\x7fX\xd7\xf8\xc6L\x09\
\xf0s\x17\x0e\xf6Z\xa27|\xac\x9ayG\x8eN\x1e\
y\xf4\x91\xb5\x84d\xf4;f!\xf8\xb6\x0e\xfb4\x0e\
\x1c\xce\x82>\xf7\xec\xdc\xb9\xf3\xcd\xd7\x5cs\xcdGu\
\x1f_9M\x9d\xa11\x97\xec\xdb\x84P\x02H\x10\xe2\
W\xbe\xf2\x95\x1fy\xd7\xbb\xde\xf5\x0b\x07\x0e\x1cx\x11\
\xe7\xef\xdb\xdf\xfe\xf6\x15\x9d00\x03\xd3\xa5po~\
\x0f\x08U%\xd1&1u\xbe\x8e\x12<3\x99<\xcf\
g\x84 \xfc\x0e9\x92BiKEU#\xdc\xb1@\
\x18\xa4\x22l\xa7\x9f\xef'\x0f=99k\xcbY\xcf\
\xe5*\xed|\xce4\xa8\xe3\x01\xa08\xbd!\x96`$\
P\xb2\xb3\xf3\xe5\x90\xee\x18\x15\xb08\xd80+\x8d\x83\
\x7f\xa8\x1b\x09\x82\x8b\x99\xd6\xb59\xe1R\x0f\xa8Z\xcf\
T\x89\xae4\x01\x08\xf5w\xa7d\x1a \x01\x95\xf37\
\xad\xce\xf3\xde\x1d;iX\x1f\xa21O\xa6W\xccT\
U\x00\x82\xc8\xb7\x22\xe4>\x87\xf8\xca\x9ctce\xbd\
\xf0\x82X\x08\xc6\x02\x0b\xf3\xa3\x11\x04L\xd2\xead\x83\
AI\xbd\xd6\x89\xf9\x1d6\x09\x1f{/\xe4?\xd3\x94\
I`\xee\x92a\xe1\xbcn\xa5\xe5}\xcd\xbat\xaeE\
\x0c\x1b;\xed1\x9f\x13\xdc\x98/\xdf\xdc\xe84'\x8c\
<\x0b\xaf\xc6$\xc4[\x9f\xe7\x08%\xf3M\x87\xfa\xc5\
\xc5r\xf9\xb9\x16HpX\x9f\xad\x8a\xe5U*\x97\x00\
\xac\x8cn\xe5r\x99\xe1`_\x09\x98\xca\x80T\xbdA\
\xc8\x89\xbd;0\x8c\xeb\x0b\x5c\xae\xfd\x9ek'\xa7\x96\
OM\x0e\x1e8\xb8\xfa\xf7n\x80\xf3\x9bX+\xed\xca\
\x18\x05\x80\xe6\x98\xaf\x06\x91\xf7\x08\x0dtl\xfd\x9e\xb3\
O\xebt\xa8\x80\x19a\xe4g4\x86\x0f+w\x8b\xae\
\x0bu(\x81\xda8L\xc9n\xab\xd1\xa05\xf8\xdfz\
\x1c\xbc\xf57\x03\xe7\x1a<\xc0\x1b\xa5\xc0;\x8f\x1c|\
d\xf2\x9f>\xf2\x9fV\xf9\xdb\x01\x87\x9e\xd2\x82J\x9b\
\xa9C\xb1u\x1a\xe7\xee\xbb\xef^\xd9\xbf\x7f\xff\xf4\xe0\
\xc1\x83/\xbf\xff\xfe\xfb\xaf\xbd\xe8\xa2\x8b\xfe\xa4\xfaU\
\xcbCc\xc5\x84\xcf\xda\xedX\x1f\xceT\xf8\xb3o\xbd\
\xf5\xd6\x7f\xf8\x9b\xbf\xf9\x9b\xffb2\x99\xbc@%D\
\x8b?t\xe8\xd04\x87\xa9\xc5b\xa4\xaed\x01 B\
-s=\x15\x10cA\x0a\xe1\xe4\x94\xf3\x19'\x1f\x04\
\xbb]\xf1?\xc00\xa3\x10\x18d\xac\xcc\x9a\x05\x96\x98\
hs%m\xee\xda\xb9\xeb\xb99\x8f\x1e\x99<q\xf7\
\x13k\xd7\xd8\x98\xc5<\x9eCl\x10Xg\x86\x90\x84\
p\xf8\xa7\x8c\xc7\xe9m_N\x90\xf2\x860D\x1d*\
1\x02\x022\xa7\xd3\xdf\xef\xd6\xe9\x14qj\x12J\xd5\
\xc11'\xe6Cx\x04\x81([\x7f\xafd\x07\xe6\xaa\
\xa5N\xb7K\x84E!\xfb35vUH\x80W\x0d\
\x16Sa\xbb\xda_\x99\xb5{\x16\xbb\xe1\x99\xca\x9d\xda\
\x83=\x19\x83p\xc384\x09\xcf\x94\x7f\x84(\xabc\
M\xf3\x01\x8b\x9c\xc1\x88\x8byE8U\xa4\xad\xebn\
\x1a\x1d\xb8\xe4\xbb(\x16\xab\xd0\x84b\x9e0I\xbd\xab\
\x22,\xa7)X\xfa[\x85\xdc21\xec\x03\xe13\xdb\
1\x04A\xb12+\xc0\x86&*\xf5\x0b\xf6\xbe\xd1\x9a\
\xf5\xcdg\xbe\x8f\x04=\xbb@\x99u\x03YX\xf3\x0b\
\xd1\xd8\x8d\xd5m\xa4\xb9\x9d\xec\x04c\xfd\xd7\xd2^\xeb\
\xd1V\xe7\x8b.-\xac!?\x9b\xb5\x10\xf4\xf5\x8d3\
\x86y\xd1_\xe5.\xd2\x9c\xc1\xaa~h\xe6\xab\x84p\
=\xf6\x13t`\x82\x0eK\xfc-k\x00~\xd1\x04\xde\
a\x96\xfb\x1b\x7f\xe9\x1f\xfc\xc1\x1f\xac\x9a\xcf\xdc\x0a\xe8\
\x0aN\xc1\xdf\xc1\x00.\xf6l\x0f\x9e\x853\x07o\xbd\
\xc3\xac\x85\xe9\x89^W\x8b\xbd\x1d:\xb4:7\xe1\x96\
o\xb3\x9aO\xe0\x84\xb7\xf8\xb0\xdc \xe7\xe4\x9f\xcc*\
2\x16\xfd\x8f\xb6Jq\xb1\xf7\xcf\x7f\xfe\xf3\xbb\xbe\xfe\
\xf5\xaf\x7f\xff%\x97\x5cr\xf3t:=2\xa6\x83\x8d\
\x09\xbc\x99d\xab\x9a\x90\x0d\xaf\xac\xacl\xfb\xc4'>\
\xf1\x93\xae\xe1/\xba\xe8\xa2]\xd2-,\xaar\x97\xd4\
x\x13Y,\x155)\xc84\xb0@\x7f\x07\x94\xfa[\
A\x8c\xd3\xa8@;\x92\xb9\x02\xe0uq\xcc\xb1VR\
\xa7\x8d#HL\x0cI\x11\xb8\x8d\x95|\x09\x10\x9e/\
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
