bienemeia/SYSC4907_Group44_GroundVibrationSimulator/(commit log)

2023-02-26 Added some code to be compatible with Temp sensor
2023-02-27 Updated UI code with database integration
    [database.xlsx]
2023-03-17 Edited I2C lib:
2023-04-18 Added STLs and other files
    [Bracket.stl, Camshaft_3mmOffset_Split.stl, Camshaft_5mmEnd_Split.stl, Coupling bracket.stl, Coupling plate.stl, Flexure.stl, Frame.stl, FrameBase.stl]
2023-12-15 Add files via upload
    Adding files from Teams site
    [Assigned Sections.xlsx, LinearActuator v1.stl, RandomSpring.stl]
